anirudhr-adtech/AI_GLASSES/README.md

# AI_GLASSES

AI-powered smart glasses project.
