anirudhr-adtech/AI_GLASSES/AI_Smart_Glasses_docs/Physical Design/AI_Glasses_SoC_OpenSource_PD_Flow_v1.docx

AI SMART GLASSES SoC

Open-Source Physical Design Flow

Automated PD with Claude-in-the-Loop

Yosys • OpenSTA • OpenROAD • Magic • Netgen • KLayout • OpenLane 2

Document Version: 1.0

Date: March 2026

Development PDK: SkyWater SKY130 | Target: SCL Mohali 180nm

Strategy

Use the open-source PD toolchain to iterate rapidly on synthesis, timing closure, floorplanning, PnR, and physical verification. Claude runs the tools autonomously in run → read error → fix → re-run loops. Once converged, export equivalent Synopsys TCL scripts for the commercial flow at SCL Mohali 180nm.

# Table of Contents

# 1. Why Open-Source PD for This Project

## 1.1 The DV Parallel

In Design Verification, Claude demonstrated enormous value through autonomous iteration loops: write testbench → run iverilog → read errors → fix RTL or TB → re-run. The key insight was that iverilog (open-source) caught 90%+ of the same bugs that Vivado XSIM (commercial) would find. The open-source tool wasn’t the final production simulator, but it was the iteration engine that got the design to a clean state before touching expensive tools.

The same principle applies to Physical Design. Open-source tools (Yosys, OpenROAD, OpenSTA) can catch and fix the majority of synthesis, timing, floorplan, placement, routing, and DRC issues. The commercial Synopsys flow at SCL becomes a final verification pass on an already-converged design, rather than the place where all iteration happens.

## 1.2 Why 180nm is the Sweet Spot

The 180nm process node is uniquely well-suited for open-source PD tools for several reasons:

- Relaxed design rules — wider metal, larger spacing, fewer exotic DRC rules compared to advanced nodes
- No FinFET complexity — planar MOSFET physics that open-source tools handle accurately
- Fewer metal layers — typically 5–6 layers vs. 10+ at advanced nodes, reducing routing complexity
- Well-characterized timing models — Liberty (.lib) files for 180nm-class cells are mature and accurate
- SkyWater SKY130 (130nm) is publicly available and structurally very similar to 180nm — same flow methodology transfers directly

## 1.3 Value Proposition

Metric | Without Claude PD Automation | With Claude PD Automation
Synthesis iterations | PD engineer runs DC manually, fixes constraints, re-runs | Claude runs Yosys in a loop, converges timing offline
SDC constraint quality | Written manually, bugs found late in STA | Claude generates and validates SDC iteratively against OpenSTA
Floorplan convergence | Trial-and-error in ICC with PD engineer | Pre-converged floorplan from OpenROAD, PD engineer refines
DRC violations at PnR handoff | Hundreds to thousands, fixed manually | Reduced to tens — most auto-fixed in Claude’s loop
Time to first timing-clean PnR | 2–4 weeks typical | Days for pre-convergence + PD engineer sign-off
Commercial tool license hours | Heavy usage for all iteration | Minimal — only final sign-off and SCL-specific tuning

# 2. Open-Source Toolchain Overview

## 2.1 Core Tools

Tool | Function | Replaces (Synopsys) | License
Yosys | RTL synthesis: Verilog → gate-level netlist; tech mapping to standard cells | Design Compiler (DC) | ISC (permissive)
OpenSTA | Static timing analysis: multi-corner, setup/hold, transition, capacitance checks | PrimeTime | GPLv3
OpenROAD | Full PnR: floorplan, placement, CTS, routing, optimization, parasitic extraction | IC Compiler (ICC2) | BSD 3-Clause
OpenRCX | Parasitic RC extraction (integrated in OpenROAD) | StarRC | BSD 3-Clause
Magic | Layout editor + DRC engine for VLSI; LVS with Netgen integration | IC Validator (DRC) | MIT-like
Netgen | LVS: compares extracted layout netlist against schematic/gate-level netlist | IC Validator (LVS) | GPLv2
KLayout | Layout viewer/editor + DRC scripting engine (Ruby/Python) | IC Validator / Custom Calibre | GPLv2
OpenLane 2 | Full automated RTL-to-GDSII flow orchestrator using all above tools | Fusion Compiler | Apache 2.0

## 2.2 Supporting Tools

Tool | Function | Usage
SkyWater SKY130 PDK | Open-source 130nm PDK with standard cells, I/O, SRAM | Development and iteration PDK (closest to SCL 180nm)
ABC | Logic optimization engine (integrated in Yosys) | Technology-independent and technology-dependent optimization
GTKWave | Waveform viewer for timing debug | Visualize STA paths and signal transitions
Python | Script automation, report parsing, result analysis | Glue for Claude’s automation loops
TCL | Native scripting language for all PD tools | All tool commands and flow automation

## 2.3 PDK Strategy: SKY130 → SCL 180nm

The SkyWater SKY130 PDK is used as the development and iteration PDK. It is a 130nm process, structurally very similar to SCL’s 180nm. The critical insight is that the PD methodology, script structure, constraint format, and optimization strategies are identical between 130nm and 180nm. Only the following change when moving to SCL 180nm:

What Changes | SKY130 (Development) | SCL 180nm (Production)
Standard cell library | sky130_fd_sc_hd (high-density) | SCL 180nm standard cell .lib/.lef
Design rules (DRC deck) | SKY130 DRC rules | SCL 180nm DRC rule deck
Metal layer stack | 5 metal layers (li1, met1–met5) | SCL 180nm metal layers (confirm count)
I/O pad library | sky130_fd_io | SCL 180nm I/O pad library
SRAM macros | OpenRAM-generated or sky130_sram | SCL memory compiler macros
Timing corners (PVT) | SKY130 corners (ss/ff/tt) | SCL 180nm corners (confirm exact PVT)
Parasitic models | SKY130 RC tech file | SCL 180nm RC extraction rules

Key Point

Everything else — the SDC constraints, UPF power intent, floorplan strategy, CTS methodology, routing approach, DRC iteration flow, STA scripts, LEC methodology — transfers directly. The scripts Claude develops and converges on SKY130 become the foundation for the SCL 180nm commercial flow.

# 3. Tool Installation and Environment Setup

This section documents the installation of all open-source PD tools in Claude’s Linux environment. The tools are installed once and available for all subsequent PD automation sessions.

## 3.1 Yosys (Synthesis)

Yosys is the synthesis engine. It reads Verilog RTL, performs logic optimization via ABC, and maps to target standard cells.

# Install Yosys

sudo apt-get install -y yosys

# Verify installation

yosys --version

# Basic usage: synthesize a module

yosys -p "read_verilog design.v; synth -top top_module; write_json netlist.json"

## 3.2 OpenSTA (Static Timing Analysis)

OpenSTA performs multi-corner STA with Liberty timing libraries. It reads gate-level netlists and SDC constraints, and reports setup/hold violations, max transition, and max capacitance.

# Install OpenSTA (often packaged with OpenROAD or standalone)

sudo apt-get install -y opensta

# Basic usage

sta -exit <<EOF

read_liberty sky130_fd_sc_hd__tt_025C_1v80.lib

read_verilog netlist.v

link_design top_module

read_sdc constraints.sdc

report_checks -path_delay max

report_checks -path_delay min

EOF

## 3.3 OpenROAD (Place and Route)

OpenROAD is the complete PnR engine. It handles floorplanning, global and detailed placement, CTS, global and detailed routing, parasitic extraction (OpenRCX), and post-route optimization.

# Install OpenROAD

sudo apt-get install -y openroad

# OpenROAD TCL flow (simplified)

openroad -exit <<EOF

read_lef sky130_fd_sc_hd.lef

read_def floorplan.def

read_liberty sky130_fd_sc_hd__tt_025C_1v80.lib

read_verilog netlist.v

link_design top_module

read_sdc constraints.sdc

initialize_floorplan -die_area {0 0 1000 1000}

global_placement

clock_tree_synthesis

detailed_placement

global_route

detailed_route

write_def routed.def

EOF

## 3.4 Magic (DRC + Layout)

Magic is a VLSI layout editor with integrated DRC engine. It can read DEF/GDS output from OpenROAD and run SCL/SKY130 DRC checks.

# Install Magic

sudo apt-get install -y magic

# Run DRC in batch mode

magic -dnull -noconsole -T sky130A <<EOF

gds read design.gds

load top_module

select top cell

drc check

drc count

quit

EOF

## 3.5 Netgen (LVS)

Netgen performs Layout vs. Schematic comparison. It takes the extracted netlist from the layout (via Magic) and compares it against the post-PnR gate-level netlist.

# Install Netgen

sudo apt-get install -y netgen-lvs

# Run LVS comparison

netgen -batch lvs "layout_extracted.spice top_module" \

"netlist.spice top_module" \

sky130A_setup.tcl \

lvs_report.txt

## 3.6 KLayout (Layout Viewer + DRC)

KLayout provides visual layout viewing, editing, and scripted DRC. Useful for visual debug of DRC violations that require human understanding.

# Install KLayout

sudo apt-get install -y klayout

# Run DRC script in batch mode

klayout -b -r sky130_drc.py -rd input=design.gds -rd report=drc_report.xml

## 3.7 OpenLane 2 (Full Flow Orchestrator)

OpenLane 2 is a complete RTL-to-GDSII flow that orchestrates all the above tools. It provides a Python-based configuration system and runs the entire flow automatically. For Claude’s iteration loops, we use both OpenLane (for full-flow runs) and individual tools (for targeted iteration on specific stages).

# Install OpenLane 2 (via pip)

pip install openlane

# Or via Docker (recommended for reproducibility)

docker pull efabless/openlane2

# Run full flow

openlane --pdk sky130A config.json

## 3.8 SkyWater SKY130 PDK

The SKY130 PDK provides standard cells, I/O cells, SRAM macros, DRC/LVS decks, and timing libraries for the open-source flow.

# Install SKY130 PDK via volare (PDK manager)

pip install volare

volare enable --pdk sky130 <version>

# Or clone directly

git clone https://github.com/google/skywater-pdk.git

# Key files:

# sky130_fd_sc_hd__tt_025C_1v80.lib — Timing library (typical corner)

# sky130_fd_sc_hd__ss_100C_1v60.lib — Slow-slow corner

# sky130_fd_sc_hd__ff_n40C_1v95.lib — Fast-fast corner

# sky130_fd_sc_hd.lef — Physical cell abstracts

# sky130A.tech — Technology file for Magic

# 4. Claude’s Autonomous Iteration Loops

This is the core value of the open-source PD approach. Each loop follows the same pattern proven in DV: run tool → parse output → identify issues → apply fix → re-run. Claude continues looping until convergence or until a human-judgment decision is needed.

## 4.1 Loop 1: Synthesis (Yosys)

Loop Pattern

Write Yosys TCL → Run synthesis → Read timing/area report → Identify violations → Adjust synthesis strategy → Re-run → Repeat until timing/area targets met

What Claude does in each iteration:

Iteration Step | Claude’s Action | Example
1. Run synthesis | Execute Yosys with current TCL script | yosys -s synth_npu.tcl 2>&1 | tee synth.log
2. Parse report | Read timing, area, and cell count reports | Critical path: 6.2ns (target: 5.0ns) → FAIL
3. Diagnose | Identify which paths fail and why | Path through npu_mac_array accumulator chain too long
4. Fix | Adjust synthesis: restructure logic, add pipeline, retime | Add pipeline register in accumulator, re-map with ABC
5. Re-run | Execute updated synthesis | New critical path: 4.8ns → PASS
6. Check area | Verify cell count and area are acceptable | Area: 45,000 cells, utilization 72% → OK

Common synthesis issues Claude catches and fixes in the loop:

- Critical paths that exceed the 5ns target (200 MHz NPU) — fixed by retiming, logic restructuring, or flagging RTL changes needed
- BRAM inference failures — Yosys may not infer BRAM for certain coding styles; Claude adjusts the RTL pattern
- Combinational loops — synthesis fails; Claude traces the loop and adds a register to break it
- Undriven nets or width mismatches — real RTL bugs caught before PnR
- Excessive logic depth through the AXI crossbar — may need pipeline stages in the address decoder

## 4.2 Loop 2: Constraint Validation (OpenSTA)

Loop Pattern

Write SDC → Run OpenSTA → Read timing report → Find missing/incorrect constraints → Fix SDC → Re-run → Repeat until all paths constrained and clean

This is one of the highest-value loops. SDC constraints are the foundation of every downstream PD step. Errors in SDC propagate through STA, PnR, and sign-off. Claude generates the initial SDC from complete knowledge of the design and then validates it iteratively:

Constraint Type | What Claude Generates | What OpenSTA Validates
Clock definitions | create_clock for sys_clk (100 MHz), npu_clk (200 MHz) | Clocks correctly defined and propagated
Clock groups | set_clock_groups -asynchronous for PCLK, I2S_SCK vs sys_clk | No cross-domain paths analyzed incorrectly
False paths | set_false_path on CDC synchronizer paths | Synchronizer paths excluded from setup/hold
Input/output delays | set_input_delay / set_output_delay for all I/O ports | No unconstrained I/O ports
Max transition | set_max_transition per clock domain | No excessive slew rates
Multicycle paths | set_multicycle_path for known multi-cycle operations | Correct path timing budgets
Clock latency | set_clock_latency estimates for pre-CTS STA | Realistic pre-CTS timing estimates

## 4.3 Loop 3: Floorplan + Placement (OpenROAD)

Loop Pattern

Define floorplan → Place macros → Run global placement → Read congestion/timing → Adjust macro positions or die area → Re-run → Repeat until congestion < threshold and timing estimates pass

Floorplan iteration is where Claude can rapidly test many macro placement configurations:

Decision | What Claude Iterates | Convergence Criteria
Die area | Start with estimated area, adjust based on utilization | Target 60–75% utilization after placement
SRAM placement | Try different positions/orientations for 512KB banks | Minimize wirelength to CPU + NPU + DMA
NPU buffer placement | Place weight/activation buffers near MAC array | Short paths for 200 MHz data access
Power grid | VDD/VSS stripe width and pitch per layer | IR drop estimate within margin
Pin placement | Signal grouping on die edges | Minimize I/O routing congestion

## 4.4 Loop 4: Clock Tree Synthesis + Routing (OpenROAD)

Loop Pattern

Run CTS → Check skew → Adjust buffer selection → Re-run → Detailed route → Check DRC/timing → Fix hold violations → Re-route → Repeat until timing clean and DRC clean

This is the most iteration-heavy loop. CTS directly affects timing closure, and routing can introduce DRC violations and timing degradation. Claude handles this by running CTS, checking clock skew against budget (especially critical for the 200 MHz NPU domain), inserting hold-fix buffers, running detailed routing, then checking for DRC violations and timing simultaneously. Each iteration tightens the design closer to convergence.

## 4.5 Loop 5: Physical Verification (Magic + Netgen)

Loop Pattern

Run DRC (Magic) → Parse violation count → Auto-fix density/antenna → Re-run DRC → Run LVS (Netgen) → Parse mismatches → Fix routing → Re-run → Repeat until zero violations

Violation Type | Auto-Fixable by Claude? | Fix Method
Metal density (min/max) | Yes | Insert metal fill, adjust fill density parameters
Antenna violations | Yes | Insert antenna diodes or re-route to higher metal layer
Minor spacing violations | Yes | Re-route affected nets with increased spacing
Via enclosure violations | Mostly yes | Widen metal at via landings
Complex DRC near macros | No — flag for PD engineer | May require macro repositioning
LVS shorts | Sometimes | Trace short in layout, re-route offending net
LVS opens | Sometimes | Identify missing connection, add via or route
LVS mismatches near pads | No — flag for PD engineer | May involve I/O cell configuration

## 4.6 Loop 6: Post-Route STA (OpenSTA)

Loop Pattern

Extract parasitics (OpenRCX) → Run OpenSTA with extracted SPEF → Parse timing report → Identify failing paths → Apply ECO (buffer insert/resize) → Re-route → Re-extract → Re-run STA → Repeat

This final STA loop uses real extracted parasitics from the routed layout. It’s the most accurate timing analysis possible in the open-source flow and directly corresponds to the PrimeTime sign-off STA in the commercial flow. Claude iterates on ECO fixes (buffer insertion, cell resizing) until all setup and hold violations are resolved across all timing corners.

# 5. Execution Plan: Phased Approach

## 5.1 Phase 1: NPU Subsystem (Tightest Timing)

Start with the NPU subsystem because it has the most aggressive timing target (200 MHz, 5ns period). If we can close timing on the NPU, everything else at 100 MHz will be straightforward.

Step | Action | Tool | Success Criteria
1.1 | Synthesize NPU (10 modules) targeting SKY130 | Yosys | Critical path ≤ 5ns, clean synthesis
1.2 | Generate + validate NPU SDC constraints | OpenSTA | All paths constrained, no uncovered endpoints
1.3 | Run STA on synthesized NPU netlist | OpenSTA | Zero setup violations at all corners
1.4 | Create NPU floorplan with SRAM macros | OpenROAD | Utilization 60–75%, congestion < 5%
1.5 | Place + CTS + Route NPU subsystem | OpenROAD | Timing clean post-route, DRC clean
1.6 | Run DRC + LVS on NPU layout | Magic + Netgen | Zero DRC, zero LVS mismatches
1.7 | Post-route STA with extracted parasitics | OpenSTA + OpenRCX | Final timing sign-off clean

## 5.2 Phase 2: Full SoC Integration

After NPU converges, expand to the full SoC with all 89 modules, AXI crossbar, peripherals, and SRAM banks.

Step | Action | Tool | Success Criteria
2.1 | Synthesize full SoC (89 modules) | Yosys | All subsystems synthesize cleanly
2.2 | Generate full SoC SDC (all clocks, all I/O) | OpenSTA | All 4 clock domains properly constrained
2.3 | Full-chip floorplan with all macros | OpenROAD | Die area feasible, power grid planned
2.4 | Full SoC PnR | OpenROAD | Timing + DRC convergence
2.5 | Full PV (DRC + LVS) | Magic + Netgen | Zero violations
2.6 | Full STA sign-off | OpenSTA | All corners clean
2.7 | Generate GDSII | OpenROAD/Magic | Clean GDSII output for reference

## 5.3 Phase 3: Commercial Flow Export

Export the converged design to Synopsys-compatible scripts for the SCL 180nm commercial tape-out.

Deliverable | Source (Open-Source) | Target (Synopsys) | Conversion
SDC constraints | Validated in OpenSTA | PrimeTime | Direct transfer — SDC is standard format
Synthesis script | Yosys TCL | DC TCL | Rewrite with DC commands, same logic structure
Floorplan | OpenROAD DEF | ICC2 floorplan TCL | Convert macro positions to ICC2 place commands
CTS spec | OpenROAD CTS config | ICC2 CTS script | Map buffer cells to SCL 180nm equivalents
Power grid | OpenROAD PDN config | ICC2 power grid TCL | Adjust stripe width/pitch for SCL rules
PnR optimization | OpenROAD routing params | ICC2 route commands | Same strategy, different tool commands
UPF power intent | Generated by Claude | Formality / ICC2 | Direct transfer — UPF is standard format

# 6. What Requires Human Engineering Judgment

Claude’s automation handles the iteration grind, but certain decisions require the experience and judgment of your PD engineer. This section clearly delineates the boundary.

Decision | Why It Needs Human Judgment | Claude’s Role
Floorplan architecture | Die partitioning, macro placement strategy, power grid topology require physical intuition built from years of tape-outs | Generate candidate floorplans; PD engineer selects and refines
Visual DRC debug | Complex DRC violations near macro edges or pad ring need visual layout inspection to understand root cause | Flag violations with location and type; PD engineer debugs in GUI
ECO strategy decisions | When a path can’t close timing: restructure pipeline? Relax frequency? Add a clock domain? These are architecture decisions. | Present options with trade-off analysis; engineer decides
SCL-specific tuning | PDK-specific recipes, foundry workarounds, DRC waivers, and process-specific knobs known from past tape-outs at SCL | Generate baseline scripts; PD engineer adds SCL-specific tuning
Sign-off review | Final tape-out go/no-go is a risk assessment involving yield, reliability, schedule, and cost trade-offs | Provide complete reports and checklist; engineer makes the call
Packaging decisions | Wire-bond vs. flip-chip, QFP vs. QFN, thermal strategy, cost trade-offs | Analyze pin count and power needs; engineer decides package type
Analog / mixed-signal | If any analog blocks exist, their layout requires analog-specific expertise | Handle all digital blocks; flag analog boundaries

The Partnership Model

Claude handles the repetitive iteration grind (run → parse → fix → re-run) that consumes 70–80% of PD engineering time. Your PD engineer focuses on the 20–30% that requires experience, judgment, and creativity. Together, the total time from netlist to GDSII-ready is dramatically compressed.

# 7. Key File Formats in the PD Flow

Understanding the file formats that flow between tools is essential for debugging and automation. These formats are standardized and used by both open-source and commercial tools.

Format | Extension | Contains | Used By
Liberty | .lib | Cell timing, power, area models per PVT corner | Yosys, OpenSTA, PrimeTime, DC
LEF | .lef | Physical cell abstracts: pin locations, metal layers, obstructions | OpenROAD, ICC2
DEF | .def | Die area, placed cells, routed nets, power grid | OpenROAD, ICC2
SDC | .sdc | Timing constraints: clocks, I/O delays, false paths, exceptions | OpenSTA, PrimeTime, DC, ICC2
UPF | .upf | Power intent: domains, isolation, level shifters, retention | ICC2, Formality, PrimeTime
SPEF | .spef | Extracted parasitic R/C for nets and cells | OpenSTA, PrimeTime, RedHawk
SDF | .sdf | Gate delays for timing-annotated simulation | Icarus, XSIM (post-layout GLS)
Verilog Netlist | .v | Gate-level netlist (structural Verilog) | All tools
GDSII | .gds | Physical layout polygons for fabrication | Magic, KLayout, ICC2
SPICE | .spice/.sp | Circuit netlist for LVS comparison | Netgen, Calibre
VCD | .vcd | Switching activity dump from simulation | RedHawk (power analysis)
TCL | .tcl | Tool command scripts for automation | All PD tools

A critical advantage of using open-source tools: SDC, UPF, LEF, DEF, SPEF, SDF, and GDSII are all industry standards. Files generated by the open-source flow are directly readable by commercial tools. This is what makes the SKY130 → SCL 180nm migration seamless.

— End of Document —

AI Smart Glasses SoC — Open-Source PD Flow Confidential
