anirudhr-adtech/AI_GLASSES/AI_Smart_Glasses_docs/Physical Design/AI_Glasses_SoC_Physical_Design_Flow_v1.docx

AI SMART GLASSES SoC

Physical Design Flow

Post-GLS to GDSII Tape-Out

Complete Reference Guide for Backend Implementation

Document Version: 1.0

Date: March 2026

Target: SCL Mohali 180nm ASIC (Phase 1)

FPGA Validation: Xilinx Zynq Z7-20 (Phase 0)

Classification: Confidential

# Table of Contents

# 1. Executive Summary

This document defines the complete Physical Design (PD) flow for the AI Smart Glasses SoC, covering every stage from post-GLS (Gate-Level Simulation) through GDSII tape-out at SCL Mohali 180nm. The flow encompasses floorplanning, place-and-route, static timing analysis, physical verification, power integrity analysis, logic equivalence checking, bump/pad placement, redistribution layer (RDL) design, and final sign-off.

The SoC integrates a RISC-V CPU (Ibex RV32IMC at 100 MHz), an 8×8 INT8 NPU (200 MHz), an MFCC audio pipeline, a camera/vision subsystem with ISP-lite, a 5×5 AXI4 crossbar interconnect, DDR controller bridge, and peripherals (UART, SPI, I2C, GPIO). The design comprises 89 RTL modules across 9 subsystems, validated through 120+ testbenches before entering the physical design stage.

Key Design Parameters

Process: SCL Mohali 180nm | System Clock: 100 MHz | NPU Clock: 200 MHz | SRAM: 512KB on-chip | NPU Buffers: 256KB | I/O: DVP, I2S, SPI, I2C, UART, GPIO | DDR: 2GB via AXI3 64-bit

# 2. Synopsys Physical Design Toolchain

The physical design flow for SCL Mohali 180nm is based on the Synopsys toolchain. The following table maps each PPA (Power, Performance, Area) pillar to its primary tool and the stage at which it is used.

## 2.1 PPA Tool Mapping

PPA Pillar | Primary Tool | Stage | Description
Power | RedHawk | Post-PnR | IR drop analysis, electromigration, dynamic power estimation, thermal analysis
Performance | PrimeTime | STA Sign-off | Multi-corner multi-mode timing analysis, setup/hold verification, clock domain crossings
Area | ICC1 / ICC2 | PnR | Guided by FCFP team; placement, CTS, routing, area optimization within die constraints

## 2.2 Complete Toolchain

Tool | Function | Phase
Design Compiler (DC) | RTL synthesis to gate-level netlist using SCL 180nm standard cell library | Synthesis
Fusion Compiler | Unified synthesis + PnR in single environment; physics-aware synthesis decisions | Synthesis + PnR (alternative)
IC Compiler (ICC1/ICC2) | Place-and-route: floorplanning, placement, CTS, routing, optimization | PnR
PrimeTime | Static timing analysis across all PVT corners; final timing sign-off | STA
StarRC | Parasitic extraction (RC) from routed layout for accurate timing/power | Post-PnR
RedHawk | Power integrity: static/dynamic IR drop, electromigration, reliability | Post-PnR
IC Validator (ICV) | Physical verification: DRC, LVS, ERC; runs inside ICC2 for in-design checks | PV
Formality | Logic equivalence checking: post-PnR netlist vs. post-synthesis netlist | LEC

## 2.3 Design Compiler vs. Fusion Compiler

Design Compiler (DC) is the industry-standard standalone synthesis tool. It takes your RTL and maps it to the SCL 180nm standard cell library, producing a gate-level netlist. DC has been the go-to synthesis tool at virtually every process node.

Fusion Compiler merges synthesis and PnR into a single unified tool with a shared data model. Instead of synthesizing in DC, writing out a netlist, then importing into ICC2 as two separate steps, Fusion Compiler does both in one environment. It can make synthesis decisions (cell selection, logic restructuring, buffering) with awareness of the physical floorplan, placement, and routing congestion. This generally gives better timing closure and fewer iterations.

Recommendation for 180nm

At 180nm the timing closure challenge is relatively relaxed compared to advanced nodes, so the traditional DC → ICC flow works perfectly well. Fusion Compiler is a nice-to-have but not essential at this node. Confirm which flow SCL Mohali’s PDK scripts are validated against.

# 3. Physical Design Flow Overview

The complete backend flow follows this linear sequence, with iteration loops at each major checkpoint. Each stage can send the design back to PnR for ECO (Engineering Change Order) fixes, which then requires re-running all downstream checks.

Step | Stage | Tool | Input | Output
1 | Synthesis | DC / Fusion Compiler | RTL (.v files) | Gate-level netlist
2 | Gate-Level Simulation | Icarus / XSIM | Netlist + SDF | Functional pass/fail
3 | Floorplanning | ICC1/ICC2 | Netlist + constraints | Floorplan DEF
4 | Place and Route | ICC1/ICC2 | Floorplan + netlist | Routed layout (DEF/GDS)
5 | Physical Verification | IC Validator | Routed layout | DRC/LVS clean report
6 | Power Integrity (EMIR) | RedHawk | Layout + activity | IR drop / EM report
7 | Static Timing Analysis | PrimeTime + StarRC | Layout + parasitics | Timing sign-off report
8 | Low Power Checks (VCLP) | PrimeTime / ICC2 | Layout + UPF | Power intent verification
9 | Logic Equivalence | Formality | Post-PnR netlist | LEC pass report
10 | Bump/Pad Placement | ICC2 / Package tool | Die floorplan | Pad ring / bump map
11 | RDL Design | ICC2 / Package tool | Bump map + pad locs | RDL layout
12 | Final PV (with RDL) | IC Validator | Core + RDL layout | Clean DRC/LVS
13 | GDSII Streamout | ICC2 | Final layout | GDSII for fabrication

The flow is iterative. If STA reveals timing failures, the design returns to ICC for ECO fixes. If RedHawk shows IR drop violations, the power grid is strengthened. If ICV finds DRC errors, the layout is repaired. Convergence requires all stages to pass simultaneously.

# 4. Full Chip Floorplan (FCFP)

The FCFP (Full Chip Floorplan) owner is a critical role in physical design. This person makes the top-level physical architecture decisions for the entire die, including block partitioning, die area, pad ring planning, power grid topology, and ESD strategy.

## 4.1 Block Partitioning

Block partitioning determines which subsystems become hard blocks (placed and routed independently, then integrated as black boxes) versus which remain part of the flat top-level implementation. For the AI Glasses SoC, the following partitioning is expected:

Block | Type | Estimated Size | Notes
512KB SRAM (4 banks) | Hard Macro | Large (dominant area) | SCL memory compiler or vendor macro
128KB NPU Weight Buffer | Hard Macro | Medium | SRAM macro from SCL
128KB NPU Activation Buffer | Hard Macro | Medium | SRAM macro from SCL
NPU MAC Array (8×8) | Candidate Hard Block | Medium | Independent optimization at 200 MHz
AXI Crossbar | Flat (top-level) | — | Integrated with top-level routing
Peripherals (UART, GPIO, etc.) | Flat (top-level) | Small | Integrated with peripheral bus
Pad Ring + I/O Cells | I/O Library | Peripheral | SCL I/O pad library

Signals crossing hard block boundaries need well-defined timing budgets, which directly affect STA constraints. The FCFP owner defines these budgets in coordination with the STA engineer.

## 4.2 ESD (Electrostatic Discharge) Planning

Every pad that connects to the outside world needs ESD clamp structures to protect core logic from voltage spikes during handling. At 180nm, SCL provides I/O pad cells with built-in ESD protection, typically rated for 2kV HBM (Human Body Model). The FCFP owner decides the following:

Decision | Description | Impact
I/O Voltage Domains | Which pads belong to 1.8V core vs. 3.3V I/O | Determines pad cell selection from SCL library
Power Clamp Placement | VDD-to-VSS clamp cells distributed around pad ring | Ensures low-impedance discharge paths
ESD Current Paths | Guard rings and power ring routing for discharge paths | Must provide low-resistance path from every I/O pad to supply rails
Mixed-Signal Isolation | Separate analog and digital ground domains if needed | Prevents noise coupling through ESD structures

For the AI Glasses SoC, all external-facing interfaces require full ESD protection: DVP camera interface (8 data + 3 control), I2S audio (SCK, WS, SD), SPI (4 signals), I2C (SDA, SCL), UART (TX, RX), and 8 GPIO pins.

# 5. Place and Route (PnR)

Place and Route is executed in Synopsys ICC1 or ICC2, as directed by the FCFP team. It takes the synthesized gate-level netlist and physically places standard cells and routes metal interconnects on the die.

## 5.1 PnR Sub-Steps

Step | Description | Key Considerations for This SoC
Global Placement | Initial cell placement optimizing wirelength and congestion | Keep NPU datapath cells close for 200 MHz timing
Clock Tree Synthesis (CTS) | Build balanced clock distribution networks | Two domains: 100 MHz sys_clk, 200 MHz npu_clk; async PCLK handled externally
Detailed Placement | Legalize cell positions, optimize timing-critical paths | NPU MAC array critical paths need priority optimization
Global Routing | Plan routing tracks, identify congestion hotspots | AXI crossbar region is routing-dense (128-bit buses)
Detailed Routing | Final metal trace routing on all layers | Ensure DRC-clean routing within SCL metal layer stack
Post-Route Optimization | Fix remaining timing violations with buffer insertion/sizing | Focus on NPU-to-system clock domain crossing paths

## 5.2 Clock Domains

The SoC has multiple clock domains that require careful handling during CTS:

Clock | Frequency | Domain | CTS Priority
sys_clk | 100 MHz | System (CPU, peripherals, AXI, Audio, Camera logic) | Standard — comfortable at 180nm
npu_clk | 200 MHz | NPU subsystem (MAC array, quantize, activation, DMA) | Critical — 5ns period is aggressive for 180nm
PCLK | ~24 MHz | Camera DVP capture (external, async) | Not in CTS — handled by 2-FF synchronizer + async FIFO
I2S SCK | <1 MHz | Audio I2S receiver (external, async) | Not in CTS — synchronized into sys_clk domain

The CTS for the 200 MHz NPU domain requires the most attention. At 180nm with a 5ns clock period, the clock skew budget is very tight. SCL 180nm will have specific clock buffer cells optimized for low-skew distribution.

## 5.3 ICC1 vs. ICC2

ICC1 is the older-generation PnR tool, mature and well-proven at 180nm with stable scripts and recipes. ICC2 is the current generation with better concurrent optimization of timing, area, and power. For 180nm, either is perfectly capable. ICC1 is the safer choice if SCL’s validated flow is built around it. The FCFP team will determine which version to use based on SCL’s PDK support.

# 6. Physical Verification (PV)

Physical verification is performed using Synopsys IC Validator (ICV). ICV can run natively inside ICC2, enabling in-design DRC checks during the PnR flow rather than waiting until the end. This is called signoff-driven design.

## 6.1 Verification Types

Check | Full Name | What It Verifies | Severity
DRC | Design Rule Check | Manufacturing rule compliance: metal width, spacing, via enclosure, density, antenna rules | Must be zero violations
LVS | Layout vs. Schematic | Physical layout matches the netlist: no shorts, opens, or missing connections | Must be zero mismatches
ERC | Electrical Rule Check | Electrical issues: floating gates, missing substrate/well connections, power connectivity | Must be zero violations

## 6.2 Common DRC Violations at 180nm

Based on typical 180nm process rules, the most frequently encountered violations include:

Violation Type | Cause | Typical Fix
Metal Density | 180nm processes have strict density windows per metal layer (min and max fill) | Automated metal fill insertion command in ICC2
Antenna Rules | Long clock nets accumulate charge during fabrication, risking gate oxide damage | Insert antenna diode cells or route jump to higher metal layer
Minimum Spacing | Routing congestion forces traces too close together | Re-route affected area or spread cells apart
Via Enclosure | Metal overlap around vias is insufficient | Widen metal at via landing pads
Minimum Width | Narrow signal traces below process minimum | Widen affected traces (usually auto-fixed by router)

## 6.3 Fixing PV Errors: Automated vs. Manual

There are two approaches to fixing physical verification errors, and both are commonly needed:

### 6.3.1 Automated / Command-Based Fixes

Straightforward violations are fixed by running commands in ICC2. Metal density violations are fixed by automatic dummy metal fill insertion. Antenna violations are resolved by the tool inserting diode cells or jumping to higher metal layers. Minor spacing violations can be cleaned up with targeted re-route commands. Hold-time fix buffers are inserted via ECO commands.

### 6.3.2 Visual / Manual Fixes

Trickier cases require opening the layout in ICC2’s GUI viewer and visually understanding the problem. Examples include: two hard macros placed too close together causing routing congestion between them (requires macro relocation); LVS shorts where two unrelated nets accidentally touch through an unexpected via or metal overlap (requires visual net tracing); and complex ESD current path issues where the discharge path must be manually verified for continuity and low resistance.

### 6.3.3 Iteration Workflow

The practical workflow is iterative: run ICV DRC inside ICC2, categorize the violation report into auto-fixable and manual categories, run auto-fix commands, open the layout GUI for remaining manual fixes, re-run ICV to confirm fixes, and repeat until zero DRC and zero LVS errors. This cycle may take several iterations to achieve full cleanliness.

# 7. Power Integrity and Reliability (RedHawk)

RedHawk (Synopsys, formerly ANSYS) is the power integrity and reliability analysis tool. It handles electromigration verification, IR drop analysis, and reliability sign-off.

## 7.1 Electromigration (EM) Analysis

Over time, high current density in metal wires causes metal atoms to physically migrate, eventually creating voids (open circuits) or hillocks (short circuits). RedHawk analyzes every wire and via against the SCL 180nm process EM current limits.

For the AI Glasses SoC, the most vulnerable nets are:

Net Category | Risk Level | Reason
VDD/VSS power mesh | High | Carries the most current across the entire die
NPU clock tree | High | High switching activity at 200 MHz driving 64 MAC units
DMA data buses (128-bit) | Medium | Frequently toggling during burst transfers to DDR
AXI crossbar signals | Medium | Multiple masters generating continuous switching activity

If EM violations are found, the fix is typically widening the offending metal traces, adding parallel vias for redundancy, or restructuring the power mesh locally.

## 7.2 IR Drop Analysis

RedHawk simulates the voltage drop across the power grid under realistic switching conditions. It produces a color-mapped voltage drop heatmap across the die, verifying that no cell sees a voltage drop below the minimum operating voltage.

Analysis Type | Input | What It Shows
Static IR Drop | Average current estimates per block | Worst-case steady-state voltage drop across the power grid
Dynamic IR Drop | Switching activity from GLS VCD files | Transient current spike-induced voltage drops (worst-case peaks)

For this SoC, the NPU region during a full 8×8 MAC computation cycle will be the worst-case dynamic IR drop hotspot. If IR drop is too high, the mitigation strategies include: adding more power stripes in the NPU region, widening existing VDD/VSS stripes, and inserting decoupling capacitor (decap) filler cells in whitespace near the NPU.

## 7.3 Reliability Checks

Beyond EM, RedHawk can perform self-heating analysis and aging effect verification. At 180nm these are less critical than at advanced nodes (7nm, 5nm), but SCL may still require basic reliability sign-off as part of their tape-out checklist.

# 8. Static Timing Analysis (STA)

Static Timing Analysis is performed using Synopsys PrimeTime. The final STA runs at this stage use post-PnR extracted parasitics from StarRC, making this the most accurate and definitive timing verification.

## 8.1 What PrimeTime Checks

Analysis | Description | Critical Paths in This SoC
Setup Analysis | Can logic compute results within one clock period? Determines max achievable frequency. | NPU MAC datapath at 200 MHz (5ns period) is the tightest constraint
Hold Analysis | Ensures data doesn’t arrive too fast and corrupt the next stage. Hold violations fixed by delay buffer insertion. | Fast-fast corner at 180nm; CTS-to-datapath balance
MCMM | Multi-corner multi-mode: runs all PVT corners simultaneously to find worst-case paths per corner. | SS/0.9V/-40°C (worst setup), FF/1.1V/125°C (worst hold), TT/1.0V/25°C
CDC Constraints | Clock domain crossing paths: false paths for async boundaries, max delay for synchronizers. | PCLK↔sys_clk, npu_clk↔sys_clk, I2S_SCK↔sys_clk

## 8.2 PVT Corners for 180nm

STA is run across all relevant Process-Voltage-Temperature corners. For SCL 180nm, the typical corner set includes:

Corner | Process | Voltage | Temperature | Primary Use
SS (Slow-Slow) | Worst case slow | 0.9 × Vnom | -40°C or 125°C | Worst setup timing
FF (Fast-Fast) | Worst case fast | 1.1 × Vnom | 125°C or -40°C | Worst hold timing
TT (Typical) | Nominal | Vnom (1.8V) | 25°C | Typical performance reference

NPU at 200 MHz

The 200 MHz NPU clock gives only a 5ns period. At 180nm this is aggressive. If PrimeTime shows the NPU cannot close timing at 200 MHz, the options are: (a) accept a lower frequency (e.g., 150 MHz), (b) increase optimization effort in ICC with more aggressive settings, or (c) restructure the NPU pipeline to add more stages and reduce the critical path length.

## 8.3 SDF Generation

PrimeTime generates the final SDF (Standard Delay Format) file for post-layout gate-level simulation. This SDF contains the most accurate delay information derived from real routed parasitics, and is used for the optional final GLS run before tape-out.

# 9. Low Power Verification (VCLP)

VCLP (Voltage-aware Cell-Level Power) checks verify that the low-power design intent is correctly implemented in the physical layout. Even if the current SoC does not have aggressive power management, VCLP still checks important aspects.

## 9.1 What VCLP Verifies

Check | Description | Relevance to This SoC
Level Shifter Verification | Confirms level shifters are correctly placed at every voltage domain crossing (e.g., 1.8V core to 3.3V I/O) | Required if SCL 180nm uses dual voltage domains
Isolation Cell Verification | Verifies outputs of powered-down blocks are clamped to safe values to prevent floating and crowbar current | Directly relevant to UC-6 low-power standby mode
Power State Table | Confirms physical implementation matches power intent in UPF file | Define basic UPF early for future power gating
Retention Register Checks | Ensures retention flops are used for state that must survive power-down/wake cycles | Relevant if any registers must retain state across standby

## 9.2 Low Power Relevance for This SoC

The firmware specification defines UC-6 (Low-Power Standby + Wake), which stops all active subsystems (audio, camera, NPU, ESP32), disables unnecessary IRQs, and enters WFI (Wait For Interrupt). This implies the eventual need for selective power gating of the NPU, camera, and audio subsystems.

Even if the initial implementation uses a single power domain, defining a basic UPF (Unified Power Format) early establishes the power intent framework. Isolation cells at subsystem boundaries should be planned from the floorplan stage, even if power gating is not implemented in Phase 1.

# 10. Logic Equivalence Checking (LEC)

LEC is performed using Synopsys Formality. It is a formal verification step that mathematically proves the post-PnR netlist is logically equivalent to the reference netlist, catching any bugs introduced by the PnR tool’s physical optimizations.

## 10.1 LEC Checkpoints

Checkpoint | Reference | Implementation | Purpose
Post-Synthesis | Original RTL | Post-synthesis netlist | Verify synthesis did not alter logic functionality
Post-PnR | Post-synthesis netlist | Post-PnR netlist | Verify PnR optimizations preserved logic
Post-ECO (Final) | Post-synthesis netlist | Final post-ECO netlist | Verify all ECO changes are logically correct

## 10.2 What Changes Between Synthesis and Final Netlist

Between the initial post-synthesis LEC and the final post-ECO LEC, many modifications are made to the netlist that must all be verified:

Modification | Introduced By | Risk
CTS buffer insertion | Clock Tree Synthesis in ICC | Could alter clock-gating logic if not handled correctly
Hold-fix buffer insertion | Post-CTS optimization in ICC | Adds delay elements that must not break logical connectivity
Antenna diode insertion | DRC fix (ICV/ICC) | Inserts cells connected to signal nets
Cell upsizing/downsizing | Timing optimization in ICC | Changes cell instances while preserving function
ECO fixes | Manual or automated timing/DRC fixes | Highest risk — direct netlist modification
Metal fill | Density rule compliance | Should not affect logic but verified for safety

The final LEC must show zero failing comparison points. Any mismatch must be traced and resolved before tape-out. This is a hard gate — no design proceeds to GDSII with LEC failures.

# 11. Bump Placement and Pad Ring Design

Bump placement defines where the physical solder bumps (for flip-chip) or bond pads (for wire-bond) sit on the die surface. These are the electrical contact points between the chip and the package.

## 11.1 Packaging at 180nm

At SCL Mohali 180nm, the default packaging is almost certainly wire-bond (QFP or QFN packages), not flip-chip. Flip-chip with solder bumps is more common at 65nm and below. However, bump and RDL concepts become relevant in three scenarios:

Scenario | Description | Applicability
WLCSP / Fan-Out | SCL offers wafer-level chip-scale packaging with RDL and bumps at 180nm | Compact form factor ideal for glasses
Future Node Shrink | Planning ahead for 65nm/40nm production where flip-chip is standard | Design-for-migration strategy
Wire-Bond Redistribution | Core I/O pad locations don’t align with lead frame bond fingers; RDL reroutes | Common even in wire-bond packaging

## 11.2 I/O Pin Estimation

The AI Glasses SoC has the following external-facing signals that require physical pads:

Interface | Signals | Pin Count | Placement Strategy
DVP Camera | D[7:0], PCLK, VSYNC, HREF | 11 | Group on one die edge; timing-sensitive (~24 MHz)
I2S Audio | SCK, WS, SD_IN | 3 | Group near audio subsystem
SPI (ESP32) | MOSI, MISO, SCLK, CS_N | 4 | Group together; up to 10 MHz
I2C (Sensors) | SDA, SCL | 2 | Can be placed flexibly
UART | TX, RX | 2 | Debug port; flexible placement
GPIO | GPIO[7:0] | 8 | Distribute around pad ring as needed
DDR/Zynq HP0 | AXI data + address + control | ~40–60 | FPGA phase only; largest pin group
Clock Inputs | sys_clk_in, npu_clk_in | 2–4 | Dedicated clock input pads with low-jitter paths
Power (VDD) | Core VDD, I/O VDD | ~15–25 | 30–40% of total pads; distributed around ring
Ground (VSS) | Core VSS, I/O VSS | ~15–25 | Paired with VDD pads for low-impedance return

Total estimated pad count: 80–120 pads including power and ground. The NPU region needs extra VDD/VSS pads nearby because 64 MACs switching simultaneously creates large transient current demand. Multiple VDD and VSS bond wires in parallel reduce package inductance and IR drop.

## 11.3 Signal Grouping and Placement Rules

Related signals should be physically grouped on the same die edge to minimize routing and reduce crosstalk. High-speed interfaces (DVP at 24 MHz, SPI at 10 MHz) need matched trace lengths on the package substrate if they are source-synchronous. Power and ground pads should be distributed evenly around the pad ring, with extra density near high-switching regions (NPU, DMA buses).

## 11.4 Thermal Considerations

The NPU is the hottest block on the die. For wire-bond QFN packaging, an exposed thermal die paddle on the package underside helps conduct heat away. If using flip-chip, bumps in the NPU region conduct heat directly to the substrate. The FCFP owner should coordinate with the packaging engineer to ensure adequate thermal dissipation for the 200 MHz NPU.

# 12. Redistribution Layer (RDL)

The RDL is one or more additional metal layers fabricated on top of the passivation layer (above the top metal from PnR). Its purpose is to reroute I/O pad locations from where they naturally end up after PnR to where the package needs them to be.

## 12.1 Why RDL is Needed

During PnR, I/O pads end up at locations dictated by the floorplan — peripheral pad ring for wire-bond or area-array for flip-chip. But the package substrate or lead frame has its own fixed geometry. RDL bridges this mismatch, acting as a “last mile” routing layer that connects on-die pads to the bump or bond pad locations the package expects.

## 12.2 RDL Design Considerations

Consideration | Details | Impact on This SoC
Signal Integrity | High-speed signals need shortest possible RDL traces to minimize parasitic R and C | DDR interface and 200 MHz NPU clock should avoid long RDL runs
Power Delivery | RDL can carry wide power buses supplementing the on-die power grid | Helps with IR drop in high-current NPU region
Impedance Control | RDL metal is thicker (5–10µm) than on-die metal (~0.5µm at 180nm), affecting trace impedance | Must be modeled for signals above ~100 MHz
Layer Count | Simple designs use 1 RDL layer; complex redistribution may need 2 | One layer is likely sufficient for this pin count
Design Rules | RDL has its own DRC rules separate from core metal layers | Must be verified in a separate ICV run including RDL layers

## 12.3 RDL Verification

After RDL design, a new round of physical verification is required. DRC and LVS must be re-run with the RDL layers included. Parasitic extraction must also be re-run to capture the RDL’s contribution to signal delay and power grid resistance. Final STA sign-off uses these updated parasitics.

# 13. Tape-Out Sign-Off Checklist

Before GDSII streamout and delivery to SCL Mohali, every item in this checklist must be verified and signed off. This is the final gate before committing to fabrication.

# | Sign-Off Item | Tool | Criteria | Status

1 | DRC Clean | IC Validator | Zero violations against SCL 180nm DRC deck | □
2 | LVS Clean | IC Validator | Zero mismatches between layout and netlist | □
3 | ERC Clean | IC Validator | No floating gates, missing wells, power connectivity issues | □
4 | STA Sign-Off (all corners) | PrimeTime | Zero setup violations, zero hold violations across all PVT corners | □
5 | EM Clean | RedHawk | All wires and vias within SCL EM current limits | □
6 | IR Drop Clean | RedHawk | Static and dynamic IR drop within voltage margin | □
7 | LEC Pass | Formality | Zero failing comparison points (post-ECO vs. post-synthesis) | □
8 | VCLP Pass | PrimeTime / ICC2 | Power intent (UPF) correctly implemented; level shifters verified | □
9 | RDL DRC/LVS Clean | IC Validator | RDL layers pass all manufacturing rules | □
10 | Metal Density Pass | IC Validator | All layers within SCL density windows after fill insertion | □
11 | Antenna Rules Pass | IC Validator | No antenna violations on any signal net | □
12 | Post-Layout GLS (optional) | Icarus / XSIM | Functional pass with SDF back-annotation | □
13 | GDSII Layer Mapping | ICC2 Streamout | Correct layer mapping per SCL delivery spec | □
14 | Seal Ring Included | ICC2 | Seal ring structure present per SCL requirement | □
15 | Alignment Marks | ICC2 | Fabrication alignment marks present | □

# 14. Questions to Clarify with SCL Mohali

The following questions should be resolved with SCL Mohali and your physical design engineer before beginning the backend flow. The answers to these questions directly affect floorplan decisions, tool setup, and tape-out deliverables.

# | Question | Impact | Priority

1 | Which PDK version is current for 180nm? What tool flow is validated (DC+ICC1, DC+ICC2, or Fusion)? | Determines entire tool setup and script library | Critical
2 | How many metal layers are available? | Affects routability — especially for AXI crossbar 128-bit buses | Critical
3 | Does SCL provide SRAM compiler macros, or must we use synthesized memories? | Dominates die area (512KB + 256KB buffers) | Critical
4 | What is the target die area budget? | Constrains floorplan; determines feasibility of all blocks on die | Critical
5 | What packaging is offered (QFP, QFN, WLCSP, flip-chip)? | Determines pad ring vs. bump array, RDL requirements | Critical
6 | What is the target package pin count and pitch? | Constrains number of I/O and power pads | High
7 | Which I/O pad library cells are available (3.3V, 1.8V, mixed)? | Determines I/O voltage strategy and ESD protection | High
8 | Is RDL available as standard or additional cost? | Affects pad placement flexibility and packaging timeline | High
9 | What is the complete tape-out checklist and GDSII delivery format? | Must be known before starting PnR to avoid rework | High
10 | What are the EM current limits per metal layer? | Guides power grid design; critical for NPU region at 200 MHz | Medium
11 | Are there specific density rules (min/max) per metal layer? | Affects metal fill strategy and timing impact of fill | Medium
12 | What ESD protection level is required (HBM rating)? | Determines I/O pad cell selection and ESD clamp distribution | Medium

# 15. Complete Flow Sequence

The following captures the complete linear flow with all iteration loops. Each major checkpoint can generate ECOs that loop back to PnR, requiring all downstream stages to be re-verified.

RTL (.v)

↓

Synthesis (DC / Fusion Compiler) → Gate-Level Netlist

↓

GLS (Gate-Level Simulation) → Functional Verification Pass

↓

Floorplan (FCFP: block partitioning, pad ring, ESD, power grid)

↓

PnR: Place → CTS → Route → Optimize (ICC1/ICC2)

↓ ↑ (ECO loop)

Physical Verification — ICV (DRC + LVS + ERC) → Fix

↓

RedHawk (EMIR: IR Drop + Electromigration + Reliability)

↓

Parasitic Extraction (StarRC) → Accurate RC parasitics

↓

STA Sign-Off (PrimeTime) → All PVT corners clean

↓

VCLP (Low Power Checks) → Power intent verified

↓

LEC (Formality) → Logical equivalence confirmed

↓

Bump/Pad Placement + RDL Design

↓

Final PV (DRC + LVS with RDL layers)

↓

Post-Layout GLS (optional, SDF back-annotation)

↓

GDSII Streamout → Tape-Out to SCL Mohali

# Appendix A: Glossary

Term | Definition
ASIC | Application-Specific Integrated Circuit — custom chip fabricated for a specific purpose
CTS | Clock Tree Synthesis — building balanced clock distribution networks during PnR
CDC | Clock Domain Crossing — signals transitioning between different clock domains
DC | Design Compiler — Synopsys synthesis tool that maps RTL to gate-level netlist
DRC | Design Rule Check — verifies layout meets manufacturing process rules
ECO | Engineering Change Order — targeted netlist/layout modification to fix specific issues
EM | Electromigration — physical movement of metal atoms due to high current density
ERC | Electrical Rule Check — verifies electrical connectivity and well/substrate taps
ESD | Electrostatic Discharge — protection against voltage spikes during handling
FCFP | Full Chip Floorplan — top-level physical architecture planning for the die
GDS / GDSII | Graphic Data System II — industry-standard layout database format for fabrication
GLS | Gate-Level Simulation — functional simulation of synthesized netlist with timing
HBM | Human Body Model — ESD test standard simulating a human touching the chip
ICC | IC Compiler — Synopsys place-and-route tool (ICC1 = older, ICC2 = current gen)
ICV | IC Validator — Synopsys physical verification tool for DRC/LVS/ERC
IR Drop | Voltage drop across the power distribution network under load
LEC | Logic Equivalence Checking — formal proof that two netlists are functionally identical
LVS | Layout vs. Schematic — verifies physical layout matches the circuit netlist
MCMM | Multi-Corner Multi-Mode — STA across all PVT corners and operating modes simultaneously
PnR | Place and Route — physical placement of cells and routing of metal interconnects
PPA | Power, Performance, Area — the three fundamental optimization pillars in chip design
PV | Physical Verification — collective term for DRC + LVS + ERC checks
PVT | Process, Voltage, Temperature — corner conditions for timing analysis
RDL | Redistribution Layer — additional metal layer(s) above passivation for pad rerouting
SDF | Standard Delay Format — file containing timing delays for gate-level simulation
STA | Static Timing Analysis — exhaustive timing verification without simulation
UPF | Unified Power Format — standard for describing power intent (domains, gating, isolation)
VCLP | Voltage-aware Cell-Level Power — verification of low-power design implementation
WLCSP | Wafer-Level Chip-Scale Package — compact packaging using RDL and bumps

— End of Document —

AI Smart Glasses SoC — Physical Design Flow Confidential
