anirudhr-adtech/AI_GLASSES/AI_Smart_Glasses_docs/Physical Design/PD_Tools_Comparison_OpenSource_Synopsys_Cadence_v1.docx

PHYSICAL DESIGN TOOLS

Complete Industry Comparison

Open Source • Synopsys • Cadence • Siemens EDA (Mentor)

Document Version: 1.0

Date: March 2026

Reference for AI Smart Glasses SoC Physical Design Team

Open Source | Synopsys | Cadence | Siemens EDA

# Table of Contents

# 1. Master Tool Comparison by PD Stage

This section provides a comprehensive side-by-side comparison of tools across all four ecosystems: Open Source, Synopsys, Cadence, and Siemens EDA (formerly Mentor Graphics). Each row represents a specific PD function.

PD Function | Open Source | Synopsys | Cadence | Siemens EDA
RTL Synthesis | Yosys + ABC | Design Compiler (DC) | Genus Synthesis | Catapult (HLS) / Precision
Unified Synth+PnR | OpenLane 2 (flow) | Fusion Compiler | Genus + Innovus (integrated) | — (not unified)
Floorplanning | OpenROAD (init_floorplan) | ICC2 / Fusion Compiler | Innovus | Nitro-SoC
Placement | OpenROAD (global_place, detailed_place) | ICC2 / Fusion Compiler | Innovus | Nitro-SoC
Clock Tree Synthesis | OpenROAD (TritonCTS) | ICC2 (CTS engine) | Innovus (CCOpt) | Nitro-SoC
Routing | OpenROAD (TritonRoute) | ICC2 (Zroute) | Innovus (NanoRoute) | Nitro-SoC
Static Timing Analysis | OpenSTA | PrimeTime (PT) | Tempus | Questa STA
Parasitic Extraction | OpenRCX (in OpenROAD) | StarRC | Quantus QRC | xRC (Calibre xRC)
IR Drop / EM Analysis | OpenROAD (PDNSim) + IR solver | RedHawk (ANSYS) | Voltus | Calibre PERC
DRC (Design Rule Check) | Magic / KLayout | IC Validator (ICV) | Pegasus / PVS | Calibre nmDRC
LVS | Netgen | IC Validator (ICV) | Pegasus / PVS | Calibre nmLVS
ERC | Magic (partial) | IC Validator (ICV) | Pegasus / PVS | Calibre PERC
Logic Equivalence (LEC) | Yosys (equiv_*) | Formality | Conformal LEC | Questa Formal
Formal Verification | sby (Symbiyosys) | VC Formal | JasperGold | Questa Formal
Power Analysis | OpenROAD (PDNSim) | PrimePower / RedHawk | Voltus | Calibre PERC
Signal Integrity | — (limited) | PrimeTime SI | Tempus SI / Quantus SI | HyperLynx
Physical Aware Synthesis | Yosys + OpenROAD (integrated) | Fusion Compiler | Genus Physical | —
ECO (Eng. Change Order) | OpenROAD (repair_timing) | ICC2 ECO flow | Innovus ECO | Nitro-SoC ECO
Layout Editing | Magic / KLayout | Laker | Virtuoso Layout XL | Calibre DESIGNrev
Layout Viewer | KLayout | Custom Designer | Virtuoso | Calibre DESIGNrev
Memory Compiler | OpenRAM | DesignWare (SRAM) | Denali / Proprietary | Foundry-specific
GDSII Streamout | Magic / KLayout / OpenROAD | ICC2 | Innovus / Virtuoso | Calibre Stream
Full RTL-to-GDSII Flow | OpenLane 2 | Fusion Compiler | Genus → Innovus | — (multi-tool)

# 2. Detailed Comparison by Stage

## 2.1 RTL Synthesis

Tool | Yosys + ABC | Design Compiler (DC) | Genus Synthesis
Vendor | Open Source (ISC License) | Synopsys | Cadence
Language Support | Verilog-2005, partial SV; VHDL via plugin | Verilog, SystemVerilog, VHDL | Verilog, SystemVerilog, VHDL
Optimization Engine | ABC (Berkeley); good for area + delay | DesignWare library + proprietary opt. | Genus Spatial Opt.; multi-objective
Technology Mapping | Liberty (.lib) format; all standard cells | Full Liberty + CCS; DesignWare IP | Full Liberty + CCS/ECSM
Clock Gating | Basic (via plugin) | Integrated clock gating insertion (ICG) | Integrated clock gating (CCG)
DFT Support | None (external tool needed) | DFT Compiler integrated | Modus DFT integration
Physical Awareness | Via OpenROAD integration | Fusion Compiler (unified) | Genus Physical (floorplan-aware)
Scripting | TCL + Yosys commands | TCL (synopsys_dc.setup) | TCL (genus command set)
180nm Suitability | Excellent — mature node, well-supported | Excellent — industry standard | Excellent — industry standard

## 2.2 Static Timing Analysis

Tool | OpenSTA | PrimeTime (PT) | Tempus
Vendor | Open Source (GPLv3) | Synopsys | Cadence
Multi-Corner Multi-Mode | Yes (manual corner setup) | MCMM integrated | MCMM integrated (MMMC)
OCV / AOCV / POCV | OCV (basic); AOCV via manual derate | Full AOCV/POCV/SOCV | Full AOCV/POCV/SOCV
SI (Signal Integrity) | No | PrimeTime SI (crosstalk-aware) | Tempus SI (crosstalk-aware)
Parasitic Input | SPEF | SPEF / DSPF / SBPF | SPEF / DSPF / QRC native
ECO Guidance | Report-based (manual ECO) | PT-ECO with auto-fix suggestions | Tempus ECO with Innovus integration
SDF Generation | Yes | Yes (signoff-quality) | Yes (signoff-quality)
Constraint Format | SDC (standard) | SDC (standard) | SDC (standard)
180nm Suitability | Excellent — OCV sufficient at 180nm | Excellent — gold standard | Excellent — gold standard

## 2.3 Place and Route

Tool | OpenROAD | IC Compiler 2 (ICC2) | Innovus
Vendor | Open Source (BSD 3-Clause) | Synopsys | Cadence
Placement Engine | RePlAce (global) + OpenDP (detail) | Proprietary (concurrent opt.) | ePlace (global) + NanoPlace (detail)
CTS Engine | TritonCTS 2.0 | ICC2 CTS (multi-source, useful skew) | CCOpt (concurrent clock optimization)
Routing Engine | TritonRoute (detailed) + FastRoute (global) | Zroute (signoff-quality) | NanoRoute (signoff-quality)
Optimization | Resizer (gate sizing, buffering) | Concurrent timing/area/power opt. | GigaOpt (multi-objective)
Power Grid | PDN generation (stripes + rings) | Full power network synthesis | FloorPlan + PowerPlan
Parasitic Extraction | OpenRCX (integrated) | Requires StarRC (separate) | QRC integrated in Innovus
IR Drop (in-design) | PDNSim (basic static) | RedHawk fusion (in-design) | Voltus-inside-Innovus
Scripting | TCL (OpenROAD commands) | TCL (icc2_shell) | TCL (innovus commands)
180nm Suitability | Excellent — very capable at mature nodes | Excellent — industry standard | Excellent — industry standard

## 2.4 Physical Verification (DRC + LVS)

Tool | Magic + Netgen + KLayout | IC Validator (ICV) | Pegasus / PVS
Vendor | Open Source | Synopsys | Cadence
DRC Engine | Magic (interactive) + KLayout (scripted) | ICV (batch + in-design in ICC2) | Pegasus (batch + in-design in Innovus)
LVS Engine | Netgen (SPICE-level comparison) | ICV LVS | Pegasus LVS / PVS
ERC | Magic (basic well/substrate checks) | ICV ERC (comprehensive) | Pegasus ERC
In-Design DRC | Via OpenROAD DRC checks (basic) | Full signoff DRC inside ICC2 | Full signoff DRC inside Innovus
Rule Deck Format | Magic (.tech) + KLayout (.drc Ruby/Python) | ICV rule deck (.rs) | PVS rule deck (.pvl)
Antenna Check | Magic antenna rules | ICV antenna checking | Pegasus antenna checking
Density Check | KLayout density scripts | ICV density verification | Pegasus density verification
180nm Suitability | Excellent — 180nm DRC rules are simple enough | Excellent | Excellent
Siemens Alternative | — | Calibre nmDRC + nmLVS (industry gold standard for signoff PV) | —

Note on Calibre

Siemens EDA (formerly Mentor Graphics) Calibre is considered the industry gold standard for physical verification. Many foundries, including some for 180nm, provide their DRC/LVS decks exclusively in Calibre format. When working with SCL Mohali, confirm whether their DRC/LVS deck is provided for ICV (Synopsys), Pegasus (Cadence), Calibre (Siemens), or multiple formats.

## 2.5 Power Integrity and EM/IR Analysis

Tool | OpenROAD PDNSim | RedHawk (Synopsys/ANSYS) | Voltus (Cadence)
Vendor | Open Source | Synopsys | Cadence
Static IR Drop | Yes (basic grid analysis) | Yes (full signoff) | Yes (full signoff)
Dynamic IR Drop | Limited | Yes (VCD-based transient analysis) | Yes (VCD-based transient analysis)
Electromigration (EM) | No | Yes (per-wire and per-via EM check) | Yes (EM analysis with aging)
Power Estimation | Basic switching power | PrimePower (activity-based) | Voltus (activity-based)
Thermal Analysis | No | RedHawk-SC (chip-package thermal) | Voltus thermal co-simulation
Reliability | No | EM + self-heating + aging | EM + self-heating + BTI aging
180nm Suitability | Adequate for early estimation; flag issues | Full signoff | Full signoff

## 2.6 Logic Equivalence Checking (LEC)

Tool | Yosys (equiv_* commands) | Formality | Conformal LEC
Vendor | Open Source | Synopsys | Cadence
Methodology | SAT-based equivalence; basic miter checking | Formal proof engine; industry standard | Formal proof engine; industry standard
Hierarchical LEC | Limited | Full hierarchical with retiming support | Full hierarchical with retiming support
Debug | Counter-example via SAT solver | GUI-based failing point debug | GUI-based failing point debug
Capacity | Small to medium designs | Multi-million gate designs | Multi-million gate designs
Post-CTS / Post-Route | Basic (manual setup needed) | Fully automated post-PnR flow | Fully automated post-PnR flow
180nm Suitability | Adequate for module-level; flag issues early | Full signoff | Full signoff

## 2.7 Parasitic Extraction

Tool | OpenRCX | StarRC | Quantus QRC
Vendor | Open Source (in OpenROAD) | Synopsys | Cadence
Extraction Type | RC (lumped + distributed) | Full RC: lumped, distributed, coupled | Full RC: lumped, distributed, coupled
Output Format | SPEF | SPEF / DSPF / SBPF | SPEF / DSPF / native QRC
Accuracy at 180nm | Sufficient — coupling less critical at wide spacing | Gold standard accuracy | Gold standard accuracy
Coupling Capacitance | Basic | Full coupling with reduction | Full coupling with reduction
Inductance | No | Optional inductance extraction | Optional inductance extraction
180nm Suitability | Good for iteration; commercial tool for signoff | Full signoff | Full signoff
Siemens Alternative | — | Calibre xRC (also widely used for extraction) | —

# 3. End-to-End Flow Comparison

This section shows how each ecosystem assembles tools into a complete RTL-to-GDSII flow. The stages are identical; only the tool names change.

PD Stage | Open Source Flow | Synopsys Flow | Cadence Flow
1. RTL Synthesis | Yosys + ABC | Design Compiler (DC) | Genus
2. Gate-Level Sim | Icarus Verilog / Verilator | VCS | Xcelium
3. SDC Constraints | Written manually / Claude-generated | Written manually | Written manually
4. Floorplan | OpenROAD (init_floorplan) | ICC2 (create_floorplan) | Innovus (floorPlan)
5. Placement | OpenROAD (global_place + detail_place) | ICC2 (place_opt) | Innovus (placeDesign)
6. CTS | OpenROAD (TritonCTS) | ICC2 (clock_opt) | Innovus (ccopt_design)
7. Routing | OpenROAD (global_route + detail_route) | ICC2 (route_auto) | Innovus (routeDesign)
8. Parasitic Extraction | OpenRCX | StarRC | Quantus QRC
9. STA Sign-off | OpenSTA (multi-corner) | PrimeTime (MCMM) | Tempus (MMMC)
10. DRC | Magic / KLayout | IC Validator | Pegasus / Calibre
11. LVS | Netgen | IC Validator | Pegasus / Calibre
12. IR Drop / EM | OpenROAD PDNSim (basic) | RedHawk | Voltus
13. LEC | Yosys equiv_* | Formality | Conformal LEC
14. GDSII Export | Magic / KLayout | ICC2 (write_gds) | Innovus (streamOut)

# 4. 180nm-Specific Tool Considerations

At the 180nm process node, certain tool capabilities that are critical at advanced nodes become less important. This section highlights what matters and what doesn’t at 180nm.

## 4.1 Features That Matter at 180nm

Feature | Why It Matters | Open Source Capability
Basic DRC/LVS | Manufacturing correctness is always essential | Fully capable (Magic + Netgen)
Setup/Hold STA | Timing closure is required at any node | Fully capable (OpenSTA)
CTS with skew control | Clock tree balance affects timing | Capable (TritonCTS) — sufficient for 100–200 MHz
IR Drop (static) | Power grid must deliver current without excessive drop | Capable (PDNSim)
Metal density fill | 180nm has density rules per layer | Capable (OpenROAD fill + KLayout scripts)
SRAM macro placement | Large macros dominate 180nm die area | Capable (OpenROAD macro placement)
Multi-clock domain STA | SoC has 4 clock domains requiring correct constraints | Capable (OpenSTA with SDC)

## 4.2 Features Less Critical at 180nm

Feature | Why Less Critical | Commercial Tool
AOCV / POCV / SOCV | On-chip variation is small at 180nm; basic OCV derate is sufficient | PrimeTime / Tempus
Signal Integrity (SI) | Wide metal spacing at 180nm means minimal crosstalk coupling | PrimeTime SI / Tempus SI
FinFET modeling | 180nm is planar MOSFET — no FinFET effects | N/A
Double/multi-patterning | Single-patterning at 180nm — no coloring constraints | ICC2 / Innovus
Advanced EM models | EM limits are relaxed at 180nm; basic checks sufficient | RedHawk / Voltus
Self-heating analysis | Negligible at 180nm power densities | RedHawk / Voltus
3D extraction (inductance) | Not needed at 180nm frequencies (100–200 MHz) | StarRC / QRC
Machine learning optimization | Overkill for 180nm complexity | ICC2 ML / Innovus ML

Bottom Line for 180nm

At 180nm, the gap between open-source and commercial tools is the smallest it will ever be. The features that differentiate commercial tools (advanced OCV, SI, FinFET, multi-patterning, ML optimization) are all targeted at 16nm and below. At 180nm, open-source tools cover 90%+ of what you need for iteration and pre-convergence. Commercial tools are needed only for final sign-off and foundry DRC/LVS deck compatibility.

# 5. Licensing and Cost Comparison

Aspect | Open Source | Synopsys | Cadence
License Model | Free and open (ISC, BSD, GPL, Apache) | Annual subscription or perpetual | Annual subscription or perpetual
Cost | $0 | $100K–$500K+/year per seat (varies by tools) | $100K–$500K+/year per seat (varies by tools)
Source Code | Fully available; modifiable | Proprietary; binary only | Proprietary; binary only
Support | Community + academic (open forums, GitHub) | Dedicated support engineers + TAC | Dedicated support engineers + TAC
PDK Availability | SKY130 (free); others limited | All foundry PDKs via NDA | All foundry PDKs via NDA
Training | Documentation + tutorials + academic papers | Synopsys University + formal training | Cadence University + formal training
Updates | Continuous (GitHub); varies by project | Quarterly/annual releases | Quarterly/annual releases
Foundry Sign-off | Not accepted by foundries for tape-out | Accepted (ICV, PT, DC) | Accepted (Pegasus, Tempus, Genus/Innovus)

Our Approach

Use open-source tools (free) for all iteration and pre-convergence — this is where 80% of engineering time is spent. Use commercial Synopsys tools (licensed) only for final sign-off and SCL Mohali tape-out — this is 20% of the effort. This maximizes value from commercial licenses while keeping iteration speed high.

# 6. Cross-Ecosystem File Format Compatibility

A critical advantage of the PD industry is standardized file formats. This table shows which formats are shared across all ecosystems, enabling seamless migration from open-source iteration to commercial sign-off.

Format | Open Source | Synopsys | Cadence
SDC (constraints) | ✓ Full support (OpenSTA) | ✓ Native (PrimeTime, DC) | ✓ Native (Tempus, Genus)
Liberty .lib (timing) | ✓ Full support (all tools) | ✓ Native (all tools) | ✓ Native (all tools)
LEF (physical abstracts) | ✓ Full support (OpenROAD) | ✓ Native (ICC2) | ✓ Native (Innovus)
DEF (design exchange) | ✓ Full support (OpenROAD) | ✓ Native (ICC2) | ✓ Native (Innovus)
SPEF (parasitics) | ✓ Full support (OpenSTA) | ✓ Native (StarRC, PT) | ✓ Native (QRC, Tempus)
SDF (timing annotation) | ✓ Full support | ✓ Native | ✓ Native
UPF (power intent) | ✓ Partial (OpenROAD) | ✓ Native (ICC2, Formality) | ✓ Native (Innovus, Conformal)
GDSII (layout) | ✓ Full support (Magic, KLayout) | ✓ Native (ICC2, Laker) | ✓ Native (Innovus, Virtuoso)
Verilog netlist | ✓ Full support | ✓ Full support | ✓ Full support
SPICE (circuit netlist) | ✓ Full support (Netgen) | ✓ Full support | ✓ Full support
VCD (switching activity) | ✓ Full support | ✓ Full support | ✓ Full support

Every standard format (✓) transfers directly between ecosystems. This means the SDC constraints validated in OpenSTA work identically in PrimeTime. The DEF floorplan from OpenROAD can be imported into ICC2. The GDSII from KLayout is the same format ICC2 exports. This interoperability is the foundation of our open-source pre-convergence strategy.

# 7. Recommendation for AI Glasses SoC

## 7.1 Recommended Toolchain

Based on the project’s requirements (180nm at SCL Mohali, moderate complexity, aggressive schedule, cost-sensitivity for iteration), the recommended approach is a hybrid toolchain:

Stage | Iteration Tool (Claude Loops) | Sign-off Tool (PD Engineer)
Synthesis | Yosys + ABC | Synopsys DC (SCL 180nm libs)
STA | OpenSTA | Synopsys PrimeTime
Floorplan + PnR | OpenROAD (SKY130 PDK) | Synopsys ICC1/ICC2 (SCL 180nm PDK)
Parasitic Extraction | OpenRCX | Synopsys StarRC
DRC | Magic + KLayout | Synopsys ICV (SCL DRC deck)
LVS | Netgen | Synopsys ICV (SCL LVS deck)
Power Integrity | OpenROAD PDNSim | Synopsys RedHawk
LEC | Yosys equiv_* | Synopsys Formality
Full Flow | OpenLane 2 | Synopsys Fusion Compiler (optional)

## 7.2 Why Synopsys as the Commercial Flow

The decision between Synopsys and Cadence for the commercial sign-off flow depends on what SCL Mohali supports. Based on our team discussion, SCL’s 180nm PDK is validated against the Synopsys flow (DC + ICC + PrimeTime + ICV + RedHawk + Formality). This makes Synopsys the natural choice for sign-off. However, the SDC, UPF, LEF, DEF, SPEF, and GDSII files generated during open-source iteration are equally compatible with the Cadence flow (Genus + Innovus + Tempus + Pegasus + Voltus + Conformal) if the team ever switches ecosystems.

## 7.3 Migration Path

The open-source flow produces industry-standard deliverables that map directly to commercial tools. No information is lost in the transition. The SDC constraints, floorplan decisions, CTS strategy, and optimization approach all transfer. What changes is only the specific tool commands and the PDK-specific cell names and design rules. Your PD engineer replaces the SKY130 references with SCL 180nm equivalents, adjusts any process-specific parameters, and runs the sign-off flow on an already-converged design.

— End of Document —

PD Tools Comparison — Open Source vs. Commercial Reference Document
