anirudhr-adtech/AI_GLASSES/AI_Smart_Glasses_docs/Specs and Sub system implementation document/AI_Smart_Glasses_SoC_Executive_Overview.docx

AI SMART GLASSES

System-on-Chip (SoC) Architecture

Executive Overview

Document Version: 1.0

Date: March 2026

Classification: Confidential

Table of Contents

# 1. Introduction to the Product

AI Smart Glasses represent a new category of wearable computing — eyewear that can see, hear, and think. At its core is a custom-designed System-on-Chip (SoC) that combines computer vision, audio intelligence, and neural-network inference into a single, low-power package small enough to fit inside a pair of glasses.

Unlike existing smart glasses that rely on a tethered smartphone for processing, our approach places the intelligence directly on the device. The SoC processes camera frames, microphone audio, and sensor data locally, enabling real-time responses without cloud dependency. This means faster reaction times, stronger privacy (data never leaves the device), and the ability to work offline in any environment.

## 1.1 What the Chip Does

The SoC is the brain of the glasses. It integrates five major functional blocks onto a single chip:

- A RISC-V processor that runs the device firmware, manages peripherals, and coordinates all subsystems.
- A Neural Processing Unit (NPU) that accelerates AI model inference — face detection, keyword recognition, and gesture classification — at over 100 million operations per second.
- An audio intelligence pipeline that converts raw microphone audio into compact feature representations (MFCCs) used by speech and keyword-spotting models.
- A camera and vision pipeline that captures video frames, converts color formats, resizes images, and crops detected regions of interest (such as faces) for the NPU.
- A high-speed interconnect and memory system that lets all subsystems share a single pool of DDR memory without bottlenecks, with smart traffic management ensuring the NPU and camera get priority when needed.

## 1.2 Development Approach

The project follows a two-phase hardware strategy. In Phase 0, the complete SoC design is implemented and validated on a commercially available FPGA development board (Xilinx Zynq Z7-20). This lets us prove the full architecture in real hardware at relatively low cost and short timelines. In Phase 1, the validated design moves to a custom ASIC fabrication at SCL Mohali on 180nm silicon, producing a dedicated chip optimized for the glasses form factor.

All hardware modules are described in synthesizable Verilog RTL (the industry-standard language for chip design), with a rigorous three-tier verification strategy covering 89 modules and 120+ testbenches. The design is fully open-source compatible, using the Ibex RISC-V processor core from the lowRISC project.

Key differentiator: Full on-device AI inference with no cloud dependency.

All processing — vision, audio, and neural networks — happens locally on the chip,

delivering sub-second response times and complete data privacy.

# 2. Use Cases and Applications

The AI Smart Glasses SoC enables a wide range of real-world applications across consumer, enterprise, and accessibility markets. Below are the primary use cases the platform is designed to support.

## 2.1 Real-Time Face Recognition

The camera captures a frame, the ISP pipeline resizes it, and the crop engine extracts detected face regions. The NPU runs a lightweight face-recognition model (MobileFaceNet) to identify known individuals. This enables hands-free identification in security, retail greeting, or personal memory-aid scenarios. The entire pipeline — from frame capture to recognition result — completes within a single 33ms frame interval.

## 2.2 Voice Command and Keyword Spotting

The audio subsystem continuously converts microphone input into MFCC feature tensors and feeds them to the NPU for keyword detection. Users can issue voice commands ("take a photo," "navigate home," "call contact") without pressing any button. The always-listening pipeline operates at extremely low bandwidth (~320 KB/s), making it viable for battery-powered operation.

## 2.3 Real-Time Language Translation

By combining the audio MFCC pipeline with a compact sequence-to-sequence model on the NPU, the glasses can provide on-device speech-to-text and basic translation. This is especially useful for travelers and multilingual business meetings, where low-latency local processing avoids the delays of cloud-based translation services.

## 2.4 Accessibility and Assistive Vision

For visually impaired users, the camera and NPU can work together to identify objects, read text (OCR), detect obstacles, and describe scenes. Audio feedback is delivered through the glasses’ speakers or bone conduction. Because processing is on-device, it works reliably in areas without internet connectivity.

## 2.5 Augmented Reality Overlays

The vision pipeline provides the processed camera feed needed for AR applications. Object detection results from the NPU can be used to anchor virtual information to real-world objects. Navigation arrows, product information, or contextual notes can be projected onto a heads-up display integrated into the glasses.

## 2.6 Workplace and Industrial Assistance

In warehouse, manufacturing, or field-service environments, the glasses can provide hands-free barcode scanning, equipment identification, step-by-step repair guidance, and safety alerts. The SPI and I2C interfaces support additional sensors (accelerometer, gyroscope) for head-tracking and gesture detection.

## 2.7 Health and Wellness Monitoring

With sensor integration via I2C (heart rate, SpO2, temperature) and the NPU for pattern analysis, the glasses can monitor health metrics and alert the wearer to anomalies. The always-on audio pipeline can also detect environmental sounds (sirens, alarms, someone calling) and notify the user.

## 2.8 Smart Home and IoT Control

The SPI interface to an ESP32 wireless module enables the glasses to act as a control hub for smart home devices. Voice commands processed locally by the audio and NPU subsystems trigger actions on connected devices, without sending voice recordings to the cloud.

# 3. System Architecture: Subsystem Overview

The SoC comprises nine interconnected subsystems, each responsible for a distinct function. Together, they form a complete AI inference platform. The following sections provide a brief overview of each subsystem, its role, and key capabilities.

Subsystem | Primary Function | Key Specification
RISC-V CPU | System control and firmware | Ibex RV32IMC, 100 MHz, 512KB SRAM
NPU | AI model inference | 8x8 INT8 MAC array, 200 MHz, >100 MOPS
Audio / MFCC | Audio feature extraction | 1024-pt FFT, 49x10 MFCC tensor output
Camera / Vision | Image capture and processing | 640x480 DVP, bilinear resize, crop engine
AXI Interconnect | On-chip communication bus | 5x5 crossbar, tiered-priority arbiter
DDR Bridge | External memory interface | 128-bit to 64-bit, burst splitting
Peripherals | External I/O interfaces | UART, GPIO, Timer, IRQ controller
I2C | Sensor communication | Standard/Fast mode, multi-device bus
SPI | High-speed serial I/O | 4 modes, configurable clock, ESP32 link

## 3.1 RISC-V CPU Subsystem

The RISC-V subsystem is the central controller of the entire SoC. It runs the device firmware, configures every other subsystem through memory-mapped registers, handles interrupts, and orchestrates the overall AI inference pipeline.

Processor Core: The subsystem uses the Ibex core, an open-source 32-bit RISC-V processor developed by lowRISC. It implements the RV32IMC instruction set (integer, multiply/divide, and compressed instructions), providing a good balance of performance and silicon area. The core runs at 100 MHz.

Memory: A 4KB boot ROM holds initial startup code loaded at fabrication. A 512KB on-chip SRAM serves as the primary working memory for firmware execution, stack, and data buffers. For large data (AI model weights, image frames, audio tensors), the system accesses external DDR memory through the AXI interconnect.

Bus Adapters: Two dedicated adapters translate the Ibex processor’s native bus protocol into the industry-standard AXI4 bus protocol used throughout the SoC. One adapter handles instruction fetches; the other handles data reads and writes.

Interrupt Handling: An interrupt controller aggregates signals from all subsystems (NPU done, audio MFCC ready, camera frame captured, UART receive, timer expiry) and presents them to the CPU in priority order. This allows the firmware to respond immediately to events rather than continuously polling for status.

## 3.2 Neural Processing Unit (NPU)

The NPU is the AI acceleration engine of the SoC. It is purpose-built to run lightweight neural-network models (MobileNet, MobileFaceNet, keyword-spotting CNNs) at high throughput while consuming minimal power.

Compute Core: At its heart is an 8×8 array of multiply-accumulate (MAC) units, providing 64 parallel operations per clock cycle. Each MAC performs INT8 × INT8 multiplication with INT32 accumulation, which is the standard precision used by quantized AI models on edge devices. Running at 200 MHz, the array delivers over 100 million operations per second (MOPS).

Supported Operations: The NPU handles the core building blocks of modern convolutional neural networks: standard 2D convolution (Conv2D), depthwise separable convolution (DW-Conv2D, used heavily in MobileNet), fully connected layers, max pooling, and average pooling. A configurable activation stage supports ReLU, ReLU6, and bypass modes.

Memory and DMA: Two 128KB on-chip buffers (one for weights, one for activations) allow the NPU to pre-load data while computing, hiding memory latency. A dedicated 128-bit DMA engine with two independent channels fetches weights and activations from DDR memory at high bandwidth, independent of the CPU.

Quantization: After accumulation, a hardware quantization block converts INT32 results back to INT8 using configurable scale and shift parameters. This keeps the data compact as it flows through successive network layers.

## 3.3 Audio and MFCC Subsystem

The audio subsystem converts raw microphone input into Mel-Frequency Cepstral Coefficients (MFCCs) — a compact numerical representation of audio that is the standard input format for speech recognition and keyword-spotting AI models.

Audio Input: An I2S receiver interface connects to an external audio codec (microphone). It captures 16-bit mono audio sampled at 16 kHz, the standard rate for voice-processing applications.

MFCC Pipeline: The raw audio goes through a multi-stage signal-processing pipeline entirely in hardware: framing (640-sample windows with 320-sample overlap), Hamming windowing (smoothing frame edges), 1024-point Fast Fourier Transform (frequency analysis), power spectrum computation, 40-band Mel filterbank (mimicking human hearing perception), logarithmic compression, and finally a Discrete Cosine Transform that produces 10 MFCC coefficients per frame.

Output: The pipeline assembles 49 consecutive frames into a 49×10×1 INT8 tensor — approximately one second of audio — and writes it to DDR memory via a dedicated DMA channel. The NPU then picks up this tensor for keyword detection or voice-command classification.

Efficiency: The entire audio pipeline operates at 100 MHz with very low memory bandwidth (∼320 KB/s), making it highly power-efficient and suitable for always-on operation in a battery-constrained glasses form factor.

## 3.4 Camera and Vision Subsystem

The camera subsystem handles everything from raw pixel capture to delivering processed, correctly sized image tensors that the NPU can consume for vision-based AI tasks.

Camera Interface: A Digital Video Port (DVP) interface connects to an OV7670 camera module, capturing 640×480-pixel frames at 30 frames per second in YUV422 color format. The interface handles the precise timing synchronization required to capture pixels from the camera’s separate clock domain.

Image Processing (ISP-Lite): A lightweight image signal processing pipeline converts YUV422 color data to RGB888 (standard red/green/blue format) using the BT.601 standard, then applies bilinear interpolation to resize the full 640×480 frame down to 128×128 pixels — the input size required by object-detection models like MobileNet-SSD.

Video DMA and Frame Buffering: A 128-bit DMA engine writes processed frames to DDR memory. A double-buffering scheme ensures one frame can be written while the previous frame is being read by the NPU, preventing visual tearing and maintaining smooth 30 FPS operation.

Crop Engine: After the NPU detects a face (using BlazeFace), the crop engine reads the detected region of interest from DDR, resizes it to 112×112 pixels using bilinear interpolation, and writes it back. This cropped face tensor is then fed to MobileFaceNet for identity recognition. The crop engine operates independently, so the main camera pipeline continues capturing the next frame in parallel.

## 3.5 AXI Interconnect

The AXI interconnect is the communication backbone of the SoC. It connects all masters (components that initiate data transfers) to all slaves (components that respond) through a high-performance switching fabric.

Crossbar Architecture: A 5-master × 5-slave crossbar allows multiple simultaneous data transfers. For example, the NPU can be fetching weights from DDR while the CPU reads a peripheral register and the camera writes a frame — all at the same time, with no blocking.

Smart Traffic Management: A tiered-priority arbiter ensures time-sensitive subsystems get memory access first: the NPU has highest priority (Tier 0), the camera is next (Tier 1), and the CPU and audio share the lowest tier (Tier 2) with round-robin fairness. An anti-starvation mechanism guarantees that even lowest-priority masters are never locked out for too long.

Width Conversion: Because different subsystems use different data widths (the CPU uses 32-bit, while the NPU and camera use 128-bit), built-in width converters automatically adapt transfers between narrow and wide buses. This is handled transparently — each subsystem sees a clean interface at its native width.

## 3.6 DDR Memory Bridge

The DDR bridge connects the SoC’s internal 128-bit bus to external DDR memory through the Zynq FPGA’s hard memory controller port.

Protocol Adaptation: The bridge performs three transformations: it splits large bursts (up to 256 beats internally) into smaller sub-bursts (16 beats maximum) compatible with the DDR controller, converts the data width from 128 bits down to 64 bits, and translates from the AXI4 protocol to the older AXI3 protocol required by the Zynq memory port.

Capacity: The DDR address space provides up to 2GB of shared external memory. This stores AI model weights, input/output image frames, audio tensors, and any large data structures the firmware requires.

## 3.7 Peripherals

The peripheral subsystem provides the standard I/O interfaces needed for the glasses to communicate with the outside world:

- UART: Serial communication for debugging, logging, and firmware updates. Supports 115200 baud with hardware TX/RX FIFOs.
- GPIO: 8-bit general-purpose I/O for LED control, button inputs, and status signaling. Supports edge-triggered interrupts.
- Timer (CLINT): A RISC-V standard timer providing precise time measurement and periodic interrupt generation for firmware scheduling.
- I2C Master: Connects to sensors (accelerometer, gyroscope, heart-rate monitor) over a multi-device two-wire bus. Supports standard and fast modes.
- SPI Master: High-speed serial interface connecting to the ESP32 wireless module for Bluetooth and Wi-Fi communication. Supports all four SPI modes with configurable clock speed.

All peripherals are accessed by the CPU through a lightweight AXI4-Lite bus, with each peripheral occupying its own address range in the system memory map.

# 4. Verification and Quality Assurance

The SoC undergoes a rigorous three-level verification process to ensure every component works correctly before it reaches hardware. This is a standard practice in the semiconductor industry, and it is the primary way we build confidence that the chip will function as intended on first silicon.

## 4.1 Three-Level Testing Strategy

Level 1 — Module Testing: Every individual hardware module (89 total) is tested in isolation with dedicated testbenches that exercise all input combinations, boundary conditions, and error scenarios. There are 120+ testbenches in total, each producing automated pass/fail reports.

Level 2 — Subsystem Testing: Each major subsystem (NPU, Audio, Camera, Interconnect, CPU) is tested as a complete unit. Real-world input data (images, audio clips, neural-network weights) is fed in, and the output is compared against golden reference values generated by Python models. This confirms the full data pipeline works end to end.

Level 3 — Full System Testing: The complete SoC is tested with actual firmware running on the RISC-V processor. The CPU boots, configures all subsystems, and executes realistic workloads: NPU inference, camera frame capture, audio processing, and multi-subsystem stress tests with all DMA engines running simultaneously.

## 4.2 Coverage Summary

Subsystem | RTL Modules | Testbenches | Key L2 Tests
NPU | 12 | 12 | Conv2D, DW-Conv2D, FC, Pooling, DMA stress
Audio / MFCC | 21 | 21 | Silence, sine wave, speech, 49-frame tensor
Camera | 18 | 18 | Full frame, color bar, double buffer, crop
AXI Interconnect | 17 | 17 | Multi-master, priority, width conversion
DDR Bridge | 15 | 15 | Burst splitting, width convert, back-to-back
RISC-V + Peripherals | 24 | 21 | Boot, SRAM, UART, timer, IRQ, GPIO
I2C + SPI | 14 | 14 | Protocol compliance, loopback, modes
TOTAL | 89+ | 120+ | 10 SoC-level integration scenarios

# 5. Development Roadmap

The project follows a phased execution plan, with each phase building on proven results from the previous one.

Phase | Milestone | Deliverable
Phase 0a | RTL Design Complete | All 89 modules coded in synthesizable Verilog, lint-clean
Phase 0b | Verification Complete | All 120+ testbenches pass, golden-vector match, AXI compliance
Phase 0c | FPGA Bring-Up | SoC running on Zynq Z7-20, LED blink, UART output, NPU inference demo
Phase 0d | FPGA Demo | End-to-end demo: camera + audio + NPU on FPGA with real-time output
Phase 1 | ASIC Tape-Out | Design submitted to SCL Mohali for 180nm fabrication
Phase 2 | Silicon Validation | First chips received, tested, and integrated into glasses prototype

Current status: Phase 0a nearing completion.

89 RTL modules designed. Verification infrastructure being built.

Target: FPGA demonstration within 13 weeks.

# 6. Why This Architecture Matters

Several architectural choices make this SoC uniquely positioned in the emerging smart-glasses market:

## 6.1 On-Device Intelligence

By placing the NPU, audio pipeline, and vision pipeline on the same chip as the CPU, we eliminate the need for cloud connectivity during inference. This translates directly to faster response times (milliseconds, not seconds), stronger user privacy (no audio or video leaves the device), and reliable operation in connectivity-dead zones.

## 6.2 Purpose-Built, Not General-Purpose

Unlike solutions that repurpose mobile phone chips (which waste power on unused features), our SoC includes only what smart glasses need. Every transistor serves a purpose. The NPU is optimized for the specific model architectures used in wearable AI (MobileNet, BlazeFace, MobileFaceNet), and the audio pipeline is hardwired for MFCC extraction rather than general-purpose DSP.

## 6.3 Open-Source Foundation

The RISC-V instruction set and Ibex processor core are royalty-free and open source. This eliminates per-chip licensing fees (unlike ARM-based alternatives), gives us full visibility into the processor for debugging and optimization, and avoids vendor lock-in for future chip revisions.

## 6.4 Scalable Verification

The three-tier verification methodology (module, subsystem, SoC) with 120+ automated testbenches and golden-vector comparison provides high confidence in silicon correctness before committing to fabrication. This systematic approach significantly reduces the risk of costly chip re-spins.

End of Document

For questions, contact the engineering team.

Confidential | Page

AI Smart Glasses SoC Executive Overview
