anirudhr-adtech/AI_GLASSES/AI_Smart_Glasses_docs/Specs and Sub system implementation document/I2C_Master_RTL_Implementation.docx

I2C MASTER PERIPHERAL

RTL IMPLEMENTATION DOCUMENT

AI Glasses SoC — Phase 0 FPGA Prototype

IMU Sensor Interface | I2C Standard/Fast Mode | OV7670 SCCB Config | AXI4-Lite Slave

Field | Value
Document Version | 1.0
Status | DRAFT — Architecture Lock
Phase | Phase 0 — FPGA Prototype
Author | Anirudh (Sole Architect)
Date | March 2026
Primary Uses | 1) IMU sensor (MPU-6050/BMI270) for gesture recognition. 2) OV7670 camera SCCB configuration.
AXI-Lite Base Address | 0x2000_0600 (Peripheral slot P6)
Companion Docs | AXI Interconnect v2, Camera/Vision Subsystem, RISC-V Subsystem v2

# 1. Overview

The I2C Master peripheral provides a standard I2C interface for communicating with on-board sensors and configuring camera modules. In Phase 0, it serves two purposes: reading accelerometer/gyroscope data from an IMU sensor (MPU-6050 or BMI270) for gesture recognition (Use Case 2), and writing configuration registers to the OV7670 camera module via SCCB (Serial Camera Control Bus, which is I2C-compatible).

## 1.1 Role in the System

- Reads IMU accelerometer (3-axis) and gyroscope (3-axis) data at up to 100 Hz sample rate
- IMU data is buffered in a sensor FIFO, then transferred to DDR via CPU for NPU gesture inference
- Configures OV7670 camera sensor registers at boot time (resolution, format, timing, AE/AWB settings)
- Supports multi-byte register reads/writes for sensors with auto-increment address mode

## 1.2 Locked Parameters

Parameter | Decision | Rationale
I2C Speed | Standard (100 kHz) and Fast (400 kHz) mode | IMU sensors support both; 400 kHz sufficient for 100 Hz sampling of 12 bytes (6-axis x 16-bit)
Addressing | 7-bit slave addressing | All target sensors use 7-bit addresses (MPU-6050: 0x68/0x69, OV7670: 0x42/0x43)
Data Width | 8-bit (byte-oriented) | I2C standard byte transfers
TX/RX Buffer | 16-byte FIFO each | Sufficient for multi-register burst reads (IMU: 14 bytes per sample)
Clock Stretching | Supported | Some sensors use clock stretching for flow control
Multi-Master | Not supported | Single master system; no multi-master arbitration needed
Control Interface | AXI4-Lite at 0x2000_0600 | Consistent with peripheral fabric

# 2. Register Map

Base address: 0x2000_0600. 256-byte allocation.

Offset | Register | R/W | Reset | Description
0x00 | I2C_CONTROL | R/W | 0x0 | Bit[0]: Enable. Bit[1]: Soft reset (self-clearing). Bit[2]: IRQ enable. Bit[3]: Speed (0=100kHz, 1=400kHz).
0x04 | I2C_STATUS | RO | 0x0 | Bit[0]: Busy (transaction in progress). Bit[1]: Transfer done. Bit[2]: NACK received. Bit[3]: Arbitration lost. Bit[4]: Bus error (unexpected START/STOP). Bit[5]: RX data ready.
0x08 | I2C_SLAVE_ADDR | R/W | 0x0 | Bits[6:0]: 7-bit slave address. Bit[7]: R/W direction (0=write, 1=read).
0x0C | I2C_TXDATA | WO | — | Write byte to TX FIFO. First byte after START is the register address; subsequent bytes are data.
0x10 | I2C_RXDATA | RO | 0x0 | Read byte from RX FIFO. Bit[31] = FIFO empty flag. Bits[7:0] = received byte.
0x14 | I2C_XFER_LEN | R/W | 0x01 | Bits[7:0]: Number of bytes to read in a read transaction. For writes, length is determined by TX FIFO fill level.
0x18 | I2C_START | WO | — | Write 0x1 to initiate the I2C transaction. Transaction type determined by I2C_SLAVE_ADDR.bit[7].
0x1C | I2C_PRESCALER | R/W | 0x0 | Bits[15:0]: SCL clock prescaler. SCL_freq = sys_clk / (4 * (prescaler + 1)). Default for 100kHz at 100MHz: prescaler = 249. For 400kHz: prescaler = 62.
0x20 | I2C_IRQ_CLEAR | WO | — | Write 0x1 to clear transfer_done IRQ. Write 0x2 to clear NACK IRQ.
0x24 | I2C_FIFO_STATUS | RO | 0x0 | Bits[4:0]: TX FIFO fill level (0–16). Bits[12:8]: RX FIFO fill level (0–16). Bit[16]: TX FIFO full. Bit[17]: RX FIFO full.

# 3. I2C Protocol Implementation

## 3.1 Signal Definitions

Signal | Width | Direction | Description
i2c_scl_o | 1 | Output | SCL drive-low output. Open-drain: drive 0 to pull low, release (tristate) to let pull-up pull high.
i2c_scl_i | 1 | Input | SCL sense input. Reads actual SCL level (for clock stretching detection).
i2c_scl_oe_o | 1 | Output | SCL output enable. 1 = drive low. 0 = high-impedance (pull-up).
i2c_sda_o | 1 | Output | SDA drive-low output. Open-drain.
i2c_sda_i | 1 | Input | SDA sense input. Reads actual SDA level (for ACK/NACK detection).
i2c_sda_oe_o | 1 | Output | SDA output enable. 1 = drive low. 0 = high-impedance.

Open-drain implementation: FPGA I/O pins are configured as open-drain with external pull-up resistors (4.7kΩ typical). The RTL drives oe=1 to pull the line low, or oe=0 to release it. The i2c_*_i inputs always read the actual bus level, enabling ACK detection and clock stretching.

## 3.2 I2C Master FSM (i2c_master_fsm.sv)

State | Behavior
IDLE | SCL and SDA both released (high). Waits for I2C_START register write. On start: transition to GEN_START.
GEN_START | Generate START condition: SDA goes low while SCL is high. Hold for one SCL half-period. Transition to SEND_ADDR.
SEND_ADDR | Shift out 7-bit slave address + R/W bit, MSB first. 8 SCLK cycles. Transition to CHECK_ACK_ADDR.
CHECK_ACK_ADDR | Release SDA (input). Clock SCL once. Sample SDA: if low (ACK) → proceed. If high (NACK) → GEN_STOP, set NACK flag.
SEND_DATA | For write transactions: shift out next TX FIFO byte, MSB first. 8 SCL cycles. Transition to CHECK_ACK_DATA.
CHECK_ACK_DATA | Check slave ACK. If ACK and more TX data: back to SEND_DATA. If ACK and TX empty: GEN_STOP. If NACK: GEN_STOP + NACK flag.
RECV_DATA | For read transactions: release SDA, clock in 8 bits from slave, MSB first. Push to RX FIFO. Transition to SEND_ACK.
SEND_ACK | Master sends ACK (SDA low) if more bytes to read, or NACK (SDA high) if this is the last byte (per I2C_XFER_LEN). Then back to RECV_DATA or GEN_STOP.
GEN_STOP | Generate STOP condition: SDA goes high while SCL is high. Set transfer_done flag. Assert IRQ if enabled. Transition to IDLE.
CLOCK_STRETCH | After driving SCL low, check i2c_scl_i. If slave holds SCL low (stretching), wait here until SCL goes high. Then resume current state.

# 4. IMU Sensor Access Pattern

The IMU sensor (MPU-6050 or BMI270) provides 3-axis accelerometer + 3-axis gyroscope data. Each axis is 16-bit signed, so a complete sample is 12 bytes (or 14 bytes including temperature). The CPU reads IMU data periodically (100 Hz) using the following I2C sequence:

// IMU register read sequence (firmware pseudocode)

// MPU-6050 accelerometer data starts at register 0x3B (14 bytes burst)

i2c_write_reg(I2C_SLAVE_ADDR, 0x68 << 1 | 0); // Write mode, addr 0x68

i2c_write_reg(I2C_TXDATA, 0x3B); // Register address

i2c_write_reg(I2C_START, 1); // Send register address

wait_i2c_done();

i2c_write_reg(I2C_SLAVE_ADDR, 0x68 << 1 | 1); // Read mode

i2c_write_reg(I2C_XFER_LEN, 14); // Read 14 bytes

i2c_write_reg(I2C_START, 1); // Repeated START + read

wait_i2c_done();

// Read 14 bytes from RX FIFO: accel_x(2), accel_y(2), accel_z(2),

// temp(2), gyro_x(2), gyro_y(2), gyro_z(2)

for (int i = 0; i < 14; i++)

imu_data[i] = i2c_read_reg(I2C_RXDATA);

## 4.1 OV7670 Camera SCCB Configuration

At boot time, the CPU configures the OV7670 camera sensor via SCCB (I2C-compatible). Typical configuration: ~50–80 register writes for resolution (VGA), format (YUV422), timing (PCLK, HREF), and AE/AWB settings. Each write is 2 bytes: register address + value.

SCCB uses slave address 0x42 (write) / 0x43 (read). The I2C master is fully compatible with SCCB; no special handling needed.

# 5. RTL Module Hierarchy

i2c_master.sv // Top-level I2C master peripheral

├── i2c_regfile.sv // AXI4-Lite slave + register file

├── i2c_master_fsm.sv // I2C protocol FSM (10 states)

├── i2c_scl_gen.sv // SCL clock generator with stretching support

├── i2c_shift_reg.sv // 8-bit bidirectional shift register

├── i2c_tx_fifo.sv // 16-byte TX FIFO

└── i2c_rx_fifo.sv // 16-byte RX FIFO

## 5.1 RTL Generation Sequence

# | Module | Dependencies | Unit Test Focus

1 | i2c_tx_fifo.sv | None | Full/empty flags, 16-byte depth
2 | i2c_rx_fifo.sv | None | Full/empty flags, auto-advance on read
3 | i2c_scl_gen.sv | None | 100 kHz and 400 kHz generation. Clock stretching: wait when SCL held low.
4 | i2c_shift_reg.sv | None | MSB-first shift out/in, 8-bit count, open-drain drive logic
5 | i2c_master_fsm.sv | scl_gen, shift_reg | Full I2C transaction: START, addr+ACK, data+ACK, STOP. NACK handling.
6 | i2c_regfile.sv | None | AXI-Lite R/W, all register reset values
7 | i2c_master.sv | All above | Integration: CPU programs registers, I2C waveform generated, data received in FIFO

# 6. Verification Plan

Test | Description
Single byte write | Write slave_addr + 1 data byte. Verify START, addr byte, ACK check, data byte, ACK check, STOP on I2C bus.
Single byte read | Write slave_addr (read), read 1 byte. Verify repeated START, addr, ACK, 8 data bits clocked in, master NACK, STOP.
Multi-byte burst read (14 bytes) | IMU-style read: write reg addr, repeated start, read 14 bytes. Verify master ACKs first 13 bytes, NACKs 14th, STOP.
NACK handling | Simulate slave not responding (no ACK). Verify NACK flag set, STOP generated, no hang.
Clock stretching | Simulate slave holding SCL low for 100 cycles. Verify master waits, resumes correctly when released.
Speed modes | Configure 100 kHz and 400 kHz. Measure SCL frequency. Verify timing spec compliance.
OV7670 config sequence | Write 10 consecutive register+value pairs to SCCB address 0x42. Verify all writes succeed.
MPU-6050 data read | Use I2C slave BFM loaded with known accel/gyro data. Read 14 bytes. Verify RX FIFO contents match expected.

# 7. Top-Level Port List (i2c_master.sv)

Port | Width | Dir | Description
clk_i | 1 | I | System clock (100 MHz)
rst_ni | 1 | I | Active-low reset
s_axi_lite_* | various | I/O | AXI4-Lite slave interface (from peripheral fabric P6)
i2c_scl_o | 1 | O | SCL drive-low output (active-low, open-drain)
i2c_scl_oe_o | 1 | O | SCL output enable (1=drive low, 0=release)
i2c_scl_i | 1 | I | SCL sense input (actual bus level, for clock stretching)
i2c_sda_o | 1 | O | SDA drive-low output
i2c_sda_oe_o | 1 | O | SDA output enable
i2c_sda_i | 1 | I | SDA sense input (for ACK/NACK detection and arbitration)
irq_i2c_done_o | 1 | O | Transfer complete interrupt (to IRQ controller bit 7)

— End of I2C Master Peripheral RTL Implementation Document —

Confidential — Page

I2C Master Peripheral RTL Implementation AI Glasses SoC — Phase 0
