anirudhr-adtech/AI_GLASSES/AI_Smart_Glasses_docs/Specs and Sub system implementation document/SoC_Top_Level_Integration.docx

SoC TOP-LEVEL INTEGRATION

RTL IMPLEMENTATION DOCUMENT

AI Glasses SoC — Phase 0 FPGA Prototype (Zybo Z7-20)

Full Chip Wrapper | Clock & Reset Tree | Zynq PS Integration | Pin Mapping

Field | Value
Document Version | 1.0
Status | DRAFT — Architecture Lock
Phase | Phase 0 — FPGA Prototype
Author | Anirudh (Sole Architect)
Date | March 2026
Target Board | Digilent Zybo Z7-20 (Zynq XC7Z020-1CLG400C)
Integration Approach | Hybrid: Vivado Block Design for Zynq PS + RTL SoC module instantiated in BD
Total RTL Modules | ~110 across all subsystems
Companion Docs | All subsystem RTL implementation documents (RISC-V v2, NPU v2, Audio v2, Camera, AXI v2, DDR, SPI, I2C)

# 1. Overview

This document defines the top-level integration of all SoC subsystems into a single FPGA design targeting the Zybo Z7-20 board. It specifies how the RISC-V CPU, NPU, Audio, Camera, AXI Interconnect, and all peripherals are wired together, how clocks and resets are generated, and how the PL (Programmable Logic) connects to the Zynq PS (Processing System) for DDR access.

The SoC top-level module (soc_top.sv) is the single RTL entry point that gets instantiated inside the Vivado Block Design alongside the Zynq PS IP block.

## 1.1 Integration Architecture

ZYBO Z7-20 FPGA INTEGRATION

┌─────────────────────────────────────────────────────┐

│ VIVADO BLOCK DESIGN │

│ │

│ ┌─────────────┐ ┌─────────────────────────────┐ │

│ │ ZYNQ PS │ │ soc_top.sv (YOUR RTL) │ │

│ │ │ │ │ │

│ │ DDR3 Ctrl │ │ RISC-V + NPU + Audio + │ │

│ │ HP0 Port ◄─┴───► AXI Crossbar + DDR Wrapper │ │

│ │ FCLK_CLK0 ───► Camera + SPI + I2C + GPIO │ │

│ │ FCLK_RST0 ───► UART + Timer + IRQ Ctrl │ │

│ └─────────────┘ └─────────────────────────────┘ │

│ │ │ │ │ │

└─────────────────────────┼──────┼──────┼──────┼───────┘

PMOD/GPIO Pins to External World:

UART TX/RX | Camera DVP | I2S | SPI/ESP32 | I2C/IMU

# 2. soc_top.sv Module Hierarchy

soc_top.sv // SoC top-level RTL wrapper

├── riscv_subsys_top.sv // RISC-V CPU + bus adapters + boot ROM + SRAM

│ ├── ibex_core_wrapper.sv

│ ├── ibus_axi_adapter.sv

│ ├── dbus_axi_adapter.sv

│ ├── boot_rom.sv

│ ├── onchip_sram.sv

│ ├── timer_clint.sv

│ ├── irq_controller.sv

│ ├── uart_peripheral.sv

│ ├── gpio_peripheral.sv

│ └── rst_sync.sv

├── npu_top.sv // NPU accelerator

├── audio_subsys_top.sv // Audio capture + MFCC pipeline

├── cam_subsys_top.sv // Camera capture + ISP + crop engine

├── axi_crossbar.sv // 5M x 5S AXI4 crossbar

├── axilite_fabric.sv // 1M x 11S AXI4-Lite peripheral fabric

├── ddr_wrapper.sv // AXI4→AXI3 bridge to Zynq HP0

├── spi_master.sv // SPI master for ESP32-C3

├── i2c_master.sv // I2C master for IMU + OV7670 SCCB

└── clk_rst_mgr.sv // Clock and reset management

# 3. Clock and Reset Architecture

## 3.1 Clock Tree

Clock | Frequency | Source and Distribution
sys_clk | 100 MHz | Zynq PS FCLK_CLK0. Drives: RISC-V CPU, AXI crossbar, all peripherals, audio subsystem, camera ISP, DDR wrapper, SPI master, I2C master.
npu_clk | 200 MHz | Zynq PS FCLK_CLK1 (or MMCM from sys_clk). Drives: NPU MAC array, NPU DMA, NPU controller. Optional separate domain for higher throughput.
cam_pclk | ~24 MHz | External from OV7670 camera module. Async to sys_clk. Only used inside cam_subsys_top pixel FIFO write side.
i2s_sck | ~512 kHz | External from audio codec. Async to sys_clk. Only used inside audio_subsys_top I2S sync block.

NPU clock domain: If NPU runs at 200 MHz (separate from 100 MHz sys_clk), an async FIFO is needed at the AXI crossbar ↔ NPU DMA boundary. If this adds too much complexity for Phase 0, NPU can run at 100 MHz (same domain as everything else) with reduced throughput — still sufficient for all use cases per NPU compute analysis.

## 3.2 Reset Tree

Reset | Source | Targets
sys_rst_n | Zynq PS FCLK_RESET0_N | Input to clk_rst_mgr. Asynchronous assert, synchronous deassert.
cpu_rst_n | clk_rst_mgr output | RISC-V CPU core only. Deasserts 8 cycles after periph_rst_n.
periph_rst_n | clk_rst_mgr output | All peripherals, AXI crossbar, DDR wrapper. Deasserts first.
npu_rst_n | clk_rst_mgr output (sync to npu_clk) | NPU subsystem. Independent reset for NPU debug/recovery.

Reset sequence: sys_rst_n deasserts → clk_rst_mgr produces clean synchronized resets → periph_rst_n deasserts first (peripherals initialize) → cpu_rst_n deasserts 8 cycles later (CPU starts fetching from boot ROM) → npu_rst_n deasserts (NPU ready for commands).

# 4. soc_top.sv Port List

These are the ports of the soc_top RTL module that connect to the Vivado Block Design and to external FPGA pins.

## 4.1 Zynq PS Interface (via Block Design)

Port | Width | Dir | Description
sys_clk_i | 1 | I | 100 MHz from Zynq FCLK_CLK0
sys_rst_ni | 1 | I | Active-low reset from Zynq FCLK_RESET0_N
npu_clk_i | 1 | I | 200 MHz from Zynq FCLK_CLK1 (optional, can tie to sys_clk)
m_axi_hp0_aw* | various | O | AXI3 write address to Zynq HP0 (from DDR wrapper)
m_axi_hp0_w* | various | O | AXI3 write data to Zynq HP0 (64-bit)
m_axi_hp0_b* | various | I | AXI3 write response from Zynq HP0
m_axi_hp0_ar* | various | O | AXI3 read address to Zynq HP0
m_axi_hp0_r* | various | I | AXI3 read data from Zynq HP0 (64-bit)

## 4.2 External I/O (FPGA Pins / PMOD)

Port | Width | Dir | Description
uart_tx_o | 1 | O | UART TX → USB-UART bridge on Zybo board (debug console)
uart_rx_i | 1 | I | UART RX ← USB-UART bridge
cam_pclk_i | 1 | I | Camera pixel clock (OV7670, ~24 MHz) — PMOD connector
cam_vsync_i | 1 | I | Camera vertical sync — PMOD
cam_href_i | 1 | I | Camera horizontal reference — PMOD
cam_data_i | 8 | I | Camera 8-bit parallel data — PMOD (2 PMOD connectors for 8 pins)
i2s_sck_i | 1 | I | I2S bit clock from audio codec — PMOD
i2s_ws_i | 1 | I | I2S word select — PMOD
i2s_sd_i | 1 | I | I2S serial data input — PMOD
spi_sclk_o | 1 | O | SPI clock to ESP32-C3 — PMOD
spi_mosi_o | 1 | O | SPI MOSI to ESP32 — PMOD
spi_miso_i | 1 | I | SPI MISO from ESP32 — PMOD
spi_cs_n_o | 1 | O | SPI chip select to ESP32 — PMOD
i2c_scl_io | 1 | I/O | I2C SCL (open-drain) to IMU sensor — PMOD
i2c_sda_io | 1 | I/O | I2C SDA (open-drain) to IMU sensor — PMOD
gpio_io | 8 | I/O | GPIO pins (4 buttons + 4 LEDs on Zybo, or PMOD for ESP32 HANDSHAKE + RESET)
esp32_handshake_i | 1 | I | ESP32 HANDSHAKE pin (data ready) — connected to GPIO input, triggers IRQ
esp32_reset_n_o | 1 | O | ESP32 hardware reset — connected to GPIO output

# 5. Zynq PS Configuration (Vivado Block Design)

The Zynq PS IP block is configured via Vivado’s GUI. These settings must be applied in the Block Design before generating the bitstream.

Setting | Value
Board Preset | Apply Zybo Z7-20 board preset (auto-configures DDR3 timing, MIO pins, clock sources)
FCLK_CLK0 | 100 MHz (PL fabric clock → sys_clk for entire SoC)
FCLK_CLK1 | 200 MHz (optional NPU clock; disable if single-domain design)
S_AXI_HP0 Enable | Yes. Data width: 64-bit. Connects to ddr_wrapper AXI3 output.
S_AXI_HP0 Clock | FCLK_CLK0 (100 MHz). HP port clocked from PL side.
DDR Configuration | Auto from board preset: DDR3, 512 MB, 32-bit bus, 1066 Mbps.
MIO Configuration | Default (UART on MIO 48/49 optional for PS debug, not needed for PL UART).
Interrupt | Not used (PL IRQs handled by RISC-V IRQ controller, not Zynq GIC).
GP Port | Disabled (not needed; RISC-V CPU controls all peripherals, not Zynq ARM).

# 6. PMOD Pin Assignment (Zybo Z7-20)

The Zybo Z7-20 has 6 PMOD connectors (JA–JF), each with 8 I/O pins. External peripherals connect to PMOD pins. Zybo also has 4 buttons, 4 switches, 4 LEDs, and a USB-UART bridge connected to fixed FPGA pins.

PMOD | Pins Used | Peripheral | Signal Mapping
JA | 8 of 8 | Camera DVP (data bus) | JA[7:0] → cam_data_i[7:0]
JB | 3 of 8 | Camera DVP (control) | JB[0] → cam_pclk_i, JB[1] → cam_vsync_i, JB[2] → cam_href_i
JC | 4 of 8 | SPI (ESP32-C3) | JC[0] → spi_sclk_o, JC[1] → spi_mosi_o, JC[2] ← spi_miso_i, JC[3] → spi_cs_n_o
JC | 2 of 8 | ESP32 control | JC[4] ← esp32_handshake_i, JC[5] → esp32_reset_n_o
JD | 3 of 8 | I2S Audio | JD[0] ← i2s_sck_i, JD[1] ← i2s_ws_i, JD[2] ← i2s_sd_i
JD | 2 of 8 | I2C (IMU) | JD[3] ↔ i2c_scl_io, JD[4] ↔ i2c_sda_io
JE/JF | Available | Spare / Debug | Available for logic analyzer probes, debug signals
Built-in | 4 LEDs | Status | LED[0]: sys alive, LED[1]: Wi-Fi connected, LED[2]: wake-word detected, LED[3]: NPU busy
Built-in | 4 Buttons | Control | BTN[0]: manual reset, BTN[1]: capture trigger, BTN[2–3]: spare
Built-in | USB-UART | UART | Fixed pins → uart_tx_o / uart_rx_i (debug console at 115200 baud)

# 7. Internal Wiring Summary

This section defines how subsystems connect through the AXI crossbar and peripheral fabric. Each row is an internal wire or bus within soc_top.sv.

Connection | Bus Type | Description
Ibex iBus → Crossbar M0 | AXI4, 32-bit | CPU instruction fetch. Read-only.
Ibex dBus → Crossbar M1 | AXI4, 32-bit | CPU data load/store. Read + Write.
NPU DMA → Crossbar M2 | AXI4, 128-bit | NPU weight/activation/output transfers.
Camera DMA → Crossbar M3 | AXI4, 128-bit | Video frame write + crop read/write.
Audio DMA → Crossbar M4 | AXI4, 32-bit | MFCC tensor write + PCM ring buffer write.
Crossbar S0 → Boot ROM | AXI4, 32-bit | 4 KB read-only, initialized from hex.
Crossbar S1 → SRAM | AXI4, 32-bit | 512 KB on-chip, dual-port.
Crossbar S2 → AXI-Lite Bridge → Fabric | AXI4→AXI-Lite, 32-bit | All peripheral register access.
Crossbar S3 → DDR Wrapper → HP0 | AXI4 128-bit → AXI3 64-bit | DDR memory access via Zynq PS.
Crossbar S4 → Error Slave | AXI4, 32-bit | Unmapped address error response.
AXI-Lite P0–P7 → Peripherals | AXI4-Lite, 32-bit | UART, Timer, IRQ, GPIO, Camera, Audio, I2C, SPI registers.
AXI-Lite P8 → NPU Regfile | AXI4-Lite, 32-bit | NPU control/status registers.
Timer → Ibex irq_timer_i | 1-bit signal | Direct wire from timer_clint to Ibex.
IRQ Controller → Ibex irq_external_i | 1-bit signal | Aggregated interrupt from all sources.
NPU irq_npu_done → IRQ Controller bit 5 | 1-bit signal | NPU inference complete.
Audio irq_audio_ready → IRQ Controller bit 3 | 1-bit signal | MFCC feature frame ready.
Camera irq_camera_ready → IRQ Controller bit 2 | 1-bit signal | Frame ready or crop done.
I2C irq_i2c_done → IRQ Controller bit 7 | 1-bit signal | I2C transfer complete.
GPIO[0] (input) ← ESP32 HANDSHAKE | 1-bit signal | ESP32 has data ready. Triggers GPIO IRQ → IRQ Controller bit 6.

# 8. FPGA Resource Summary (All Subsystems Combined)

Subsystem | LUT | BRAM18 | DSP48 | Notes
RISC-V (CPU + peripherals) | 8K–12K | 56–64 | 3–4 | Includes SRAM (56 BRAM), boot ROM, UART, GPIO, timer, IRQ
NPU | 15K–22K | 36–40 | 64–80 | MAC array dominates DSP; scratchpad dominates BRAM
Audio | 3K–5K | 8–10 | 4–6 | 1024-pt FFT + MFCC pipeline
Camera | 4K–7K | 4–6 | 3–6 | ISP-lite + resize + crop + video DMA
AXI Interconnect | 9K–14K | 2–4 | 0 | 5M x 5S crossbar + AXI-Lite fabric
DDR Wrapper | 1K–2K | 0–1 | 0 | Burst splitter + width converter + QoS
SPI Master | 0.3K–0.5K | 0 | 0 | Simple shift register + FIFOs
I2C Master | 0.3K–0.5K | 0 | 0 | Simple FSM + FIFOs
Clock/Reset Manager | < 0.1K | 0 | 0 | 2-FF synchronizers, delay counter
TOTAL | ~42K–63K | ~106–125 | ~74–96
Z7-20 Available | 85K | 280 | 220
Utilization | 49–74% | 38–45% | 34–44% | Fits with headroom for debug + spare logic

# 9. Vivado Project Setup Steps

1. Create new Vivado project targeting XC7Z020-1CLG400C (Zybo Z7-20 board).
2. Add all RTL source files (~110 .sv files) organized by subsystem directory.
3. Create Block Design. Add Zynq PS IP. Apply Zybo Z7-20 board preset. Configure FCLK_CLK0=100MHz, enable HP0 at 64-bit.
4. Add soc_top.sv as an RTL module in the Block Design (Add Module → soc_top).
5. Connect soc_top clock/reset ports to Zynq FCLK_CLK0 / FCLK_RESET0_N.
6. Connect soc_top m_axi_hp0_* ports to Zynq S_AXI_HP0 interface.
7. Make external: all soc_top I/O ports (UART, camera, I2S, SPI, I2C, GPIO).
8. Create constraints file (.xdc) with PMOD pin assignments from Section 6.
9. Run synthesis, implementation, generate bitstream.
10. Program FPGA. Load firmware hex file to DDR via JTAG. Verify boot.

# 10. Integration Test Plan

Test | Description
LED Blink | Minimal test: CPU executes from boot ROM, toggles GPIO LED. Proves: clock, reset, CPU, boot ROM, SRAM, GPIO all work.
UART Hello World | CPU writes string to UART. Terminal shows output. Proves: AXI-Lite fabric, UART peripheral, CPU dBus path.
DDR Read/Write | CPU writes pattern to DDR via crossbar → DDR wrapper → HP0. Reads back. Verifies: AXI crossbar, DDR wrapper, Zynq HP0 integration.
NPU Single Layer | CPU programs NPU registers. NPU DMA reads test tensor from DDR. MAC array runs. Output matches golden. Proves: NPU + DMA + DDR end-to-end.
Audio Capture | Connect I2S audio source. Verify PCM samples appear in DDR ring buffer. Proves: I2S → audio FIFO → DMA → DDR.
Camera Capture | Connect OV7670. Verify RGB frame appears in DDR frame buffer. Proves: DVP → ISP → video DMA → DDR.
SPI ESP32 | Connect ESP32-DevKitC. Send Wi-Fi connect command. Verify ESP32 connects to AP. Proves: SPI master + ESP32 integration.
Wake-Word Demo | Full pipeline: mic → I2S → MFCC → DDR → NPU (DS-CNN-S) → "Marvin" detected → LED lights up.
Face Recognition Demo | Camera capture → BlazeFace → crop → MobileFaceNet → identity output on UART.
VPS Streaming Demo | Say "Marvin" → audio streams to VPS via ESP32 Wi-Fi → VPS returns TTS → plays on speaker. Full end-to-end.

— End of SoC Top-Level Integration RTL Implementation Document —

Confidential — Page

SoC Top-Level Integration RTL Implementation AI Glasses SoC — Phase 0
