anirudhr-adtech/AI_GLASSES/AI_Smart_Glasses_docs/Specs and Sub system implementation document/SPI_Master_RTL_Implementation.docx

SPI MASTER PERIPHERAL

RTL IMPLEMENTATION DOCUMENT

AI Glasses SoC — Phase 0 FPGA Prototype

ESP32-C3 Communication Interface | SPI Mode 0/3 | TX/RX FIFOs | AXI4-Lite Slave

Field | Value
Document Version | 1.0
Status | DRAFT — Architecture Lock
Phase | Phase 0 — FPGA Prototype
Author | Anirudh (Sole Architect)
Date | March 2026
Primary Use | ESP32-C3 Wi-Fi companion chip communication for VPS audio streaming
AXI-Lite Base Address | 0x2000_0700 (Peripheral slot P7)
Companion Docs | AXI Interconnect v2, DDR Subsystem, RISC-V Subsystem v2

# 1. Overview

The SPI Master peripheral provides the primary communication link between the RISC-V CPU and the ESP32-C3 Wi-Fi companion chip. All data exchanged with the VPS (audio streaming, TTS response audio, face embedding offload) passes through this SPI interface. The CPU reads audio data from DDR, writes it to the SPI TX FIFO, and the SPI master shifts it out to the ESP32 at up to 20 MHz SPI clock.

## 1.1 Role in the System

- Transmits audio PCM data to ESP32 for Wi-Fi streaming to VPS (~32 KB/s sustained, burst 1 KB every ~31 ms)
- Receives TTS response audio from ESP32 (VPS-generated speech, variable rate)
- Sends ESP32 AT/control commands (Wi-Fi connect, TCP open/close, status query)
- Optionally sends face embedding vectors (128 bytes) to VPS for cloud-side identity lookup
- Triggers GPIO interrupt (HANDSHAKE pin from ESP32) when ESP32 has incoming data ready

## 1.2 Locked Parameters

Parameter | Decision | Rationale
SPI Mode | Mode 0 (CPOL=0, CPHA=0) default; Mode 3 configurable | ESP32 SPI slave supports Mode 0 and Mode 3
SPI Clock | Up to 20 MHz (sys_clk / (2*(div+1))) | ESP32 SPI slave max is 40 MHz; 20 MHz gives margin
Data Width | 8-bit (byte-oriented) | ESP32 SPI slave protocol is byte-based
TX FIFO Depth | 16 bytes | Sufficient for command packets; audio is multi-transaction
RX FIFO Depth | 16 bytes | ESP32 response packets are small; CPU drains quickly
Chip Select | 1 CS line (auto or manual) | Single ESP32 device on SPI bus
Control Interface | AXI4-Lite at 0x2000_0700 | Consistent with peripheral fabric

# 2. Register Map

Base address: 0x2000_0700. 256-byte allocation (8 registers used).

Offset | Register | R/W | Reset | Description
0x00 | SPI_TXDATA | WO | — | Write single byte to TX shift register. Transmission starts immediately if idle. Ignored if TX FIFO full.
0x04 | SPI_RXDATA | RO | 0x0 | Read single byte from RX shift register. Bit[31] = 1 if RX FIFO empty (no valid data). Bits[7:0] = received byte.
0x08 | SPI_STATUS | RO | 0x02 | Bit[0]: TX busy (shift in progress). Bit[1]: TX FIFO empty. Bit[2]: TX FIFO full. Bit[3]: RX data ready (FIFO non-empty). Bit[4]: RX FIFO full. Bit[5]: RX overrun (sticky, cleared by soft reset).
0x0C | SPI_CONFIG | R/W | 0x04 | Bits[7:0]: Clock divider (SPI_CLK = sys_clk / (2*(div+1))). Default div=4 → 10 MHz at 100 MHz sys_clk. Bit[8]: CPOL. Bit[9]: CPHA. Bit[10]: CS auto-management (1=auto assert/deassert per byte, 0=manual). Bit[11]: Soft reset (self-clearing).
0x10 | SPI_CS | R/W | 0x01 | Bit[0]: Chip select output (active-low). 1=CS deasserted (idle), 0=CS asserted (select ESP32). Manual control when auto-CS disabled.
0x14 | SPI_IRQ_EN | R/W | 0x0 | Bit[0]: TX FIFO empty IRQ enable. Bit[1]: RX data ready IRQ enable. IRQ output ORed and connected to IRQ controller (if assigned, else GPIO polling).
0x18 | SPI_TX_FIFO | WO | — | Write byte to TX FIFO (16-deep). Same as TXDATA but writes to FIFO tail. For burst transfers: CPU writes 16 bytes in tight loop, then waits for TX empty.
0x1C | SPI_RX_FIFO | RO | 0x0 | Read byte from RX FIFO head. Bit[31] = FIFO empty flag. Auto-advances FIFO pointer on read.

# 3. SPI Protocol Timing

## 3.1 Signal Definitions

Signal | Width | Direction | Description
spi_sclk_o | 1 | Output | SPI clock output. Frequency = sys_clk / (2*(SPI_CONFIG.div + 1)). Idle state determined by CPOL.
spi_mosi_o | 1 | Output | Master Out Slave In. Data driven on SCLK edge determined by CPOL/CPHA. MSB first.
spi_miso_i | 1 | Input | Master In Slave Out. Data sampled on opposite SCLK edge. MSB first.
spi_cs_n_o | 1 | Output | Chip select (active-low). Directly driven by SPI_CS register (manual) or auto-managed.

## 3.2 Transmit/Receive FSM (spi_master_fsm.sv)

State | Behavior
IDLE | SCLK at idle level (CPOL). CS deasserted (if auto-CS). Waits for TX FIFO non-empty or TXDATA write. On data available: assert CS (if auto), load shift register, transition to SHIFT.
SHIFT | Shift out 8 bits MSB-first on MOSI. Simultaneously shift in 8 bits from MISO. One bit per SCLK cycle (2 sys_clk cycles per SCLK cycle at the configured divider). After 8 bits: push received byte to RX FIFO.
BYTE_DONE | One SCLK cycle gap between bytes. Check TX FIFO: if non-empty, load next byte and return to SHIFT. If empty and auto-CS: deassert CS, transition to IDLE. If empty and manual-CS: transition to IDLE (CS stays asserted).

## 3.3 Clock Divider Logic

// SPI clock generation

// sys_clk = 100 MHz, div = SPI_CONFIG[7:0]

// spi_clk_freq = sys_clk / (2 * (div + 1))

// div=0 -> 50 MHz (too fast for most slaves)

// div=4 -> 10 MHz (default, safe for ESP32)

// div=9 -> 5 MHz (conservative)

// div=49 -> 1 MHz (debug / slow devices)

logic [7:0] clk_counter;

always_ff @(posedge clk_i or negedge rst_ni) begin

if (!rst_ni) clk_counter <= '0;

else if (clk_counter == spi_config_div)

clk_counter <= '0;

else

clk_counter <= clk_counter + 1;

end

assign sclk_toggle = (clk_counter == spi_config_div);

# 4. TX/RX FIFO Specification

Parameter | TX FIFO | RX FIFO
Depth | 16 bytes | 16 bytes
Width | 8 bits | 8 bits
Implementation | Synchronous FIFO (shift register or pointer-based) | Synchronous FIFO
Write port | CPU writes via SPI_TXDATA or SPI_TX_FIFO | SPI FSM writes received bytes
Read port | SPI FSM reads for transmission | CPU reads via SPI_RXDATA or SPI_RX_FIFO
Overflow | Write ignored when full (SPI_STATUS.tx_full = 1) | RX overrun flag set (sticky); oldest data preserved
Status flags | empty, full (in SPI_STATUS) | ready (non-empty), full, overrun (in SPI_STATUS)

# 5. ESP32 Communication Protocol

The ESP32-C3 runs SPI slave firmware. Communication uses a simple binary packet protocol over SPI.

## 5.1 Packet Format

Byte 0 | Byte 1–2 | Byte 3…N | Description
CMD_TYPE | PAYLOAD_LEN | PAYLOAD | CMD_TYPE: 1 byte command ID. PAYLOAD_LEN: 2 bytes (big-endian, max 4096). PAYLOAD: variable.

## 5.2 Command Types

CMD_TYPE | Name | Direction | Description
0x01 | WIFI_CONNECT | SoC → ESP32 | Payload: SSID (32B) + password (32B). ESP32 connects to Wi-Fi AP.
0x02 | WIFI_STATUS | SoC → ESP32 | No payload. ESP32 responds with connection status byte.
0x03 | TCP_CONNECT | SoC → ESP32 | Payload: IP (4B) + port (2B). ESP32 opens TCP/WebSocket to VPS.
0x04 | TCP_SEND | SoC → ESP32 | Payload: audio data (up to 1024B). ESP32 forwards to VPS via WebSocket.
0x05 | TCP_CLOSE | SoC → ESP32 | No payload. ESP32 closes TCP connection.
0x81 | TCP_DATA | ESP32 → SoC | Payload: received data from VPS (TTS audio). ESP32 asserts HANDSHAKE first.
0x82 | STATUS_RESP | ESP32 → SoC | Payload: status byte (0=disconnected, 1=Wi-Fi connected, 2=TCP connected).

HANDSHAKE flow: ESP32 asserts HANDSHAKE GPIO pin (active-high) when it has data ready. SoC GPIO IRQ fires. CPU asserts CS, sends dummy 0x00 byte to read CMD_TYPE, reads PAYLOAD_LEN, then reads PAYLOAD bytes. CPU deasserts CS. ESP32 deasserts HANDSHAKE.

# 6. RTL Module Hierarchy

spi_master.sv // Top-level SPI master peripheral

├── spi_regfile.sv // AXI4-Lite slave + register file

├── spi_master_fsm.sv // SPI protocol FSM (IDLE/SHIFT/BYTE_DONE)

├── spi_clk_gen.sv // Clock divider + SCLK generation

├── spi_shift_reg.sv // 8-bit bidirectional shift register

├── spi_tx_fifo.sv // 16-byte TX FIFO

└── spi_rx_fifo.sv // 16-byte RX FIFO

## 6.1 RTL Generation Sequence

# | Module | Dependencies | Unit Test Focus

1 | spi_tx_fifo.sv | None | Full/empty flags, overflow behavior, 16-byte depth
2 | spi_rx_fifo.sv | None | Full/empty/overrun flags, read auto-advance
3 | spi_clk_gen.sv | None | Divider accuracy at div=0,4,9,49. CPOL idle level.
4 | spi_shift_reg.sv | None | MSB-first shift out, simultaneous shift in, 8-bit count
5 | spi_master_fsm.sv | clk_gen, shift_reg | Full SPI transaction, auto-CS, back-to-back bytes
6 | spi_regfile.sv | None | AXI-Lite R/W, reset values, status flags
7 | spi_master.sv | All above | Full integration: CPU writes FIFO, data appears on MOSI, MISO captured in RX FIFO

# 7. Verification Plan

Test | Description
Single byte TX/RX | Write 0xA5 to TXDATA. Verify SCLK toggles 8 times, MOSI shifts out 0xA5 MSB-first. Feed 0x5A on MISO, verify RXDATA = 0x5A.
FIFO burst (16 bytes) | Write 16 bytes to TX_FIFO. Verify all 16 transmitted in sequence without gaps. Verify TX empty IRQ after last byte.
Clock divider sweep | Configure div=0,1,4,9,49. Measure SCLK frequency. Verify matches sys_clk/(2*(div+1)).
Auto-CS behavior | Enable auto-CS. Send 3 bytes. Verify CS asserts before first byte, stays asserted between bytes, deasserts after last.
Manual-CS behavior | Disable auto-CS. Manually assert CS. Send bytes. Verify CS stays asserted until CPU explicitly deasserts.
ESP32 loopback | Connect MOSI to MISO externally. Transmit known pattern. Verify received data matches transmitted.
RX overrun | Send data while CPU doesn’t read RX FIFO. Verify overrun flag sets after 16 bytes. Verify no data corruption.
ESP32 packet protocol | Simulate ESP32 BFM: send WIFI_CONNECT command, verify SPI waveform. Receive TCP_DATA response, verify RXDATA contents.

# 8. Top-Level Port List (spi_master.sv)

Port | Width | Dir | Description
clk_i | 1 | I | System clock (100 MHz)
rst_ni | 1 | I | Active-low reset
s_axi_lite_* | various | I/O | AXI4-Lite slave interface (from peripheral fabric P7)
spi_sclk_o | 1 | O | SPI clock output (to ESP32)
spi_mosi_o | 1 | O | Master Out Slave In (to ESP32)
spi_miso_i | 1 | I | Master In Slave Out (from ESP32)
spi_cs_n_o | 1 | O | Chip select active-low (to ESP32)
irq_spi_o | 1 | O | SPI interrupt (TX empty or RX ready, based on IRQ_EN)

— End of SPI Master Peripheral RTL Implementation Document —

Confidential — Page

SPI Master Peripheral RTL Implementation AI Glasses SoC — Phase 0
