anirudhr-adtech/AI_GLASSES/AI_Smart_Glasses_docs/Specs and Sub system implementation document/AXI_Interconnect_RTL_Implementation_v2.docx

AXI INTERCONNECT

RTL IMPLEMENTATION DOCUMENT

AI Glasses SoC — Phase 0 FPGA Prototype

AXI4 Crossbar (5M x 5S) | AXI4-Lite Peripheral Fabric (1M x 11S) | Width Conversion | Error Handling

Field | Value
Document Version | 2.0 (Standalone — separated from DDR; updated for ESP32/Marvin/VPS)
Status | DRAFT — Architecture Lock
Phase | Phase 0 — FPGA Prototype
Author | Anirudh (Sole Architect)
Date | March 2026
Wake-Word | DS-CNN-S "Marvin" via NPU (audio MFCC → DDR → NPU via this interconnect)
Connectivity | ESP32-C3 via SPI Master peripheral P7 on AXI-Lite fabric
AI Backend | VPS with Cloud AI APIs; audio/image data flows through this interconnect to DDR before ESP32 offload
Companion Docs | RISC-V Subsystem v2, NPU Subsystem v2, Audio Subsystem v2, Camera/Vision Subsystem, DDR Subsystem (separate document)

# 1. AXI Interconnect Overview

The AXI interconnect is the central communication fabric of the AI Glasses SoC. Every data transaction in the system — CPU instructions, NPU weight loads, camera frames, audio MFCC tensors, ESP32 register commands — passes through this fabric. It comprises two sub-fabrics: the AXI4 high-bandwidth crossbar for DDR/SRAM data transfers, and the AXI4-Lite peripheral fabric for register access to all peripherals including the SPI master that drives the ESP32 Wi-Fi module.

## 1.1 Design Philosophy

- Shared-bus crossbar topology (not full NxM) to minimize FPGA resources. Only one master can access a given slave at any time, but different masters can access different slaves concurrently.
- Per-slave arbitration: each slave port has its own arbiter, enabling parallel transactions to different slaves.
- AXI ID-based transaction tracking: each master has a unique 3-bit ID prefix, enabling out-of-order responses on shared slaves (DDR).
- AXI4-Lite fabric is behind a protocol bridge, isolating low-bandwidth peripheral and ESP32 register access from the high-bandwidth data path.
- Fully parameterizable: number of masters, slaves, address map, and arbitration policy are compile-time parameters.

## 1.2 Interconnect Role in System Data Flows

Understanding what data traverses the interconnect for each use case:

Use Case | Interconnect Traffic
Wake-word "Marvin" | Audio DMA (M4) writes MFCC tensor to DDR (S3): 980 bytes. NPU DMA (M2) reads DS-CNN weights from DDR (S3): ~50 KB. NPU DMA reads MFCC from DDR: 490 bytes. NPU DMA writes classification scores to DDR: 48 bytes. CPU (M1) reads scores from DDR. All via crossbar to S3.
Conversation streaming | Audio DMA (M4) writes PCM to DDR ring buffer (S3): 32 KB/s continuous. CPU (M1) reads ring buffer chunks from DDR (S3). CPU (M1) writes SPI TX register via AXI-Lite fabric (S2 → P7) to send data to ESP32. Low bandwidth, continuous.
Face recognition | Camera DMA (M3) writes frame to DDR (S3): ~64 KB + 1.2 MB raw. NPU DMA (M2) reads BlazeFace weights + frame: ~1.1 MB. Crop DMA (M3) reads/writes ROI: ~200 KB. NPU DMA reads MobileFaceNet weights + crop: ~2 MB. CPU reads embedding from DDR. Optional: CPU writes embedding to ESP32 SPI (S2 → P7) for VPS offload.
Boot sequence | CPU iBus (M0) fetches from Boot ROM (S0). CPU dBus (M1) copies firmware from DDR (S3) to SRAM (S1). CPU programs peripherals via AXI-Lite fabric (S2).

# 2. Master and Slave Port Mapping

## 2.1 Master Ports

ID | Master | AXI Width | ID Prefix | Traffic Pattern
M0 | CPU Instruction (iBus adapter) | 32-bit | 3'b000 | Read-only, single-beat, sequential. ~4 MB/s at 100 MHz.
M1 | CPU Data (dBus adapter) | 32-bit | 3'b001 | Read + Write, single-beat, random. ~4 MB/s peak. Also used for ESP32 SPI register access and DDR ring buffer reads.
M2 | NPU DMA Engine | 128-bit | 3'b010 | Read + Write, burst-256. ~1.6 GB/s at 100 MHz. Highest bandwidth consumer. DS-CNN, BlazeFace, MobileFaceNet weight and tensor transfers.
M3 | Camera Video DMA + Crop Engine | 128-bit | 3'b011 | Write-mostly (ISP frame write) + Read (crop ROI from DDR). Burst-256. ~50 MB/s peak.
M4 | Audio DMA | 32-bit | 3'b100 | Write-only: MFCC tensors to DDR (~1 KB/sec) or PCM stream to DDR ring buffer (32 KB/s). Burst-64. Lowest bandwidth.

## 2.2 Slave Ports

ID | Slave | Address Range | AXI Width | Notes
S0 | Boot ROM | 0x0000_0000 – 0x0000_0FFF | 32-bit | 4 KB, read-only
S1 | On-Chip SRAM | 0x1000_0000 – 0x1007_FFFF | 32-bit | 512 KB, R/W, dual-port
S2 | Peripheral Bridge (AXI4 → AXI4-Lite) | 0x2000_0000 – 0x4FFF_FFFF | 32-bit | All peripherals, NPU regs, DMA regs
S3 | DDR Controller | 0x8000_0000 – 0xFFFF_FFFF | 128-bit | 2 GB addressable. See DDR Subsystem doc.
S4 | Error Slave (Default) | Unmapped ranges | 32-bit | Returns DECERR on any access

Width mismatch handling: When a 128-bit master (M2, M3) accesses a 32-bit slave (S0, S1, S2), a width downsizer converts the transaction. When a 32-bit master (M0, M1, M4) accesses the 128-bit DDR slave (S3), a width upsizer packs narrow writes with byte strobes. Handled by axi_width_converter.sv.

# 3. Address Decoder (axi_addr_decoder.sv)

Purely combinational block that maps AXI address to a one-hot slave_sel vector.

// AXI Address Decoder — Combinational

parameter int NUM_SLAVES = 5;

always_comb begin

slave_sel = {NUM_SLAVES{1'b0}};

casez (axi_addr[31:28])

4'b0000: slave_sel[0] = 1'b1; // S0: Boot ROM (0x0000_xxxx)

4'b0001: slave_sel[1] = 1'b1; // S1: SRAM (0x1xxx_xxxx)

4'b001?: slave_sel[2] = 1'b1; // S2: Periph (0x2000–0x3FFF)

4'b0100: slave_sel[2] = 1'b1; // S2: Periph cont (0x4000_xxxx)

4'b1???: slave_sel[3] = 1'b1; // S3: DDR (0x8000–0xFFFF)

default: slave_sel[4] = 1'b1; // S4: Error slave

endcase

end

## 3.1 Fine-Grained Boundary Checking

Secondary address range check catches accesses beyond the actual size of Boot ROM and SRAM:

// Fine-grained boundary enforcement

always_comb begin

addr_error = 1'b0;

if (slave_sel[0] && axi_addr[31:12] != 20'h00000)

addr_error = 1'b1; // Boot ROM: only 4 KB at 0x0000_0000–0x0000_0FFF

if (slave_sel[1] && axi_addr[31:19] != 13'h0800)

addr_error = 1'b1; // SRAM: only 512 KB at 0x1000_0000–0x1007_FFFF

if (addr_error) begin

slave_sel = {NUM_SLAVES{1'b0}};

slave_sel[4] = 1'b1; // Redirect to error slave

end

end

## 3.2 Port List (axi_addr_decoder.sv)

Port | Width | Dir | Description
axi_addr_i | 32 | I | AXI transaction address (from AW or AR channel)
slave_sel_o | 5 | O | One-hot slave select: [0]=Boot ROM, [1]=SRAM, [2]=Periph, [3]=DDR, [4]=Error
addr_error_o | 1 | O | Boundary overflow detected (for debug visibility)

# 4. AXI Arbiter (axi_arbiter.sv)

Each slave port has a dedicated arbiter instance. The arbiter selects which master gains access when multiple masters target the same slave simultaneously.

## 4.1 Three-Tier Priority Scheme

Tier | Masters | Priority | Rationale
0 (Highest) | M2 (NPU DMA) | Always wins vs. lower tiers | NPU inference is latency-critical. DMA stalls cause MAC idle cycles, wasting compute.
1 | M3 (Camera DMA) | Wins vs. Tier 2 | Camera frame capture has VSYNC timing deadline. Cannot pause mid-frame without corruption.
2 (Lowest) | M0 (CPU iBus), M1 (CPU dBus), M4 (Audio DMA) | Round-robin within tier | CPU pipelines stall gracefully. Audio DMA has huge timing margin (20ms frame budget).

## 4.2 Arbitration Algorithm

1. Tier selection: if any Tier 0 master has a pending request, grant Tier 0. Else Tier 1. Else Tier 2.
2. Intra-tier selection: within the selected tier, apply round-robin (rotating priority register).
3. Starvation prevention: if any master is blocked for more than STALL_LIMIT cycles (default: 32), it is temporarily promoted to Tier 0 for one arbitration round.

## 4.3 Arbitration Granularity

- Burst-level: once granted, a master retains the slave until entire burst completes (RLAST for reads, WLAST + BVALID for writes). No mid-burst preemption.
- Single-beat (CPU M0/M1): occupies slave for 1–3 cycles. Very low blocking impact.
- Burst-256 (NPU M2): can block slave for up to 256 cycles. Starvation counter prevents CPU lockout.

## 4.4 Arbiter FSM

State | Behavior
IDLE | No active grant. Evaluate all req_i bits. Apply tier selection + round-robin. Issue grant_o. Transition to GRANTED.
GRANTED | A master holds the slave. lock_i asserted by slave port (burst in progress). Wait for lock_i deassert (burst complete). Transition to IDLE.
STARVATION_OVERRIDE | Blocked master exceeded STALL_LIMIT. Next IDLE cycle, temporarily promote to Tier 0. After one grant, demote back. Transition to GRANTED.

## 4.5 Arbiter Port List

Port | Width | Dir | Description
clk_i / rst_ni | 1 each | I | System clock and active-low reset
req_i[N-1:0] | N | I | Per-master request signals
tier_i[N-1:0] | 2*N | I | Per-master tier assignment (2-bit each, compile-time)
grant_o[N-1:0] | N | O | One-hot grant output
lock_i | 1 | I | Lock signal from slave (active burst prevents re-arbitration)
stall_count_o[N-1:0] | 16*N | O | Per-master stall cycle counter (debug)

# 5. Data Width Converter (axi_width_converter.sv)

Handles upsizing (32-bit master → 128-bit slave) and downsizing (128-bit master → 32-bit slave) transparently.

## 5.1 Width Combinations in the SoC

Master | Slave | Conversion | Notes
M0/M1 (32-bit CPU) | S3 (128-bit DDR) | Upsizer: 32 → 128 | CPU writes packed into 128-bit word with wstrb selecting active 4 bytes. CPU reads: extract 32-bit slice based on addr[3:2].
M2/M3 (128-bit DMA) | S0/S1/S2 (32-bit) | Downsizer: 128 → 32 | Rare path (DMA normally targets DDR). Used if DMA reads from SRAM.
M4 (32-bit Audio) | S3 (128-bit DDR) | Upsizer: 32 → 128 | Audio DMA writes packed into 128-bit. PCM ring buffer writes.
M2/M3 (128-bit) | S3 (128-bit DDR) | None (native) | Optimal path. No conversion overhead. NPU and Camera DMA.

## 5.2 Upsizer Logic (32 → 128 bit)

- Write: 32-bit data positioned in correct lane of 128-bit word based on addr[3:2]. 16-bit wstrb with only 4 bits active.
- Read: 128-bit word read from slave, 32-bit slice extracted based on addr[3:2], returned to narrow master.

## 5.3 Downsizer Logic (128 → 32 bit)

- Write: single 128-bit beat split into 4 sequential 32-bit writes. wstrb groups of 4 bits each. Zero-strobe beats skipped.
- Read: 4 sequential 32-bit reads assembled into one 128-bit response. RLAST suppressed until final sub-beat.

## 5.4 Port List (axi_width_converter.sv)

Port | Width | Dir | Description
clk_i / rst_ni | 1 each | I | System clock and active-low reset
s_axi_* | various | I/O | Slave-side AXI interface (connects to master, narrower or wider)
m_axi_* | various | I/O | Master-side AXI interface (connects to slave, target width)
src_width_i | 2 | I | Source data width: 00=32-bit, 01=64-bit, 10=128-bit
dst_width_i | 2 | I | Destination data width: 00=32-bit, 01=64-bit, 10=128-bit

# 6. AXI4-Lite Peripheral Fabric

## 6.1 AXI-to-AXI-Lite Bridge (axi_to_axilite_bridge.sv)

Converts AXI4 transactions from crossbar S2 slave port to AXI4-Lite for peripheral register access.

- Strips burst capability: only single-beat (AWLEN=0 / ARLEN=0) passes. Burst transactions return SLVERR.
- Strips AXI ID: buffers request ID and re-attaches to response.
- Data width: pass-through 32-bit. 128-bit masters go through downsizer before reaching bridge.
- Latency: 1 cycle added (registered input for timing closure).

## 6.2 Peripheral Address Map

The AXI-Lite decoder routes transactions to the correct peripheral. 256 bytes per peripheral. Bits [7:0] are the register offset within each peripheral.

Slot | Base Address | End Address | Size | Peripheral
P0 | 0x2000_0000 | 0x2000_00FF | 256 B | UART (debug console)
P1 | 0x2000_0100 | 0x2000_01FF | 256 B | Timer (CLINT-Lite, mtime/mtimecmp)
P2 | 0x2000_0200 | 0x2000_02FF | 256 B | Interrupt Controller (8-source priority encoder)
P3 | 0x2000_0300 | 0x2000_03FF | 256 B | GPIO (8-pin bidirectional)
P4 | 0x2000_0400 | 0x2000_04FF | 256 B | Camera Control Interface (ISP config, crop control, frame buffer management)
P5 | 0x2000_0500 | 0x2000_05FF | 256 B | Audio Control Interface (MFCC config, mode control, DMA base addresses)
P6 | 0x2000_0600 | 0x2000_06FF | 256 B | I2C Master (IMU sensor communication)
P7 | 0x2000_0700 | 0x2000_07FF | 256 B | SPI Master (ESP32-C3 Wi-Fi/BLE communication — primary connectivity interface to VPS)
P8 | 0x3000_0000 | 0x3000_00FF | 256 B | NPU Registers (layer config, DMA addresses, START, STATUS, PERF_CYCLES)
P9 | 0x4000_0000 | 0x4000_00FF | 256 B | DMA Registers (system DMA if separate from NPU DMA)
Perr | Unmapped | — | — | Returns SLVERR for any access to undefined peripheral addresses

## 6.3 AXI-Lite Decoder Logic (axilite_addr_decoder.sv)

// AXI-Lite peripheral decoder

// Input: axilite_addr[31:0] (already offset from AXI4 bridge)

// Output: periph_sel (one-hot, 11 slots including error)

always_comb begin

periph_sel = PERIPH_ERROR;

case (axilite_addr[27:24])

4'h0: begin // 0x2000_0xxx region

case (axilite_addr[11:8])

4'h0: periph_sel = P_UART; // 0x2000_0000

4'h1: periph_sel = P_TIMER; // 0x2000_0100

4'h2: periph_sel = P_IRQ; // 0x2000_0200

4'h3: periph_sel = P_GPIO; // 0x2000_0300

4'h4: periph_sel = P_CAMERA; // 0x2000_0400

4'h5: periph_sel = P_AUDIO; // 0x2000_0500

4'h6: periph_sel = P_I2C; // 0x2000_0600

4'h7: periph_sel = P_SPI_ESP32; // 0x2000_0700 (ESP32 comm)

default: periph_sel = PERIPH_ERROR;

endcase

end

4'h8: periph_sel = P_NPU; // 0x3000_0000

// Note: 0x3000_0000 - 0x2000_0000 = 0x1000_0000, addr[27:24]=0x1

// Actual decode depends on address bias implementation

default: periph_sel = PERIPH_ERROR;

endcase

end

## 6.4 SPI Master Peripheral — ESP32 Interface (P7)

The SPI master at P7 (0x2000_0700) is the primary communication interface between the RISC-V CPU and the ESP32-C3 Wi-Fi companion chip. All VPS audio streaming and response reception passes through this peripheral.

Offset | Register | R/W | Reset | Description
0x00 | SPI_TXDATA | WO | — | Write byte to SPI TX shift register. Transmission starts immediately if SPI is idle.
0x04 | SPI_RXDATA | RO | 0x0 | Read received byte from SPI RX shift register. Valid after SPI_STATUS.rx_ready = 1.
0x08 | SPI_STATUS | RO | 0x02 | Bit[0]: TX busy. Bit[1]: TX empty (ready for next byte). Bit[2]: RX data ready. Bit[3]: RX overrun.
0x0C | SPI_CONFIG | R/W | 0x0 | Bits[7:0]: Clock divider (SPI_CLK = sys_clk / (2*(div+1))). Bit[8]: CPOL. Bit[9]: CPHA. Bit[10]: CS auto-management enable.
0x10 | SPI_CS | R/W | 0x1 | Bit[0]: Chip select output (active-low). Manual control when auto-CS disabled.
0x14 | SPI_IRQ_EN | R/W | 0x0 | Bit[0]: TX empty IRQ enable. Bit[1]: RX ready IRQ enable.
0x18 | SPI_TX_FIFO | WO | — | Write multiple bytes to TX FIFO (16-deep). For burst transfers to ESP32.
0x1C | SPI_RX_FIFO | RO | 0x0 | Read from RX FIFO (16-deep). Bit[31]: FIFO empty flag.

ESP32 communication: The CPU writes audio data chunks (1 KB at a time) to SPI_TX_FIFO in a tight loop. At 10 MHz SPI clock, 1 KB transfers in ~0.8 ms. The ESP32 asserts a HANDSHAKE GPIO pin (connected to GPIO peripheral, triggers IRQ) when it has response data ready. CPU then reads from SPI_RX_FIFO.

# 7. AXI4 Crossbar Microarchitecture (axi_crossbar.sv)

## 7.1 Block Diagram

AXI4 CROSSBAR (5 Masters x 5 Slaves)

M0(32b) M1(32b) M2(128b) M3(128b) M4(32b)

CPU-I CPU-D NPU-DMA CAM-DMA AUD-DMA

| ┌─────┴─────┴──────┴───────┴─────┐

| │ Master Interface Layer │

| │ (ID prefix, addr decode) │

| └─────┬─────┬──────┬───────┬─────┘

┌─────┴─────┴──────┴───────┴──────┐

│ Width Conversion Layer │

│ (32↔128 upsizer/downsizer) │

└─────┬───────┬───────┬───────┬────┐

S0 S1 S2 S3 S4

(Boot) (SRAM) (Periph) (DDR) (Error)

32b 32b 32b 128b 32b

## 7.2 Transaction Routing Sequence

4. Master issues AW/AR request with address.
5. Crossbar master interface runs address through axi_addr_decoder.
6. Decoded slave_sel routes request to appropriate slave port arbiter.
7. Arbiter grants the master (if slave is free or master wins arbitration).
8. Width converter adapts data width if master/slave widths differ.
9. Write: AW → arbiter → slave. W data follows (locked to same master until WLAST). B response routed back via ID.
10. Read: AR → arbiter → slave. R data returns. Routed back to requesting master via ID.
11. After RLAST (read) or BVALID (write), arbiter releases slave lock.

## 7.3 Outstanding Transaction Support

Master | Outstanding Limit | Notes
M0 (CPU iBus) | 2 | Ibex instruction prefetch pipeline depth
M1 (CPU dBus) | 1 | Ibex does not pipeline data requests
M2 (NPU DMA) | 4 | Weight, activation, and output DMA channels can overlap
M3 (Camera DMA) | 2 | Video DMA write + crop engine read can overlap
M4 (Audio DMA) | 1 | Single-channel DMA, low bandwidth

Per-master transaction ID FIFOs track outstanding requests. FIFO depth matches the master’s outstanding limit. Ordering maintained per-ID per-master.

# 8. Error Handling

## 8.1 Error Slave (axi_error_slave.sv)

- Write: accepts AW, consumes all W beats, returns BRESP = DECERR.
- Read: accepts AR, returns RRESP = DECERR with RLAST on all beats.
- Latency: 1 cycle. No data storage.

## 8.2 Timeout Detection (axi_timeout.sv)

- Wraps each slave port. If no response within TIMEOUT_CYCLES (default: 4096), forces SLVERR and releases bus.
- Prevents system deadlock if a slave hangs (e.g., DDR controller stall).
- Timeout counter resets on any AXI handshake (xVALID && xREADY).
- Timeout event sets sticky bit in debug register (CPU-readable via AXI-Lite).

## 8.3 Error Slave Port List

Port | Width | Dir | Description
clk_i / rst_ni | 1 each | I | System clock and reset
s_axi_aw* | various | I | AXI write address channel (accepts all transactions)
s_axi_w* | various | I | AXI write data channel (consumes all beats)
s_axi_b* | various | O | AXI write response (always DECERR)
s_axi_ar* | various | I | AXI read address channel (accepts all transactions)
s_axi_r* | various | O | AXI read data channel (returns 0x0 with DECERR, correct RLAST)

# 9. RTL Module Hierarchy

## 9.1 AXI4 Crossbar

axi_crossbar.sv // Top-level 5M x 5S crossbar

├── axi_master_if.sv [x5] // Per-master interface (ID prefix, addr decode)

├── axi_slave_port.sv [x5] // Per-slave port (arbiter + mux + demux)

│ ├── axi_arbiter.sv // 3-tier priority arbiter

│ ├── axi_wr_mux.sv // Write channel multiplexer (AW + W)

│ ├── axi_rd_mux.sv // Read address multiplexer (AR)

│ └── axi_resp_demux.sv // Response demux (B + R, routed by ID)

├── axi_addr_decoder.sv // Combinational address → slave_sel

├── axi_width_converter.sv // 32 ↔ 128 bit data width conversion

│ ├── axi_upsizer.sv // 32 → 128 (narrow master → wide slave)

│ └── axi_downsizer.sv // 128 → 32 (wide master → narrow slave)

├── axi_error_slave.sv // DECERR responder for unmapped addresses

└── axi_timeout.sv [x5] // Per-slave timeout monitor

## 9.2 AXI4-Lite Peripheral Fabric

axilite_fabric.sv // Top-level 1M x 11S AXI-Lite fabric

├── axi_to_axilite_bridge.sv // AXI4 → AXI4-Lite protocol conversion

├── axilite_addr_decoder.sv // Peripheral address decode (11 slots)

└── axilite_mux.sv // Response multiplexer

## 9.3 Recommended RTL Generation Sequence

# | Module | Dependencies | Unit Test Focus

1 | axi_addr_decoder.sv | None | All 5 slave ranges, boundary cases, overflow → error
2 | axi_error_slave.sv | None | DECERR on read/write, burst completion, ID passthrough
3 | axi_arbiter.sv | None | 3-tier priority, round-robin within tier, starvation counter
4 | axi_wr_mux.sv | None | Write channel muxing, WLAST tracking, AW/W pairing
5 | axi_rd_mux.sv | None | Read address muxing, AR grant tracking
6 | axi_resp_demux.sv | None | B/R response routing by AXI ID, multi-master concurrent
7 | axi_slave_port.sv | arbiter, wr_mux, rd_mux, resp_demux | Full slave port: multi-master arbitration, burst lock/release
8 | axi_upsizer.sv | None | 32→128 write packing, 128→32 read extraction, addr alignment
9 | axi_downsizer.sv | None | 128→32 burst splitting, wstrb decomposition
10 | axi_width_converter.sv | upsizer, downsizer | Mixed-width combos, direction detection
11 | axi_master_if.sv | addr_decoder | ID prefix insertion, slave routing, outstanding tracking
12 | axi_timeout.sv | None | Timeout detection, forced SLVERR, sticky debug bit
13 | axi_crossbar.sv | All above | Full 5M x 5S integration, concurrent multi-master/multi-slave
14 | axi_to_axilite_bridge.sv | None | Protocol strip, burst rejection (SLVERR), ID buffering
15 | axilite_addr_decoder.sv | None | All 11 peripheral slots, unmapped → SLVERR
16 | axilite_mux.sv | None | Response routing from selected peripheral back to bridge
17 | axilite_fabric.sv | bridge, decoder, mux | CPU register R/W to all peripherals including SPI/ESP32

# 10. FPGA Resource Estimate

Resource | Estimate | Z7-20 Total | Notes
LUT (Crossbar) | 8K–12K | 85K | 5 arbiters, 5 mux/demux, width converters, addr decoders
LUT (AXI-Lite fabric) | 1K–2K | 85K | Simple 1:11 mux/demux, address decoder
FF (Total interconnect) | 3K–5K | 106K | Pipeline registers, arbiter state, outstanding FIFOs
BRAM18 | 2–4 | 280 | Outstanding transaction ID tracking FIFOs
DSP48 | 0 | 220 | No arithmetic in interconnect

Cumulative Z7-20 utilization (all subsystems): RISC-V (~12K LUT, 64 BRAM, 4 DSP) + NPU (~22K LUT, 40 BRAM, 80 DSP) + Audio (~5K LUT, 10 BRAM, 6 DSP) + Camera (~7K LUT, 6 BRAM, 6 DSP) + AXI Interconnect (~12K LUT, 4 BRAM, 0 DSP) = ~58K/85K LUT (68%), ~124/280 BRAM (44%), ~96/220 DSP (44%). Headroom available for SPI master, I2C master, and debug infrastructure.

# 11. Simulation and Verification Plan

## 11.1 Unit-Level Tests

Module | Key Tests
axi_addr_decoder | All 5 slave ranges, boundary addresses (first/last byte), unmapped gaps, Boot ROM overflow, SRAM overflow
axi_arbiter | 2-master contention: verify round-robin. 3-tier: Tier 0 always wins. Starvation: promotion after 32 cycles. Lock during burst.
axi_width_converter | 32→128 write: all 4 byte lanes. 128→32 read: correct slice. Mixed burst directions. Narrow CPU write to DDR.
axi_error_slave | Single-beat read/write DECERR. Burst read DECERR with correct RLAST. Write burst with WLAST accepted.
axi_timeout | Normal transaction (no timeout). Hung slave: verify timeout at cycle 4096. Counter reset on handshake.
axi_to_axilite_bridge | Single-beat pass-through. Burst rejection (SLVERR). AXI ID buffer and re-attach.
axilite_addr_decoder | All 11 peripheral slots. Unmapped address → SLVERR. Register offset (bits [7:0]) preservation.

## 11.2 Integration Tests

Test | Description
CPU Boot via Crossbar | CPU iBus (M0) fetches from Boot ROM (S0). Verify instruction data reaches Ibex correctly.
CPU Peripheral Access | CPU dBus (M1) writes UART register via S2 → AXI-Lite fabric → P0. Verify data arrives at UART.
CPU → SPI → ESP32 path | CPU writes SPI_TX_FIFO at 0x2000_0718 via S2 → AXI-Lite → P7. Verify SPI shift register clocks out data.
NPU DMA to DDR | NPU DMA (M2) reads weights from DDR (S3). Verify burst data integrity. Verify M2 gets Tier 0 priority.
Camera DMA + NPU DMA contention | Camera (M3) writes frame to DDR while NPU (M2) reads weights. Both target S3. Verify NPU gets priority, both complete.
All-Masters Active | M0+M1+M2+M3+M4 all issuing simultaneously to different slaves. Verify no deadlock, all complete.
Width Conversion | CPU (32-bit) reads from DDR (128-bit). NPU (128-bit) accesses SRAM (32-bit). Verify data correct.
Error Handling | CPU accesses 0x5000_0000 (unmapped). Verify DECERR. No hang. CPU reads error status.
Timeout Recovery | DDR model configured to never respond. Verify timeout fires, SLVERR returned, bus recovers.
Full SoC Data Path | Audio MFCC → DDR (M4→S3). NPU reads MFCC (M2→S3). NPU writes result (M2→S3). CPU reads (M1→S3). End-to-end.
Conversation Streaming Path | Audio PCM → DDR (M4→S3). CPU reads DDR (M1→S3). CPU writes SPI (M1→S2→P7). Full streaming loop.

# 12. ASIC Migration Notes

The AXI crossbar and AXI-Lite fabric RTL are fully technology-independent. They migrate to ASIC (180nm, 28nm) without any changes. The only implementation difference is clock frequency: 100 MHz on FPGA, 200–400 MHz on ASIC, which increases effective crossbar bandwidth proportionally.

The SPI master peripheral (P7) for ESP32 communication also migrates unchanged. The ESP32-C3 companion chip connects via SPI on all phases: eval board wires (Phase 0), test PCB traces (Phase 1), and production PCB traces (Phase 2). The SPI protocol and register interface are identical across all phases.

— End of AXI Interconnect RTL Implementation Document v2 —

AI Glasses SoC | Phase 0 FPGA → Phase 1 (180nm) → Phase 2 (28nm) | Version 2.0 | March 2026

Confidential — Page

AXI Interconnect RTL Implementation Document v2 AI Glasses SoC — Phase 0
