anirudhr-adtech/AI_GLASSES/AI_Smart_Glasses_docs/Specs and Sub system implementation document/NPU_Subsystem_Design_Document_v2.docx

NPU SUBSYSTEM

DESIGN DOCUMENT

AI Glasses SoC — Phase 0 FPGA Prototype

8×8 INT8 MAC Array Accelerator | 128-bit AXI DMA | CPU-Scheduled Layers

Field | Value
Document Version | 2.0 (Updated for Marvin/VPS/ESP32 decisions)
Status | DRAFT — Architecture Lock
Phase | Phase 0 — FPGA Prototype
Author | Anirudh (Sole Architect)
Date | March 2026
ASIC Migration | Phase 1 — 180nm Test Vehicle (Chip 1)
Wake-Word Model | DS-CNN-S "Marvin" (ARM ML-KWS-for-MCU, pre-trained, ~6 MMAC, ~30–50 KB INT8)
AI Backend | VPS with Cloud AI APIs via ESP32-C3 Wi-Fi companion chip
Companion Docs | RISC-V Subsystem, Audio Subsystem v2, Camera/Vision Subsystem, AXI Interconnect, DDR Subsystem

# Version 2.0 Change Log

This section documents all changes from v1.0 based on architectural decisions made during the design review cycle. The NPU microarchitecture (8×8 MAC array, DMA, scratchpad, register map, FSM) is unchanged. Updates are to model-specific parameters, DDR addresses, and post-inference data flow.

# | Change | Detail

1 | Wake-word model specified | DS-CNN generic → DS-CNN-S "Marvin" from ARM ML-KWS-for-MCU. Compute: 20–40 MMAC → ~6 MMAC. Weights: ~200 KB → ~30–50 KB INT8.
2 | MFCC input tensor dimensions locked | "10–40 frames, 10–40 coeffs" → exactly 49 frames x 10 coefficients, 16-bit, per ARM --window_size_ms 40 --window_stride_ms 20.
3 | DDR WEIGHTS sub-map added | DS-CNN-S "Marvin" at DDR offset +0x0000_0000 (64 KB padded). Enrolled faces DB at +0x0040_0000.
4 | VPS offload option added to face recognition flow | After MobileFaceNet embedding: option to send 128-byte vector to VPS via ESP32 for cloud-side identity lookup, in addition to on-device cosine similarity.
5 | Wake-word inference flow added | New Section 5.3: step-by-step NPU execution for DS-CNN-S "Marvin" with specific DDR addresses and tensor sizes.
6 | Post-inference firmware context added | Section 5.4: What happens after NPU classification — firmware FSM transitions, audio mode switch, VPS streaming trigger.
7 | Open items partially resolved | Depthwise separable convolution: RESOLVED (required for DS-CNN and MobileFaceNet). Wake phrase: RESOLVED ("Marvin").

# 1. Overview

The Neural Processing Unit (NPU) is the primary AI inference accelerator within the AI Glasses SoC. Its responsibility is to execute quantized neural network layers with high efficiency, offloading all compute-intensive operations from the RISC-V CPU.

The NPU is not a general-purpose processor. It is a fixed-function datapath optimized for INT8 matrix and convolution operations, controlled entirely by the CPU via memory-mapped registers.

## 1.1 Role in the System

- Executes convolutional and fully-connected layers for all three AI use cases
- Receives layer commands from the RISC-V CPU via AXI-Lite register writes
- Fetches weights and input tensors from DDR via 128-bit AXI DMA
- Stores output tensors back to DDR upon layer completion
- Raises an interrupt to the CPU on inference completion

## 1.2 What the NPU Does NOT Do

- Does not run MFCC preprocessing — handled by dedicated audio DSP hardware pipeline
- Does not run ISP-lite (resize, color conversion) — handled by camera pipeline block
- Does not execute Softmax — handled by RISC-V CPU in firmware
- Does not manage its own model loading — CPU programs all DDR addresses
- Does not communicate with ESP32/VPS — CPU handles all Wi-Fi data transfer via SPI

## 1.3 Locked Architecture Parameters

Parameter | Decision | Rationale
MAC Array Size | 8×8 (64 MACs) | Sufficient for 5+ FPS face recognition on FPGA
Data Precision | INT8 × INT8 → INT32 | TinyML standard; minimizes area and bandwidth
Layer Scheduling | CPU-scheduled | Simple, debuggable; CPU programs one layer at a time
DMA AXI Width | 128-bit | Required for face recognition throughput at 5+ FPS
Control Interface | AXI4-Lite (32-bit) | Consistent with CPU peripheral register access pattern
Target Clock (FPGA) | 200 MHz | Achievable on Zynq Z7-20 fabric
Supported Operations | Conv2D, DW-Conv2D, FC, ReLU, ReLU6, MaxPool | Covers DS-CNN-S, BlazeFace, MobileFaceNet (v2: added DW-Conv2D)
Softmax | CPU-side only | Not in NPU datapath

# 2. Use Case Compute Requirements (Updated)

The three Phase 0 use cases place different compute demands on the NPU. This section validates that the 8×8 INT8 MAC array is sufficient for all three. Values updated with specific model selections.

Use Case | Model | Compute | Latency | NPU Feasibility
Wake Word ("Marvin") | DS-CNN-S (ARM) | ~6 MMAC | < 5 ms | ✅ Trivially met. ~1 ms at 6.4 GMAC/s sustained. NPU is idle 99% of the time for this use case.
Gesture Recognition | Tiny CNN | 10–20 MMAC | < 100 ms | ✅ Easily met. Smallest compute workload.
Face Detection | BlazeFace | ~200–300 MMAC | < 200 ms | ✅ Met at ~100–150 ms. Triggered one-shot, not continuous.
Face Embedding | MobileFaceNet | ~500–900 MMAC | < 300 ms | ✅ Met at ~150 ms. Total face recognition: ~300 ms.

Note: Face recognition latency of ~300ms total is acceptable for smart glasses. The use case is a triggered, one-shot event (not continuous video stream). Effective throughput at ~50–60% DMA efficiency gives ~6–8 GMAC/s sustained from 12.8 GMAC/s theoretical peak.

## 2.1 DS-CNN-S "Marvin" Model Details (NEW)

The wake-word model is a Depthwise Separable CNN from the ARM ML-KWS-for-MCU repository, trained on the Google Speech Commands dataset with "marvin" as a target class.

Parameter | Value
Model Architecture | DS-CNN-S (Small): 1 standard Conv2D + 4 depthwise separable Conv2D blocks + 1 FC layer
Source | ARM ML-KWS-for-MCU GitHub (Apache 2.0 license)
Training Dataset | Google Speech Commands v0.02 (105,829 one-second clips, 35 words)
Target Classes | 12: yes, no, up, down, left, right, on, off, stop, go, silence, unknown. "Marvin" can be added as explicit 13th class via --wanted_words marvin.
Input Tensor | 49 x 10 x 1 (49 time frames, 10 MFCC coefficients, 1 channel). INT8. Total: 490 bytes.
MFCC Parameters | --window_size_ms 40, --window_stride_ms 20, --dct_coefficient_count 10. Must match audio subsystem hardware exactly.
Model Size (float32) | ~200 KB (weights + biases)
Model Size (INT8 quantized) | ~30–50 KB (after quantization-aware training)
Compute per Inference | ~6 MMAC
Accuracy (INT8) | ~95–97% on validation set (per ARM paper and NXP replication)
Quantization Method | Post-training quantization with TFLite, or QAT (quantization-aware training) for higher accuracy. Both produce INT8 weights compatible with NPU.
DDR Address | WEIGHTS region: 0x0000_0000 (64 KB padded allocation)

## 2.2 Depthwise Separable Convolution Support (NEW)

Both DS-CNN-S and MobileFaceNet use depthwise separable convolutions. This is a factored convolution that decomposes a standard 3D convolution into a depthwise convolution (one filter per input channel) followed by a pointwise 1×1 convolution (channel mixing). The NPU must support this.

- Depthwise conv: the MAC array processes one input channel at a time with a 2D kernel. Utilization: only 8 of the 64 MACs are active per cycle (one row), since there’s no cross-channel accumulation. Effective throughput: 8 MACs/cycle for depthwise layers.
- Pointwise 1×1 conv: this is equivalent to a fully-connected layer applied per spatial position. The MAC array runs at full 64-MAC utilization (8 input channels × 8 output channels per cycle).
- Implementation: the NPU controller recognizes depthwise layers from LAYER_CONFIG (new type: 4=DW-Conv2D) and configures the MAC array dataflow accordingly. No MAC array hardware change needed — just different weight/activation address scheduling in the controller FSM.

# 3. NPU Microarchitecture

The NPU is organized into four functional planes: Control, Memory, Compute, and Interface. The microarchitecture is unchanged from v1.0.

## 3.1 Internal Block Descriptions

### 3.1.1 NPU Controller

The NPU Controller is the top-level orchestrator. It receives layer execution commands from the CPU via AXI-Lite registers and sequences the DMA, MAC array, and output pipeline accordingly.

- Decodes layer type from LAYER_CONFIG register (Conv2D, DW-Conv2D, FC, Pool)
- Programs DMA with source/destination addresses and transfer lengths
- Issues start signal to MAC array engine after DMA pre-fetch completes
- Monitors MAC array completion, triggers quantize and activation units
- Asserts NPU_DONE interrupt to CPU when output DMA write completes
- Updates STATUS register after each layer execution

### 3.1.2 MAC Array (8×8)

The core compute engine. Comprises 64 INT8 multiply-accumulate units arranged as an 8-wide, 8-deep systolic-style array.

- 8 input channels processed per clock cycle
- 64 multiplications in parallel per cycle (standard Conv2D and FC modes)
- 8 multiplications per cycle for depthwise Conv2D (one channel active, single row)
- INT32 accumulator prevents overflow during deep layer accumulation
- Supports Conv2D (sliding window), DW-Conv2D (per-channel), and FC (dot product) modes
- Pooling handled by a separate 2×2 max/avg pooling unit downstream of MAC

### 3.1.3 Weight Buffer (BRAM) — 128 KB

- Stores kernel weights for the current layer being executed
- Loaded from DDR via DMA before MAC array is started
- Dual-port BRAM: one port for DMA write, one port for MAC array read
- Address striped to match MAC array parallelism (8 weights per read cycle)

### 3.1.4 Activation Buffer (BRAM) — 128 KB

- Stores input feature maps for the current layer
- Loaded from DDR via DMA (input tensor or previous layer output)
- Supports NHWC tensor layout (consistent with TFLite quantized model format)

### 3.1.5 DMA Engine (128-bit AXI4 Master)

- Two independent channels: Weight DMA (DDR → Weight Buffer) and Activation DMA (DDR ↔ Activation Buffer)
- 128-bit AXI4 burst transfers — up to 16 bytes per clock at 200 MHz = 3.2 GB/s peak
- Configurable burst length (up to 256 beats per burst transaction)
- Stride support: handles non-contiguous tensor layouts (NHWC convolution access patterns)
- AXI ID prefix: 3'b010 (M2 on the AXI crossbar). QoS = 4'hF (highest priority)

### 3.1.6 Quantization Unit

Converts INT32 MAC accumulator output back to INT8: INT8_out = clamp((INT32_accum >> SHIFT) * SCALE, -128, +127). Bit-accurate match to TFLite INT8 quantization required.

### 3.1.7 Activation Unit

- ReLU (clamp to 0), ReLU6 (clamp to 0–6 in INT8 scaled domain), or bypass
- Activation type selected via ACT_TYPE field in LAYER_CONFIG register

# 4. NPU Register Map

All NPU registers are accessible via AXI4-Lite from the RISC-V CPU. Base address: 0x3000_0000. Register map unchanged from v1.0 except LAYER_CONFIG bit[3:0] now includes DW-Conv2D type.

Offset | Register | R/W | Reset | Description
0x00 | CONTROL | R/W | 0x0 | Bit[0]: Global NPU enable. Bit[1]: Soft reset (self-clearing). Bit[2]: IRQ enable.
0x04 | STATUS | RO | 0x0 | Bit[0]: NPU busy. Bit[1]: Layer done. Bit[2]: DMA busy. Bit[3]: Error flag.
0x08 | INPUT_ADDR | R/W | 0x0 | DDR base address of input activation tensor for current layer.
0x0C | WEIGHT_ADDR | R/W | 0x0 | DDR base address of weight tensor for current layer.
0x10 | OUTPUT_ADDR | R/W | 0x0 | DDR base address where output tensor will be written.
0x14 | INPUT_SIZE | R/W | 0x0 | Transfer size in bytes for input activation DMA.
0x18 | WEIGHT_SIZE | R/W | 0x0 | Transfer size in bytes for weight DMA.
0x1C | OUTPUT_SIZE | R/W | 0x0 | Transfer size in bytes for output DMA write.
0x20 | LAYER_CONFIG | R/W | 0x0 | Bits[3:0]: Layer type (0=Conv2D, 1=FC, 2=MaxPool, 3=AvgPool, 4=DW-Conv2D). Bits[7:4]: ACT_TYPE (0=None, 1=ReLU, 2=ReLU6). Bits[15:8]: Input channels. Bits[23:16]: Output channels.
0x24 | CONV_CONFIG | R/W | 0x0 | Bits[7:0]: Kernel size (e.g., 3 for 3×3). Bits[15:8]: Stride. Bits[23:16]: Padding mode (0=VALID, 1=SAME).
0x28 | TENSOR_DIMS | R/W | 0x0 | Bits[15:0]: Input H×W. Bits[31:16]: Output H×W.
0x2C | QUANT_PARAM | R/W | 0x0 | Bits[15:0]: Scale factor (fixed-point). Bits[23:16]: Right-shift amount for INT32→INT8.
0x30 | START | WO | — | Write 0x1 to begin layer execution. Clears automatically. NPU Controller begins DMA pre-fetch immediately.
0x34 | IRQ_CLEAR | WO | — | Write 0x1 to clear NPU_DONE interrupt.
0x38 | PERF_CYCLES | RO | 0x0 | Cycle count for last layer execution (cleared on START).
0x3C | DMA_STATUS | RO | 0x0 | Bit[0]: Weight DMA done. Bit[1]: Activation DMA done. Bit[2]: Output DMA done.

# 5. CPU-NPU Execution Flows

## 5.1 Per-Layer Execution Sequence (unchanged)

Step | CPU Action | NPU Response
1 | Write INPUT_ADDR, WEIGHT_ADDR, OUTPUT_ADDR | Registers latched in NPU Controller
2 | Write INPUT_SIZE, WEIGHT_SIZE, OUTPUT_SIZE | DMA transfer lengths configured
3 | Write LAYER_CONFIG, CONV_CONFIG, TENSOR_DIMS | Layer type, kernel size, activation type latched
4 | Write QUANT_PARAM (scale + shift) | Quantization unit configured
5 | Write 0x1 to START register | NPU Controller begins: fires both Weight DMA and Activation DMA in parallel
6 | Wait for NPU_DONE interrupt (WFI) | DMA pre-fetch completes → MAC array starts → Quantize → Activate → Output DMA write → IRQ asserted
7 | Read STATUS, optionally PERF_CYCLES | Status reflects layer completion
8 | Write 0x1 to IRQ_CLEAR | Interrupt deasserted. NPU ready for next layer.
9 | Update INPUT_ADDR = OUTPUT_ADDR (chain layers) | Output tensor from this layer becomes input to next

## 5.2 Face Recognition Full Inference Flow (updated)

// Stage 1: BlazeFace — Face Detection

// Weights pre-loaded in DDR at 0x0010_0000 (1 MB)

for each layer L in blazeface_model:

npu_program_layer(L); // writes all NPU registers

npu_start(); // write START register

wait_for_npu_done(); // WFI until IRQ

bounding_box = cpu_postprocess_detection(DDR_OUTPUT_BASE);

cpu_crop_and_align(frame_buffer, bounding_box, crop_buffer);

// Crop engine handles this in hardware (see Camera Subsystem doc)

// Stage 2: MobileFaceNet — Face Embedding

// Weights pre-loaded in DDR at 0x0020_0000 (2 MB)

for each layer L in mobilefacenet_model:

npu_program_layer(L);

npu_start();

wait_for_npu_done();

embedding = read_output_tensor(DDR_OUTPUT_BASE); // 128-dim INT8 vector

// Option A: On-device cosine similarity (CPU)

identity = cpu_cosine_similarity(embedding, enrolled_faces_ddr);

// Option B: VPS offload (NEW in v2)

// Send 128-byte embedding to VPS via ESP32 for cloud-side identity lookup

// esp32_tcp_send(embedding, 128);

// identity = esp32_tcp_recv(); // VPS returns match result

## 5.3 Wake-Word "Marvin" Inference Flow (NEW)

Step-by-step NPU execution for DS-CNN-S wake-word detection. This runs every ~1 second in LISTENING state.

Step | Action | Detail
1 | Audio subsystem writes MFCC to DDR | 49x10x16-bit tensor (980 bytes) at INPUTS: MFCC Feature Buffer A (DDR offset 0x0100_0000). IRQ to CPU.
2 | CPU programs NPU for DS-CNN-S layer 0 | INPUT_ADDR = 0x8100_0000 (MFCC buffer). WEIGHT_ADDR = 0x8000_0000 (DS-CNN weights). INPUT_SIZE = 490 bytes (INT8 = 49x10). LAYER_CONFIG = Conv2D, 64 filters, 10x4 kernel.
3 | NPU DMA fetches weights + input | Weight DMA: reads ~2–4 KB for first layer. Activation DMA: reads 490 bytes MFCC tensor. Both in parallel.
4 | NPU executes DS-CNN-S layers | CPU loops: program layer → START → WFI → next layer. 1 Conv2D + 4 DW-Sep-Conv2D + 1 FC. Total: ~6 MMAC = ~1 ms at 6.4 GMAC/s.
5 | NPU writes classification output | Output tensor: 12–13 INT8 scores (one per class) to DDR OUTPUTS (0x0300_0000). 13 bytes.
6 | CPU reads scores, applies threshold | CPU reads classification scores. If score["marvin"] > CONFIDENCE_THRESHOLD (0.85): wake-word detected.

## 5.4 Post-Inference Firmware Context (NEW)

What happens after the NPU finishes is critical context for understanding the system flow, even though it’s CPU firmware, not NPU hardware.

NPU Result | CPU Firmware Action
Wake-word NOT detected | CPU returns to LISTENING state. Audio subsystem continues MFCC production. NPU will run again in ~1 second on next feature frame.
Wake-word "Marvin" detected | CPU transitions firmware FSM: LISTENING → WAKE_DETECTED → STREAMING. Audio subsystem switches to PCM pass-through mode. CPU opens TCP connection to VPS via ESP32 SPI. Raw PCM streams from DDR ring buffer through ESP32 to VPS. NPU is idle during streaming.
Face detected (BlazeFace) | CPU programs crop engine registers with bounding box. Crop engine reads ROI from DDR, resizes, writes to crop buffer. CPU then programs NPU for MobileFaceNet.
Face identified (MobileFaceNet) | CPU reads 128-dim embedding from DDR. Either (A) runs cosine similarity locally against enrolled faces in DDR, or (B) sends embedding to VPS via ESP32 for cloud-side lookup. Result: person name or "unknown."
Conversation end (silence timeout) | CPU detects 3 seconds of silence via FRAME_ENERGY register. Closes TCP to VPS via ESP32. Switches audio back to MFCC mode. Firmware FSM returns to LISTENING. NPU resumes wake-word detection.

# 6. NPU Memory Architecture

## 6.1 On-Chip Buffer Sizes (unchanged)

Buffer | FPGA (Phase 0) | ASIC 180nm | Notes
Weight Buffer | 128 KB | 128 KB | Largest single layer kernel in MobileFaceNet fits in 64 KB; 128 KB gives double-buffer headroom
Activation Buffer | 128 KB | 128 KB | Largest intermediate tensor in BlazeFace is ~80 KB; 128 KB sufficient
Output Buffer | 64 KB | 64 KB | Output tensor of each layer; written to DDR by DMA immediately after activation
Total On-Chip SRAM | 320 KB | 320 KB | ~30–40 BRAM18 blocks on Zynq Z7-20

## 6.2 DDR Memory Map (Updated — aligned with DDR Subsystem doc)

Region | DDR Offset | Size | Contents
WEIGHTS | 0x0000_0000 | 16 MB | DS-CNN-S "Marvin" (+0x0000_0000, 64 KB), Gesture (+0x0001_0000, 128 KB), BlazeFace (+0x0010_0000, 1 MB), MobileFaceNet (+0x0020_0000, 2 MB), Enrolled Faces (+0x0040_0000, 256 KB)
INPUTS | 0x0100_0000 | 16 MB | MFCC features at +0x0000_0000 (1 KB double-buffered). NPU layer inputs at +0x0001_0000 (4 MB).
WORK | 0x0200_0000 | 16 MB | Intermediate tensors and scratch space for layer chaining
OUTPUTS | 0x0300_0000 | 16 MB | Classification scores, embedding vectors, inference results
FRAME BUFFER | 0x0400_0000 | 32 MB | Camera frames (128x128 RGBX), raw frames (640x480), crop output (112x112)

DDR address convention: NPU register addresses use the CPU physical address space (0x8000_0000 + DDR offset). Example: INPUT_ADDR for MFCC buffer = 0x8000_0000 + 0x0100_0000 = 0x8100_0000. The DDR wrapper handles the address translation.

# 7. AXI Interface Specification

Interface | Type | Width | Connected To
s_axi_lite | AXI4-Lite Slave | 32-bit | RISC-V CPU data bus (register access)
m_axi_dma | AXI4 Master | 128-bit | DDR Controller via AXI crossbar (M2, highest priority)
irq_npu_done | Output Signal | 1-bit | Interrupt Controller (IRQ aggregator, bit 5)
clk / rst_n | Clock / Reset | 1-bit each | SoC global clock and active-low reset

- AXI4 data width: 128-bit (16 bytes per beat)
- Max burst length: 256 beats (AWLEN/ARLEN = 255)
- Outstanding transactions: up to 4 read, 2 write
- AXI ID prefix: 3'b010 (crossbar M2). QoS: 4'hF (highest priority at DDR HP port)

# 8. FPGA Resource Estimate

Resource | Estimate | Z7-20 Total | Headroom
DSP48 (MAC units) | 64–80 | 220 | ~64% used — leaves room for RISC-V, audio, camera
BRAM18 (on-chip buffers) | 36–40 | 280 | ~14% used — very comfortable
LUT (control logic, DMA, FSM) | 15K–22K | 85K | ~20–25% used — within target
FF (pipeline registers) | 8K–12K | 106K | ~10% used — comfortable
Target Fmax | 200 MHz | N/A | Achievable with pipelined MAC + timing constraints

# 9. ASIC Migration Notes — Phase 1 (180nm Chip 1)

Item | FPGA (Phase 0) | ASIC 180nm (Phase 1)
BRAM / SRAM | Xilinx BRAM primitives | SCL Mohali SRAM compiler (from PDK)
DSP / MAC units | DSP48 primitives | Standard cell synthesized MAC array
Clock | 200 MHz (FPGA fabric) | Target 300–400 MHz post-synthesis
Target die area | N/A | ~3×3 mm (Chip 1, includes test pads)
RTL changes | FPGA-specific primitives | Replace with technology-independent RTL; no microarch change
AXI interfaces | Connected to Zynq HP port | Connected to AXI interconnect in test chip
Connectivity | ESP32 via SPI on eval board | ESP32-C3 bare chip on test PCB (same SPI interface)

# 10. RTL Implementation Plan

## 10.1 RTL Module Hierarchy

npu_top.sv // Top-level wrapper + AXI port declarations

├── npu_controller.sv // Layer FSM, register decode, sequencer

├── npu_regfile.sv // AXI4-Lite slave + register file

├── npu_dma.sv // 128-bit AXI4 master, burst engine

│ ├── dma_weight_ch.sv // Weight DMA channel

│ └── dma_act_ch.sv // Activation DMA channel

├── npu_weight_buf.sv // Weight BRAM wrapper (128 KB)

├── npu_act_buf.sv // Activation BRAM wrapper (128 KB)

├── npu_mac_array.sv // 8×8 INT8 MAC array

│ └── mac_unit.sv // Single INT8×INT8→INT32 MAC cell

├── npu_quantize.sv // INT32→INT8 scale/shift/clamp

└── npu_activation.sv // ReLU / ReLU6 / bypass

## 10.2 Recommended RTL Generation Sequence (Claude Agent)

# | Module | Notes

1 | mac_unit.sv | Single MAC cell. Smallest, easiest to verify in isolation.
2 | npu_mac_array.sv | 8×8 instantiation of mac_unit with accumulator bank.
3 | npu_quantize.sv | Parameterized scale/shift/clamp unit.
4 | npu_activation.sv | ReLU/ReLU6/bypass with config input.
5 | npu_weight_buf.sv + npu_act_buf.sv | BRAM wrappers with dual-port interface.
6 | npu_regfile.sv | AXI4-Lite slave with all registers from Section 4.
7 | npu_dma.sv | 128-bit AXI4 master with burst engine. Two channels.
8 | npu_controller.sv | Top-level FSM. Must handle Conv2D, DW-Conv2D, FC, Pool scheduling.
9 | npu_top.sv | Final integration wrapper.

# 11. Open Items & Decisions

## 11.1 Resolved Decisions (v2)

# | Decision | Resolution

1 | Wake-word phrase | RESOLVED: "Marvin" from Google Speech Commands. DS-CNN-S pre-trained model from ARM ML-KWS-for-MCU.
2 | Depthwise separable convolution | RESOLVED: Required. DS-CNN-S and MobileFaceNet both use DW-Sep-Conv. Added type 4=DW-Conv2D to LAYER_CONFIG.
3 | MFCC input tensor format | RESOLVED: 49 x 10 x 1, INT8, matching ARM training params (40ms window, 20ms stride, 10 DCT coefficients).
4 | Post-inference action path | RESOLVED: CPU firmware FSM handles LISTENING → STREAMING transition. NPU output triggers mode switch. VPS via ESP32.
5 | Face embedding offload | RESOLVED: Both paths available. On-device cosine similarity (default) or VPS offload via ESP32 (configurable in firmware).

## 11.2 Remaining Open Items

# | Open Item | Impact | Owner / Target

1 | Pooling: NPU hardware or CPU firmware? | Small — pooling layers are infrequent | Decide before mac_array RTL
2 | Double-buffering in Weight/Act buffers? | Performance boost but doubles BRAM | Evaluate after Phase 0 latency measurements
3 | NPU clock domain: same as sys_clk or separate? | Power management for ASIC | Decide before Phase 1 PD
4 | MAC dataflow: weight-stationary vs output-stationary? | Affects BRAM access pattern | Decide before mac_array RTL

— End of NPU Subsystem Design Document v2 —

AI Glasses SoC | Phase 0 FPGA → Phase 1 (180nm) | Version 2.0 | March 2026

Confidential — Page

NPU Subsystem Design Document v2 AI Glasses SoC — Phase 0
