anirudhr-adtech/AI_GLASSES/AI_Smart_Glasses_docs/Budget and Phase planning/Phase 0 Data Path Architecture Document.docx

# AI Smart Glasses – Phase 0 Data Path Architecture Document

## Purpose of This Document

This document formally defines the data paths for Phase 0 (FPGA prototype) of the AI Smart Glasses program.
It clearly separates:

• Use Case • Full End‑to‑End Data Flow
• FPGA Components Involved
• RTL Components Required

This structure will be reused for ASIC Phase 1 and Phase 2.

# System-Level Architecture Overview

The Phase 0 FPGA prototype consists of four primary domains:

1. Sensor Data Paths (Audio / IMU / Camera)
2. DDR Memory Backbone
3. NPU Compute Data Path
4. Control & CPU Plane

DDR is treated as a first-class architectural block and not merely a memory element.

# USE CASE 0 – DDR Memory Backbone (System Data Movement)

## Purpose

Provide high-bandwidth external memory for:

• Model weights • Frame buffers • Audio buffers • Intermediate tensors • Embeddings

Without DDR, face recognition and CNN workloads cannot operate.

## Full Data Flow

External DDR
↕
DDR Controller
↕
AXI Interconnect
↕
DMA Engine
↕
Scratchpad SRAM
↕
NPU MAC Array

## FPGA Components Involved

• Zynq DDR Controller (PS side) • AXI High Performance Port • AXI Interconnect • AXI Master DMA • BRAM Scratchpad • NPU Core

## RTL Components Required

A) AXI Master Interface • Read channel • Write channel • Burst logic • Address generator
B) DMA Engine • Transfer length register • Base address register • Stride logic (for convolution) • Done interrupt logic
C) Scratchpad Controller • Dual-port SRAM interface • Bank arbitration • Read/write scheduler
D) Memory Map Decoder • Model base address • Activation base address • Frame buffer base address

# USE CASE 1 – Voice Phrase / Wake Word Detection

## Purpose

Detect trigger phrase locally with ultra-low latency and low power.

## Full Data Flow

Microphone
→ Audio ADC / Codec
→ I2S Interface
→ Audio Buffer (BRAM or DDR)
→ Feature Extraction (MFCC)
→ NPU (DS‑CNN inference)
→ INT32→INT8 Quantize
→ Softmax / Threshold
→ Interrupt to CPU

## FPGA Components Involved

• Microphone
• External Audio Codec
• I2S Controller
• Audio FIFO
• MFCC Processing Block
• NPU Core
• AXI Bus
• DDR
• ARM CPU
• Interrupt Controller

## RTL Components Required

A) Audio Interface • I2S RX Controller • Audio FIFO • Sample rate generator
B) Audio Preprocessing • Windowing block • FFT engine • Mel filterbank • Log & normalization unit • MFCC output formatter
C) NPU Core (Reusable) • MAC array • Accumulator bank • Scratchpad SRAM • DMA engine • Layer control FSM
D) Post-Processing • Quantization unit • Softmax (optional) • Threshold comparator • Interrupt generator

# USE CASE 2 – Gesture Recognition (IMU-Based)

## Purpose

Detect predefined head or hand gestures using IMU data.

## Full Data Flow

IMU Sensor
→ I2C Interface
→ Sensor FIFO
→ Digital Filter
→ Feature Windowing
→ Tiny NN Model (NPU)
→ Classification Output
→ CPU Decision

## FPGA Components Involved

• IMU Sensor
• I2C Controller
• Sensor FIFO
• DSP Filter Block
• NPU Core
• AXI Bus
• CPU

## RTL Components Required

A) Sensor Interface • I2C Master Controller • Sensor read FSM • Data FIFO
B) Signal Conditioning • Low-pass filter • Moving average block • Feature packer
C) Inference Engine • Reused NPU core • DDR model storage • Scratchpad load logic
D) Output Logic • Class ID register • Threshold comparator • Interrupt logic

# USE CASE 3 – Face Recognition

## Purpose

Identify known person using camera input.

Two-stage pipeline: 1. Face Detection
2. Face Embedding + Similarity

## Full Data Flow

Camera
→ MIPI CSI‑2 Receiver
→ Frame DMA
→ DDR Frame Buffer
→ ISP-lite (resize + color conversion)
→ NPU (BlazeFace detection)
→ Bounding box output
→ Crop + Align
→ NPU (MobileFaceNet embedding)
→ Feature Vector
→ Cosine Similarity Engine
→ Identity Decision

## FPGA Components Involved

• Camera Module
• MIPI CSI‑2 RX
• Video DMA
• DDR
• Frame Buffer Controller
• ISP-lite Block
• NPU Core
• CPU

## RTL Components Required

A) Camera Interface • MIPI CSI‑2 receiver • Pixel unpacker • Frame sync logic • Video DMA engine
B) ISP-lite • RGB converter • Resize engine • Line buffer • Frame buffer controller
C) NPU Core (Reusable) • MAC array • Scratchpad SRAM • DMA engine • Control FSM • Quantization unit
D) Post-Processing • Bounding box parser • Crop engine • Vector normalization block • Cosine similarity engine • Threshold comparator

# Reusable Core Blocks Across All Use Cases

The following RTL blocks are common across all AI workloads:

• NPU MAC Array
• Accumulator Bank
• Scratchpad SRAM
• DMA Engine
• AXI Interconnect
• Quantization Unit
• Interrupt Controller
• CPU Register Interface

Pre-processing and post-processing differ per use case, but compute core remains identical.

# Architectural Conclusion

The system is organized into:

1. IO Domain
2. Memory Backbone Domain (DDR + DMA + Scratchpad)
3. Compute Domain (NPU)
4. Control Domain (CPU + Registers + Interrupts)

Proper DDR modeling and DMA scheduling are critical to avoid bandwidth bottlenecks.

This document forms the foundation for RTL implementation planning and future ASIC migration.
