anirudhr-adtech/AI_GLASSES/AI_Smart_Glasses_docs/Budget and Phase planning/Phase0_AI_Glasses_FPGA_Architecture.docx

# Phase 0 Architecture – AI Smart Glasses FPGA Prototype

# 1. Objective of Phase 0

The goal of Phase 0 is to build a functional FPGA prototype that demonstrates the key capabilities of the smart‑glasses system.

This prototype will validate the architecture before moving to ASIC development.

Key demonstration features:

• Voice phrase / wake word detection

• Gesture recognition

• Face recognition

• Wireless interaction with a mobile phone

• Mic, speaker, and camera based interaction

# 2. System Architecture Overview

The FPGA prototype acts as the sensing and edge‑AI processing unit while the mobile phone acts as the main AI brain.

System responsibilities:

Glasses (FPGA):

• Audio capture and wake‑word detection

• Camera capture and basic vision inference

• Sensor/gesture detection

• Streaming data to mobile

Mobile phone:

• Speech‑to‑text

• LLM reasoning

• App integrations (Calendar, WhatsApp, email)

• Text‑to‑speech responses

# 3. NPU (Neural Processing Unit)

The NPU is a hardware accelerator that performs tensor computations used in neural networks.

Purpose:

• Accelerate convolutional neural networks

• Reduce CPU load

• Enable real‑time inference on the device

Minimal NPU Architecture:

• MAC array (Multiply‑Accumulate units)

• Scratchpad SRAM

• DMA interface

• Control FSM / scheduler

• Activation unit (ReLU)

• AXI interface to system memory

Example Phase‑0 configuration:

• 64 INT8 MAC units

• 200 MHz clock

• ~12 GMAC/s compute capability

Operations supported:

• Convolution

• Matrix multiplication

• ReLU activation

• Pooling

• Fully connected layers

# 4. Tiny AI Models for Phase 0

The prototype will run lightweight edge‑AI models.

Voice Phrase / Wake Word:

Model: DS‑CNN

Size: ~50–200 KB

Compute: ~20–40 MMAC

Purpose: Detect phrase such as 'Hey Glasses'

Gesture Recognition:

Option A: IMU‑based gestures

Model size: 20–100 KB

Compute: ~10–20 MMAC

Face Recognition:

Two stage pipeline:

1. Face Detection – BlazeFace (~1 MB)

2. Face Embedding – MobileFaceNet (~2 MB)

Total memory for models:

~3.5 MB

# 5. Memory Architecture (DDR)

External DDR memory stores models and runtime tensors.

Typical memory layout:

• Wake word model (~200 KB)

• Gesture model (~50 KB)

• Face detection model (~1 MB)

• Face recognition model (~2 MB)

• Frame buffers

• Intermediate tensors

Why DDR is needed:

• AI workloads require high bandwidth

• On‑chip SRAM is limited

Example DDR bandwidth:

32‑bit DDR3 @ 800 MHz ≈ 6.4 GB/s

# 6. Data Flow During Inference

Example inference flow:

1. CPU schedules inference

2. DMA loads model weights from DDR

3. NPU loads layer weights into scratchpad

4. MAC array performs computation

5. Output tensors stored back to DDR

6. CPU processes results

# 7. Other SoC Blocks

Essential blocks in the FPGA system:

Audio Pipeline

• I2S audio interface

• Audio buffer

• Feature extraction (MFCC)

Camera Pipeline

• Camera interface

• ISP‑lite (resize, color conversion)

• Frame buffer

Sensor Interfaces

• I2C for IMU sensors

• SPI for peripherals

Communication

• Wi‑Fi or BLE module for mobile communication

Control Plane

• ARM CPU (Zynq) or soft RISC‑V CPU

• AXI bus interconnect

• Interrupt controller

# 8. FPGA Hardware Requirements

Recommended FPGA development board features:

• Zynq SoC (ARM CPU + FPGA fabric)

• DDR3/DDR4 memory onboard

• Camera interface (MIPI CSI‑2 or HDMI)

• Audio codec or I2S interface

• Ethernet / USB / Wi‑Fi connectivity

Recommended boards:

• Zybo Z7‑20

• PYNQ‑Z2

• ZedBoard

# 9. Power System

Prototype can be powered by a Li battery via a USB power bank.

Typical setup:

Power Bank → 5V → FPGA board

Estimated power consumption:

FPGA prototype: 5–10 W

Battery runtime (20,000 mAh): ~2–4 hours

# 10. Phase 0 Deliverables

• Working FPGA prototype

• NPU RTL implementation

• Wake‑word detection demo

• Gesture recognition demo

• Face recognition demo

• Wireless mobile interaction

• Battery‑powered operation

This validates architecture before ASIC Phase 1.
