anirudhr-adtech/AI_GLASSES/AI_Smart_Glasses_docs/Specs and Sub system implementation document/Audio_Subsystem_RTL_Implementation_v2.docx

AUDIO SUBSYSTEM

RTL IMPLEMENTATION DOCUMENT

AI Glasses SoC — Phase 0 FPGA Prototype

I2S Interface | MFCC Feature Extraction | Wake-Word Inference Datapath

Field | Value
Document Version | 2.0 (MFCC parameters aligned to ARM DS-CNN)
Status | DRAFT — Architecture Lock
Phase | Phase 0 — FPGA Prototype
Author | Anirudh (Sole Architect)
Date | March 2026
ASIC Migration | Phase 1 — 180nm Test Vehicle (Chip 2A: Audio DSP + ADC)
Companion Docs | NPU Subsystem Design Document, RISC-V Subsystem RTL Implementation, Phase 0 Data Path Architecture, Phase 0 Simulation Validation Plan

# 1. Overview

The Audio Subsystem is responsible for capturing audio from an external MEMS microphone via an I2S codec, buffering samples, extracting MFCC features, and delivering feature tensors to the NPU for wake-word inference. It implements the complete front-end of Use Case 1 (Voice Phrase / Wake Word Detection) from the Phase 0 Data Path Architecture document.

The subsystem operates as a pipeline: I2S reception → audio buffering → windowing → FFT → Mel filterbank → log compression → MFCC output formatting → DDR write via DMA. The RISC-V CPU configures the pipeline and triggers NPU inference when a complete MFCC feature frame is ready.

## 1.1 Role in the System

- Receives 16-bit PCM audio samples from an external I2S audio codec at 16 kHz sample rate
- Buffers audio frames (40ms windows with 20ms stride, matched to ARM DS-CNN training parameters)
- Computes MFCC features in hardware for low-latency wake-word preprocessing
- Writes completed MFCC feature vectors to DDR via DMA for NPU consumption
- Raises interrupt to CPU when a complete feature frame (multiple MFCC vectors) is ready
- Provides audio pass-through mode for streaming raw PCM to DDR (used for speech-to-text offload to mobile)

## 1.2 What the Audio Subsystem Does NOT Do

- Does not run the DS-CNN wake-word model — NPU handles all neural network inference
- Does not perform Softmax or confidence thresholding — handled by RISC-V CPU in firmware
- Does not implement the audio DAC/speaker output path — separate subsystem (Chip 2B in ASIC Phase 1)
- Does not implement beamforming — single microphone channel in Phase 0; multi-mic in Phase 2
- Does not manage its own inference scheduling — CPU orchestrates MFCC-to-NPU handoff

## 1.3 Locked Architecture Parameters

Parameter | Decision | Rationale
Audio Interface | I2S Slave Receiver | Standard interface to external codec; simplest integration on FPGA
Sample Rate | 16 kHz | Standard for keyword spotting models (DS-CNN)
Sample Width | 16-bit signed PCM | Sufficient SNR for voice; matches I2S codec output
MFCC Implementation | Hardware pipeline (Phase 0) | Reduces CPU load; validates RTL for ASIC migration
FFT Size | 1024-point radix-2 | Matches 40ms window at 16 kHz (640/16000 = 40ms); next power-of-2 above 640
Mel Filters | 40 triangular filters | Standard for DS-CNN keyword spotting
MFCC Coefficients | 10 per frame | DCT of 40 mel energies, keep first 10 (matches ARM --dct_coefficient_count 10)
Window Function | Hamming | Standard for speech; reduces spectral leakage
Frame Size | 640 samples (40ms) | Matches ARM DS-CNN training: --window_size_ms 40
Frame Stride | 320 samples (20ms) | Matches ARM DS-CNN training: --window_stride_ms 20
Feature Frame Depth | 49 MFCC vectors | ~1 second of audio (49 x 20ms = 980ms); matches DS-CNN 1-second input
Arithmetic Precision | 16-bit fixed-point | Sufficient for MFCC; minimizes FPGA resources
DMA Width | 32-bit AXI4 | Adequate bandwidth for audio data rates (~320 KB/s peak)
Control Interface | AXI4-Lite (32-bit) | Consistent with RISC-V peripheral register access pattern
Target Clock (FPGA) | 100 MHz | Same as RISC-V subsystem system clock

# 2. Use Case Compute Requirements

The audio subsystem serves a single primary use case: wake-word detection. This section validates the pipeline throughput requirements.

## 2.1 Timing Budget

Parameter | Value | Notes
Audio sample rate | 16,000 samples/sec | One 16-bit sample every 62.5 µs
Frame period (stride) | 20 ms (320 samples) | New MFCC vector needed every 20 ms
FFT computation budget | < 20 ms per frame | 1024-point FFT must complete within frame stride
FFT at 100 MHz | ~102 µs (radix-2 butterfly) | 1024 * log2(1024) * 1 cycle = ~10240 cycles = 102 µs
Mel filterbank | ~40 µs | 40 filters x ~100 multiply-accumulate operations
Log + DCT | ~20 µs | Log lookup + 10-coefficient DCT
Total MFCC latency | ~170 µs per frame | Well within 20 ms budget (117x margin)
Full feature frame | 980 ms (49 vectors x 20 ms) | CPU triggers NPU after 49th MFCC vector written to DDR
NPU inference (DS-CNN) | < 5 ms | ~6 MMAC for DS-CNN-S at 12.8 GMAC/s peak
Total wake-word latency | ~1000 ms | Feature accumulation (~1s) + inference (~5ms); acceptable for UX

## 2.2 Bandwidth Requirements

Data Path | Bandwidth | Notes
I2S input | 32 KB/s | 16 kHz x 16-bit = 256 kbps
MFCC output to DDR | ~2.0 KB/s | 10 coefficients x 16-bit x 50 frames/sec / 8
Raw PCM pass-through | 32 KB/s | When streaming to DDR for mobile offload
DMA to DDR peak | < 1 MB/s | Negligible vs DDR bandwidth (6.4 GB/s)

Audio data rates are trivially small relative to DDR bandwidth. No bandwidth contention with NPU DMA is expected.

# 3. Audio Subsystem Microarchitecture

## 3.1 Top-Level Block Diagram

The audio subsystem is organized into five functional stages: Interface, Buffering, Feature Extraction, Output, and Control.

AUDIO SUBSYSTEM — Top-Level Block View

┌──────────────────────────────────────────────────────────────┐

│ AUDIO SUBSYSTEM │

│ │

│ AXI4-Lite ──► Audio Controller ◄── Interrupt Out │

│ (CPU regs) │ │

│ │ │

│ I2S_SCK/WS/SD │ │

│ │ │ │

│ ▼ ▼ │

│ ┌───────────┐ ┌─────────────┐ │

│ │ I2S RX │ │ Audio FIFO │ mode=passthrough? │

│ │ Controller │─►│ (1024 x 16) │─────[YES]──► DMA ─► DDR │

│ └───────────┘ └──────┬──────┘ │

│ │ [NO: MFCC mode] │

│ ▼ │

│ ┌────────────────┐ │

│ │ Window + Hamming │ │

│ └────────┬───────┘ │

│ ▼ │

│ ┌────────────────┐ │

│ │ 1024-pt FFT │ │

│ │ (Radix-2 DIT) │ │

│ └────────┬───────┘ │

│ ▼ │

│ ┌────────────────┐ │

│ │ Power Spectrum │ |X(k)|^2 │

│ └────────┬───────┘ │

│ ▼ │

│ ┌────────────────┐ │

│ │ Mel Filterbank │ 40 triangular filters │

│ └────────┬───────┘ │

│ ▼ │

│ ┌────────────────┐ │

│ │ Log Compress │ log(x) via LUT │

│ └────────┬───────┘ │

│ ▼ │

│ ┌────────────────┐ │

│ │ DCT (Type-II) │ 40 → 10 coefficients │

│ └────────┬───────┘ │

│ ▼ │

│ ┌────────────────┐ │

│ │ MFCC Output Buf │ 49 x 10 feature frame │

│ └────────┬───────┘ │

│ ▼ │

│ DMA ─► DDR (MFCC feature tensor) │

│ IRQ ─► CPU (feature_frame_ready) │

└──────────────────────────────────────────────────────────────┘

## 3.2 Internal Block Descriptions

### 3.2.1 Audio Controller (audio_controller.sv)

The Audio Controller is the top-level orchestrator for the audio subsystem. It receives configuration from the CPU via AXI-Lite registers and sequences the MFCC pipeline stages.

- Decodes operating mode from MODE register (MFCC mode vs. raw pass-through mode)
- Monitors audio FIFO fill level; triggers windowing when sufficient samples are available (640 samples for a frame)
- Sequences pipeline stages: window → FFT → power spectrum → mel → log → DCT
- Counts completed MFCC vectors; triggers DMA to DDR when MFCC output buffer has a complete row
- Tracks feature frame count (49 vectors); asserts AUDIO_FRAME_READY interrupt when full frame is ready
- Updates STATUS register after each pipeline stage completion

### 3.2.2 I2S Receiver (i2s_rx.sv)

The I2S receiver captures serial audio data from an external codec. It operates as an I2S slave, with the codec providing SCK (bit clock) and WS (word select/LRCK).

- Receives serial data on I2S_SD_I, synchronized to I2S_SCK_I
- Deserializes 16-bit left-channel samples (mono capture for wake-word; right channel discarded)
- MSB-first format per I2S standard (data valid one SCK cycle after WS transition)
- Outputs 16-bit signed PCM samples with a sample_valid strobe
- I2S_SCK frequency: 16 kHz x 2 channels x 16 bits = 512 kHz (provided by codec)

### 3.2.3 Audio FIFO (audio_fifo.sv)

Circular FIFO buffer between I2S receiver and the MFCC pipeline. Provides rate decoupling between the continuous I2S sample stream and the bursty MFCC frame processing.

- Depth: 1024 entries x 16 bits (accommodates ~64ms of audio at 16 kHz; 2.5x frame size margin)
- Synchronous FIFO (single clock domain; I2S SCK is much slower than sys_clk, samples are already synchronized)
- Write port: from I2S receiver (sample_valid strobe)
- Read port: consumed by windowing block (640 samples per frame, 320 samples advanced per stride)
- Status flags: full, empty, fill_level (10-bit count)
- Overflow behavior: overrun flag set, newest sample discarded (preserves oldest for in-progress frame)

### 3.2.4 Windowing Block (audio_window.sv)

Extracts overlapping frames from the audio FIFO and applies a Hamming window function.

- Frame size: 640 samples (40ms at 16 kHz)
- Stride: 320 samples (20ms hop). After processing a frame, the FIFO read pointer advances by 320, not 640 (overlap-add)
- Hamming coefficients: stored in a 640-entry ROM (16-bit fixed-point, Q1.15 format)
- Operation: output[n] = sample[n] * hamming_coeff[n] for n = 0..639
- Zero-padding: 640 windowed samples are zero-padded to 1024 for FFT input
- Output: 1024 x 16-bit windowed samples written to FFT input buffer (BRAM)

### 3.2.5 FFT Engine (fft_engine.sv)

1024-point radix-2 decimation-in-time (DIT) FFT. Computes the discrete Fourier transform of the windowed audio frame.

- Architecture: in-place butterfly computation using dual-port BRAM
- Stages: 10 stages (log2(1024) = 10), each stage processes 512 butterfly operations
- Butterfly: complex multiply-add using 4 DSP multipliers per butterfly
- Twiddle factors: 512 complex coefficients stored in ROM (16-bit real + 16-bit imaginary, Q1.15)
- Data precision: 16-bit real + 16-bit imaginary throughout (32-bit complex)
- Bit-reversal: input addresses are bit-reversed before stage 0 (handled by address generator)
- Latency: ~10240 cycles at 100 MHz = ~102 µs (10 stages x 512 butterflies x 2 cycles per butterfly)
- Output: 1024 complex frequency bins (only first 513 bins [0..N/2] are used due to real-input symmetry)

### 3.2.6 Power Spectrum Unit (power_spectrum.sv)

Computes the squared magnitude of each FFT bin: |X(k)|^2 = Re(k)^2 + Im(k)^2.

- Processes 513 bins (DC through Nyquist)
- Uses 2 DSP multipliers: one for Re^2, one for Im^2, then adds
- Output: 513 x 32-bit unsigned power values
- Latency: 513 cycles (~5.1 µs at 100 MHz)

### 3.2.7 Mel Filterbank (mel_filterbank.sv)

Applies 40 overlapping triangular filters on the mel frequency scale to the power spectrum. Each filter sums weighted power spectrum bins within its frequency range.

- 40 filters spanning 0 Hz to 8 kHz (Nyquist at 16 kHz sample rate)
- Filter coefficients: stored in ROM. Each filter is defined by start_bin, center_bin, end_bin, and triangular weights
- Implementation: sequential accumulator. For each filter, iterate over its bin range and accumulate weighted power values
- Coefficient format: 16-bit fixed-point (Q0.16 unsigned)
- Output: 40 x 32-bit mel energy values
- Latency: ~500–600 cycles (~5–6 µs) depending on filter overlap

### 3.2.8 Log Compression Unit (log_compress.sv)

Computes the natural logarithm of each mel energy value. Uses a lookup table with linear interpolation for area efficiency.

- Input: 40 x 32-bit unsigned mel energies
- LUT: 256-entry ROM mapping 8-bit index to 16-bit log value (Q8.8 fixed-point)
- Method: normalize input to [0.5, 1.0) range by finding MSB position, then LUT lookup on upper 8 bits of mantissa, add exponent offset
- Floor value: log(1) = 0 applied when mel energy is zero (prevents log(0))
- Output: 40 x 16-bit log-mel energies (Q8.8 fixed-point)
- Latency: ~80 cycles (~0.8 µs)

### 3.2.9 DCT Unit (dct_unit.sv)

Computes a Type-II Discrete Cosine Transform on the 40 log-mel energies, retaining only the first 10 coefficients (the MFCCs).

- DCT-II formula: MFCC[c] = sum(log_mel[m] * cos(pi * c * (m + 0.5) / 40)) for m = 0..39, c = 0..9
- Cosine coefficients: 40 x 10 = 400 entries stored in ROM (16-bit Q1.15 signed)
- Implementation: MAC-based sequential accumulator, processes one output coefficient at a time
- Output: 10 x 16-bit MFCC coefficients per frame (Q8.8 fixed-point)
- Latency: ~400 cycles (~4 µs)

### 3.2.10 MFCC Output Buffer (mfcc_out_buf.sv)

Accumulates MFCC vectors across time to build a complete feature frame for the DS-CNN model.

- Buffer size: 49 x 10 x 16-bit = 980 bytes (fits in single BRAM18)
- Write: DCT unit writes 10 coefficients per MFCC frame (every 20ms)
- Frame counter: tracks how many MFCC vectors have been accumulated (0–48)
- When counter reaches 49: asserts frame_ready signal to audio controller
- DMA drains buffer to DDR at feature_frame_base_addr (configured by CPU)
- Double-buffering: two 49x10 banks. While one is being DMA’d to DDR, the other accumulates new vectors. Banks swap when DMA completes.

### 3.2.11 Audio DMA (audio_dma.sv)

Lightweight DMA engine for transferring audio data (raw PCM or MFCC features) to DDR.

- 32-bit AXI4 Master interface (audio data rates are low; 128-bit not needed)
- Two modes: (a) MFCC mode — burst-write 49 x 10 x 16-bit = 490 halfwords = 245 words to DDR, (b) Passthrough mode — continuous streaming of raw PCM samples to DDR ring buffer
- Burst length: up to 64 beats per AXI transaction
- Base address and transfer length programmed by CPU via audio controller registers
- Completion: asserts dma_done signal to audio controller; controller raises interrupt to CPU

# 4. Audio Subsystem Register Map

All audio registers are accessible via AXI4-Lite from the RISC-V CPU. Base address: 0x2000_0500 (consistent with RISC-V subsystem peripheral address map — Audio Control Interface slot).

Offset | Register Name | R/W | Reset | Description
0x00 | AUDIO_CONTROL | R/W | 0x0 | Bit[0]: Audio subsystem enable. Bit[1]: Soft reset (self-clearing). Bit[2]: IRQ enable. Bit[3]: Mode (0 = MFCC pipeline, 1 = raw pass-through).
0x04 | AUDIO_STATUS | RO | 0x0 | Bit[0]: Pipeline busy. Bit[1]: FIFO overrun. Bit[2]: Feature frame ready. Bit[3]: DMA busy. Bit[4]: DMA done. Bits[15:8]: MFCC vector count (0–49).
0x08 | SAMPLE_RATE_DIV | R/W | 0x0 | Sample rate verification counter. Not used for I2S clocking (codec provides clock). Used for internal timing/debug.
0x0C | FIFO_STATUS | RO | 0x0 | Bits[9:0]: FIFO fill level (0–1024). Bit[10]: FIFO full. Bit[11]: FIFO empty. Bit[12]: FIFO overrun (sticky, cleared by writing AUDIO_CONTROL soft reset).
0x10 | MFCC_CONFIG | R/W | 0x0 | Bits[5:0]: Number of mel filters (default 40). Bits[9:6]: Number of MFCC coefficients to keep (default 10). Bits[15:10]: Feature frame depth (default 49). Matches ARM DS-CNN --dct_coefficient_count 10.
0x14 | WINDOW_CONFIG | R/W | 0x0 | Bits[10:0]: Frame size in samples (default 640). Bits[21:11]: Frame stride in samples (default 320). Matches ARM --window_size_ms 40, --window_stride_ms 20.
0x18 | FFT_CONFIG | R/W | 0x0 | Bits[3:0]: FFT size as log2 (default 10 = 1024-point). Bits[7:4]: Reserved.
0x1C | DMA_BASE_ADDR | R/W | 0x0 | DDR base address for MFCC feature frame DMA write (or raw PCM ring buffer base in pass-through mode).
0x20 | DMA_LENGTH | R/W | 0x0 | Transfer length in bytes. MFCC mode: auto-calculated from frame config. Pass-through: ring buffer size.
0x24 | DMA_WR_PTR | RO | 0x0 | Current DMA write pointer (DDR address). Useful for pass-through ring buffer tracking.
0x28 | GAIN_CONTROL | R/W | 0x100 | Bits[15:0]: Digital gain (Q8.8 fixed-point). 0x100 = unity gain. Applied to raw PCM samples before MFCC pipeline.
0x2C | NOISE_FLOOR | R/W | 0x0 | Bits[15:0]: Noise floor threshold (16-bit unsigned). Frames below this energy are skipped (simple VAD gate).
0x30 | START | WO | — | Write 0x1 to begin continuous MFCC processing. Write 0x0 to stop after current frame. Self-clearing.
0x34 | IRQ_CLEAR | WO | — | Write 0x1 to clear AUDIO_FRAME_READY interrupt. Write 0x2 to clear DMA_DONE interrupt.
0x38 | PERF_CYCLES | RO | 0x0 | Cycle count for last complete MFCC pipeline execution (window through DCT). Cleared on START.
0x3C | FRAME_ENERGY | RO | 0x0 | 32-bit total energy of last processed frame (sum of power spectrum). Used for VAD decision in firmware.

# 5. CPU-Audio Execution Flow

## 5.1 Wake-Word Detection Sequence

Step | CPU Action | Audio Subsystem Response
1 | Write MFCC_CONFIG (40 mel, 10 coeff, 49 depth) | Registers latched in audio controller. Matches ARM DS-CNN training params.
2 | Write WINDOW_CONFIG (640 frame, 320 stride) | Windowing parameters configured to match ARM model
3 | Write DMA_BASE_ADDR (DDR MFCC buffer addr) | DMA target address configured
4 | Write AUDIO_CONTROL (enable=1, mode=0, irq=1) | I2S receiver begins capturing samples to FIFO
5 | Write 0x1 to START | Pipeline begins: waits for 400 FIFO samples, then runs MFCC continuously
6 | WFI (wait for interrupt) | Pipeline processes frames every 20ms. After 49 vectors (~1 sec): DMA to DDR, IRQ asserted.
7 | Read AUDIO_STATUS (frame_ready=1) | CPU confirms feature frame is in DDR
8 | Program NPU for DS-CNN inference | NPU reads MFCC tensor from DDR, runs DS-CNN layers
9 | Wait for NPU done interrupt | NPU completes; CPU reads classification result
10 | If wake-word detected: act on it | Audio subsystem continues accumulating next frame automatically
11 | Write 0x1 to IRQ_CLEAR | Interrupt cleared. Audio subsystem already filling next frame bank (double-buffer).

## 5.2 Raw Pass-Through Mode (Speech Streaming)

When the user speaks after wake-word detection, the CPU switches the audio subsystem to pass-through mode to stream raw PCM to DDR for mobile phone offload.

// Switch to pass-through mode for speech capture

audio_write_reg(AUDIO_CONTROL, 0x0); // Disable (stop MFCC)

audio_write_reg(DMA_BASE_ADDR, DDR_PCM_RING_BASE);

audio_write_reg(DMA_LENGTH, PCM_RING_SIZE); // e.g., 64KB ring buffer

audio_write_reg(AUDIO_CONTROL, 0x0D); // Enable + mode=passthrough + IRQ

audio_write_reg(START, 0x1); // Begin streaming

// CPU reads DMA_WR_PTR periodically to track ring buffer fill

// BLE/Wi-Fi module reads PCM from DDR and sends to mobile phone

# 6. Audio Subsystem Memory Architecture

## 6.1 On-Chip Buffer Sizes

Buffer | Size | Implementation | Notes
Audio FIFO | 2 KB | BRAM (1 x BRAM18) | 1024 x 16-bit. ~64ms at 16 kHz.
Hamming Window ROM | 1.3 KB | BRAM or LUT ROM | 640 x 16-bit coefficients
FFT Working Memory | 4 KB | BRAM (2 x BRAM18) | 1024 x 32-bit complex (16-bit Re + 16-bit Im)
Twiddle Factor ROM | 2 KB | BRAM (1 x BRAM18) | 512 x 32-bit complex coefficients
Power Spectrum Buffer | 2 KB | BRAM | 513 x 32-bit unsigned
Mel Filter Coeff ROM | ~3 KB | BRAM (2 x BRAM18) | 40 filters x variable length; stored as (bin_idx, weight) pairs
Mel Energy Buffer | 160 B | Registers/LUT | 40 x 32-bit accumulator values
Log LUT | 0.5 KB | LUT ROM | 256 x 16-bit log values
DCT Cosine ROM | 0.8 KB | BRAM or LUT ROM | 400 entries (40 x 10) x 16-bit
MFCC Output Buffer | 2 KB | BRAM (1 x BRAM18) | 2 banks x (49 x 10 x 16-bit) for double-buffering
Total On-Chip | ~18 KB | 8–10 BRAM18 blocks | Lightweight; ~3–4% of Z7-20 BRAM

## 6.2 DDR Memory Map (Audio Regions)

Audio DDR regions are within the INPUTS area defined in the Phase 0 Simulation Validation Plan (base 0x0100_0000).

Region | Base Address | Size | Contents
MFCC Feature Buffer A | 0x0100_0000 | 1 KB | Current MFCC feature frame (49 x 10 x 16-bit = 980 bytes)
MFCC Feature Buffer B | 0x0100_0400 | 1 KB | Previous frame (for NPU to read while A fills)
PCM Ring Buffer | 0x0100_1000 | 64 KB | Raw PCM streaming buffer (ring, for mobile offload)
Audio Debug Buffer | 0x0100_F000 | 4 KB | Debug: raw FFT output, mel energies, intermediate values

# 7. AXI Interface Specification

Interface | Type | Width | Connected To
s_axi_lite | AXI4-Lite Slave | 32-bit | RISC-V CPU via AXI-Lite peripheral fabric (base 0x2000_0500)
m_axi_dma | AXI4 Master | 32-bit | DDR Controller via AXI interconnect (audio DMA writes)
irq_audio_ready | Output Signal | 1-bit | Interrupt Controller (IRQ aggregator, bit 3)
i2s_sck_i | Input Signal | 1-bit | External I2S codec bit clock (512 kHz)
i2s_ws_i | Input Signal | 1-bit | External I2S codec word select / LRCK (16 kHz)
i2s_sd_i | Input Signal | 1-bit | External I2S codec serial data input
clk / rst_n | Clock / Reset | 1-bit each | SoC global clock (100 MHz) and active-low reset

## 7.1 Audio DMA AXI4 Parameters

- AXI4 data width: 32-bit (4 bytes per beat)
- Max burst length: 64 beats (AWLEN = 63)
- Burst type: INCR (incrementing address)
- Outstanding transactions: 1 write transaction at a time (audio is low bandwidth)
- Address alignment: all DMA transfers aligned to 4-byte boundary
- AXI ID: 4'b1100 (distinguishes audio DMA from NPU DMA and CPU)

# 8. RTL Module Hierarchy

Each module maps to a single SystemVerilog file. The hierarchy enables independent unit testing of each pipeline stage.

audio_subsys_top.sv // Top-level wrapper + AXI port declarations

├── audio_controller.sv // Pipeline FSM, register decode, sequencer

├── audio_regfile.sv // AXI4-Lite slave + register file

├── i2s_rx.sv // I2S slave receiver (deserializer)

│ └── i2s_sync.sv // I2S clock domain crossing (SCK → sys_clk)

├── audio_fifo.sv // 1024 x 16-bit synchronous circular FIFO

├── audio_window.sv // Frame extraction + Hamming window multiply

│ └── hamming_rom.sv // 640-entry Hamming coefficient ROM

├── fft_engine.sv // 1024-point radix-2 DIT FFT

│ ├── fft_butterfly.sv // Single radix-2 butterfly unit

│ ├── fft_twiddle_rom.sv // 256-entry complex twiddle factor ROM

│ └── fft_addr_gen.sv // Bit-reversal + stage address generator

├── power_spectrum.sv // |X(k)|^2 = Re^2 + Im^2

├── mel_filterbank.sv // 40 triangular mel-scale filters

│ └── mel_coeff_rom.sv // Filter coefficient ROM (start/center/end bins + weights)

├── log_compress.sv // LUT-based natural logarithm

│ └── log_lut_rom.sv // 256-entry log lookup table

├── dct_unit.sv // Type-II DCT (40 → 10 coefficients)

│ └── dct_coeff_rom.sv // 40 x 10 cosine coefficient ROM

├── mfcc_out_buf.sv // Double-buffered 49 x 10 MFCC accumulator

└── audio_dma.sv // 32-bit AXI4 master DMA for DDR writes

## 8.1 Recommended RTL Generation Sequence (Claude Agent)

# | Module | Dependencies | Unit Test Focus

1 | i2s_sync.sv | None | CDC synchronization, metastability
2 | i2s_rx.sv | i2s_sync | I2S protocol compliance, MSB-first deserialize, WS edge detection
3 | audio_fifo.sv | None | Full/empty flags, circular pointer, overrun behavior, fill_level accuracy
4 | hamming_rom.sv | None | Coefficient readback vs. golden Hamming values
5 | audio_window.sv | hamming_rom | 640-sample frame extraction, multiply accuracy, zero-pad to 1024
6 | fft_butterfly.sv | None | Single butterfly: complex multiply-add, bit-accurate vs. golden
7 | fft_twiddle_rom.sv | None | Coefficient readback, conjugate symmetry verification
8 | fft_addr_gen.sv | None | Bit-reversal permutation, stage addressing pattern
9 | fft_engine.sv | fft_butterfly, fft_twiddle_rom, fft_addr_gen | Full 1024-pt FFT vs. golden (numpy/scipy reference)
10 | power_spectrum.sv | None | Re^2 + Im^2 computation, overflow handling
11 | mel_coeff_rom.sv | None | Filter shape readback, frequency bin mapping
12 | mel_filterbank.sv | mel_coeff_rom | 40 filter outputs vs. golden (librosa reference)
13 | log_lut_rom.sv | None | LUT readback, log accuracy vs. floating-point reference
14 | log_compress.sv | log_lut_rom | Log of known values, zero-input floor, dynamic range
15 | dct_coeff_rom.sv | None | Cosine coefficient readback
16 | dct_unit.sv | dct_coeff_rom | 10-coefficient DCT vs. golden (scipy.fft.dct reference)
17 | mfcc_out_buf.sv | None | Double-buffer fill/swap, 49-vector frame tracking
18 | audio_dma.sv | None | AXI4 burst write, address increment, completion signal
19 | audio_regfile.sv | None | AXI-Lite register R/W, reset values, read-only enforcement
20 | audio_controller.sv | All above | Pipeline sequencing, mode switching, IRQ generation
21 | audio_subsys_top.sv | All above | Full integration, I2S-to-DDR end-to-end

# 9. I2S Receiver Detailed Specification

## 9.1 I2S Signal Timing

The I2S protocol uses three signals. The external codec is the clock master.

Signal | Direction | Description
I2S_SCK_I | Input | Serial bit clock. 512 kHz = 16 kHz x 2 ch x 16 bits. Audio data transitions on falling edge; sampled on rising edge.
I2S_WS_I | Input | Word Select / LRCK. Low = Left channel, High = Right channel. Transitions 1 SCK cycle before MSB of new word.
I2S_SD_I | Input | Serial data. MSB first. Data valid on rising edge of SCK. Left channel captured when WS is low.

## 9.2 I2S Receiver FSM (i2s_rx.sv)

State | Behavior
IDLE | Wait for WS falling edge (start of left channel). Reset bit counter to 0. Transition to CAPTURE_LEFT.
CAPTURE_LEFT | On each rising SCK edge, shift I2S_SD_I into 16-bit shift register (MSB first). Increment bit counter. After 16 bits, assert sample_valid with captured data. Transition to SKIP_RIGHT.
SKIP_RIGHT | Wait for WS rising edge (right channel). Count 16 SCK rising edges without capturing data (right channel discarded for mono). Transition to IDLE on next WS falling edge.

## 9.3 Clock Domain Crossing (i2s_sync.sv)

I2S signals (SCK, WS, SD) are asynchronous to sys_clk (100 MHz). The i2s_sync module provides:

- 2-FF synchronizer on all three I2S input signals
- Edge detector on synchronized SCK (rising edge detection for sampling)
- Edge detector on synchronized WS (falling/rising edge for channel identification)
- The I2S receiver FSM operates entirely in the sys_clk domain using the synchronized, edge-detected signals

Design note: Because sys_clk (100 MHz) is ~200x faster than I2S_SCK (512 kHz), the 2-FF synchronizer introduces negligible timing error. No FIFO-based CDC is needed.

# 10. FFT Engine Detailed Specification

## 10.1 Architecture

The FFT engine implements a 1024-point radix-2 decimation-in-time (DIT) algorithm using in-place computation. A single butterfly unit is time-multiplexed across all 512 butterfly operations per stage, iterating through 10 stages.

Parameter | Value
FFT Size (N) | 1024 points
Algorithm | Radix-2 DIT (Cooley-Tukey)
Stages | 10 (log2(1024))
Butterflies per stage | 512
Total butterflies | 5,120 (512 x 10)
Butterfly latency | 2 clock cycles (pipelined multiply + add)
Total latency | ~10,240 cycles + overhead (~102 µs at 100 MHz)
Data memory | Dual-port BRAM: 1024 x 32-bit (16-bit Re + 16-bit Im)
Twiddle ROM | 512 x 32-bit complex (quarter-wave symmetry exploited)
DSP usage | 4 DSP48 multipliers (shared butterfly unit)

## 10.2 Butterfly Unit (fft_butterfly.sv)

The butterfly unit performs the core DIT operation:

// Radix-2 DIT butterfly

// Inputs: A = X[p], B = X[q], W = twiddle factor W_N^k

// Outputs: X'[p] = A + W*B

// X'[q] = A - W*B

// Complex multiplication: W*B = (Wr*Br - Wi*Bi) + j(Wr*Bi + Wi*Br)

// Requires 4 multiplications and 2 additions

// Pipeline stage 1: 4 multiplications (4 DSP48s)

// prod_rr = Wr * Br

// prod_ii = Wi * Bi

// prod_ri = Wr * Bi

// prod_ir = Wi * Br

// Pipeline stage 2: additions

// WB_re = prod_rr - prod_ii

// WB_im = prod_ri + prod_ir

// out_p_re = A_re + WB_re

// out_p_im = A_im + WB_im

// out_q_re = A_re - WB_re

// out_q_im = A_im - WB_im

Overflow handling: Intermediate products are 32-bit (16x16). Final sums are right-shifted by 1 bit per stage (block floating-point scaling) to prevent overflow across 10 stages. Total scaling factor: 2^(-10) = 1/1024, which is the standard FFT normalization.

## 10.3 Address Generator (fft_addr_gen.sv)

Generates the memory read/write addresses for each butterfly in each stage.

- Stage s (0–9): butterfly pairs are separated by 2^s positions
- For stage s, butterfly k (0–511): p = (k >> s) << (s+1) | (k & ((1 << s) - 1)), q = p + (1 << s)
- Twiddle index: (k & ((1 << s) - 1)) << (9 - s)
- Input bit-reversal: before stage 0, data is written to bit-reversed addresses. Handled by a 10-bit bit-reverse function on the write address during loading.

## 10.4 FFT Controller FSM

State | Behavior
IDLE | Wait for start signal from audio controller. Transition to LOAD.
LOAD | Read 1024 windowed samples from audio_window output. Write to FFT BRAM at bit-reversed addresses (real part = sample, imag part = 0). After 1024 writes, transition to COMPUTE.
COMPUTE | Iterate: for stage = 0 to 9, for butterfly = 0 to 511. Each butterfly: read A and B from BRAM, read twiddle from ROM, compute butterfly, write results back. Transition to DONE after stage 9.
DONE | Assert fft_done signal. Wait for read-out by power_spectrum unit. Transition to IDLE.

# 11. Mel Filterbank Detailed Specification

## 11.1 Filter Configuration

The mel filterbank applies 40 overlapping triangular filters spaced on the mel frequency scale from 0 Hz to 8 kHz (Nyquist at 16 kHz sample rate).

- Mel scale conversion: mel(f) = 2595 * log10(1 + f/700)
- 40 filter center frequencies are linearly spaced in mel domain, then converted back to Hz
- Each filter is defined by three FFT bin indices: start_bin, center_bin, end_bin
- Triangular shape: linearly increases from start_bin to center_bin, linearly decreases from center_bin to end_bin

## 11.2 Coefficient ROM Format (mel_coeff_rom.sv)

Filter coefficients are stored as a sparse representation to save memory. Each filter entry contains:

Field | Width | Description
filter_id | 6-bit | Filter index (0–39)
start_bin | 9-bit | First FFT bin with non-zero weight
num_bins | 6-bit | Number of bins in this filter (typically 5–30)
weight[n] | 16-bit (Q0.16) | Triangular weight for each bin in range. Stored sequentially.

Total ROM size depends on filter overlap. Estimated ~1500–2000 coefficient entries. Stored in 2 BRAM18 blocks.

## 11.3 Computation FSM

State | Behavior
IDLE | Wait for power_spectrum_done signal. Transition to FILTER_LOOP.
FILTER_LOOP | For each filter (0–39): read start_bin and num_bins from ROM. Initialize accumulator to 0. Transition to BIN_LOOP.
BIN_LOOP | For each bin in filter range: read power_spectrum[bin] and weight[bin] from ROM. Accumulate: mel_energy[f] += power[bin] * weight[bin]. After last bin, store mel_energy[f], advance to next filter.
DONE | All 40 filter energies computed. Assert mel_done signal. Transition to IDLE.

# 12. FPGA Resource Estimate

Estimated resource utilization for the Audio Subsystem on Zynq Z7-20. Does not include RISC-V or NPU subsystems.

Resource | Estimate | Z7-20 Total | Headroom (with RISC-V + NPU)
DSP48 | 4–6 | 220 | ~5 remaining (~97% used by NPU + RISC-V + Audio combined)
BRAM18 | 8–10 | 280 | ~45% remaining after RISC-V (~36%) + NPU (~14%) + Audio (~4%)
LUT | 3K–5K | 85K | ~55% remaining
FF | 2K–3K | 106K | ~85% remaining
Target Fmax | 100 MHz | N/A | Matches RISC-V system clock domain

DSP48 note: The FFT butterfly uses 4 DSP48s. Combined with NPU (64–80 DSP48s) and RISC-V (3–4 DSP48s), total DSP usage is ~72–90 out of 220 on Z7-20. This is comfortable. If DSP pressure becomes an issue, the butterfly can be time-multiplexed to use 2 DSP48s at half the throughput (still well within the 20ms frame budget).

# 13. ASIC Migration Notes — Phase 1 (180nm Test Chip 2A)

The Audio Subsystem maps to Chip 2A (Audio DSP + ADC) in the Phase 1 ASIC tape-out at SCL Mohali. The digital MFCC pipeline RTL is identical; the primary change is the addition of an on-chip ADC replacing the external I2S codec.

Item | FPGA (Phase 0) | ASIC 180nm (Phase 1 — Chip 2A)
Audio Input | External I2S codec on eval board | On-chip 2-channel ADC (12-bit, 48 kHz max) with PGA
I2S Interface | I2S slave receiver (codec provides clock) | I2S removed; direct ADC digital output to audio FIFO
MFCC Pipeline | Identical RTL | Identical RTL; clock target 200–300 MHz
BRAM / SRAM | Xilinx BRAM inference | SCL Mohali SRAM compiler
FFT DSP | DSP48 primitives | Standard cell synthesized multipliers
Target Die Area | N/A | ~2x2 mm (Chip 2A, includes test pads)
Additional Blocks | None | Beamforming DSP (2-mic), VAD hardware, noise cancellation

Phase 2 (28nm) additions: Multi-microphone beamforming (4-mic array), hardware VAD with adaptive threshold, noise cancellation DSP, and audio DAC output path (Chip 2B functionality integrated into main SoC).

# 14. Simulation and Verification Plan

## 14.1 Golden Reference Models

Each MFCC pipeline stage requires a bit-accurate golden reference model for verification. These are implemented in Python using standard libraries.

Stage | Reference Tool | Verification Method
I2S Receiver | Custom Python I2S stimulus generator | Generate .wav → I2S bitstream file → feed to RTL sim → compare deserialized PCM
Windowing | numpy (hamming window) | Compare RTL output vs. numpy windowed signal (bit-accurate Q1.15)
FFT | numpy.fft.fft | Compare RTL complex output vs. numpy FFT (allow ±1 LSB for fixed-point rounding)
Power Spectrum | numpy (|X|^2) | Exact match (squaring is deterministic)
Mel Filterbank | librosa.filters.mel | Compare RTL filter outputs vs. librosa reference (allow ±2 LSB)
Log Compression | numpy.log | Compare vs. floating-point log, verify error < 1% (LUT approximation)
DCT | scipy.fft.dct(type=2) | Compare 10 MFCC coefficients vs. scipy reference (allow ±2 LSB)
End-to-End | librosa.feature.mfcc | Full pipeline: .wav input → MFCC output vs. librosa MFCC (correlation > 0.99)

## 14.2 Unit-Level Tests

Module | Key Tests
i2s_rx | I2S protocol timing, MSB-first deserialization, left-channel-only capture, WS edge cases
audio_fifo | Fill/drain cycles, overrun behavior, fill_level accuracy, pointer wrap-around
audio_window | Frame extraction with correct overlap (stride=160), Hamming multiply accuracy, zero-padding
fft_engine | Known input (pure sine at bin frequency): verify single-bin peak. Random input: verify vs. numpy FFT. Overflow: verify scaling.
power_spectrum | Known complex input: verify |X|^2. All-zero input. Max-value input (overflow check).
mel_filterbank | Single filter activation: inject power only in one filter's range. All filters: verify vs. librosa.
log_compress | log(1)=0, log(large)=correct, log(0)=floor value. LUT accuracy sweep.
dct_unit | Known input (unit impulse): verify cosine basis output. Full 40-input vector: verify vs. scipy.
mfcc_out_buf | 49-vector fill, frame_ready assertion, double-buffer swap, DMA drain.
audio_dma | AXI4 burst write, address increment, completion signal, back-to-back transfers.

## 14.3 Subsystem Integration Tests

Test | Description
I2S to FIFO | Feed I2S bitstream, verify PCM samples appear in FIFO with correct values and timing.
FIFO to MFCC (single frame) | Pre-load FIFO with 400 known samples. Run pipeline. Compare 10 MFCC coefficients to golden.
Continuous MFCC (49 frames) | Stream ~1 second of audio via I2S. Verify 49 MFCC vectors accumulated. Verify frame_ready interrupt.
MFCC to DDR via DMA | Complete feature frame. Verify DMA writes correct data to DDR model at correct address.
Pass-Through Mode | Switch to mode=1. Verify raw PCM samples stream to DDR ring buffer via DMA.
Mode Switch | Start in MFCC mode, switch to pass-through mid-stream, verify clean transition.
CPU Integration | CPU programs all audio registers, starts pipeline, receives interrupt, reads status. Full firmware loop.
NPU Handoff | Audio subsystem fills DDR with MFCC tensor. CPU programs NPU to read it. Verify NPU receives correct data.

# 15. Top-Level Port List (audio_subsys_top.sv)

Port | Width | Dir | Description
clk_i | 1 | I | System clock (100 MHz FPGA / 200+ MHz ASIC)
rst_ni | 1 | I | Active-low system reset (asynchronous assert, synchronous deassert)
i2s_sck_i | 1 | I | I2S serial bit clock from external codec (512 kHz)
i2s_ws_i | 1 | I | I2S word select / LRCK from external codec (16 kHz)
i2s_sd_i | 1 | I | I2S serial data input from external codec
s_axi_lite_awaddr | 32 | I | AXI-Lite write address (from CPU peripheral fabric)
s_axi_lite_awvalid | 1 | I | AXI-Lite write address valid
s_axi_lite_awready | 1 | O | AXI-Lite write address ready
s_axi_lite_wdata | 32 | I | AXI-Lite write data
s_axi_lite_wstrb | 4 | I | AXI-Lite write byte strobes
s_axi_lite_wvalid | 1 | I | AXI-Lite write data valid
s_axi_lite_wready | 1 | O | AXI-Lite write data ready
s_axi_lite_bresp | 2 | O | AXI-Lite write response
s_axi_lite_bvalid | 1 | O | AXI-Lite write response valid
s_axi_lite_bready | 1 | I | AXI-Lite write response ready
s_axi_lite_araddr | 32 | I | AXI-Lite read address
s_axi_lite_arvalid | 1 | I | AXI-Lite read address valid
s_axi_lite_arready | 1 | O | AXI-Lite read address ready
s_axi_lite_rdata | 32 | O | AXI-Lite read data
s_axi_lite_rresp | 2 | O | AXI-Lite read response
s_axi_lite_rvalid | 1 | O | AXI-Lite read data valid
s_axi_lite_rready | 1 | I | AXI-Lite read data ready
m_axi_dma_aw* | various | O | AXI4 DMA write address channel (to DDR interconnect)
m_axi_dma_w* | various | O | AXI4 DMA write data channel
m_axi_dma_b* | various | I | AXI4 DMA write response channel
irq_audio_ready_o | 1 | O | Feature frame ready interrupt (to IRQ controller bit 3)

Open Items & Decisions Pending:

# | Open Item | Impact | Owner / Target

1 | MFCC in hardware vs. CPU firmware for Phase 0? | Hardware MFCC adds ~5K LUT but reduces CPU load to zero. Firmware MFCC saves FPGA area but CPU must compute 50 frames/sec. | Decide before RTL coding of fft_engine
2 | Audio DMA: shared with NPU DMA or independent? | Independent is simpler (separate AXI master). Shared saves interconnect ports. | Decide before audio_dma RTL
3 | VAD: hardware gate or firmware decision? | Hardware VAD (NOISE_FLOOR register) saves power by gating MFCC on silence. Firmware VAD is more flexible. | Decide before audio_controller FSM

## Resolved Decisions (v2)

- FFT size: RESOLVED — 1024-point (required to accommodate 640-sample / 40ms window for ARM DS-CNN compatibility)
- Mel filter count: RESOLVED — 40 filters (matches ARM DS-CNN training configuration)
- Wake-word phrase: RESOLVED — "Marvin" from Google Speech Commands dataset. Pre-trained DS-CNN-S model available from ARM ML-KWS-for-MCU repository. ~30–50 KB INT8 quantized weights, ~6 MMAC per inference, ~97% accuracy.
- MFCC parameters: RESOLVED — Aligned to ARM training: 40ms window, 20ms stride, 10 DCT coefficients, 40 mel filters, 49 frames per feature tensor (~1 second of audio).

— End of Audio Subsystem RTL Implementation Document —

AI Glasses SoC | Phase 0 FPGA → Phase 1 (180nm Chip 2A) | Version 2.0 (ARM DS-CNN aligned) | March 2026

Confidential — Page

Audio Subsystem RTL Implementation Document AI Glasses SoC — Phase 0
