anirudhr-adtech/AI_GLASSES/AI_Smart_Glasses_docs/Specs and Sub system implementation document/Camera_Vision_Subsystem_RTL_Implementation.docx

CAMERA / VISION SUBSYSTEM

RTL IMPLEMENTATION DOCUMENT

AI Glasses SoC — Phase 0 FPGA Prototype

Parallel Camera Interface | ISP-Lite | Frame Buffer | Video DMA | Crop Engine

Field | Value
Document Version | 1.0
Status | DRAFT — Architecture Lock
Phase | Phase 0 — FPGA Prototype
Author | Anirudh (Sole Architect)
Date | March 2026
ASIC Migration | Phase 1 — 180nm Test Vehicle (Chip 3: Camera ISP)
Companion Docs | NPU Subsystem Design Document, RISC-V Subsystem RTL Implementation, Audio Subsystem RTL Implementation, Phase 0 Data Path Architecture, Phase 0 Simulation Validation Plan

# 1. Overview

The Camera/Vision Subsystem captures image frames from an external camera sensor, performs lightweight image preprocessing (ISP-lite), manages frame buffers in DDR, and delivers preprocessed image tensors to the NPU for face recognition inference. It implements the complete front-end of Use Case 3 (Face Recognition) and also provides the Crop + Align post-processing required between the two NPU inference stages (BlazeFace detection → MobileFaceNet embedding).

The subsystem’s data path is: Camera sensor → Parallel/DVP interface capture → Pixel unpacking → Color space conversion (Bayer/YUV → RGB) → Resize/scale → DDR frame buffer write via Video DMA → CPU triggers NPU inference on completed frame. After BlazeFace produces bounding boxes, the Crop Engine extracts and aligns the face region from the DDR frame buffer and writes it back to DDR for MobileFaceNet.

## 1.1 Role in the System

- Captures raw image data from an external camera module via parallel DVP (8-bit) interface
- Performs color space conversion: Raw Bayer → RGB888, or YUV422 → RGB888
- Resizes image from native sensor resolution to NPU input size (128x128 for BlazeFace)
- Writes processed RGB frames to DDR frame buffer via Video DMA (128-bit AXI4)
- Provides double-buffered frame management so NPU reads one frame while camera writes the next
- Performs face crop + alignment after BlazeFace inference (reads bounding box from CPU, crops from full frame, resizes to 112x112 for MobileFaceNet)
- Raises interrupt to CPU when a frame is ready for NPU inference

## 1.2 What the Camera Subsystem Does NOT Do

- Does not run BlazeFace or MobileFaceNet inference — NPU handles all neural network compute
- Does not implement MIPI CSI-2 PHY in Phase 0 — uses parallel DVP interface on FPGA (CSI-2 requires analog DPHY, reserved for 28nm ASIC)
- Does not implement advanced ISP features (auto-exposure, auto-white-balance, HDR) — Phase 0 uses fixed-gain camera module with on-sensor AE/AWB
- Does not compute cosine similarity or identity decision — handled by RISC-V CPU in firmware
- Does not perform continuous video streaming — face recognition is a triggered, one-shot capture pipeline
- Does not implement video encoding (H.264/MJPEG) — not required for Phase 0

## 1.3 FPGA Camera Strategy: Parallel DVP vs. MIPI CSI-2

Phase 0 uses a parallel DVP (Digital Video Port) camera interface instead of MIPI CSI-2. This is a deliberate architectural choice:

Aspect | Parallel DVP (Phase 0) | MIPI CSI-2 (Phase 1 ASIC)
Physical Interface | 8-bit parallel data + PCLK + HSYNC + VSYNC | 2-lane differential serial (D-PHY)
FPGA Compatibility | Trivial — standard GPIO pins | Requires dedicated LVDS I/O banks or external deserializer chip
Camera Module | OV7670 / OV2640 (cheap, readily available) | OV5640 / IMX219 (common for MIPI)
Max Resolution | VGA (640x480) @ 30 FPS | 1080p+ @ 30 FPS
Phase 0 Need | 128x128 for BlazeFace (VGA is 25x overkill) | Not needed — sensor native resolution far exceeds NPU input
RTL Complexity | Low — simple shift register + counters | High — D-PHY PPI, lane merging, ECC, packet parsing
ASIC Migration | Replace DVP module with CSI-2 receiver; ISP-lite, frame buffer, DMA unchanged | Native implementation with DPHY hard macro

For FPGA prototyping, DVP eliminates the MIPI PHY problem entirely while exercising the same downstream pipeline (ISP-lite, frame buffer, DMA, NPU integration). The OV7670 camera module costs ~$3 and connects directly to Zynq FPGA GPIO pins.

## 1.4 Locked Architecture Parameters

Parameter | Decision | Rationale
Camera Interface | Parallel DVP (8-bit) | FPGA-friendly; no MIPI PHY needed; adequate resolution
Camera Module | OV7670 (VGA 640x480, 30 FPS) | Cheapest available; built-in AE/AWB; DVP output
Pixel Format (Sensor) | YUV422 (YUYV interleaved) | OV7670 default; easier to convert to RGB than raw Bayer
Pixel Format (Output) | RGB888 (24-bit per pixel) | NPU expects planar or packed RGB input tensors
ISP-Lite Pipeline | YUV422 → RGB888 → Bilinear Resize | Minimal ISP; sensor handles AE/AWB internally
NPU Input Size (BlazeFace) | 128 x 128 x 3 (RGB) | Standard BlazeFace input; 49,152 bytes per frame
NPU Input Size (MobileFaceNet) | 112 x 112 x 3 (RGB) | Standard MobileFaceNet input; 37,632 bytes per frame
Frame Buffer | Double-buffered in DDR | Ping-pong: camera writes one, NPU reads other
Video DMA Width | 128-bit AXI4 | Shared with NPU DMA master port on AXI interconnect
Frame Rate | 5–10 FPS (face recognition) | Triggered capture, not continuous 30 FPS streaming
Control Interface | AXI4-Lite (32-bit) | CPU register access consistent with all other peripherals
Target Clock (FPGA) | 100 MHz (logic), PCLK from camera | Logic at system clock; camera PCLK is ~24 MHz for VGA

# 2. Use Case Compute Requirements

## 2.1 Face Recognition Pipeline Timing

Stage | Latency | Notes
Camera frame capture | ~33 ms | One VGA frame at 30 FPS (only need 1 frame per trigger)
ISP-Lite (YUV→RGB + resize) | ~2 ms | Line-buffer based; pipeline overlaps with capture
Video DMA to DDR | ~1 ms | 128x128x3 = 49 KB at 6.4 GB/s DDR bandwidth
BlazeFace inference (NPU) | 100–150 ms | ~200–300 MMAC at ~6–8 GMAC/s sustained
Bounding box post-process (CPU) | < 1 ms | Parse output tensor, find max confidence box
Crop + Align + Resize | ~2 ms | Read face ROI from DDR, resize to 112x112, write back
MobileFaceNet inference (NPU) | ~150 ms | ~500–900 MMAC at ~6–8 GMAC/s sustained
Cosine similarity (CPU) | < 1 ms | 128-dim embedding dot product against enrolled faces
Total pipeline latency | ~300–340 ms | < 500 ms target; acceptable for smart glasses UX

## 2.2 Bandwidth Requirements

Data Path | Bandwidth | Notes
Camera DVP input | ~7.4 MB/s | 640x480 x 2 bytes (YUV422) x 30 FPS
ISP-lite output to DDR | ~1.4 MB/s | 128x128x3 bytes (RGB) x 5–10 FPS triggered
NPU DMA read (BlazeFace input) | ~49 KB/frame | Trivial single burst per inference
Crop engine DDR read | ~150 KB/frame | Read face ROI (variable size) from full frame
Crop engine DDR write | ~37 KB/frame | Write 112x112x3 cropped face
Peak DDR bandwidth used | < 10 MB/s | Camera is negligible vs. NPU DMA (~200 MB/s peak)

Camera bandwidth is trivially small. No DMA contention with NPU is expected during face recognition since the stages are sequential (camera captures before NPU runs).

# 3. Camera Subsystem Microarchitecture

## 3.1 Top-Level Block Diagram

CAMERA / VISION SUBSYSTEM — Top-Level Block View

┌────────────────────────────────────────────────────────────────┐

│ CAMERA / VISION SUBSYSTEM │

│ │

│ AXI4-Lite ──► Camera Controller ◄── IRQ Out │

│ (CPU regs) │ │

│ │ │

│ DVP: PCLK/VSYNC │ │

│ HSYNC/D[7:0] │ │

│ │ │ │

│ ▼ ▼ │

│ ┌────────────┐ ┌─────────────┐ │

│ │ DVP Capture │ │ Pixel FIFO │ │

│ │ (8-bit DVP) │─►│ (CDC + │ │

│ │ │ │ line buffer)│ │

│ └────────────┘ └──────┬──────┘ │

│ │ │

│ ▼ │

│ ┌──────────────────┐ │

│ │ ISP-Lite Pipeline │ │

│ │ │ │

│ │ YUV422 → RGB888 │ │

│ │ Bilinear Resize │ │

│ │ (640x480 → 128^2)│ │

│ └────────┬─────────┘ │

│ ▼ │

│ ┌──────────────────┐ │

│ │ Video DMA (128-bit)│──► DDR Frame Buffer │

│ └──────────────────┘ │

│ │ │

│ ▼ IRQ: frame_ready ─► CPU │

│ │

│ ┌────────────────────────────────────────────────────────┐ │

│ │ POST-NPU: Crop + Align Engine │ │

│ │ │ │

│ │ CPU writes bounding box → Crop Engine reads ROI from │ │

│ │ DDR frame buffer → Bilinear resize to 112x112 → │ │

│ │ Write cropped face to DDR → IRQ: crop_done │ │

│ └────────────────────────────────────────────────────────┘ │

└────────────────────────────────────────────────────────────────┘

## 3.2 Internal Block Descriptions

### 3.2.1 Camera Controller (cam_controller.sv)

Top-level orchestrator for the camera subsystem. Decodes CPU register configuration, sequences capture and ISP pipeline, manages frame buffer pointers, and generates interrupts.

- Decodes operating mode: single-shot capture, continuous capture, or crop-only mode
- Manages frame buffer double-buffering: tracks which DDR buffer is being written by DMA and which is available for NPU
- Sequences: arm capture → wait for VSYNC → enable pixel pipeline → wait for frame complete → trigger DMA drain → assert frame_ready IRQ
- In crop mode: receives bounding box coordinates from CPU registers, triggers crop engine, waits for crop_done, asserts crop_ready IRQ
- Updates STATUS register after each operation

### 3.2.2 DVP Capture Interface (dvp_capture.sv)

Captures raw pixel data from an OV7670 or compatible parallel camera module. The camera module provides pixel clock (PCLK), frame sync (VSYNC), line sync (HSYNC/HREF), and 8-bit parallel data.

- PCLK: camera-provided pixel clock (~24 MHz for VGA @ 30 FPS). Data is valid on rising edge of PCLK.
- VSYNC: active-high pulse marks the start of a new frame (OV7670 default polarity)
- HREF/HSYNC: active-high during valid pixel data on each line
- D[7:0]: 8-bit parallel pixel data bus. In YUV422 mode, two PCLK cycles per pixel: first cycle = Y (luminance), second cycle = U or V (chrominance), interleaved as YUYV
- DVP capture outputs 16-bit YUV422 pixel pairs (Y0+Cb, Y1+Cr) with a pixel_pair_valid strobe
- Frame and line counters track pixel position for downstream use

### 3.2.3 Pixel FIFO and CDC (pixel_fifo.sv)

Asynchronous FIFO bridging the PCLK domain (camera, ~24 MHz) to the sys_clk domain (100 MHz). This is a true clock-domain crossing, unlike the audio I2S case where the clock ratio was ~200x.

- Depth: 1024 entries x 16-bit (holds ~1.5 lines of YUV422 data; sufficient for ISP pipeline backpressure)
- Asynchronous FIFO: Gray-coded write/read pointers for safe CDC
- Write side: PCLK domain. Writes YUV422 pixel pairs from DVP capture.
- Read side: sys_clk domain. Read by ISP-lite pipeline at its own pace.
- Overflow protection: if FIFO fills (ISP stalls), oldest data is dropped. Frame corruption flag set in STATUS register.

### 3.2.4 ISP-Lite Pipeline (isp_lite.sv)

Minimal image signal processing: converts YUV422 to RGB888 and resizes from sensor resolution to NPU input size. Operates entirely in the sys_clk domain, reading from the pixel FIFO.

- Stage 1 — YUV422 to RGB888 conversion (yuv2rgb.sv): standard ITU-R BT.601 matrix multiply. 3 multipliers + 3 adders per pixel. Pipeline latency: 2 cycles.
- Stage 2 — Bilinear resize (resize_engine.sv): scales from 640x480 down to 128x128 (or 112x112 for crop path). Uses line-buffer BRAM for vertical interpolation. Horizontal interpolation is inline.
- Output: 8-bit R, G, B channels (24 bits per pixel) at the target resolution
- Bypass mode: raw YUV422 pass-through to DDR (for debug or streaming to mobile via BLE/Wi-Fi)

### 3.2.5 YUV-to-RGB Converter (yuv2rgb.sv)

Implements the ITU-R BT.601 color space conversion. The OV7670 outputs YUV422 (YUYV interleaved), where two adjacent pixels share U and V components.

// BT.601 YUV to RGB conversion (fixed-point Q8.8)

// R = Y + 1.402 * (V - 128)

// G = Y - 0.344 * (U - 128) - 0.714 * (V - 128)

// B = Y + 1.772 * (U - 128)

// Fixed-point coefficients (Q8.8, multiply then >> 8):

// 1.402 → 359 (0x167)

// 0.344 → 88 (0x058)

// 0.714 → 183 (0x0B7)

// 1.772 → 454 (0x1C6)

// Clamping: output R, G, B each clamped to [0, 255]

Each pixel requires 3 multiplies + 3 adds + 3 clamp operations. With pipelining, throughput is 1 pixel per clock cycle after 2-cycle pipeline fill.

### 3.2.6 Bilinear Resize Engine (resize_engine.sv)

Scales the image from source resolution (640x480) to target resolution (128x128 or 112x112) using bilinear interpolation. This block is the most complex in the ISP-lite pipeline.

- Horizontal scaling: for each output column, compute the fractional source position (src_x = out_x * scale_x). Interpolate between the two nearest source pixels.
- Vertical scaling: requires access to two adjacent source lines. A line buffer (dual-line BRAM) stores the current and previous source lines.
- Bilinear formula: out = (1-fx)*(1-fy)*P00 + fx*(1-fy)*P10 + (1-fx)*fy*P01 + fx*fy*P11, where fx/fy are fractional positions (Q0.8 fixed-point, 8-bit fraction)
- Scale factors: computed by CPU and written to ISP_SCALE_X / ISP_SCALE_Y registers (Q8.16 fixed-point). Example: 640→128 gives scale = 640/128 = 5.0 = 0x0005_0000.
- Line buffer: 2 lines x 640 pixels x 24-bit RGB = 3,840 bytes = 2 BRAM18 blocks
- Throughput: 1 output pixel per cycle (after line buffer fill). 128x128 output = 16,384 cycles = ~164 µs at 100 MHz.

### 3.2.7 Video DMA (video_dma.sv)

High-bandwidth DMA engine for transferring processed frames from the ISP-lite output to DDR frame buffers. Shared 128-bit AXI4 master port with the NPU DMA.

- 128-bit AXI4 Master interface (16 bytes per beat). Matches NPU DMA width for interconnect sharing.
- Packs ISP-lite output pixels (24-bit RGB → 32-bit RGBX, padded with 0x00) into 128-bit AXI words (4 pixels per beat)
- Burst length: up to 256 beats per AXI transaction (standard AXI4 maximum)
- Destination address programmed by CPU via FRAME_BUF_ADDR register (alternates between buffer A and B)
- Assertion: frame_dma_done signal when entire frame is written to DDR
- For 128x128 frame: 128*128*4 bytes = 64 KB. At 128-bit width, that is 4096 beats. With burst-256, 16 AXI transactions.

### 3.2.8 Crop Engine (crop_engine.sv)

Reads a rectangular region of interest (ROI) from a full DDR frame buffer, resizes it to MobileFaceNet input size (112x112), and writes the result back to DDR. This is the post-processing stage between BlazeFace and MobileFaceNet.

- Input: bounding box coordinates (x, y, width, height) from CPU registers (BlazeFace post-processed output)
- DDR read: issues AXI4 burst reads to fetch the ROI rows from the full frame buffer
- Resize: reuses the same bilinear interpolation logic as resize_engine (shared coefficients, different scale factors)
- DDR write: writes the cropped + resized 112x112x3 RGB face image to a separate DDR buffer (CROP_BUF_ADDR)
- The crop engine is triggered by a CPU register write (CROP_START) after CPU parses BlazeFace output
- Completion: asserts crop_done interrupt to CPU, which then programs NPU for MobileFaceNet

# 4. Camera Subsystem Register Map

All camera registers are accessible via AXI4-Lite from the RISC-V CPU. Base address: 0x2000_0400 (Camera Control Interface slot in the RISC-V peripheral address map).

Offset | Register Name | R/W | Reset | Description
0x00 | CAM_CONTROL | R/W | 0x0 | Bit[0]: Subsystem enable. Bit[1]: Soft reset (self-clearing). Bit[2]: Capture mode (0 = single-shot, 1 = continuous). Bit[3]: IRQ enable. Bit[4]: Crop engine enable.
0x04 | CAM_STATUS | RO | 0x0 | Bit[0]: Capture busy. Bit[1]: Frame ready (ISP + DMA complete). Bit[2]: Crop busy. Bit[3]: Crop done. Bit[4]: FIFO overrun. Bit[5]: DMA busy. Bits[15:8]: Frame counter (rolling 8-bit).
0x08 | SENSOR_CONFIG | R/W | 0x0 | Bits[1:0]: Pixel format (00=YUV422, 01=RGB565, 10=Raw Bayer). Bits[11:2]: Source width (default 640). Bits[21:12]: Source height (default 480).
0x0C | ISP_CONFIG | R/W | 0x0 | Bits[9:0]: Output width (default 128). Bits[19:10]: Output height (default 128). Bit[20]: Bypass mode (0=ISP on, 1=raw passthrough).
0x10 | ISP_SCALE_X | R/W | 0x0 | Q8.16 horizontal scale factor. CPU calculates: src_width / dst_width. Example: 640/128 = 5.0 = 0x0005_0000.
0x14 | ISP_SCALE_Y | R/W | 0x0 | Q8.16 vertical scale factor. CPU calculates: src_height / dst_height. Example: 480/128 = 3.75 = 0x0003_C000.
0x18 | FRAME_BUF_A_ADDR | R/W | 0x0 | DDR base address for frame buffer A (active write target).
0x1C | FRAME_BUF_B_ADDR | R/W | 0x0 | DDR base address for frame buffer B (ping-pong partner).
0x20 | ACTIVE_BUF | R/W | 0x0 | Bit[0]: 0 = write to buffer A / NPU reads B. 1 = write to buffer B / NPU reads A. CPU toggles after each frame.
0x24 | CAPTURE_START | WO | — | Write 0x1 to arm single-shot capture (waits for next VSYNC). In continuous mode, starts automatically.
0x28 | CROP_X | R/W | 0x0 | Bits[9:0]: Crop ROI X origin (pixel coordinate in output-resolution frame).
0x2C | CROP_Y | R/W | 0x0 | Bits[9:0]: Crop ROI Y origin.
0x30 | CROP_WIDTH | R/W | 0x0 | Bits[9:0]: Crop ROI width (pixels). Crop engine reads this many columns.
0x34 | CROP_HEIGHT | R/W | 0x0 | Bits[9:0]: Crop ROI height (pixels). Crop engine reads this many rows.
0x38 | CROP_OUT_WIDTH | R/W | 0x70 | Bits[9:0]: Crop output width after resize (default 112 = 0x70 for MobileFaceNet).
0x3C | CROP_OUT_HEIGHT | R/W | 0x70 | Bits[9:0]: Crop output height after resize (default 112).
0x40 | CROP_BUF_ADDR | R/W | 0x0 | DDR base address for cropped face output.
0x44 | CROP_START | WO | — | Write 0x1 to trigger crop + resize operation. Self-clearing.
0x48 | IRQ_CLEAR | WO | — | Write 0x1: clear frame_ready IRQ. Write 0x2: clear crop_done IRQ. Write 0x3: clear both.
0x4C | RAW_FRAME_ADDR | R/W | 0x0 | DDR base address for raw (full-resolution) frame storage. Used when crop engine needs to read from the un-resized frame.
0x50 | FRAME_SIZE_BYTES | RO | 0x0 | Auto-computed: output_width x output_height x 4 (RGBX). CPU can read to verify DMA transfer size.
0x54 | PERF_CAPTURE_CYC | RO | 0x0 | Cycle count for last frame capture (VSYNC to last pixel). Cleared on CAPTURE_START.
0x58 | PERF_ISP_CYC | RO | 0x0 | Cycle count for last ISP pipeline execution.
0x5C | PERF_CROP_CYC | RO | 0x0 | Cycle count for last crop + resize operation.

# 5. CPU-Camera Execution Flow

## 5.1 Full Face Recognition Pipeline

# | CPU Action | Camera / NPU / CPU Subsystem Response

1 | Configure camera registers | Write SENSOR_CONFIG (640x480, YUV422), ISP_CONFIG (128x128), ISP_SCALE_X/Y, FRAME_BUF_A/B_ADDR.
2 | Enable subsystem + arm capture | Write CAM_CONTROL (enable=1, single-shot, IRQ enable). Write CAPTURE_START = 1.
3 | WFI (wait for frame_ready IRQ) | Camera captures frame on next VSYNC. ISP converts + resizes. DMA writes 128x128 RGB to DDR. IRQ asserted.
4 | Program NPU for BlazeFace layer 0 | Write NPU registers: INPUT_ADDR = frame_buf_A, WEIGHT_ADDR, OUTPUT_ADDR, layer params.
5 | Run BlazeFace (all layers) | for each layer: npu_start() → WFI → chain output to next input. Total ~100–150 ms.
6 | Parse BlazeFace output (CPU) | CPU reads output tensor from DDR. Finds highest-confidence bounding box. < 1 ms.
7 | Program crop engine | Write CROP_X/Y/WIDTH/HEIGHT (bounding box coords). Write CROP_OUT = 112x112. Write CROP_BUF_ADDR.
8 | Trigger crop + resize | Write CROP_START = 1. Crop engine reads ROI from DDR frame, resizes to 112x112, writes to CROP_BUF_ADDR.
9 | WFI (wait for crop_done IRQ) | Crop engine completes. IRQ asserted. ~2 ms.
10 | Program NPU for MobileFaceNet | Write NPU registers: INPUT_ADDR = CROP_BUF_ADDR (cropped face). Load MobileFaceNet weights.
11 | Run MobileFaceNet (all layers) | for each layer: npu_start() → WFI. Total ~150 ms. Output: 128-dim embedding vector.
12 | Cosine similarity (CPU) | CPU reads embedding from DDR. Computes dot product against enrolled face database. < 1 ms.
13 | Identity decision (CPU) | If similarity > threshold: recognized. Trigger action (e.g., unlock, greet). Else: unknown face.
14 | Clear IRQs, swap buffers | Write IRQ_CLEAR. Toggle ACTIVE_BUF for next capture cycle.

## 5.2 Face Recognition Firmware (Pseudocode)

void face_recognition_trigger() {

// 1. Capture frame

cam_write_reg(CAPTURE_START, 1);

wfi(); // Wait for frame_ready IRQ

// 2. BlazeFace: face detection

load_model_to_DDR(blazeface_weights, DDR_WEIGHTS_BASE);

for (int L = 0; L < blazeface_num_layers; L++) {

npu_program_layer(&blazeface_layers[L]);

npu_start();

wfi(); // NPU done IRQ

}

bbox_t face = cpu_parse_detection(DDR_OUTPUT_BASE);

// 3. Crop + Align

if (face.confidence > DETECT_THRESHOLD) {

cam_write_reg(CROP_X, face.x);

cam_write_reg(CROP_Y, face.y);

cam_write_reg(CROP_WIDTH, face.w);

cam_write_reg(CROP_HEIGHT, face.h);

cam_write_reg(CROP_START, 1);

wfi(); // crop_done IRQ

// 4. MobileFaceNet: face embedding

load_model_to_DDR(mobilefacenet_weights, DDR_WEIGHTS_BASE);

for (int L = 0; L < mfn_num_layers; L++) {

npu_program_layer(&mfn_layers[L]);

npu_start();

wfi();

}

int8_t *embedding = (int8_t *)DDR_OUTPUT_BASE;

// 5. Identity match

int match_id = cpu_cosine_similarity(embedding, enrolled_db);

if (match_id >= 0) {

uart_printf("Recognized: %s\n", enrolled_names[match_id]);

}

}

}

# 6. DVP Capture Interface Detailed Specification

## 6.1 DVP Signal Definitions

Signal | Width | Direction | Description
cam_pclk_i | 1 | Input | Pixel clock from camera module (~24 MHz for VGA@30FPS). Data valid on rising edge.
cam_vsync_i | 1 | Input | Vertical sync. Active-high pulse at start of frame (OV7670 default). Duration: ~3 lines.
cam_href_i | 1 | Input | Horizontal reference. High during valid pixel data within a line. Low during horizontal blanking.
cam_data_i | 8 | Input | Pixel data bus. In YUV422 mode: Y0, U0, Y1, V0, Y2, U2, Y3, V2... (YUYV interleaved).

## 6.2 DVP Capture FSM (dvp_capture.sv)

State | Behavior
IDLE | Wait for cam_vsync_i rising edge (start of new frame). Reset line counter and pixel counter. Transition to WAIT_HREF.
WAIT_HREF | Wait for cam_href_i to go high (start of active line). If cam_vsync_i goes low then high again (new frame while waiting), reset counters. Transition to CAPTURE_LINE when HREF asserts.
CAPTURE_LINE | On each rising edge of cam_pclk_i while cam_href_i = 1: latch cam_data_i[7:0] into shift register. Toggle byte counter (0 or 1). When byte counter = 1, a complete YUV pixel pair is ready: output 16-bit {byte0, byte1} with pixel_pair_valid strobe. Increment pixel counter. When cam_href_i deasserts: increment line counter. Transition to WAIT_HREF.
FRAME_DONE | When line counter reaches source_height: assert frame_captured signal. Transition to IDLE. Camera controller latches frame metadata.

## 6.3 Clock Domain Crossing

cam_pclk_i (~24 MHz) is asynchronous to sys_clk (100 MHz). The pixel_fifo implements a true asynchronous FIFO with Gray-coded pointers. This is different from the Audio subsystem’s approach (which used a simple 2-FF synchronizer) because the camera’s PCLK-to-sys_clk ratio is only ~4:1, too close for 2-FF synchronizer-based edge detection to be reliable.

Aspect | Audio (I2S → sys_clk) | Camera (PCLK → sys_clk)
Source clock | 512 kHz | ~24 MHz
Sys_clk / source ratio | ~200:1 | ~4:1
CDC method | 2-FF synchronizer + edge detect | Asynchronous FIFO (Gray-coded)
Rationale | Huge frequency ratio = no metastability risk | Small ratio = must use proper async FIFO

# 7. ISP-Lite Pipeline Detailed Specification

## 7.1 Pipeline Stages

Stage | Module | Latency | Description
1 | yuv2rgb.sv | 2 cycles | YUV422 → RGB888 color conversion. BT.601 matrix multiply. 3 DSP multipliers.
2 | resize_engine.sv | Variable | Bilinear resize. Line-buffered. Throughput: 1 output pixel/cycle after fill.
Output | pixel_packer.sv | 1 cycle | Packs 24-bit RGB into 32-bit RGBX for DMA alignment. Accumulates 4 pixels into 128-bit words.

## 7.2 Resize Engine Architecture (resize_engine.sv)

The resize engine is parameterizable for any scale factor. It is used twice: once in the ISP-lite path (640x480 → 128x128) and once in the crop engine (variable ROI → 112x112).

### 7.2.1 Horizontal Interpolation

For each output pixel at column out_x, the engine computes the fractional source position:

src_x_fp = out_x * scale_x; // Q8.16 fixed-point

src_x_int = src_x_fp >> 16; // Integer part (left neighbor)

frac_x = (src_x_fp >> 8) & 0xFF; // Fractional part (Q0.8)

// Linear interpolation between two horizontal neighbors

h_interp = P_left * (256 - frac_x) + P_right * frac_x;

h_interp = h_interp >> 8; // Normalize back to 8-bit

### 7.2.2 Vertical Interpolation

Vertical interpolation requires two source lines. A dual-line buffer stores the most recent two lines that the output row maps to.

src_y_fp = out_y * scale_y;

src_y_int = src_y_fp >> 16;

frac_y = (src_y_fp >> 8) & 0xFF;

// Bilinear: combine horizontal results from two lines

out_pixel = h_line_top * (256 - frac_y) + h_line_bot * frac_y;

out_pixel = out_pixel >> 8;

Line buffer management: When src_y_int advances (new output row maps to a new source line pair), the engine signals the pixel FIFO to drain source pixels until the required line is available. The line buffer holds 2 lines x src_width x 3 bytes (RGB). For 640-pixel source: 2 x 640 x 3 = 3,840 bytes = 2 BRAM18.

### 7.2.3 Resize FSM

State | Behavior
IDLE | Wait for start signal (ISP-lite: frame capture begins; crop: CROP_START). Load scale factors from registers. Reset output counters. Transition to FILL_LINE_BUF.
FILL_LINE_BUF | Read source pixels from pixel FIFO (ISP path) or DDR (crop path) into line buffer BRAM. Fill until two lines needed by the first output row are ready. Transition to GENERATE_ROW.
GENERATE_ROW | For each output column (0 to out_width-1): compute src_x, perform horizontal interp on both buffered lines, then vertical interp. Output one RGB pixel per cycle. After last column, increment out_y. Check if next row needs new source line.
ADVANCE_LINE | If next output row needs a new source line (src_y_int changed): shift line buffer (line_top = line_bot, fill new line_bot from source). Transition back to GENERATE_ROW.
DONE | After last output row: assert resize_done signal. Transition to IDLE.

# 8. Crop Engine Detailed Specification

The crop engine is a DMA-driven block that reads a rectangular ROI from DDR, resizes it, and writes the result back to DDR. It is used between BlazeFace and MobileFaceNet in the face recognition pipeline.

## 8.1 Operation Sequence

1. CPU writes CROP_X, CROP_Y, CROP_WIDTH, CROP_HEIGHT (bounding box from BlazeFace output)
2. CPU writes CROP_OUT_WIDTH=112, CROP_OUT_HEIGHT=112 (MobileFaceNet input size)
3. CPU writes CROP_BUF_ADDR (DDR destination for cropped face)
4. CPU writes CROP_START = 1
5. Crop engine calculates source DDR addresses: for each source row in the ROI, row_addr = RAW_FRAME_ADDR + (CROP_Y + row) * frame_stride + CROP_X * bytes_per_pixel
6. DMA reads ROI rows from DDR into line buffer (one or two rows at a time for bilinear)
7. Resize logic (shared with resize_engine) scales ROI to 112x112
8. DMA writes resized output to CROP_BUF_ADDR in DDR
9. Assert crop_done signal → camera controller asserts crop_done IRQ to CPU

## 8.2 Port List (crop_engine.sv)

Port | Width | Dir | Description
clk_i / rst_ni | 1 each | I | System clock and active-low reset
crop_start_i | 1 | I | Trigger from camera controller (pulse)
crop_done_o | 1 | O | Completion signal to camera controller
crop_x_i | 10 | I | ROI X origin (pixel)
crop_y_i | 10 | I | ROI Y origin (pixel)
crop_w_i | 10 | I | ROI width (pixels)
crop_h_i | 10 | I | ROI height (pixels)
crop_out_w_i | 10 | I | Output width after resize (112)
crop_out_h_i | 10 | I | Output height after resize (112)
raw_frame_addr_i | 32 | I | DDR base address of source frame
frame_stride_i | 16 | I | Source frame row stride in bytes
crop_buf_addr_i | 32 | I | DDR destination address for cropped output
m_axi_ar* | various | O | AXI4 read address channel (DDR read)
m_axi_r* | various | I | AXI4 read data channel
m_axi_aw* | various | O | AXI4 write address channel (DDR write)
m_axi_w* | various | O | AXI4 write data channel
m_axi_b* | various | I | AXI4 write response channel

# 9. Camera Subsystem Memory Architecture

## 9.1 On-Chip Buffers

Buffer | Size | Implementation | Notes
Pixel FIFO (async) | 2 KB | BRAM (1x BRAM18) | 1024 x 16-bit. Gray-coded async FIFO. ~1.5 lines of YUV422.
ISP Line Buffer | 3.8 KB | BRAM (2x BRAM18) | 2 lines x 640 x 3 bytes (RGB). For bilinear vertical interpolation.
Crop Line Buffer | 1.4 KB | BRAM (1x BRAM18) | 2 lines x max_crop_width x 3 bytes. Shared or separate from ISP.
Pixel Packer Buffer | 128 B | Registers | Accumulates 4x 32-bit RGBX pixels into 128-bit AXI word.
YUV2RGB Pipe Regs | ~50 B | Registers | Pipeline registers for color conversion multipliers.
Total On-Chip | ~8 KB | 4–5 BRAM18 | Very lightweight. ~1.5–2% of Z7-20 BRAM.

## 9.2 DDR Memory Map (Camera Regions)

Camera DDR regions are within the FRAME BUFFER area defined in the NPU subsystem DDR memory map (base 0x0400_0000).

Region | Base Address | Size | Contents
Frame Buffer A | 0x0400_0000 | 64 KB | 128x128x4 RGBX processed frame (BlazeFace input)
Frame Buffer B | 0x0401_0000 | 64 KB | Ping-pong partner frame buffer
Raw Frame Buffer | 0x0402_0000 | 1.2 MB | 640x480x4 RGBX full-resolution frame (for crop engine source)
Crop Output Buffer | 0x0420_0000 | 48 KB | 112x112x4 RGBX cropped face (MobileFaceNet input)
Camera Debug Buffer | 0x0430_0000 | 64 KB | Debug: raw YUV, ISP intermediate, timing data

Important: The crop engine reads from the Raw Frame Buffer (full 640x480), not from the resized 128x128 Frame Buffer A/B. This is because BlazeFace detection runs on the 128x128 image, but the face crop should be extracted from the highest available resolution to preserve face detail. The CPU must scale the BlazeFace bounding box coordinates from 128x128 space back to 640x480 space before programming the crop engine.

# 10. AXI Interface Specification

Interface | Type | Width | Connected To
s_axi_lite | AXI4-Lite Slave | 32-bit | RISC-V CPU via AXI-Lite peripheral fabric (base 0x2000_0400)
m_axi_vdma | AXI4 Master | 128-bit | DDR Controller via AXI interconnect (video DMA writes + crop reads/writes)
irq_camera_ready_o | Output Signal | 1-bit | Interrupt Controller bit 2 (frame_ready OR crop_done)
cam_pclk_i | Input Signal | 1-bit | External camera pixel clock (~24 MHz)
cam_vsync_i | Input Signal | 1-bit | External camera vertical sync
cam_href_i | Input Signal | 1-bit | External camera horizontal reference
cam_data_i | Input Signal | 8-bit | External camera parallel pixel data

## 10.1 Video DMA AXI4 Parameters

- AXI4 data width: 128-bit (16 bytes per beat). Same as NPU DMA for interconnect sharing.
- Max burst length: 256 beats (AWLEN = 255). Full AXI4 spec maximum.
- Burst type: INCR (incrementing address)
- Outstanding transactions: up to 2 (write pipeline: ISP frame write + crop read can overlap)
- Address alignment: all transfers aligned to 16-byte boundary (128-bit natural alignment)
- AXI ID: 4'b1101 (distinguishes camera DMA from NPU DMA 4'b10xx and audio DMA 4'b1100)
- Write strobes: all bytes valid (wstrb = 16'hFFFF) since pixel packer ensures full-width words

## 10.2 DMA Sharing with NPU

The Video DMA and NPU DMA share the AXI4 interconnect to DDR. They are NOT expected to be active simultaneously in the face recognition pipeline because the stages are sequential: camera captures → NPU runs BlazeFace → crop engine runs → NPU runs MobileFaceNet. However, if continuous capture mode is enabled while NPU is running, the AXI arbiter provides fair round-robin arbitration between both masters. DMA priority: NPU M2 > Camera M3 (NPU has tighter latency requirements during active inference).

# 11. RTL Module Hierarchy

Each module maps to a single SystemVerilog file. The hierarchy is organized into capture path, processing path, DMA path, and control.

cam_subsys_top.sv // Top-level wrapper + port declarations

├── cam_controller.sv // Pipeline FSM, register decode, IRQ generation

├── cam_regfile.sv // AXI4-Lite slave + register file (24 registers)

├── dvp_capture.sv // Parallel DVP camera interface (8-bit capture)

│ └── dvp_sync.sv // Input synchronization (2-FF on PCLK-domain signals)

├── pixel_fifo.sv // Asynchronous FIFO (PCLK → sys_clk CDC)

│ └── gray_counter.sv // Gray-code counter for async FIFO pointers

├── isp_lite.sv // ISP pipeline wrapper (YUV2RGB + resize)

│ ├── yuv2rgb.sv // BT.601 YUV422 → RGB888 color converter

│ ├── resize_engine.sv // Bilinear resize (parameterizable scale)

│ │ └── line_buffer.sv // Dual-line BRAM buffer for vertical interp

│ └── pixel_packer.sv // 24-bit RGB → 128-bit AXI word packing

├── video_dma.sv // 128-bit AXI4 master DMA (frame write to DDR)

├── crop_engine.sv // ROI crop + resize (DDR read → resize → DDR write)

│ ├── crop_dma_reader.sv // AXI4 read controller (fetches ROI rows from DDR)

│ ├── crop_resize.sv // Bilinear resize (reuses resize_engine logic)

│ └── crop_dma_writer.sv // AXI4 write controller (writes cropped face to DDR)

└── frame_buf_ctrl.sv // Double-buffer pointer management + swap logic

## 11.1 Recommended RTL Generation Sequence (Claude Agent)

# | Module | Dependencies | Unit Test Focus

1 | gray_counter.sv | None | Gray-code increment correctness, bit-width parameterization
2 | pixel_fifo.sv | gray_counter | Async CDC correctness, fill/drain at different clock ratios, overrun
3 | dvp_sync.sv | None | 2-FF metastability, edge detection at sys_clk rate
4 | dvp_capture.sv | dvp_sync | OV7670 timing model stimulus, VSYNC/HREF/PCLK protocol, YUV422 pixel pair assembly
5 | yuv2rgb.sv | None | BT.601 conversion accuracy, known YUV inputs → expected RGB, clamp behavior
6 | line_buffer.sv | None | Dual-line BRAM write/read, line swap, address wrap
7 | resize_engine.sv | line_buffer | Scale factors 5:1 and 4.3:1, bilinear accuracy vs. OpenCV reference, edge pixels
8 | pixel_packer.sv | None | RGB to RGBX padding, 4-pixel accumulation into 128-bit word
9 | isp_lite.sv | yuv2rgb, resize_engine, pixel_packer | Full pipeline: YUV422 input → 128x128 RGB output, compare to OpenCV
10 | video_dma.sv | None | AXI4 128-bit burst writes, address increment, burst boundary, completion
11 | frame_buf_ctrl.sv | None | Pointer swap, double-buffer state tracking, ACTIVE_BUF register
12 | crop_dma_reader.sv | None | AXI4 burst reads, row-stride address calculation, variable ROI
13 | crop_resize.sv | line_buffer | Bilinear resize for variable input size to 112x112
14 | crop_dma_writer.sv | None | AXI4 burst writes for cropped output
15 | crop_engine.sv | crop_dma_reader/writer, crop_resize | Full crop flow: DDR read → resize → DDR write
16 | cam_regfile.sv | None | AXI-Lite register R/W, reset values, auto-compute FRAME_SIZE_BYTES
17 | cam_controller.sv | All above | Capture sequencing, mode state machine, IRQ generation
18 | cam_subsys_top.sv | All above | Full integration: DVP → ISP → DMA → DDR end-to-end

# 12. FPGA Resource Estimate

Resource | Estimate | Z7-20 Total | Notes
DSP48 | 3–6 | 220 | YUV2RGB (3 DSP), bilinear resize (4 DSP, shared). Total with NPU+RISCV+Audio: ~80–96
BRAM18 | 4–6 | 280 | Pixel FIFO (1), ISP line buffer (2), crop line buffer (1), misc (1–2). Cumulative: ~48%
LUT | 4K–7K | 85K | DVP capture, ISP pipeline, DMA FSMs, crop engine. Cumulative: ~45–50%
FF | 2K–4K | 106K | Pipeline registers, FSM state, counters. Cumulative: ~85% remaining
Target Fmax | 100 MHz | N/A | Sys_clk domain. PCLK domain is ~24 MHz (trivial).

Cumulative Z7-20 utilization (all subsystems): With RISC-V (~12K LUT, 64 BRAM, 4 DSP), NPU (~25K LUT, 40 BRAM, 80 DSP), Audio (~5K LUT, 8 BRAM, 6 DSP), and Camera (~7K LUT, 6 BRAM, 6 DSP), total estimated utilization is: ~49K/85K LUT (58%), ~118/280 BRAM (42%), ~96/220 DSP (44%). This leaves comfortable headroom for sensor interfaces, GPIO, and debug infrastructure.

# 13. ASIC Migration Notes — Phase 1 (180nm Chip 3: Camera ISP)

Item | FPGA (Phase 0) | ASIC 180nm (Phase 1 — Chip 3)
Camera Interface | Parallel DVP (8-bit, OV7670) | MIPI CSI-2 receiver (2-lane D-PHY) with analog PHY macro
Sensor Resolution | VGA (640x480) max | Up to 5 MP (2592x1944) with ISP downscale
ISP Pipeline | ISP-Lite (YUV2RGB + bilinear resize) | Full ISP: debayer, white balance, auto-exposure, gamma, denoise
BRAM / SRAM | Xilinx BRAM inference | SCL Mohali SRAM compiler
DMA | 128-bit AXI4 Master | Same; potentially wider (256-bit) for higher resolution
Clock | 100 MHz (sys_clk), ~24 MHz (PCLK) | 200–300 MHz target; D-PHY bit rate up to 1 Gbps/lane
RTL Changes | Replace dvp_capture with csi2_receiver | ISP-lite RTL reusable; add advanced ISP stages around it
Target Die Area | N/A | ~2x2 mm (Chip 3, includes test pads)

Phase 2 (28nm) additions: MIPI CSI-2 with DPHY hard macro (foundry IP), hardware H.264 encoder for video streaming, full ISP with HDR merge, lens shading correction, and temporal noise reduction. Frame buffer management for continuous 30 FPS video with NPU inference running concurrently.

# 14. Simulation and Verification Plan

## 14.1 Golden Reference Models

Stage | Reference Tool | Verification Method
DVP Capture | Custom OV7670 BFM (bus-functional model) | Generate PCLK/VSYNC/HREF/DATA stimulus. Verify deserialized YUV pixels match.
YUV to RGB | Python (OpenCV cvtColor) | Known YUV input → compare RTL RGB output to OpenCV BT.601 conversion (±1 LSB).
Bilinear Resize | Python (OpenCV resize INTER_LINEAR) | Full frame resize: compare RTL output to OpenCV bilinear (±2 LSB per channel).
Crop + Resize | Python (OpenCV crop + resize) | Known ROI extraction and resize. Compare output image to OpenCV reference.
End-to-End | Python (full pipeline script) | YUV422 → RGB → resize → compare DDR frame buffer content to Python golden.
DMA | AXI4 memory model | Verify burst addresses, data integrity, byte ordering in DDR model.

## 14.2 Unit-Level Tests

Module | Key Tests
dvp_capture | OV7670 timing: VSYNC polarity, HREF gating, byte assembly. Truncated frame (VSYNC mid-frame). Multiple consecutive frames.
pixel_fifo | Async CDC: write at 24 MHz, read at 100 MHz. Fill/drain. Overrun recovery. Metastability (gate-level sim).
yuv2rgb | Pure white (Y=255, U=128, V=128) → (255,255,255). Pure black. Saturated colors. Clamp to [0,255].
resize_engine | 1:1 passthrough (no resize). 5:1 downscale. Non-integer scale (4.3:1). Single-pixel output. Max-size output.
video_dma | Burst-256 write. Multiple bursts for full frame. Address alignment. AXI backpressure (AWREADY deassert).
crop_engine | Full-frame crop (ROI = entire image). Minimal crop (1x1). Edge-of-frame ROI. ROI exceeding frame bounds (clamp).
frame_buf_ctrl | Buffer swap. Both buffers in use (detect contention). CPU reads ACTIVE_BUF.
cam_regfile | All register R/W. Reset values. Read-only enforcement. Auto-computed FRAME_SIZE_BYTES.

## 14.3 Subsystem Integration Tests

Test | Description
DVP to DDR (full frame) | OV7670 BFM → DVP capture → pixel FIFO → ISP-lite → video DMA → DDR. Verify 128x128 RGB in DDR matches golden.
Double-buffer swap | Capture frame A, trigger NPU read on A, capture frame B, verify no data corruption.
Crop flow | Write known image to DDR. Program crop ROI. Trigger CROP_START. Verify 112x112 output in DDR.
Full face recognition | Camera capture → BlazeFace (NPU stub) → crop → MobileFaceNet (NPU stub) → embedding output. End-to-end.
Continuous capture + NPU | Camera in continuous mode. NPU reads frame N while camera writes frame N+1. Verify no tearing.
Mode switch | Start in single-shot, switch to continuous, back to single-shot. Verify clean transitions.
Raw bypass mode | ISP bypass=1. Verify raw YUV422 data written to DDR without conversion.
CPU integration | CPU programs all registers, triggers capture, receives IRQ, reads status, programs crop, receives crop_done.

# 15. Top-Level Port List (cam_subsys_top.sv)

Port | Width | Dir | Description
clk_i | 1 | I | System clock (100 MHz FPGA / 200+ MHz ASIC)
rst_ni | 1 | I | Active-low system reset
cam_pclk_i | 1 | I | Camera pixel clock from external module (~24 MHz)
cam_vsync_i | 1 | I | Camera vertical sync (frame start)
cam_href_i | 1 | I | Camera horizontal reference (line valid)
cam_data_i | 8 | I | Camera 8-bit parallel pixel data
s_axi_lite_awaddr | 32 | I | AXI-Lite write address (from CPU)
s_axi_lite_awvalid | 1 | I | AXI-Lite write address valid
s_axi_lite_awready | 1 | O | AXI-Lite write address ready
s_axi_lite_wdata | 32 | I | AXI-Lite write data
s_axi_lite_wstrb | 4 | I | AXI-Lite write byte strobes
s_axi_lite_wvalid | 1 | I | AXI-Lite write data valid
s_axi_lite_wready | 1 | O | AXI-Lite write data ready
s_axi_lite_bresp | 2 | O | AXI-Lite write response
s_axi_lite_bvalid | 1 | O | AXI-Lite write response valid
s_axi_lite_bready | 1 | I | AXI-Lite write response ready
s_axi_lite_araddr | 32 | I | AXI-Lite read address
s_axi_lite_arvalid | 1 | I | AXI-Lite read address valid
s_axi_lite_arready | 1 | O | AXI-Lite read address ready
s_axi_lite_rdata | 32 | O | AXI-Lite read data
s_axi_lite_rresp | 2 | O | AXI-Lite read response
s_axi_lite_rvalid | 1 | O | AXI-Lite read data valid
s_axi_lite_rready | 1 | I | AXI-Lite read data ready
m_axi_vdma_aw* | various | O | AXI4 128-bit DMA write address channel (DDR)
m_axi_vdma_w* | various | O | AXI4 128-bit DMA write data channel
m_axi_vdma_b* | various | I | AXI4 128-bit DMA write response channel
m_axi_vdma_ar* | various | O | AXI4 128-bit DMA read address channel (crop engine reads)
m_axi_vdma_r* | various | I | AXI4 128-bit DMA read data channel
irq_camera_ready_o | 1 | O | Frame ready / crop done interrupt (to IRQ controller bit 2)

Open Items & Decisions Pending:

# | Open Item | Impact | Owner / Target

1 | Camera module: OV7670 (VGA) vs. OV2640 (UXGA)? | OV2640 supports higher resolution (2 MP) for better crop quality but adds SCCB configuration complexity. | Decide before dvp_capture FSM generation
2 | Raw frame buffer: always store full-res, or only on demand? | Always storing 640x480 uses 1.2 MB DDR but simplifies crop. On-demand saves DDR but requires re-capture. | Decide before video_dma RTL
3 | Crop engine: hardware (this doc) vs. CPU firmware? | Hardware crop takes ~2 ms; CPU memcpy + resize could take ~50–100 ms. Hardware is 25–50x faster. | Decide before crop_engine RTL coding
4 | Video DMA: dedicated 128-bit port or shared with NPU M2? | Dedicated port adds an AXI interconnect master. Shared port requires arbitration but saves resources. | Decide before video_dma + axi_interconnect update
5 | ISP-lite: hardware bilinear vs. nearest-neighbor resize? | Bilinear is higher quality (better detection accuracy). Nearest-neighbor is simpler (fewer DSPs). | Decide before resize_engine RTL
6 | SCCB configuration: FPGA I2C master or Zynq PS I2C? | OV7670 needs SCCB init (I2C-like). Can use existing I2C peripheral or Zynq PS side. | Decide before board bring-up

— End of Camera / Vision Subsystem RTL Implementation Document —

AI Glasses SoC | Phase 0 FPGA → Phase 1 (180nm Chip 3) | Version 1.0 | March 2026

Confidential — Page

Camera/Vision Subsystem RTL Implementation Document AI Glasses SoC — Phase 0
