anirudhr-adtech/AI_GLASSES/AI_Smart_Glasses_docs/Specs and Sub system implementation document/DDR_Subsystem_RTL_Implementation.docx

DDR MEMORY SUBSYSTEM

RTL IMPLEMENTATION DOCUMENT

AI Glasses SoC — Phase 0 FPGA Prototype

DDR as System Shared Workspace | FPGA Zynq HP Wrapper | Simulation Memory Model

Field | Value
Document Version | 1.0
Status | DRAFT — Architecture Lock
Phase | Phase 0 — FPGA Prototype
Author | Anirudh (Sole Architect)
Date | March 2026
Wake-Word Model | DS-CNN-S — "Marvin" (ARM ML-KWS-for-MCU, pre-trained)
Connectivity | ESP32-C3 companion chip via SPI (all phases including 28nm)
AI Backend | VPS with Cloud AI APIs (Whisper STT + Claude/GPT LLM + TTS)
Companion Docs | AXI Interconnect RTL Implementation, RISC-V Subsystem, NPU Subsystem, Audio Subsystem v2, Camera/Vision Subsystem, Phase 0 Simulation Validation Plan

# 1. The Role of DDR in the AI Glasses SoC

DDR is the system’s shared workspace. It is the single place where all subsystems exchange data. No subsystem talks directly to another subsystem’s data path — they all communicate through DDR. DDR acts as the contract between producers and consumers that operate at different times and different rates.

## 1.1 What Each Subsystem Uses DDR For

Subsystem | DDR Usage
NPU | Heaviest user. Stores AI model weights (DS-CNN ~50 KB, BlazeFace ~1 MB, MobileFaceNet ~2 MB). Reads input tensors prepared by other subsystems. Writes output tensors after each layer. DMA engine constantly shuttles data between DDR and on-chip scratchpad BRAM. Without DDR, no AI use case can run — models don’t fit on-chip.
Camera | Frame buffer. ISP-lite writes processed 128x128 RGB frames to DDR. NPU reads frames from DDR for BlazeFace. Crop engine reads face ROI from DDR full-resolution frame, resizes, writes cropped face back to DDR for MobileFaceNet. DDR is the handoff point — camera and NPU never communicate directly.
Audio (Wake-Word) | Small, one-shot handoff. MFCC hardware pipeline produces 49x10 feature tensor (~980 bytes). DMA writes it to DDR. CPU tells NPU to read it and run DS-CNN-S ("Marvin" detection). Entire MFCC tensor is ~1 KB every ~1 second.
Audio (Conversation) | Continuous streaming ring buffer. After "Marvin" detected, audio subsystem switches to PCM pass-through. Raw PCM streams into DDR ring buffer (64 KB, ~2 seconds). CPU reads from ring buffer and pushes to ESP32 via SPI for Wi-Fi streaming to VPS. Ring buffer is a rate decoupler, not a storage device — old data is continuously overwritten.
CPU | Boot: boot ROM copies firmware image from DDR (0x0700_0000) to SRAM. Runtime: occasional DDR access for data that doesn’t fit in SRAM. Most CPU activity targets SRAM and peripherals, not DDR.
ESP32 (via CPU) | Indirect user. CPU reads audio/image data from DDR, packages it, sends via SPI to ESP32 for Wi-Fi transmission to VPS. Response audio from VPS is received by ESP32, read by CPU via SPI, written to DDR playback buffer.

## 1.2 DDR Data Exchange Patterns

Every inter-subsystem data transfer follows the same pattern: producer writes to DDR at a known address, consumer reads from that same address. The CPU coordinates via interrupts and register programming.

Producer | Consumer | DDR Region | Trigger
Audio MFCC pipeline | NPU (DS-CNN) | INPUTS: MFCC Feature Buffer | AUDIO_FRAME_READY IRQ
Camera ISP-lite | NPU (BlazeFace) | FRAME BUFFER: Buffer A/B | CAM_FRAME_READY IRQ
Crop engine | NPU (MobileFaceNet) | FRAME BUFFER: Crop Output | CROP_DONE IRQ
NPU output DMA | CPU (post-process) | OUTPUTS: Inference Results | NPU_DONE IRQ
Audio PCM pass-through | CPU → SPI → ESP32 → VPS | AUDIO: PCM Ring Buffer | CPU polls DMA_WR_PTR
CPU (from ESP32 RX) | Audio playback path | AUDIO: Playback Buffer | SPI HANDSHAKE IRQ
FPGA config / JTAG | CPU (boot ROM copies) | FIRMWARE region | Power-on boot sequence

# 2. Consolidated DDR Memory Map (Definitive)

This is the single source of truth for all DDR address allocations. All addresses are DDR-relative offsets. The CPU sees these at 0x8000_0000 + offset (AXI physical address space). DMA engines use CPU-space addresses in their registers.

## 2.1 Top-Level Region Layout

Region | DDR Offset | Size | Contents
MODEL WEIGHTS | 0x0000_0000 | 16 MB | All AI model weights. DS-CNN-S "Marvin" (~50 KB), Gesture CNN (~100 KB), BlazeFace (~1 MB), MobileFaceNet (~2 MB). Total used: ~3.5 MB of 16 MB allocated.
INPUTS | 0x0100_0000 | 16 MB | Input tensors per NPU layer, MFCC feature buffers, preprocessed sensor data.
WORK | 0x0200_0000 | 16 MB | Intermediate tensors, scratch space for layer chaining, NPU ping-pong activation buffers.
OUTPUTS | 0x0300_0000 | 16 MB | Output tensors, inference classification scores, embedding vectors (128-dim from MobileFaceNet).
FRAME BUFFER | 0x0400_0000 | 32 MB | Camera frame buffers (RGB/YUV), crop buffers, raw frames.
AUDIO BUFFER | 0x0600_0000 | 1 MB | MFCC feature frames, PCM streaming ring buffer, playback buffer, audio debug.
FIRMWARE | 0x0700_0000 | 1 MB | RISC-V firmware image. Copied to SRAM by boot ROM at power-on.
RESERVED | 0x0800_0000 | ~480 MB | Available on Zybo Z7-20 (512 MB total DDR). Future: enrolled face database, additional models.

## 2.2 MODEL WEIGHTS Sub-Map

Model | Offset from 0x0000_0000 | Size | Notes
DS-CNN-S ("Marvin") | +0x0000_0000 | 64 KB | INT8 quantized weights. Pre-trained from ARM ML-KWS-for-MCU. Actual size ~30–50 KB; 64 KB padded allocation.
Gesture CNN | +0x0001_0000 | 128 KB | INT8 quantized. Small MLP/CNN for IMU gesture recognition.
BlazeFace | +0x0010_0000 | 1 MB | INT8 quantized face detection model.
MobileFaceNet | +0x0020_0000 | 2 MB | INT8 quantized face embedding model.
Enrolled Faces DB | +0x0040_0000 | 256 KB | 128-dim INT8 embedding vectors for known faces. ~10 faces x 128 bytes = 1.3 KB; padded for growth.

## 2.3 INPUTS Sub-Map

Sub-Region | Offset from 0x0100_0000 | Size | Usage
MFCC Feature Buffer A | +0x0000_0000 | 1 KB | Current 49x10x16-bit MFCC feature frame for DS-CNN ("Marvin" detection).
MFCC Feature Buffer B | +0x0000_0400 | 1 KB | Double-buffer partner. NPU reads one while audio fills the other.
NPU Layer Input (generic) | +0x0001_0000 | 4 MB | Per-layer input tensor. Address programmed by CPU for each layer.

## 2.4 FRAME BUFFER Sub-Map

Sub-Region | Offset from 0x0400_0000 | Size | Usage
Processed Frame A | +0x0000_0000 | 64 KB | 128x128x4 RGBX (BlazeFace input). Written by camera ISP + video DMA.
Processed Frame B | +0x0001_0000 | 64 KB | Ping-pong partner. Camera writes one, NPU reads the other.
Raw Frame Buffer | +0x0002_0000 | 1.2 MB | 640x480x4 RGBX full-resolution. Source for crop engine.
Crop Output Buffer | +0x0020_0000 | 48 KB | 112x112x4 RGBX cropped face (MobileFaceNet input).
Camera Debug | +0x0030_0000 | 64 KB | Debug: raw YUV, ISP intermediate data.

## 2.5 AUDIO BUFFER Sub-Map

Sub-Region | Offset from 0x0600_0000 | Size | Usage
MFCC Feature A | +0x0000_0000 | 1 KB | Current MFCC feature frame (49x10x16-bit = 980 bytes).
MFCC Feature B | +0x0000_0400 | 1 KB | Double-buffer partner.
PCM Ring Buffer | +0x0000_1000 | 64 KB | Raw PCM streaming for conversation mode. ~2 seconds at 32 KB/s. Circular.
VPS Playback Buffer | +0x0001_1000 | 64 KB | Received TTS audio from VPS (via ESP32). CPU writes here, audio playback reads.
Audio Debug | +0x000F_0000 | 4 KB | Debug: FFT output, mel energies, intermediate pipeline values.

# 3. DDR Data Flows by Use Case

## 3.1 Use Case 1: Wake-Word Detection ("Marvin")

This is the always-on use case. The system firmware FSM is in LISTENING state.

Step | Action | DDR Region | Data Flow
1 | Audio subsystem produces MFCC | INPUTS: MFCC Feature A | Audio DMA writes 980 bytes (49x10x16-bit) to DDR. IRQ to CPU.
2 | CPU programs NPU | WEIGHTS: DS-CNN-S | CPU writes NPU registers: INPUT_ADDR=MFCC buf, WEIGHT_ADDR=DS-CNN weights.
3 | NPU DMA fetches weights | WEIGHTS: DS-CNN-S | NPU DMA reads ~50 KB weights from DDR to scratchpad BRAM.
4 | NPU DMA fetches input | INPUTS: MFCC Feature A | NPU DMA reads 980 bytes MFCC tensor from DDR to activation BRAM.
5 | NPU runs DS-CNN inference | — (on-chip) | MAC array processes layers. ~6 MMAC. < 5 ms.
6 | NPU DMA writes output | OUTPUTS | NPU DMA writes classification scores (12 classes x 4 bytes = 48 bytes) to DDR.
7 | CPU reads result | OUTPUTS | CPU reads scores. If "marvin" confidence > 0.85: transition to ACTIVE state.

## 3.2 Use Case 2: Conversation Streaming to VPS

After "Marvin" is detected, firmware FSM transitions to ACTIVE → STREAMING state.

Step | Action | DDR Region | Data Flow
1 | CPU switches audio mode | — | CPU writes AUDIO_CONTROL: mode=passthrough. MFCC pipeline bypassed.
2 | CPU opens VPS connection | — | CPU sends TCP_CONNECT command to ESP32 via SPI. ESP32 opens WebSocket to VPS.
3 | PCM streams to DDR | AUDIO: PCM Ring Buffer | Audio DMA writes raw 16-bit PCM at 32 KB/s into 64 KB circular ring buffer.
4 | CPU pumps data to ESP32 | AUDIO: PCM Ring Buffer | CPU reads 1 KB chunks from ring buffer. Sends TCP_SEND via SPI to ESP32. Repeats every ~31 ms.
5 | ESP32 streams to VPS | — (off-chip) | ESP32 forwards PCM over Wi-Fi WebSocket to VPS. ~256 kbps sustained.
6 | VPS processes speech | — (cloud) | VPS: Whisper STT → transcript → Claude/GPT LLM → response → TTS engine → audio.
7 | ESP32 receives response | — (off-chip) | ESP32 receives TTS audio via WebSocket. Asserts HANDSHAKE pin to SoC.
8 | CPU writes playback buffer | AUDIO: VPS Playback Buffer | CPU reads response audio from ESP32 via SPI. Writes to DDR playback buffer.
9 | Audio playback | AUDIO: VPS Playback Buffer | Audio subsystem reads playback buffer and drives I2S TX to speaker codec.
10 | Silence timeout | — | CPU monitors FRAME_ENERGY. If below noise floor for 3s: close TCP, return to LISTENING.

## 3.3 Use Case 3: Face Recognition

Triggered by user command or automatic (e.g., after "Marvin, who is this?"). Firmware FSM in ACTIVE state.

Step | Action | DDR Region | Data Flow
1 | Camera captures frame | FRAME BUFFER: Processed A + Raw | ISP-lite writes 128x128 RGBX to Processed A (64 KB). Also stores 640x480 to Raw (1.2 MB).
2 | NPU runs BlazeFace | WEIGHTS: BlazeFace, INPUTS: Processed A | NPU DMA reads weights (~1 MB) + input frame (64 KB). Runs detection. Writes bounding boxes to OUTPUTS.
3 | CPU parses detection | OUTPUTS | CPU reads bounding box coordinates. Scales from 128x128 to 640x480 space.
4 | Crop engine extracts face | FRAME BUFFER: Raw → Crop Output | Crop DMA reads face ROI from Raw frame, resizes to 112x112, writes to Crop Output (48 KB).
5 | NPU runs MobileFaceNet | WEIGHTS: MobileFaceNet, INPUTS: Crop Output | NPU DMA reads weights (~2 MB) + cropped face (48 KB). Runs embedding. Writes 128-dim vector to OUTPUTS.
6 | CPU cosine similarity | OUTPUTS + WEIGHTS: Enrolled DB | CPU reads embedding from OUTPUTS. Compares against enrolled faces in DDR. Identifies person.
7 | Optional: send to VPS | OUTPUTS | CPU can send embedding vector (128 bytes) to VPS via ESP32 for cloud-side identity lookup.

# 4. System Firmware FSM (DDR Usage Context)

The RISC-V firmware implements a state machine that determines how DDR is used at any given time. Understanding these states is essential for the DDR simulation model because different states exercise different DDR access patterns.

State | DDR Activity | Transitions
BOOT | CPU reads firmware from DDR (0x0700_0000) to SRAM via memcpy or DMA. One-time, sequential read. | Automatic → LISTENING after firmware copied and peripherals initialized.
LISTENING | Continuous: audio DMA writes MFCC tensors (~1 KB every ~1s). NPU DMA reads DS-CNN weights + MFCC input. NPU DMA writes classification output. | If "Marvin" detected with confidence > 0.85 → WAKE_DETECTED.
WAKE_DETECTED | Brief transitional state. CPU reads classification result from DDR. Decides next action. | → STREAMING (voice command to VPS) or → CAPTURE (face recognition trigger).
STREAMING | Audio DMA writes PCM to ring buffer continuously (32 KB/s). CPU reads ring buffer chunks. CPU writes VPS response audio to playback buffer. | Silence timeout (3s) or "stop" keyword → LISTENING. Face recognition command → CAPTURE.
CAPTURE | Camera DMA writes frame to DDR (~64 KB + 1.2 MB raw). Crop DMA reads/writes (~200 KB). NPU DMA bursts for BlazeFace + MobileFaceNet. | After recognition complete → STREAMING or → LISTENING.
ERROR | CPU logs error info to DDR debug region. System attempts recovery. | → LISTENING after recovery or watchdog reset.

// Firmware FSM (simplified pseudocode)

typedef enum {BOOT, LISTENING, WAKE_DETECTED, STREAMING, CAPTURE, ERROR} state_t;

state_t state = BOOT;

void main() {

// BOOT: copy firmware, init peripherals

memcpy(SRAM_BASE, DDR_FIRMWARE_BASE, FW_SIZE);

init_peripherals();

esp32_wifi_connect(SSID, PASSWORD);

state = LISTENING;

while (1) {

switch (state) {

case LISTENING:

audio_set_mode(MFCC_MODE);

wfi(); // Wait for AUDIO_FRAME_READY IRQ

npu_run_dscnn(MFCC_BUF_ADDR, DSCNN_WEIGHTS_ADDR);

wfi(); // Wait for NPU_DONE IRQ

if (npu_read_class("marvin") > CONFIDENCE_THRESHOLD)

state = WAKE_DETECTED;

break;

case WAKE_DETECTED:

uart_printf("Wake word detected!\n");

esp32_tcp_connect(VPS_ADDR, VPS_PORT);

state = STREAMING;

break;

case STREAMING:

audio_set_mode(PCM_PASSTHROUGH);

while (state == STREAMING) {

// Pump audio to VPS

if (audio_ring_buf_available() >= 1024) {

cpu_read_ddr(ring_buf_rd_ptr, spi_tx_buf, 1024);

esp32_tcp_send(spi_tx_buf, 1024);

}

// Check for VPS response audio

if (esp32_has_data()) {

esp32_tcp_recv(spi_rx_buf, &len);

cpu_write_ddr(PLAYBACK_BUF_ADDR + wr_ptr, spi_rx_buf, len);

}

// Silence timeout check

if (audio_read_energy() < NOISE_FLOOR for 3 seconds)

state = LISTENING;

}

esp32_tcp_close();

break;

case CAPTURE:

cam_single_shot_capture();

wfi(); // CAM_FRAME_READY IRQ

face_recognition_pipeline(); // BlazeFace + crop + MobileFaceNet

state = LISTENING;

break;

}

}

}

# 5. FPGA DDR Path: Zynq PS HP Port Integration

On the Zybo Z7-20, the DDR3 memory is physically connected to the Zynq PS (Processing System). The PL (Programmable Logic) — where our SoC lives — accesses DDR through the Zynq’s AXI High-Performance (HP) slave ports. The HP ports are hardened AXI3 slave interfaces inside the PS that connect to the DDR controller via the PS interconnect.

## 5.1 Zynq HP Port Configuration

Parameter | Value / Decision
HP Port Used | HP0 (S_AXI_HP0). Single port is sufficient for Phase 0 bandwidth.
HP0 Data Width | 64-bit (native). Can be configured to 32-bit or 64-bit via Vivado. We use 64-bit.
Protocol | AXI3 (not AXI4). Zynq PS HP ports speak AXI3 natively.
Max Burst Length | 16 beats (AXI3 limit). Our crossbar must split AXI4 bursts >16 into sub-bursts.
ID Width | 6-bit (Zynq HP supports up to 6-bit IDs, matching our crossbar).
QoS Support | Yes. HP ports support 4-bit QoS for arbitration priority inside the PS.
Clock | PL fabric clock (100 MHz). HP port is clocked by the PL-side clock, not the PS clock.
Address Space | 0x0000_0000 – 0x1FFF_FFFF (512 MB). Mapped to 0x8000_0000 in CPU address space.

## 5.2 Integration Approach: Hybrid

The integration uses a hybrid approach: Vivado Block Design for the Zynq PS configuration (DDR settings, clock generation, HP port enable), and RTL for the data path (our AXI crossbar → DDR wrapper). This gives us full control over the data path while leveraging Vivado’s GUI for the PS configuration, which is complex and error-prone to do manually.

- Vivado Block Design: instantiate Zynq PS IP, configure DDR3 timing parameters (auto from board preset), enable HP0 port at 64-bit, configure FCLK_CLK0 = 100 MHz as PL fabric clock.
- RTL: our entire SoC (RISC-V, NPU, audio, camera, AXI crossbar) is instantiated as a single RTL module in the block design, connected to the Zynq HP0 AXI3 slave port via the DDR wrapper.
- The DDR wrapper (ddr_wrapper.sv) sits at the boundary: SoC-side AXI4 128-bit → DDR wrapper → Zynq HP0 AXI3 64-bit.

## 5.3 DDR Wrapper (ddr_wrapper.sv) — Detailed Specification

The DDR wrapper performs three transformations between the SoC crossbar and the Zynq HP0 port:

### 5.3.1 Burst Splitting (AXI4 → AXI3)

AXI4 allows burst lengths up to 256 beats. AXI3 allows only 16. The burst splitter subdivides long bursts:

AXI4 Burst Length | AXI3 Sub-Bursts Generated | Address Handling
1–16 beats | 1 sub-burst (pass-through) | Address unchanged
17–32 beats | 2 sub-bursts (16 + remainder) | Second sub-burst: addr + 16 * beat_size
256 beats | 16 sub-bursts (16 x 16) | Each sub-burst: addr + N * 16 * beat_size

Write path: the AW channel is re-issued per sub-burst, but the W channel flows continuously (no gaps). The burst splitter tracks the W beat count and generates WLAST at the correct beat for each sub-burst. The final BRESP is returned only after all sub-bursts complete — the splitter accumulates sub-burst BRESPs and returns the worst-case (any error propagates).

Read path: the AR channel is re-issued per sub-burst. Read data from sub-bursts is concatenated. RLAST from the final sub-burst is passed to the SoC as the true RLAST.

### 5.3.2 Data Width Conversion (128-bit → 64-bit)

The SoC crossbar outputs 128-bit data (matching NPU and Camera DMA widths). The Zynq HP0 is configured at 64-bit. The width converter splits each 128-bit beat into two 64-bit beats:

- Write: one 128-bit W beat with 16-byte wstrb becomes two 64-bit W beats. First beat: lower 8 bytes with wstrb[7:0]. Second beat: upper 8 bytes with wstrb[15:8]. AWLEN is doubled (burst of N becomes burst of 2N). AWSIZE changes from 4 (16 bytes) to 3 (8 bytes).
- Read: two consecutive 64-bit R beats are assembled into one 128-bit R beat. RLAST from the AXI3 side is suppressed for odd beats; only even-beat RLAST is forwarded as the real RLAST to the SoC.
- Narrow transfers: when a 32-bit CPU master accesses DDR (already upsized to 128-bit by the crossbar width converter), the DDR wrapper further converts to 64-bit. The byte strobes ensure only the correct 4 bytes are written.

### 5.3.3 QoS Mapping

Master | AXI ID Prefix | QoS | Priority Rationale
NPU DMA (M2) | 3'b010 | 4'hF | Highest: NPU must not stall during inference
Camera DMA (M3) | 3'b011 | 4'hC | High: frame capture has VSYNC timing deadline
CPU Data (M1) | 3'b001 | 4'h8 | Medium: register reads are latency-sensitive
CPU iBus (M0) | 3'b000 | 4'h4 | Low: instruction fetch can be buffered
Audio DMA (M4) | 3'b100 | 4'h2 | Lowest: trivial data rate (~32 KB/s)

## 5.4 DDR Wrapper Port List

Port | Width | Dir | Description
clk_i | 1 | I | PL fabric clock (100 MHz, from Zynq FCLK_CLK0)
rst_ni | 1 | I | Active-low reset (synchronized to clk_i)
s_axi4_aw* | various | I | AXI4 slave write address channel (from crossbar S3)
s_axi4_w* | various | I | AXI4 slave write data channel (128-bit)
s_axi4_b* | various | O | AXI4 slave write response channel
s_axi4_ar* | various | I | AXI4 slave read address channel
s_axi4_r* | various | O | AXI4 slave read data channel (128-bit)
m_axi3_aw* | various | O | AXI3 master write address (to Zynq HP0)
m_axi3_w* | various | O | AXI3 master write data (64-bit)
m_axi3_b* | various | I | AXI3 master write response
m_axi3_ar* | various | O | AXI3 master read address
m_axi3_r* | various | I | AXI3 master read data (64-bit)

# 6. Simulation DDR Model (axi_mem_model.sv)

The simulation DDR model replaces the Zynq PS and physical DDR3 in RTL simulation. It is a behavioral AXI4 slave memory that stores data, returns it on read, and provides configurable latency and stress-testing features. The model must faithfully represent DDR’s role as the shared workspace: what one subsystem writes, another must read back correctly.

## 6.1 Model Architecture

axi_mem_model.sv // Top-level behavioral DDR model

├── axi_mem_aw_channel.sv // AW channel handler (address decode, burst tracking)

├── axi_mem_w_channel.sv // W channel handler (data storage, wstrb masking)

├── axi_mem_b_channel.sv // B channel handler (write response generation)

├── axi_mem_ar_channel.sv // AR channel handler (address decode, burst tracking)

├── axi_mem_r_channel.sv // R channel handler (data retrieval, latency pipeline)

├── mem_array.sv // Sparse associative memory storage

├── latency_pipe.sv // Configurable delay pipeline (read and write)

├── backpressure_gen.sv // Configurable READY signal throttling

└── mem_preloader.sv // Hex file preloader ($readmemh wrapper)

## 6.2 Interface Specification

Parameter | Value
AXI Protocol | AXI4 Slave (matches SoC crossbar S3 output, NOT AXI3). Simulation bypasses the DDR wrapper.
Data Width | 128-bit (matches crossbar native width)
Address Width | 32-bit
ID Width | 6-bit (matches crossbar)
Memory Size | Configurable. Default: 128 MB (sufficient for all DDR regions). Simulation does not need full 512 MB.
Storage Implementation | SystemVerilog associative array: logic [7:0] mem[int unsigned]. Sparse allocation — only accessed addresses consume simulator memory.

## 6.3 Configurable Parameters

Parameter | Default | Description
MEM_SIZE_BYTES | 128*1024*1024 | Total addressable memory in bytes. Accesses beyond this return DECERR.
READ_LATENCY | 10 | Cycles from ARVALID+ARREADY handshake to first RVALID. Models DDR CAS + controller pipeline.
READ_BEAT_LATENCY | 1 | Cycles between consecutive R beats within a burst (after first beat). 1 = pipelined.
WRITE_LATENCY | 5 | Cycles from WLAST+WREADY handshake to BVALID. Models DDR write + controller ack.
BACKPRESSURE_MODE | 0 | 0 = no backpressure (ARREADY/AWREADY/WREADY always high). 1 = periodic deassert. 2 = random.
BP_PERIOD | 8 | For mode 1: deassert READY for 1 cycle every BP_PERIOD cycles.
BP_SEED | 42 | For mode 2: LFSR seed for random backpressure pattern.
MAX_OUTSTANDING_RD | 8 | Maximum outstanding read transactions per ID. AR rejected (ARREADY=0) when limit hit.
MAX_OUTSTANDING_WR | 4 | Maximum outstanding write transactions per ID.
ERROR_ADDR_LO | 0xFFFFFFFF | Start of error injection region. Accesses in [LO, HI] return DECERR.
ERROR_ADDR_HI | 0xFFFFFFFF | End of error injection region. Default: no error region (LO > HI).
ENABLE_ASSERTIONS | 1 | Enable built-in AXI protocol assertions (burst alignment, size, etc.).

## 6.4 Memory Storage (mem_array.sv)

The memory storage uses a byte-addressable associative array for sparse allocation. Only addresses that are actually written consume simulator memory. This allows modeling the full 128 MB address space without allocating 128 MB of simulator RAM.

// Sparse byte-addressable memory

logic [7:0] mem [int unsigned];

// Write: respect byte strobes

function void write_bytes(input int unsigned addr, input logic [127:0] data, input logic [15:0] strb);

for (int i = 0; i < 16; i++) begin

if (strb[i]) mem[addr + i] = data[i*8 +: 8];

end

endfunction

// Read: return 0 for unwritten addresses

function logic [127:0] read_bytes(input int unsigned addr);

logic [127:0] data = '0;

for (int i = 0; i < 16; i++) begin

if (mem.exists(addr + i)) data[i*8 +: 8] = mem[addr + i];

else data[i*8 +: 8] = 8'h00; // Uninitialized reads return 0

end

return data;

endfunction

## 6.5 Read Pipeline (latency_pipe.sv)

The read pipeline models DDR read latency. When an AR handshake occurs, the request enters a FIFO of depth READ_LATENCY. After READ_LATENCY cycles, the memory is read and RVALID is asserted.

Stage | Behavior
AR Accept | When ARVALID && ARREADY: capture ARADDR, ARLEN, ARSIZE, ARBURST, ARID. Push to latency FIFO. Decrement outstanding counter.
Latency Wait | Request sits in FIFO for READ_LATENCY cycles. During this time, the model can accept additional AR requests (outstanding support).
R Generation | After latency expires: read memory at burst addresses. Assert RVALID with RDATA. For burst reads, subsequent beats follow at READ_BEAT_LATENCY interval. Assert RLAST on final beat.
R Handshake | If RREADY deasserted by master: RVALID remains high, data is held. No data loss. Backpressure from master is handled correctly.

## 6.6 Write Pipeline

Stage | Behavior
AW Accept | When AWVALID && AWREADY: capture write address and burst parameters. Push to pending write queue.
W Accept | W beats are accepted independently of AW (AXI4 allows W before AW). Each W beat: store data to memory using write_bytes() with wstrb masking. Track beat count.
WLAST | When WLAST received: write transaction is complete. Start write response latency timer.
B Generation | After WRITE_LATENCY cycles from WLAST: assert BVALID with BRESP=OKAY. If address was in error region: BRESP=DECERR.

## 6.7 Backpressure Generator (backpressure_gen.sv)

The backpressure generator controls ARREADY, AWREADY, and WREADY deassertion patterns to stress-test DMA engines and the interconnect.

Mode | Name | Behavior
0 | No backpressure | All READY signals always high. Fastest simulation. Use for functional correctness.
1 | Periodic | READY deasserts for 1 cycle every BP_PERIOD cycles. Deterministic, reproducible. Good for regression.
2 | Random | READY deasserts randomly based on LFSR. Seed controlled by BP_SEED for reproducibility. Catches corner cases in DMA handshake logic.
3 | Worst-case | READY deasserts for N-1 out of every N cycles (configurable). Only accepts 1 beat every N cycles. Stress test for maximum stall conditions.

## 6.8 Memory Preloading (mem_preloader.sv)

// Testbench memory preload (SystemVerilog)

initial begin

// Load DS-CNN-S "Marvin" weights (INT8 quantized, from ARM ML-KWS-for-MCU)

$readmemh("dscnn_marvin_weights.hex", ddr_model.mem_array.mem, 32'h0000_0000);

// Load face recognition models

$readmemh("blazeface_weights.hex", ddr_model.mem_array.mem, 32'h0010_0000);

$readmemh("mfacenet_weights.hex", ddr_model.mem_array.mem, 32'h0020_0000);

// Load enrolled face embeddings

$readmemh("enrolled_faces.hex", ddr_model.mem_array.mem, 32'h0040_0000);

// Load firmware image (boot ROM copies this to SRAM)

$readmemh("firmware.hex", ddr_model.mem_array.mem, 32'h0700_0000);

// Load test inputs for verification

$readmemh("mfcc_test_marvin.hex", ddr_model.mem_array.mem, 32'h0100_0000);

$readmemh("test_frame_rgb.hex", ddr_model.mem_array.mem, 32'h0400_0000);

end

## 6.9 Built-in Protocol Assertions

When ENABLE_ASSERTIONS = 1, the model checks AXI protocol rules on every transaction:

- ARADDR and AWADDR alignment: must be aligned to ARSIZE/AWSIZE
- Burst boundary: INCR bursts must not cross 4 KB address boundary (AXI spec rule)
- WSTRB consistency: WSTRB must be contiguous and aligned to transfer size
- W beat count: number of W beats must match AWLEN + 1
- WLAST: must be asserted on the final W beat of each burst
- ID ordering: responses for the same ID must return in request order
- Outstanding limit: number of outstanding transactions per ID does not exceed configured maximum

Violations are reported as simulation errors with full transaction context (address, ID, burst length, cycle number).

# 7. Simulation vs. FPGA: What Gets Used Where

The DDR subsystem has two completely different instantiation paths. Understanding which modules exist in which context is essential.

Module | RTL Simulation | FPGA Synthesis
axi_mem_model.sv | YES — this IS the DDR | NO — not synthesized
mem_preloader.sv | YES — loads test data | NO — JTAG/FPGA config loads data
backpressure_gen.sv | YES — stress testing | NO — not synthesized
ddr_wrapper.sv | NO — bypassed in sim | YES — bridges crossbar to Zynq HP
burst_splitter.sv | NO — sim model accepts AXI4 natively | YES — splits for AXI3 HP port
width_converter (128→64) | NO — sim model accepts 128-bit | YES — HP port is 64-bit
qos_mapper.sv | NO — sim model ignores QoS | YES — sets HP port priority
Zynq PS IP (Vivado) | NO — not in simulation | YES — configures DDR3 + clocks

Key insight: In simulation, the SoC crossbar S3 slave port connects directly to axi_mem_model.sv (AXI4, 128-bit). The ddr_wrapper, burst_splitter, width_converter, and Zynq PS are all absent. This means simulation verifies the data path correctness of all DMA engines and the crossbar, but does NOT verify the DDR wrapper itself. The DDR wrapper must be verified separately (or during FPGA bring-up) by running traffic through it to the Zynq HP port.

# 8. RTL Module Hierarchy and Generation Sequence

## 8.1 Synthesizable RTL (FPGA)

# | Module | Dependencies | Unit Test Focus

1 | burst_splitter.sv | None | 256→16x16 splitting, 17→16+1, passthrough for ≤16. Address auto-increment.
2 | qos_mapper.sv | None | ID-to-QoS table lookup. All 5 master ID prefixes.
3 | axi4_to_axi3_bridge.sv | burst_splitter, qos_mapper | Full protocol conversion. Long burst split + QoS mapping.
4 | axi_width_128to64.sv | None | 128→64 write: 1 beat → 2 beats, wstrb splitting. Read: 2→1 assembly.
5 | ddr_wrapper.sv | axi4_to_axi3_bridge, axi_width_128to64 | Full wrapper: SoC AXI4 128-bit → Zynq HP AXI3 64-bit.

## 8.2 Simulation-Only RTL

# | Module | Dependencies | Unit Test Focus

1 | mem_array.sv | None | Sparse write/read, byte-level strobe, uninitialized read returns 0.
2 | latency_pipe.sv | None | Configurable delay, FIFO depth, burst pipelining.
3 | backpressure_gen.sv | None | All 4 modes: none, periodic, random, worst-case.
4 | axi_mem_aw_channel.sv | None | AW handshake, outstanding tracking, burst param capture.
5 | axi_mem_w_channel.sv | mem_array | W data storage, wstrb masking, WLAST tracking, beat count.
6 | axi_mem_b_channel.sv | None | BRESP generation, latency timer, error injection.
7 | axi_mem_ar_channel.sv | None | AR handshake, outstanding tracking, burst param capture.
8 | axi_mem_r_channel.sv | mem_array, latency_pipe | Read data retrieval, burst addressing, RLAST generation.
9 | mem_preloader.sv | mem_array | Hex file load for all DDR regions.
10 | axi_mem_model.sv | All above | Full integration. Multi-master concurrent access. Protocol assertions.

# 9. Verification Plan

## 9.1 Simulation Model Tests

Test | Description
Single-beat read/write | Write 128-bit word, read it back. Verify data match. All byte lanes.
Burst read/write (16 beats) | Write burst-16, read burst-16. Verify all 16 beats match.
Burst read/write (256 beats) | Maximum AXI4 burst. Verify address increment, all 256 beats.
Byte-strobe partial write | Write with wstrb = 16'h000F (only first 4 bytes). Read back full 128-bit word. Verify only first 4 bytes changed, rest zero.
Multi-master interleaved | Two masters write to different addresses simultaneously. Verify no data corruption.
Read latency sweep | Configure READ_LATENCY from 1 to 50. Verify correct data and timing at each setting.
Backpressure mode 1 | Enable periodic backpressure. Verify DMA engines handle READY deassertion without data loss.
Backpressure mode 2 | Enable random backpressure. Run for 100K cycles. Verify no protocol violations.
Error injection | Configure error region at 0x7000_0000–0x7FFF_FFFF. Access within range: verify DECERR. Access outside: verify OKAY.
Outstanding limit | Set MAX_OUTSTANDING_RD=2. Issue 4 reads rapidly. Verify ARREADY deasserts after 2nd read until responses return.
Preload and readback | Preload hex file. Read all preloaded addresses. Verify bit-exact match.
Uninitialized read | Read address never written. Verify returns 0x00 (not X/Z).

## 9.2 DDR Wrapper Tests (FPGA path)

Test | Description
Burst splitting | Send AXI4 burst-256 through wrapper. Verify 16 AXI3 sub-bursts of 16 beats each. Verify address increment.
Width conversion | Send 128-bit write. Verify two 64-bit beats on AXI3 side with correct wstrb.
Narrow write through wrapper | CPU 32-bit write (via crossbar upsizer) through wrapper. Verify correct byte lane on 64-bit AXI3.
QoS mapping | Send transactions with all 5 master ID prefixes. Verify correct QoS values on AXI3 side.
End-to-end (with Zynq) | On FPGA: write pattern to DDR via wrapper, read back. Verify data integrity.

## 9.3 System-Level DDR Tests

Test | Description
Boot sequence | Firmware preloaded at DDR 0x0700_0000. Boot ROM copies to SRAM. CPU executes from SRAM. Verify firmware runs correctly.
Wake-word end-to-end | MFCC tensor preloaded at DDR INPUTS. NPU reads weights + MFCC. Runs DS-CNN. Verify "Marvin" classification output in DDR OUTPUTS.
Face recognition end-to-end | Test frame preloaded in DDR FRAME BUFFER. NPU runs BlazeFace + crop + MobileFaceNet. Verify embedding vector in DDR OUTPUTS.
Audio streaming simulation | Audio test stimulus → MFCC pipeline → DDR ring buffer. Verify ring buffer contents match expected PCM. Verify wrap-around.
Multi-use-case sequence | Wake-word → conversation streaming → face recognition → back to listening. Verify DDR contents correct at each transition.
Stress: NPU + Camera concurrent | NPU DMA burst-256 reads weights while camera DMA writes frame. Verify both complete with correct data. No corruption.
Stress: all masters active | All 5 masters issue transactions simultaneously. Verify no deadlock, all data correct, within starvation limit.

# 10. DDR Bandwidth Analysis (Updated with Conversation Streaming)

Subsystem | Peak BW | Duty | Effective | Notes
NPU DMA | ~1.6 GB/s | ~55% | ~0.9 GB/s | Dominant consumer. Burst-256 reads/writes.
Camera Video DMA | ~50 MB/s | ~10% | ~5 MB/s | One frame per 100–200ms capture trigger.
Camera Crop DMA | ~200 MB/s | < 1% | ~2 MB/s | One crop per face recognition event.
Audio MFCC DMA | ~1 MB/s | ~1% | ~0.01 MB/s | 980 bytes per ~1 second. Trivial.
Audio PCM Streaming | ~32 KB/s | ~100%* | ~0.03 MB/s | *Continuous during STREAMING state. Still trivial.
CPU iBus (DDR) | ~4 MB/s | ~5% | ~0.2 MB/s | Only at boot. After boot, instructions from SRAM.
CPU dBus (DDR) | ~4 MB/s | ~5% | ~0.2 MB/s | Ring buffer reads, NPU result reads, ESP32 data pump.
Total worst case | — | — | ~1.3 GB/s | All active simultaneously (unlikely but possible).

Available DDR bandwidth on Zybo Z7-20: ~4.0–5.0 GB/s effective. Worst-case SoC demand: ~1.3 GB/s = ~26–33% utilization. Comfortable headroom even with conversation streaming active during NPU inference.

# 11. ASIC Migration Notes

Item | FPGA (Phase 0) | ASIC 180nm (Phase 1)
DDR Controller | Zynq PS hardened DDR3 | Option A: on-chip test SRAM (2–4 MB) via SRAM compiler. Option B: custom DDR PHY (IIT Hyderabad).
DDR Wrapper | AXI4→AXI3 bridge + burst splitter + width converter | Option A: AXI4 slave → SRAM controller (no burst splitting needed). Option B: AXI4→DDR PHY interface.
Memory Size | 512 MB (board DDR3) | Option A: 2–4 MB on-chip (sufficient for single model test). Option B: external DDR3L module.
Connectivity | ESP32 via SPI on eval board | ESP32-C3 bare chip on test PCB. Same SPI interface.
Simulation Model | axi_mem_model.sv (unchanged) | Same simulation model. PHY-accurate DDR sim not needed for front-end.

For Phase 2 (28nm production): full external DDR3L/LPDDR4 with foundry DDR PHY hard macro. ESP32-C3 companion chip on product PCB (5mm x 5mm bare chip). SoC connects to ESP32-C3 via SPI on short board traces.

— End of DDR Memory Subsystem RTL Implementation Document —

AI Glasses SoC | Phase 0 FPGA → Phase 1 (180nm) → Phase 2 (28nm) | Version 1.0 | March 2026

Confidential — Page

DDR Memory Subsystem RTL Implementation AI Glasses SoC — Phase 0
