anirudhr-adtech/AI_GLASSES/AI_Smart_Glasses_docs/Specs and Sub system implementation document/NPU_Subsystem_Design_Document_Phase0.docx

NPU SUBSYSTEM DESIGN DOCUMENT

AI Glasses SoC — Phase 0 FPGA Prototype

8×8 INT8 MAC Array Accelerator | 128-bit AXI DMA | CPU-Scheduled Layers

Document Version | 1.0
Status | DRAFT — Architecture Lock
Phase | Phase 0 — FPGA Prototype
Author | Anirudh (Sole Architect)
Date | March 2026
ASIC Migration | Phase 1 — 180nm Test Vehicle (Chip 1)

# 1. Overview

The Neural Processing Unit (NPU) is the primary AI inference accelerator within the AI Glasses SoC. Its responsibility is to execute quantized neural network layers with high efficiency, offloading all compute-intensive operations from the RISC-V CPU.

The NPU is not a general-purpose processor. It is a fixed-function datapath optimized for INT8 matrix and convolution operations, controlled entirely by the CPU via memory-mapped registers.

## 1.1 Role in the System

- Executes convolutional and fully-connected layers for all three AI use cases
- Receives layer commands from the RISC-V CPU via AXI-Lite register writes
- Fetches weights and input tensors from DDR via 128-bit AXI DMA
- Stores output tensors back to DDR upon layer completion
- Raises an interrupt to the CPU on inference completion

## 1.2 What the NPU Does NOT Do

- Does not run MFCC preprocessing — handled by CPU or dedicated audio DSP block
- Does not run ISP-lite (resize, color conversion) — handled by camera pipeline block
- Does not execute Softmax — handled by RISC-V CPU in firmware
- Does not manage its own model loading — CPU programs all addresses

## 1.3 Locked Architecture Parameters

Parameter | Decision | Rationale
MAC Array Size | 8×8 (64 MACs) | Sufficient for 5+ FPS face recognition on FPGA
Data Precision | INT8 × INT8 → INT32 | TinyML standard; minimizes area and bandwidth
Layer Scheduling | CPU-scheduled | Simple, debuggable; CPU programs one layer at a time
DMA AXI Width | 128-bit | Required for face recognition throughput at 5+ FPS
Control Interface | AXI4-Lite (32-bit) | Consistent with CPU peripheral register access pattern
Target Clock (FPGA) | 200 MHz | Achievable on Zynq Z7-20 fabric
Supported Operations | Conv2D, FC, ReLU, ReLU6, MaxPool | Covers DS-CNN, BlazeFace, MobileFaceNet
Softmax | CPU-side only | Not in NPU datapath

# 2. Use Case Compute Requirements

The three Phase 0 use cases place different compute demands on the NPU. This section validates that the 8×8 INT8 MAC array is sufficient for all three.

Use Case | Model | Compute | Target Latency | NPU Feasibility
Wake Word Detection | DS-CNN | 20–40 MMAC | < 50ms | ✅ Trivially met — 8×8 array is overkill for this
Gesture Recognition | Tiny CNN | 10–20 MMAC | < 100ms | ✅ Easily met — smallest compute workload
Face Detection (BlazeFace) | BlazeFace | ~200–300 MMAC | < 200ms | ✅ Met at ~100–150ms
Face Embedding (MobileFaceNet) | MobileFaceNet | ~500–900 MMAC | < 300ms | ✅ Met at ~150ms; total ~300ms per recognition

Note: Face recognition latency of ~300ms total is acceptable for smart glasses. The use case is a triggered, one-shot event (not continuous video stream tracking). Effective throughput at ~50–60% DMA efficiency gives ~6–8 GMAC/s sustained from 12.8 GMAC/s theoretical peak.

# 3. NPU Microarchitecture

## 3.1 Top-Level Block Diagram

The NPU is organized into four functional planes: Control, Memory, Compute, and Interface.

NPU Subsystem — Top-Level Block View

┌──────────────────────────────────────────────────────────────┐

│ NPU SUBSYSTEM │

│ │

│ AXI4-Lite ──► NPU Controller ◄── Interrupt Out │

│ (CPU regs) │ │ │

│ │ └──────── Layer Config FSM │

│ │ │ │

│ DMA Engine ◄─────────────►│ │

│ 128-bit AXI Master │ │

│ ↕ │ │

│ DDR Memory │ │ │

│ (AXI Fabric) ▼ ▼ │

│ ┌──────────┐ ┌──────────────┐ │

│ │ Weight │ │ Activation │ │

│ │ Buffer │ │ Buffer │ │

│ │ (BRAM) │ │ (BRAM) │ │

│ └────┬─────┘ └──────┬───────┘ │

│ └──────────┬───────────┘ │

│ ▼ │

│ ┌──────────────────┐ │

│ │ 8×8 MAC ARRAY │ │

│ │ INT8 × INT8 │ │

│ │ → INT32 Accum │ │

│ └────────┬──────────┘ │

│ ▼ │

│ ┌──────────────────┐ │

│ │ Quantize Unit │ │

│ │ INT32 → INT8 │ │

│ └────────┬──────────┘ │

│ ▼ │

│ ┌──────────────────┐ │

│ │ Activation Unit │ │

│ │ ReLU / ReLU6 │ │

│ └────────┬──────────┘ │

│ │ Output Tensor │

│ ▼ │

│ DMA → DDR Write │

└──────────────────────────────────────────────────────────────┘

## 3.2 Internal Block Descriptions

### 3.2.1 NPU Controller

The NPU Controller is the top-level orchestrator. It receives layer execution commands from the CPU via AXI-Lite registers and sequences the DMA, MAC array, and output pipeline accordingly.

- Decodes layer type from LAYER_CONFIG register (Conv2D, FC, Pool)
- Programs DMA with source/destination addresses and transfer lengths
- Issues start signal to MAC array engine after DMA pre-fetch completes
- Monitors MAC array completion, triggers quantize and activation units
- Asserts NPU_DONE interrupt to CPU when output DMA write completes
- Updates STATUS register after each layer execution

### 3.2.2 MAC Array (8×8)

The core compute engine. Comprises 64 INT8 multiply-accumulate units arranged as an 8-wide, 8-deep systolic-style array. Each MAC performs:

Output[i] += Weight[i] × Input[i] (INT8 × INT8 → INT32 accumulate)

- 8 input channels processed per clock cycle
- 64 multiplications in parallel per cycle
- INT32 accumulator prevents overflow during deep layer accumulation
- Supports convolution (sliding window) and fully-connected layer (dot product) modes
- Pooling handled by a separate 2×2 max/avg pooling unit downstream of MAC

### 3.2.3 Weight Buffer (BRAM)

- Stores kernel weights for the current layer being executed
- Loaded from DDR via DMA before MAC array is started
- Dual-port BRAM: one port for DMA write, one port for MAC array read
- Capacity: 128KB (Phase 0 FPGA) — sufficient for largest single layer in MobileFaceNet
- Address striped to match MAC array parallelism (8 weights per read cycle)

### 3.2.4 Activation Buffer (BRAM)

- Stores input feature maps for the current layer
- Loaded from DDR via DMA (input tensor or previous layer output)
- Dual-port BRAM: one port for DMA write, one port for MAC array read
- Capacity: 128KB (Phase 0 FPGA)
- Supports NHWC tensor layout (consistent with TFLite quantized model format)

### 3.2.5 DMA Engine

The DMA engine manages all data movement between DDR and the on-chip BRAM buffers. It operates as a 128-bit AXI4 Master on the high-bandwidth AXI fabric.

- Two independent channels: Weight DMA (DDR → Weight Buffer) and Activation DMA (DDR ↔ Activation Buffer)
- 128-bit AXI4 burst transfers — up to 16 bytes per clock at 200MHz = 3.2 GB/s peak
- Configurable burst length (up to 256 beats per burst transaction)
- Stride support: handles non-contiguous tensor layouts (NHWC convolution access patterns)
- Transfer completion status visible in STATUS register
- Fires internal 'pre-fetch done' signal to NPU Controller before MAC start

### 3.2.6 Quantization Unit

Converts INT32 MAC accumulator output back to INT8 for the next layer or DDR writeback. Uses per-layer scale and shift parameters programmed by the CPU.

INT8_out = clamp( (INT32_accum >> SHIFT) * SCALE, -128, +127 )

- SHIFT and SCALE loaded from QUANT_PARAM register before layer start
- Saturation clamp prevents overflow on final INT8 output
- Bit-accurate match to TFLite INT8 quantization specification required

### 3.2.7 Activation Unit

- Applies non-linear activation function to quantized output
- Supported functions: ReLU (clamp to 0), ReLU6 (clamp to 0–6 in INT8 scaled domain)
- Bypass mode available for layers that do not require activation (e.g., final FC layer before Softmax)
- Activation type selected via ACT_TYPE field in LAYER_CONFIG register

# 4. NPU Register Map

All NPU registers are accessible via AXI4-Lite from the RISC-V CPU. Base address: 0x3000_0000 (consistent with RISC-V subsystem memory map).

Offset | Register Name | R/W | Reset | Description
0x00 | CONTROL | R/W | 0x0 | Bit[0]: Global NPU enable. Bit[1]: Soft reset (self-clearing). Bit[2]: IRQ enable.
0x04 | STATUS | RO | 0x0 | Bit[0]: NPU busy. Bit[1]: Layer done. Bit[2]: DMA busy. Bit[3]: Error flag.
0x08 | INPUT_ADDR | R/W | 0x0 | DDR base address of input activation tensor for current layer.
0x0C | WEIGHT_ADDR | R/W | 0x0 | DDR base address of weight tensor for current layer.
0x10 | OUTPUT_ADDR | R/W | 0x0 | DDR base address where output tensor will be written.
0x14 | INPUT_SIZE | R/W | 0x0 | Transfer size in bytes for input activation DMA.
0x18 | WEIGHT_SIZE | R/W | 0x0 | Transfer size in bytes for weight DMA.
0x1C | OUTPUT_SIZE | R/W | 0x0 | Transfer size in bytes for output DMA write.
0x20 | LAYER_CONFIG | R/W | 0x0 | Bits[3:0]: Layer type (0=Conv2D, 1=FC, 2=MaxPool, 3=AvgPool). Bits[7:4]: ACT_TYPE (0=None, 1=ReLU, 2=ReLU6). Bits[15:8]: Input channels. Bits[23:16]: Output channels.
0x24 | CONV_CONFIG | R/W | 0x0 | Bits[7:0]: Kernel size (e.g., 3 for 3×3). Bits[15:8]: Stride. Bits[23:16]: Padding mode (0=VALID, 1=SAME).
0x28 | TENSOR_DIMS | R/W | 0x0 | Bits[15:0]: Input H×W. Bits[31:16]: Output H×W (for ISP pre-computed dimensions).
0x2C | QUANT_PARAM | R/W | 0x0 | Bits[15:0]: Scale factor (fixed-point). Bits[23:16]: Right-shift amount for INT32→INT8.
0x30 | START | WO | — | Write 0x1 to begin layer execution. Clears automatically. NPU Controller begins DMA pre-fetch immediately.
0x34 | IRQ_CLEAR | WO | — | Write 0x1 to clear NPU_DONE interrupt after CPU has read the output.
0x38 | PERF_CYCLES | RO | 0x0 | Cycle count for last layer execution (cleared on START). Useful for latency profiling.
0x3C | DMA_STATUS | RO | 0x0 | Bit[0]: Weight DMA done. Bit[1]: Activation DMA done. Bit[2]: Output DMA done.

# 5. CPU-NPU Execution Flow

## 5.1 Per-Layer Execution Sequence

For each neural network layer, the RISC-V CPU executes the following firmware sequence:

Step | CPU Action | NPU Response
1 | Write INPUT_ADDR, WEIGHT_ADDR, OUTPUT_ADDR | Registers latched in NPU Controller
2 | Write INPUT_SIZE, WEIGHT_SIZE, OUTPUT_SIZE | DMA transfer lengths configured
3 | Write LAYER_CONFIG, CONV_CONFIG, TENSOR_DIMS | Layer type, kernel size, activation type latched
4 | Write QUANT_PARAM (scale + shift) | Quantization unit configured
5 | Write 0x1 to START register | NPU Controller begins: fires both Weight DMA and Activation DMA in parallel
6 | Wait for NPU_DONE interrupt (WFI) | DMA pre-fetch completes → MAC array starts → Quantize → Activate → Output DMA write → IRQ asserted
7 | Read STATUS, optionally PERF_CYCLES | Status reflects layer completion
8 | Write 0x1 to IRQ_CLEAR | Interrupt deasserted. NPU ready for next layer.
9 | Update INPUT_ADDR = OUTPUT_ADDR (chain layers) | Output tensor from this layer becomes input to next

## 5.2 Face Recognition Full Inference Flow

Example showing how the CPU orchestrates the NPU across the complete two-stage face recognition pipeline:

// Stage 1: BlazeFace — Face Detection

load_model_to_DDR(blazeface_weights, DDR_WEIGHTS_BASE);

for each layer L in blazeface_model:

npu_program_layer(L); // writes all NPU registers

npu_start(); // write START register

wait_for_npu_done(); // WFI until IRQ

bounding_box = cpu_postprocess_detection(DDR_OUTPUT_BASE);

cpu_crop_and_align(frame_buffer, bounding_box, crop_buffer);

// Stage 2: MobileFaceNet — Face Embedding

load_model_to_DDR(mobilefacenet_weights, DDR_WEIGHTS_BASE);

for each layer L in mobilefacenet_model:

npu_program_layer(L);

npu_start();

wait_for_npu_done();

embedding = read_output_tensor(DDR_OUTPUT_BASE);

identity = cpu_cosine_similarity(embedding, enrolled_faces);

# 6. NPU Memory Architecture

## 6.1 On-Chip Buffer Sizes

Buffer | FPGA (Phase 0) | ASIC 180nm (Phase 1) | Notes
Weight Buffer | 128 KB | 128 KB | Largest single layer kernel in MobileFaceNet fits in 64KB; 128KB gives double-buffer headroom
Activation Buffer | 128 KB | 128 KB | Largest intermediate tensor in BlazeFace is ~80KB; 128KB sufficient
Output Buffer | 64 KB | 64 KB | Output tensor of each layer; written to DDR by DMA immediately after activation
Total On-Chip SRAM | 320 KB | 320 KB | Manageable — ~30-40 BRAM18 blocks on Zynq Z7-20

## 6.2 DDR Memory Map (NPU Regions)

Consistent with the DDR memory map defined in the Phase 0 Simulation Validation Plan:

Region | Base Address | Size | Contents
WEIGHTS | 0x0000_0000 | 16 MB | All model weights (BlazeFace + MobileFaceNet + DS-CNN + Gesture)
INPUTS | 0x0100_0000 | 16 MB | Input tensors and feature buffers per layer
WORK | 0x0200_0000 | 16 MB | Intermediate tensors and scratch space
OUTPUTS | 0x0300_0000 | 16 MB | Output tensors, inference results, embedding vectors
FRAME BUFFER | 0x0400_0000 | 32 MB | Camera frame buffers (YUV/RGB), crop buffers

# 7. AXI Interface Specification

Interface | Type | Width | Connected To
s_axi_lite | AXI4-Lite Slave | 32-bit | RISC-V CPU data bus (register access)
m_axi_dma | AXI4 Master | 128-bit | DDR Controller via AXI High-Performance port
irq_npu_done | Output Signal | 1-bit | Interrupt Controller (IRQ aggregator)
clk / rst_n | Clock / Reset | 1-bit each | SoC global clock and active-low reset

## 7.1 DMA AXI4 Burst Parameters

- AXI4 data width: 128-bit (16 bytes per beat)
- Max burst length: 256 beats (AWLEN/ARLEN = 255)
- Burst type: INCR (incrementing address)
- Outstanding transactions: up to 4 read transactions, up to 2 write transactions
- Address alignment: all DMA transfers aligned to 16-byte boundary
- Write response: BVALID/BREADY handshake; NPU stalls output DMA until BRESP = OKAY

# 8. FPGA Resource Estimate

Estimated resource utilization for the NPU subsystem on Zynq Z7-20 (target Phase 0 board). Does not include RISC-V CPU subsystem or peripheral blocks.

Resource | Estimate | Z7-20 Total | Headroom
DSP48 (MAC units) | 64–80 | 220 | ~64% used — leaves room for RISC-V and peripherals
BRAM18 (on-chip buffers) | 36–40 | 280 | ~14% used — very comfortable
LUT (control logic, DMA, FSM) | 15K–22K | 85K | ~20–25% used — within target
FF (pipeline registers) | 8K–12K | 106K | ~10% used — comfortable
Target Fmax | 200 MHz | N/A | Achievable with pipelined MAC design and proper timing constraints

Note: 16×16 MAC array (256 MACs) would require ~256 DSPs — exceeding Z7-20 capacity when combined with the RISC-V subsystem. This confirms 8×8 as the correct array size for Phase 0.

# 9. ASIC Migration Notes — Phase 1 (180nm Test Chip)

The NPU subsystem documented here will be taped out as Chip 1 (standalone test vehicle) at SCL Mohali on 180nm CMOS. The microarchitecture is identical to Phase 0 FPGA; the changes are implementation-level only.

Item | FPGA (Phase 0) | ASIC 180nm (Phase 1)
BRAM / SRAM | Xilinx BRAM primitives | SCL Mohali SRAM compiler (from PDK)
DSP / MAC units | DSP48 primitives | Standard cell synthesized MAC array
Clock | 200 MHz (FPGA fabric) | Target 300–400 MHz post-synthesis
Target die area | N/A | ~3×3mm (Chip 1, includes test pads)
RTL changes | FPGA-specific primitives | Replace with technology-independent RTL; no microarch change
AXI interfaces | Connected to Zynq HP port | Connected to AXI interconnect in test chip (with DDR PHY or SRAM model)
Analog blocks | Not applicable | None in Chip 1 — pure digital NPU test vehicle

The primary validation goal of Chip 1 at 180nm is: (1) confirm INT8 MAC datapath bit-accuracy in silicon, (2) validate AXI DMA bandwidth at target clock, (3) measure actual power vs. estimates, (4) characterize timing margins.

# 10. RTL Implementation Plan

## 10.1 RTL Module Hierarchy

npu_top.sv // Top-level wrapper + AXI port declarations

├── npu_controller.sv // Layer FSM, register decode, sequencer

├── npu_regfile.sv // AXI4-Lite slave + register file

├── npu_dma.sv // 128-bit AXI4 master, burst engine

│ ├── dma_weight_ch.sv // Weight DMA channel

│ └── dma_act_ch.sv // Activation DMA channel

├── npu_weight_buf.sv // Weight BRAM wrapper (128KB)

├── npu_act_buf.sv // Activation BRAM wrapper (128KB)

├── npu_mac_array.sv // 8×8 INT8 MAC array

│ └── mac_unit.sv // Single INT8×INT8→INT32 MAC cell

├── npu_quantize.sv // INT32→INT8 scale/shift/clamp

└── npu_activation.sv // ReLU / ReLU6 / bypass

## 10.2 Recommended RTL Generation Sequence (Claude Agent)

1. mac_unit.sv — single MAC cell (smallest, easiest to verify in isolation)
2. npu_mac_array.sv — 8×8 instantiation of mac_unit with accumulator bank
3. npu_quantize.sv — parameterized scale/shift/clamp unit
4. npu_activation.sv — ReLU/ReLU6/bypass with config input
5. npu_weight_buf.sv and npu_act_buf.sv — BRAM wrappers with dual-port interface
6. npu_regfile.sv — AXI4-Lite slave with all registers from Section 4
7. npu_dma.sv — 128-bit AXI4 master with burst engine
8. npu_controller.sv — top-level FSM connecting all blocks
9. npu_top.sv — final integration wrapper

Each module should be generated, reviewed, and unit-tested before proceeding to the next. The controller FSM is last because it depends on all sub-block interfaces being stable.

# 11. Open Items & Decisions Pending

# | Open Item | Impact | Owner / Target

1 | Pooling: implement in NPU or delegate to CPU firmware? | Small — pooling layers are infrequent in TinyML | Decide before RTL coding of mac_array
2 | Double-buffering in Weight/Activation buffers (load next layer while computing current)? | Performance improvement but doubles BRAM usage | Evaluate after Phase 0 latency measurements
3 | Depthwise separable convolution support (used in MobileNet family)? | Required for MobileFaceNet efficiency | Anirudh to confirm model layer types
4 | NPU clock domain — same as SoC system clock or separate gated domain? | Power management implications for ASIC | Decide before Phase 1 PD
5 | MAC array dataflow: weight-stationary vs output-stationary? | Affects BRAM access pattern and efficiency | Decide before RTL coding of mac_array

— End of NPU Subsystem Design Document —

AI Glasses SoC | Phase 0 FPGA → Phase 1 (180nm) | Version 1.0 | March 2026
