anirudhr-adtech/AI_GLASSES/AI_Smart_Glasses_docs/Specs and Sub system implementation document/RISCV_Subsystem_RTL_Implementation_v2.docx

RISC-V SUBSYSTEM

RTL IMPLEMENTATION DOCUMENT

AI Glasses SoC — Phase 0 FPGA Prototype

Ibex RV32IMC CPU | AXI4 Interconnect | Peripheral Subsystem

Field | Value
Document Version | 1.0
Status | DRAFT — Architecture Lock
Phase | Phase 0 — FPGA Prototype
Author | Anirudh (Sole Architect)
Date | March 2026
ASIC Migration | Phase 1 — 180nm Test Vehicle
Companion Docs | NPU Subsystem Design Document, Phase 0 Data Path Architecture, Phase 0 Simulation Validation Plan

# 1. Overview

The RISC-V subsystem is the central control processor for the AI Glasses SoC. It is responsible for system orchestration, peripheral management, and accelerator scheduling. All compute-intensive workloads (AI inference, media processing) are offloaded to dedicated hardware accelerators (NPU, DMA engines), while the CPU handles initialization, configuration, interrupt servicing, and lightweight data processing.

This document provides the RTL-level implementation specification required for Claude AI agents to generate synthesizable SystemVerilog. Every interface is defined at signal level, every FSM is specified with state transitions, and every register is described with bit-field precision.

## 1.1 Role in the System

- System boot and initialization (boot ROM execution, SRAM setup)
- Peripheral configuration (UART, I2S, I2C, camera control, audio control)
- DMA descriptor programming and transfer initiation
- NPU layer-by-layer command scheduling (register writes, START, interrupt wait)
- Interrupt handling (DMA done, NPU done, timer, peripheral events)
- Lightweight signal processing (Softmax, cosine similarity, MFCC in firmware)
- Debug console via UART

## 1.2 What the CPU Does NOT Do

- Does not execute convolution or matrix multiply — NPU handles all AI compute
- Does not perform DMA transfers — programs DMA engine then waits for interrupt
- Does not run Linux — bare-metal firmware in machine mode only
- Does not implement DDR PHY — uses Zynq PS DDR controller in FPGA, external PHY in ASIC

## 1.3 Locked Architecture Parameters

Parameter | Decision | Rationale
CPU Core | Ibex RV32IMC | Mature, synthesizable, Google/lowRISC backed, Apache 2.0 license
ISA | RV32I + M + C | Base integer + multiply/divide + compressed instructions
Execution Mode | Machine mode only | No MMU needed; bare-metal firmware
Instruction Bus | AXI4 Read Master | Consistent with SoC fabric; adapted from Ibex native bus
Data Bus | AXI4 Full Master | Read + Write for peripheral and memory access
Peripheral Bus | AXI4-Lite | Simple register interface for all peripherals
On-Chip SRAM | 512 KB (FPGA) | Stack, heap, firmware code, runtime buffers
Boot ROM | 4 KB | Minimal boot code; copies firmware from DDR to SRAM
Target Clock (FPGA) | 100 MHz | Conservative for Ibex + interconnect timing closure
Target Clock (ASIC) | 200–300 MHz | 180nm SCL Mohali post-synthesis target

# 2. RTL Module Hierarchy

The following module hierarchy defines the complete RISC-V subsystem. Each module name maps to a single SystemVerilog file. Module boundaries are chosen to enable independent unit testing and clean integration.

riscv_subsys_top.sv // Top-level wrapper + port declarations

├── ibex_core_wrapper.sv // Ibex CPU instantiation + config parameters

│ └── ibex_core.sv // [EXTERNAL] Ibex RTL from GitHub

├── ibus_axi_adapter.sv // Instruction bus → AXI4 Read Master adapter

├── dbus_axi_adapter.sv // Data bus → AXI4 Full Master adapter

├── axi_interconnect.sv // AXI4 crossbar (3 masters, 4 slaves)

│ ├── axi_arbiter.sv // Round-robin arbiter with priority override

│ └── axi_addr_decoder.sv // Address-based slave routing

├── axilite_interconnect.sv // AXI4-Lite crossbar (1 master, 8 slaves)

│ └── axilite_addr_decoder.sv // Peripheral address decode

├── axi_to_axilite_bridge.sv // AXI4 → AXI4-Lite protocol bridge

├── boot_rom.sv // 4 KB read-only memory (initialized from hex)

├── onchip_sram.sv // 512 KB dual-port SRAM (BRAM wrapper)

│ └── sram_bank.sv // Single SRAM bank (configurable width/depth)

├── timer_clint.sv // CLINT-compatible timer (mtime + mtimecmp)

├── irq_controller.sv // Interrupt aggregator with priority encoding

├── uart_peripheral.sv // UART TX/RX with FIFO

│ ├── uart_tx.sv // UART transmitter FSM

│ ├── uart_rx.sv // UART receiver FSM

│ └── uart_fifo.sv // Synchronous FIFO (parameterized)

├── gpio_peripheral.sv // General-purpose I/O with direction control

└── rst_sync.sv // Reset synchronizer (2-FF)

## 2.1 Recommended RTL Generation Sequence (Claude Agent)

Each module should be generated, reviewed, and unit-tested before proceeding. Dependencies flow bottom-up:

# | Module | Dependencies | Unit Test Focus

1 | rst_sync.sv | None | Reset assertion/deassertion timing
2 | uart_fifo.sv | None | Full/empty flags, overflow, underflow
3 | uart_tx.sv | None | Baud timing, start/stop/data bits
4 | uart_rx.sv | None | Sampling, oversampling, framing error
5 | uart_peripheral.sv | uart_tx, uart_rx, uart_fifo | AXI-Lite register R/W, TX/RX loopback
6 | gpio_peripheral.sv | None | Direction control, read/write, interrupt
7 | timer_clint.sv | None | mtime increment, compare match, interrupt
8 | irq_controller.sv | None | Priority encoding, pending/enable/clear
9 | boot_rom.sv | None | Read-only access, hex file loading
10 | sram_bank.sv | None | Read/write, byte enables
11 | onchip_sram.sv | sram_bank | Banked access, dual-port arbitration
12 | ibus_axi_adapter.sv | None | Ibex ibus protocol → AXI4 read
13 | dbus_axi_adapter.sv | None | Ibex dbus protocol → AXI4 R/W
14 | axi_addr_decoder.sv | None | Address range matching
15 | axi_arbiter.sv | None | Round-robin fairness, priority mode
16 | axi_interconnect.sv | axi_arbiter, axi_addr_decoder | Multi-master routing, no deadlock
17 | axilite_addr_decoder.sv | None | Peripheral address decode
18 | axilite_interconnect.sv | axilite_addr_decoder | Register access routing
19 | axi_to_axilite_bridge.sv | None | Protocol translation, single-beat only
20 | ibex_core_wrapper.sv | [EXTERNAL] ibex_core | Parameterization, interface mapping
21 | riscv_subsys_top.sv | All above | Full integration, boot sequence

# 3. Ibex CPU Core Interface Specification

The Ibex core uses a simple valid/ready handshake protocol on both instruction and data buses. These are NOT AXI-native, so bus adapters are required. This section defines the exact Ibex-side signals that the adapters must connect to.

## 3.1 Instruction Bus (iBus) Signals

Signal | Width | Direction | Description
instr_req_o | 1 | CPU → Adapter | Instruction fetch request. Asserted when CPU needs next instruction.
instr_gnt_i | 1 | Adapter → CPU | Grant signal. Adapter asserts when it can accept the request.
instr_rvalid_i | 1 | Adapter → CPU | Read data valid. Asserted when instr_rdata_i is valid (may be multiple cycles after grant).
instr_addr_o | 32 | CPU → Adapter | Instruction fetch address. Always word-aligned (bits [1:0] = 2'b00).
instr_rdata_i | 32 | Adapter → CPU | Fetched instruction data. Valid only when instr_rvalid_i = 1.
instr_err_i | 1 | Adapter → CPU | Fetch error indication (bus error, decode error). Valid with instr_rvalid_i.

Protocol: The CPU asserts instr_req_o with instr_addr_o. The adapter asserts instr_gnt_i when the request is accepted (may be same cycle or later). Some cycles later, the adapter asserts instr_rvalid_i with the fetched data. The CPU may pipeline: it can assert a new req before the previous rvalid returns. The adapter must handle up to 2 outstanding requests.

## 3.2 Data Bus (dBus) Signals

Signal | Width | Direction | Description
data_req_o | 1 | CPU → Adapter | Data access request (load or store).
data_gnt_i | 1 | Adapter → CPU | Grant signal. Adapter accepts the request.
data_rvalid_i | 1 | Adapter → CPU | Read data valid (for loads) or write acknowledge (for stores).
data_we_o | 1 | CPU → Adapter | Write enable. 1 = store, 0 = load. Valid with data_req_o.
data_be_o | 4 | CPU → Adapter | Byte enable. One bit per byte lane. Enables sub-word access.
data_addr_o | 32 | CPU → Adapter | Data address. May be unaligned for byte/halfword access.
data_wdata_o | 32 | CPU → Adapter | Write data. Valid when data_req_o = 1 and data_we_o = 1.
data_rdata_i | 32 | Adapter → CPU | Read data. Valid when data_rvalid_i = 1 and original request was a load.
data_err_i | 1 | Adapter → CPU | Access error. Valid with data_rvalid_i.

Protocol: Same req/gnt/rvalid handshake as iBus but supports both reads and writes. For stores, data_rvalid_i indicates write completion (BRESP received from AXI). The adapter must handle up to 1 outstanding data transaction (Ibex does not pipeline data requests in its default configuration).

## 3.3 CPU Interrupt Signals

Signal | Width | Direction | Description
irq_timer_i | 1 | Timer → CPU | Machine timer interrupt (CLINT). Directly connected to timer_clint block.
irq_external_i | 1 | IRQ Ctrl → CPU | Machine external interrupt. Single line from irq_controller priority encoder output.
irq_software_i | 1 | Tied to 0 | Machine software interrupt. Not used in Phase 0 (no multi-hart).

## 3.4 Ibex Wrapper Configuration Parameters

Parameter | Value | Description
RV32M | ibex_pkg::RV32MSingleCycle | Single-cycle multiplier (uses DSP48 on FPGA)
RV32B | ibex_pkg::RV32BNone | No bit manipulation (not needed for control tasks)
RegFile | ibex_pkg::RegFileFF | Flip-flop based register file (FPGA portable)
BranchTargetALU | 1 | Separate ALU for branch target calc (improves Fmax)
WritebackStage | 0 | 2-stage pipeline (fetch + execute). Simpler, sufficient for 100 MHz.
DbgTriggerEn | 0 | Debug triggers disabled for Phase 0
SecureIbex | 0 | Security features disabled for Phase 0
DmHaltAddr | 32'h0000_0000 | Debug halt address (unused, no debug module in Phase 0)
DmExceptionAddr | 32'h0000_0000 | Debug exception address (unused)

# 4. Bus Adapter Microarchitecture

The bus adapters translate between Ibex’s native req/gnt/rvalid protocol and the AXI4 protocol used by the SoC interconnect. Each adapter is a small FSM with registered outputs for clean timing.

## 4.1 Instruction Bus Adapter (ibus_axi_adapter.sv)

Converts Ibex instruction fetch requests into AXI4 Read-Only transactions. Supports up to 2 outstanding reads to match Ibex’s instruction prefetch capability.

### 4.1.1 Port List

Port | Width | Direction | Description
clk_i | 1 | Input | System clock
rst_ni | 1 | Input | Active-low reset
instr_req_i | 1 | Input | From Ibex instr_req_o
instr_gnt_o | 1 | Output | To Ibex instr_gnt_i
instr_rvalid_o | 1 | Output | To Ibex instr_rvalid_i
instr_addr_i | 32 | Input | From Ibex instr_addr_o
instr_rdata_o | 32 | Output | To Ibex instr_rdata_i
instr_err_o | 1 | Output | To Ibex instr_err_i
m_axi_arvalid | 1 | Output | AXI AR channel valid
m_axi_arready | 1 | Input | AXI AR channel ready
m_axi_araddr | 32 | Output | AXI read address
m_axi_arlen | 8 | Output | Burst length (fixed 0 = single beat)
m_axi_arsize | 3 | Output | Beat size (3'b010 = 4 bytes)
m_axi_arburst | 2 | Output | Burst type (2'b01 = INCR)
m_axi_arid | 4 | Output | Transaction ID (for outstanding tracking)
m_axi_rvalid | 1 | Input | AXI R channel valid
m_axi_rready | 1 | Output | AXI R channel ready
m_axi_rdata | 32 | Output | AXI read data
m_axi_rresp | 2 | Input | AXI read response
m_axi_rid | 4 | Input | AXI read ID tag

### 4.1.2 FSM States

State | Behavior
IDLE | No pending request. Waits for instr_req_i = 1. On request, asserts m_axi_arvalid with address, transitions to AR_WAIT.
AR_WAIT | Waiting for AXI AR handshake. When m_axi_arready = 1, address is accepted. Assert instr_gnt_o to Ibex. Transition to R_WAIT. If Ibex issues another req before rvalid, queue it (up to 1 pending).
R_WAIT | Waiting for AXI R channel response. When m_axi_rvalid = 1, capture rdata, assert instr_rvalid_o. If rresp != OKAY, assert instr_err_o. Transition to IDLE (or AR_WAIT if queued request pending).

Key design rule: instr_gnt_o is asserted in the same cycle that the AXI AR handshake completes (arvalid && arready). instr_rvalid_o is asserted in the same cycle as AXI R handshake (rvalid && rready). The adapter always asserts m_axi_rready = 1 (never backpressures the read channel).

## 4.2 Data Bus Adapter (dbus_axi_adapter.sv)

Converts Ibex data load/store requests into AXI4 Read or Write transactions. Supports 1 outstanding transaction.

### 4.2.1 Port List

Port | Width | Direction | Description
clk_i | 1 | Input | System clock
rst_ni | 1 | Input | Active-low reset
data_req_i | 1 | Input | From Ibex data_req_o
data_gnt_o | 1 | Output | To Ibex data_gnt_i
data_rvalid_o | 1 | Output | To Ibex data_rvalid_i
data_we_i | 1 | Input | From Ibex data_we_o (1=write)
data_be_i | 4 | Input | From Ibex data_be_o (byte enables)
data_addr_i | 32 | Input | From Ibex data_addr_o
data_wdata_i | 32 | Input | From Ibex data_wdata_o
data_rdata_o | 32 | Output | To Ibex data_rdata_i
data_err_o | 1 | Output | To Ibex data_err_i
m_axi_aw* | various | Output | AXI Write Address channel signals
m_axi_w* | various | Output | AXI Write Data channel signals
m_axi_b* | various | Input | AXI Write Response channel signals
m_axi_ar* | various | Output | AXI Read Address channel signals
m_axi_r* | various | Input | AXI Read Data channel signals

### 4.2.2 FSM States

State | Behavior
IDLE | Waits for data_req_i. On request, check data_we_i: if 0 (load) → AR_WAIT; if 1 (store) → AW_WAIT.
AR_WAIT | Assert m_axi_arvalid. On arready, grant Ibex (data_gnt_o = 1). Transition to R_WAIT.
R_WAIT | Wait for m_axi_rvalid. Capture rdata, assert data_rvalid_o. Transition to IDLE.
AW_WAIT | Assert m_axi_awvalid and m_axi_wvalid simultaneously (single-beat write). Map data_be_i to m_axi_wstrb. On aw+w handshake, grant Ibex. Transition to B_WAIT.
B_WAIT | Wait for m_axi_bvalid (write response). Assert data_rvalid_o as write acknowledge. Transition to IDLE.

Byte enable mapping: data_be_i[3:0] maps directly to m_axi_wstrb[3:0]. For byte access (LB/SB), only one bit is set. For halfword (LH/SH), two adjacent bits are set. For word (LW/SW), all four bits are set.

# 5. AXI4 Interconnect Architecture

The AXI4 interconnect is a shared-bus crossbar connecting three masters to four slaves. It implements round-robin arbitration with a priority override for DMA to ensure NPU bandwidth is not starved by CPU instruction fetches.

## 5.1 Master and Slave Port Mapping

ID | Master | AXI ID Prefix | Traffic Pattern
M0 | CPU Instruction (iBus adapter) | 4'b00xx | Read-only, single-beat, sequential
M1 | CPU Data (dBus adapter) | 4'b01xx | Read + Write, single-beat, random
M2 | NPU DMA Engine | 4'b10xx | Read + Write, burst (up to 256 beats), high bandwidth

ID | Slave | Address Range | Notes
S0 | Boot ROM | 0x0000_0000 – 0x0000_0FFF | 4 KB, read-only
S1 | On-Chip SRAM | 0x1000_0000 – 0x1007_FFFF | 512 KB, R/W
S2 | Peripheral Bridge (AXI → AXI-Lite) | 0x2000_0000 – 0x4FFF_FFFF | Covers all peripheral + NPU + DMA regs
S3 | DDR Controller | 0x8000_0000 – 0xFFFF_FFFF | 2 GB addressable, Zynq HP port

## 5.2 Address Decoder Logic (axi_addr_decoder.sv)

The address decoder is purely combinational. It examines the upper bits of the AXI address to route transactions to the correct slave.

// Address decode logic (simplified)

always_comb begin

case (axi_addr[31:28])

4'h0: slave_sel = S0_BOOT_ROM; // 0x0xxx_xxxx

4'h1: slave_sel = S1_SRAM; // 0x1xxx_xxxx

4'h2, 4'h3, 4'h4:

slave_sel = S2_PERIPH_BRIDGE; // 0x2xxx – 0x4xxx

default: slave_sel = S3_DDR; // 0x8xxx_xxxx+

endcase

end

## 5.3 Arbiter Design (axi_arbiter.sv)

- Default mode: round-robin across M0, M1, M2
- Priority override: when DMA (M2) has a pending burst request, it gets priority over M0 (iBus) to prevent NPU stalls. M1 (dBus) maintains equal priority with M2 to avoid CPU deadlock during NPU register programming.
- Arbitration granularity: per-burst (not per-beat). Once a burst is granted, it completes without preemption.
- Starvation prevention: any master blocked for >16 cycles gets elevated priority on next arbitration round.

# 6. AXI4-Lite Peripheral Fabric

The AXI4-Lite peripheral fabric connects the CPU data master (via the AXI-to-AXI-Lite bridge) to all memory-mapped peripheral registers. It is a simple 1-master, N-slave topology with address-based routing.

## 6.1 AXI-to-AXI-Lite Bridge (axi_to_axilite_bridge.sv)

This bridge converts AXI4 transactions to AXI4-Lite. It strips burst capability (only single-beat pass-through) and removes AXI ID tags. Any burst transaction targeting the peripheral region is rejected with SLVERR.

## 6.2 Peripheral Address Map

Base Address | End Address | Size | Peripheral
0x2000_0000 | 0x2000_00FF | 256 B | UART
0x2000_0100 | 0x2000_01FF | 256 B | Timer (CLINT-Lite)
0x2000_0200 | 0x2000_02FF | 256 B | Interrupt Controller
0x2000_0300 | 0x2000_03FF | 256 B | GPIO
0x2000_0400 | 0x2000_04FF | 256 B | Camera Control Interface
0x2000_0500 | 0x2000_05FF | 256 B | Audio Control Interface
0x2000_0600 | 0x2000_06FF | 256 B | I2C Master (IMU)
0x2000_0700 | 0x2000_07FF | 256 B | SPI Master
0x3000_0000 | 0x3000_00FF | 256 B | NPU Registers
0x4000_0000 | 0x4000_00FF | 256 B | DMA Registers

Decode logic: The AXI4-Lite address decoder uses bits [27:8] of the address for peripheral selection. Bits [7:0] are the register offset within each peripheral. Accesses to unmapped regions return SLVERR.

# 7. Boot ROM (boot_rom.sv)

The boot ROM contains the initial firmware executed on reset. The PC resets to 0x0000_0000, which is the base address of the boot ROM.

## 7.1 Specification

Parameter | Value
Size | 4 KB (1024 x 32-bit words)
Address Range | 0x0000_0000 – 0x0000_0FFF
Access | Read-only. Writes are silently ignored (no SLVERR).
Initialization | Loaded from hex file at synthesis/simulation time via $readmemh
AXI Interface | AXI4 Slave, single-beat reads only, 1-cycle read latency
Content | Boot code: initialize stack pointer, copy firmware from DDR to SRAM, jump to SRAM entry point

## 7.2 Boot Sequence

Step | Action | Detail
1 | CPU comes out of reset | PC = 0x0000_0000 (boot ROM base)
2 | Initialize stack pointer | SP = 0x1007_FFF0 (top of 512 KB SRAM, 16-byte aligned)
3 | Initialize global pointer | GP = 0x1004_0000 (middle of SRAM for efficient addressing)
4 | Copy .text + .data from DDR | DMA or CPU memcpy from DDR 0x8000_0000 to SRAM 0x1000_0000
5 | Jump to SRAM entry | jalr x0, x1, 0 where x1 = 0x1000_0000 (SRAM base)
6 | Firmware initializes peripherals | UART baud, timer, IRQ enable, GPIO directions
7 | Enter main loop | Wait for interrupts (WFI), service NPU/DMA/peripheral events

# 8. On-Chip SRAM Subsystem (onchip_sram.sv)

## 8.1 Specification

Parameter | Value
Total Size | 512 KB
Organization | 4 banks x 128 KB each
Bank Width | 32 bits (4 bytes per word)
Bank Depth | 32,768 words per bank
Implementation | FPGA: Xilinx BRAM inference. ASIC: SCL 180nm SRAM compiler.
Address Range | 0x1000_0000 – 0x1007_FFFF
Ports | Dual-port: Port A (iBus read), Port B (dBus read/write)
Access Latency | 1 clock cycle (registered output)
Byte Enables | 4-bit write byte enable on Port B (supports sub-word stores)

## 8.2 Banking and Arbitration

Address bits [18:17] select the bank. Bits [16:2] select the word within a bank. Bits [1:0] are the byte offset (used by CPU byte-enable logic, not by SRAM directly).

Dual-port access arbitration: Port A (iBus) is read-only, Port B (dBus) is read/write. When both ports access the same bank in the same cycle, Port B (data) wins and Port A (instruction) stalls for 1 cycle. This is rare because instruction fetch and data access typically hit different banks (code region vs. stack/heap).

## 8.3 SRAM Memory Layout

Region | Start | End | Usage
.text (firmware code) | 0x1000_0000 | 0x1003_FFFF | 256 KB max firmware image
.data + .bss | 0x1004_0000 | 0x1005_FFFF | 128 KB initialized + uninitialized data
Heap | 0x1006_0000 | 0x1006_FFFF | 64 KB dynamic allocation
Stack | 0x1007_0000 | 0x1007_FFFF | 64 KB stack (grows downward from 0x1007_FFF0)

# 9. Timer Block (timer_clint.sv)

RISC-V CLINT-compatible timer providing the machine timer interrupt. The timer increments a 64-bit counter at the system clock rate and generates an interrupt when the counter reaches a programmable compare value.

## 9.1 Register Map

Offset | Register | R/W | Reset | Description
0x00 | MTIME_LO | RO | 0x0 | Lower 32 bits of 64-bit free-running counter. Increments every clock cycle.
0x04 | MTIME_HI | RO | 0x0 | Upper 32 bits of 64-bit free-running counter.
0x08 | MTIMECMP_LO | R/W | 0xFFFFFFFF | Lower 32 bits of 64-bit compare value.
0x0C | MTIMECMP_HI | R/W | 0xFFFFFFFF | Upper 32 bits of 64-bit compare value.
0x10 | PRESCALER | R/W | 0x0 | Clock divider. 0 = no prescale (increment every cycle). N = increment every N+1 cycles.

## 9.2 Interrupt Generation Logic

The timer interrupt is generated when mtime >= mtimecmp (unsigned 64-bit comparison, per RISC-V privilege spec). The interrupt output (irq_timer) remains asserted as long as the condition holds. Firmware clears the interrupt by writing a new (future) value to mtimecmp.

// Timer interrupt generation

assign mtime_full = {mtime_hi, mtime_lo};

assign mtimecmp_full = {mtimecmp_hi, mtimecmp_lo};

assign irq_timer_o = (mtime_full >= mtimecmp_full);

Race condition note: When firmware writes mtimecmp_lo then mtimecmp_hi in sequence, a spurious interrupt can fire if the new mtimecmp_lo is less than the current mtime_lo. Firmware should write mtimecmp_hi first (with 0xFFFFFFFF) to disable the compare, then write mtimecmp_lo, then write the real mtimecmp_hi. This is standard RISC-V practice.

# 10. Interrupt Controller (irq_controller.sv)

The interrupt controller aggregates multiple interrupt sources into a single external interrupt line (irq_external) presented to the Ibex CPU. It implements fixed-priority encoding with per-source enable and clear registers.

## 10.1 Interrupt Sources

Bit | Source | Type | Description
0 | UART RX Data Ready | Level | UART RX FIFO has data
1 | UART TX Empty | Level | UART TX FIFO is empty
2 | Camera Frame Ready | Edge (rising) | Camera pipeline has a new frame in DDR
3 | Audio Buffer Ready | Edge (rising) | Audio I2S buffer is full
4 | DMA Completion | Edge (rising) | Any DMA channel transfer complete
5 | NPU Inference Done | Edge (rising) | NPU layer execution complete (from NPU irq_npu_done)
6 | GPIO Interrupt | Configurable | Any GPIO pin configured as interrupt source
7 | I2C Transfer Done | Edge (rising) | I2C master transaction complete

## 10.2 Register Map

Offset | Register | R/W | Reset | Description
0x00 | IRQ_PENDING | RO | 0x00 | Each bit reflects raw interrupt state (after edge detection for edge-type).
0x04 | IRQ_ENABLE | R/W | 0x00 | Per-source interrupt enable mask. 1 = enabled, 0 = masked.
0x08 | IRQ_CLEAR | WO | — | Write 1 to specific bit(s) to clear edge-detected pending interrupts. Level interrupts clear when the source deasserts.
0x0C | IRQ_TYPE | R/W | 0xFC | Per-source type. 0 = level-sensitive, 1 = edge-sensitive. Default: bits [7:2] are edge, bits [1:0] are level.
0x10 | IRQ_STATUS | RO | 0x00 | IRQ_PENDING AND IRQ_ENABLE. Shows which enabled interrupts are active.
0x14 | IRQ_HIGHEST | RO | 0x00 | Index of highest-priority active interrupt (0–7). 0xFF if none active.

## 10.3 Priority Logic

Priority is fixed and determined by bit position: bit 0 is highest priority, bit 7 is lowest. The irq_external output to the CPU is asserted when any bit in IRQ_STATUS is non-zero.

// Priority encoder (fixed priority, bit 0 = highest)

assign irq_status = irq_pending & irq_enable;

assign irq_external_o = |irq_status;

always_comb begin

irq_highest = 8'hFF; // no active interrupt

for (int i = 0; i < 8; i++) begin

if (irq_status[i]) begin

irq_highest = i;

break;

end

end

end

Edge detection: For edge-sensitive sources, a 1-cycle delay register captures the previous value. A rising edge is detected as (current & ~previous). The edge sets the corresponding IRQ_PENDING bit, which remains set until firmware writes 1 to the corresponding IRQ_CLEAR bit.

# 11. UART Peripheral (uart_peripheral.sv)

Standard UART with configurable baud rate, 8N1 format, TX and RX FIFOs. Used for debug console output and firmware development.

## 11.1 Register Map

Offset | Register | R/W | Reset | Description
0x00 | TXDATA | WO | — | Write byte to TX FIFO. Bits [7:0] = data. Write ignored if TX FIFO full.
0x04 | RXDATA | RO | 0x00 | Read byte from RX FIFO. Bits [7:0] = data. Bit [31] = empty flag (1 = no data).
0x08 | STATUS | RO | 0x00 | Bit[0]: TX FIFO full. Bit[1]: TX FIFO empty. Bit[2]: RX FIFO full. Bit[3]: RX FIFO empty. Bit[4]: RX overrun. Bit[5]: RX framing error.
0x0C | BAUDDIV | R/W | 0x0 | Baud rate divisor. Baud = clk_freq / (BAUDDIV + 1). Example: 100 MHz / 868 = 115200 baud.
0x10 | IRQ_ENABLE | R/W | 0x0 | Bit[0]: TX empty IRQ enable. Bit[1]: RX data ready IRQ enable.

## 11.2 FIFO Parameters

Parameter | TX FIFO | RX FIFO
Depth | 16 entries | 16 entries
Width | 8 bits | 8 bits
Implementation | Synchronous FIFO (shift register) | Synchronous FIFO (shift register)
Overflow Behavior | Write ignored when full | Overrun flag set, oldest data preserved

## 11.3 Transmitter FSM (uart_tx.sv)

State | Behavior
IDLE | TX line held high (idle). Wait for FIFO non-empty. Pop byte, transition to START.
START | Drive TX = 0 for 1 bit period. Load shift register with data byte. Transition to DATA.
DATA | Shift out bits [0] through [7], LSB first. 1 bit period each. After bit 7, transition to STOP.
STOP | Drive TX = 1 for 1 bit period. Transition to IDLE.

# 12. GPIO Peripheral (gpio_peripheral.sv)

Offset | Register | R/W | Reset | Description
0x00 | GPIO_DIR | R/W | 0x00 | Direction register. Bit[n]: 0 = input, 1 = output. 8 GPIO pins.
0x04 | GPIO_OUT | R/W | 0x00 | Output data register. Drives pin when GPIO_DIR[n] = 1.
0x08 | GPIO_IN | RO | 0x00 | Input data register. Sampled value of all pins (synchronized to clk).
0x0C | GPIO_IRQ_EN | R/W | 0x00 | Per-pin interrupt enable for input pins.
0x10 | GPIO_IRQ_PEND | R/W1C | 0x00 | Interrupt pending. Write 1 to clear. Set on rising edge of input pin.

# 13. Reset and Clock Architecture

## 13.1 Clock Domain

The entire RISC-V subsystem operates in a single clock domain (sys_clk). There is no clock domain crossing within the subsystem. The NPU may operate in a separate clock domain (npu_clk); any CDC between the CPU and NPU is handled at the AXI interconnect boundary via asynchronous FIFO bridges (not part of this subsystem).

## 13.2 Reset Architecture

Reset Signal | Source | Targets
sys_rst_n | Board reset button / power-on | All subsystem blocks via rst_sync
cpu_rst_n | sys_rst_n AND software reset reg | Ibex core only (allows CPU-only reset without peripheral reset)
periph_rst_n | sys_rst_n AND peripheral reset reg | All peripherals (UART, GPIO, Timer, IRQ controller)

All resets are active-low and synchronized to sys_clk through a 2-FF synchronizer (rst_sync.sv) to prevent metastability.

## 13.3 Reset Sequencing

On power-on, the reset sequence is: (1) sys_rst_n deasserts after board power is stable, (2) rst_sync produces clean synchronized resets, (3) peripheral reset deasserts first (peripherals initialize), (4) CPU reset deasserts 8 cycles later (CPU starts fetching from boot ROM). This delay ensures peripherals are ready before the CPU begins register programming.

# 14. Integration with NPU and DMA

The RISC-V CPU does not directly process AI workload data. Instead, it orchestrates the NPU and DMA engines through register programming and interrupt-driven control. This section defines the exact integration points.

## 14.1 CPU → NPU Interaction Path

CPU accesses NPU registers at base 0x3000_0000 via: CPU dBus → dbus_axi_adapter → AXI4 Interconnect → AXI-to-AXI-Lite Bridge → AXI4-Lite Peripheral Fabric → NPU Register File (npu_regfile.sv).

NPU signals completion via: NPU irq_npu_done → irq_controller bit[5] → irq_external → Ibex irq_external_i.

## 14.2 Typical Firmware Execution Loop

// Main firmware loop (runs from SRAM after boot)

void main() {

uart_init(115200);

timer_init();

irq_enable(IRQ_NPU_DONE | IRQ_DMA_DONE | IRQ_CAMERA_READY);

// Load model weights from DDR (once)

dma_memcpy(DDR_WEIGHTS_BASE, DDR_MODEL_SRC, MODEL_SIZE);

wait_dma_done();

while (1) {

wfi(); // Sleep until interrupt

uint32_t irq = irq_read_status();

if (irq & IRQ_CAMERA_READY) {

// Run face recognition pipeline

for (int layer = 0; layer < num_layers; layer++) {

npu_program_layer(&layer_params[layer]);

npu_start();

wfi(); // Wait for NPU done interrupt

}

// Post-process on CPU

process_result(DDR_OUTPUT_BASE);

}

}

}

# 15. FPGA Resource Estimate

Estimated resource utilization for the RISC-V subsystem on Zynq Z7-20. Does not include NPU subsystem (documented separately).

Resource | Estimate | Z7-20 Total | Headroom
LUT | 8K–12K | 85K | ~85% available (combined with NPU ~60%)
FF | 4K–6K | 106K | ~95% available
BRAM18 | 56–64 | 280 | ~20–23% (512KB SRAM + 4KB ROM)
DSP48 | 3–4 | 220 | < 2% (multiplier in Ibex M-extension)

Combined with NPU: NPU uses ~64% of DSP48s and ~14% of BRAM. The RISC-V subsystem uses ~22% of BRAM and <2% of DSP. Total combined utilization: ~75% DSP, ~36% BRAM, ~35% LUT. This leaves sufficient headroom for peripheral blocks (I2S, I2C, camera interface) to be added later.

# 16. ASIC Migration Notes — Phase 1 (180nm Test Chip)

The RISC-V subsystem is included as part of the full SoC test vehicle at SCL Mohali 180nm. The RTL is identical; changes are implementation-level only.

Item | FPGA (Phase 0) | ASIC 180nm (Phase 1)
SRAM | Xilinx BRAM inference | SCL Mohali SRAM compiler (from PDK)
Boot ROM | BRAM initialized via $readmemh | Mask ROM or eFuse
Clock | 100 MHz (FPGA fabric) | 200–300 MHz target post-synthesis
Reset | Board button + FPGA MMCM lock | On-chip POR circuit
Register File | Flip-flop (RegFileFF) | Flip-flop or SRAM compiler (area tradeoff)
AXI Interconnect | Connected to Zynq HP port | Connected to on-chip DDR PHY or test SRAM
RTL Changes | FPGA-specific BRAM wrappers | Replace with technology-independent SRAM wrappers

# 17. Simulation and Verification Plan

This section defines the verification approach for the RISC-V subsystem, consistent with the Phase 0 Simulation Validation Plan.

## 17.1 Unit-Level Tests

Module | Key Tests
ibus_axi_adapter | Back-to-back requests, stall handling, error response propagation, 2 outstanding requests
dbus_axi_adapter | Load/store all sizes (byte/half/word), byte enable correctness, write response handling
axi_interconnect | Multi-master contention, arbitration fairness, address decode correctness, no deadlock under all M0+M1+M2 combinations
boot_rom | Read all addresses, verify hex content, write rejection (no SLVERR)
onchip_sram | Read/write all banks, byte enables, dual-port simultaneous access, bank collision stall
timer_clint | Counter increment, compare match interrupt, prescaler, mtimecmp write sequence
irq_controller | All sources individually, priority ordering, edge detection, clear behavior, enable masking
uart_peripheral | TX/RX loopback at multiple baud rates, FIFO full/empty, overrun, framing error
gpio_peripheral | Direction switching, output drive, input sampling, interrupt edge detection

## 17.2 Subsystem Integration Tests

Test | Description
Boot Sequence | CPU fetches from boot ROM, initializes stack, jumps to SRAM. Verify PC trace.
UART Hello World | CPU writes string to UART TXDATA. Verify correct baud timing on TX line.
Timer Interrupt | Set mtimecmp to near-future value. Verify CPU enters trap handler when mtime >= mtimecmp.
NPU Kickoff | CPU writes NPU registers via AXI-Lite path. Verify register values arrive at NPU regfile.
Multi-Master Contention | CPU fetches instructions while DMA engine performs burst transfer. Verify no deadlock, both complete.
Full Inference Loop | CPU programs NPU for 1 layer, starts it, waits for interrupt. Verify end-to-end register and interrupt flow.

# 18. Top-Level Port List (riscv_subsys_top.sv)

The riscv_subsys_top module is the top-level wrapper that instantiates all RISC-V subsystem components and exposes external interfaces to the SoC.

Port | Width | Dir | Description
clk_i | 1 | I | System clock (100 MHz FPGA / 200+ MHz ASIC)
rst_ni | 1 | I | Active-low system reset (asynchronous assert, synchronous deassert)
m_axi_ddr_* | various | I/O | AXI4 Master to DDR controller (32-bit address, 32-bit data for CPU). Directly routed from interconnect S3 port.
m_axi_npu_data_* | various | I/O | AXI4 Slave from NPU DMA (128-bit data). Connected as M2 on the interconnect.
s_axi_npu_ctrl_* | various | O | AXI4-Lite Master to NPU registers. Routed through peripheral fabric.
s_axi_dma_ctrl_* | various | O | AXI4-Lite Master to DMA registers. Routed through peripheral fabric.
uart_tx_o | 1 | O | UART transmit data line
uart_rx_i | 1 | I | UART receive data line
gpio_io | 8 | I/O | Bidirectional GPIO pins
irq_npu_done_i | 1 | I | NPU inference done interrupt (connects to irq_controller bit 5)
irq_dma_done_i | 1 | I | DMA transfer complete interrupt (connects to irq_controller bit 4)
irq_camera_ready_i | 1 | I | Camera frame ready interrupt (connects to irq_controller bit 2)
irq_audio_ready_i | 1 | I | Audio buffer ready interrupt (connects to irq_controller bit 3)
irq_i2c_done_i | 1 | I | I2C transfer done interrupt (connects to irq_controller bit 7)

— End of RISC-V Subsystem RTL Implementation Document —

AI Glasses SoC | Phase 0 FPGA → Phase 1 (180nm) | Version 1.0 | March 2026

Confidential — Page

RISC-V Subsystem RTL Implementation Document AI Glasses SoC — Phase 0
