anirudhr-adtech/AI_GLASSES/AI_Smart_Glasses_docs/Budget and Phase planning/AI_SmartGlasses_Resource_Estimate_v3 (1).docx

RESOURCE ESTIMATE

AI-Powered Smart Glasses

Custom SoC Development Program

Solo Engineer + Claude AI Agents Execution Model

180nm Test Vehicle (SCL Mohali) → 28nm Production (Tata Dholera)

Prepared: February 2026 | Version 2.0 | Confidential

# Cost Estimate: 180nm Test Vehicle (SCL Mohali)

Phase 1 targets architecture validation using four test chips fabricated at SCL Mohali on the 180nm CMOS process via MPW shuttle. This phase is designed to be lean, leveraging open-source IPs and Claude AI agents in place of traditional engineering teams.

Cost Category | Description | Low Estimate | High Estimate
Claude Max Subscriptions | 2 plans × $200/month × ~2 months | ₹68K | ₹1L
EDA Tool Licenses | Cadence, Synopsys, Calibre (annual or C2S programme) | ₹5L | ₹10L
IP Licensing (Analog) | ADC/DAC analog IP, PLL from SCL; digital IPs open-source | ₹3L | ₹8L
SCL Mohali MPW Slot | 4 test chips, ~21mm² total area on shared wafer | ₹5L | ₹15L
Packaging & Test | QFP/QFN packaging, 25–50 samples per chip | ₹2L | ₹4L
Eval Board Design & Fab | 3 PCBs with FPGA interface, 10 units each | ₹3L | ₹5L
Compute (Simulation) | Cloud or local server for regression runs | ₹1L | ₹2L
Physical Design (PD Partner) | Floorplan, P&R, timing closure, GDSII | ₹5L | ₹10L
Software & AI/ML Pipeline | Cloud APIs, GPU compute, app developer accounts | ₹5L | ₹10L
Business Operations | DLI application, office, travel, legal, patents | ₹14L | ₹27L
SUBTOTAL | | ₹43.7L | ₹92L
Contingency (15%) | | ₹6.5L | ₹13.8L
PHASE 1 TOTAL | | ₹50.2L | ₹1.06 Cr

With DLI subsidy (up to 50% on eligible design and tapeout costs), effective Phase 1 cost could reduce to ₹35–75 Lakhs.

# Cost Estimate: 28nm Production SoC (Tata Dholera)

Phase 2 produces the actual product-ready SoC on 28nm at Tata Electronics Dholera. The major cost driver is 28nm IP licensing and full mask tapeout. RTL from Phase 1 carries forward with modifications; verification is expanded to full-chip level.

Cost Category | Description | Low Estimate | High Estimate
Claude Max Subscriptions | 2 plans × $200/month × ~4 months | ₹1.36L | ₹2.8L
EDA Tool Licenses | Full suite for 28nm, advanced node enablement (18 months) | ₹20L | ₹35L
28nm IP Licensing | ARM/RISC-V core, BLE 5.3 PHY, Wi-Fi 6 PHY, MIPI CSI PHY, ADC/DAC, PLL, USB PHY | ₹50L | ₹1.2 Cr
28nm Standard Cell & Memory | Foundry-specific std cell libs, SRAM/ROM compilers | ₹15L | ₹30L
Full Mask Tapeout | 28nm full mask set at Tata Dholera | ₹1.5 Cr | ₹3 Cr
Engineering Samples | First lot wafers, WLCSP/BGA packaging, 500–1000 units | ₹30L | ₹60L
Test Program Development | ATE test program, yield analysis | ₹10L | ₹20L
Silicon Validation | Post-silicon debug, characterization lab | ₹10L | ₹20L
Re-spin Budget | Potential mask revision (30% probability) | ₹45L | ₹90L
Physical Design (PD Partner) | Full SoC: floorplan, multi-corner STA, signoff | ₹30L | ₹60L
Compute (Simulation) | GLS, regression farm for 28nm | ₹2L | ₹4L
Software & AI/ML Pipeline | Firmware, NPU runtime, production app, cloud backend | ₹15L | ₹30L
Business Operations | Office, patents, certifications, regulatory, marketing | ₹42L | ₹77L
SUBTOTAL | | ₹4.70 Cr | ₹9.48 Cr
Contingency (15%) | | ₹70.5L | ₹1.42 Cr
PHASE 2 TOTAL | | ₹5.41 Cr | ₹10.90 Cr

The 28nm IP licensing (₹50L–1.2 Cr) and full mask tapeout (₹1.5–3 Cr) are the two largest cost items. These can be reduced by choosing RISC-V over ARM, using external BLE/Wi-Fi modules instead of on-die integration, and leveraging foundry-provided IPs from Tata Dholera.

## Combined Program Cost

| Low Estimate | High Estimate
Phase 1: 180nm Test Vehicle | ₹50.2 Lakhs | ₹1.06 Cr
Phase 2: 28nm Production SoC | ₹5.41 Cr | ₹10.90 Cr
GROSS TOTAL | ₹5.91 Cr | ₹11.96 Cr
DLI Subsidy (est. 50% eligible) | (₹1.5–2 Cr) | (₹3–4 Cr)
NET OUT-OF-POCKET | ₹3.91 Cr | ₹7.96 Cr

# Executive Summary

This document presents a resource estimate for developing a custom SoC for AI-powered smart glasses, executed by a single senior design engineer (20 years experience) leveraging Claude AI agent swarms for RTL design, verification, and AI/ML pipeline development.

The program follows a two-phase approach: 180nm test vehicle at SCL Mohali for architecture validation, followed by 28nm production tapeout at Tata Electronics Dholera. Cost sections are clearly separated into Front-End (RTL, Verification, GLS, DFT) and Physical Design (PD).

The company is already incorporated as a Private Limited entity. A physical design partner with EDA licenses is available for the PD phase.

Category | Phase 1 (180nm) | Phase 2 (28nm) | Total
Front-End (RTL + DV + GLS + DFT) | ₹10–20 Lakhs | ₹25–55 Lakhs | ₹35–75 Lakhs
Physical Design | ₹8–15 Lakhs | ₹1.5–3 Cr | ₹1.58–3.15 Cr
Software & AI/ML Pipeline | ₹5–10 Lakhs | ₹15–30 Lakhs | ₹20–40 Lakhs
Business Operations | ₹38–67 Lakhs | ₹60L–1 Cr | ₹98L–1.67 Cr
Contingency (15%) | ₹9–17 Lakhs | ₹38–73 Lakhs | ₹47–90 Lakhs
TOTAL | ₹70L–1.29 Cr | ₹2.88–5.58 Cr | ₹3.58–6.87 Cr

With DLI scheme subsidy (up to 50% of eligible costs), net out-of-pocket could reduce to approximately ₹2–4 Crore over the full program.

# Front-End: RTL Design

All RTL design work is executed by the founder using Claude Max Plan #1 with Agent Swarm (multi-agent teams). Claude agents generate synthesizable SystemVerilog RTL from detailed architecture specs, with the founder providing architecture decisions, reviewing all code, and running EDA tools.

## RTL Scope — 4 Test Chips

Test Chip | Key Blocks | Estimated Complexity | Target Die Size
Chip 1: NPU | 8×8 MAC array, weight buffer, activation unit, controller, AXI interface | Moderate | 3×3 mm
Chip 2A: Audio DSP + ADC | 2-ch ADC, PGA, beamforming DSP, VAD, noise cancellation, I2S interface | Moderate | 2×2 mm
Chip 2B: DAC + Driver | DAC, Class-D amp driver, volume control, I2S input | Low–Moderate | 2×2 mm
Chip 3: Camera ISP | Parallel camera interface, debayer, white balance, exposure, frame buffer ctrl | Moderate | 2×2 mm

## RTL IP Requirements

IP Block | Source | License Type | Estimated Cost
Processor Core (Cortex-M class) | RISC-V (VexRiscv / Ibex from GitHub) | Open Source (Apache/BSD) | Free
AXI/AHB Interconnect | GitHub (OpenCores / PULPplatform) | Open Source | Free
SRAM Compiler | SCL Mohali (180nm PDK) | Foundry provided | Included in MPW
Standard Cell Library | SCL Mohali (180nm PDK) | Foundry provided | Included in MPW
I2S / SPI / I2C Controllers | GitHub (OpenCores / FuseSoC) | Open Source | Free
UART / GPIO | GitHub (multiple repos) | Open Source | Free
ADC/DAC (analog) | Custom design or SCL IP | Custom / SCL | ₹2–5L
PLL / Clock Gen | SCL Mohali analog IP | Foundry provided | ₹1–3L
TOTAL IP COST | | | ₹3–8L

Strategy: Maximize open-source IP from GitHub (RISC-V ecosystem is mature). Only analog IPs (ADC, DAC, PLL) require licensing or custom design since these cannot be sourced as open-source synthesizable RTL.

## RTL Design Cost — Claude Agents vs Traditional Engineers

Parameter | Traditional (Engineers) | Claude Agents + Solo Engineer
Team Size | 2–3 RTL engineers | 1 engineer + 2 Claude Max plans
Monthly Cost | ₹3.5–5.5L/month (salaries) | ₹34K/month ($400 for 2 Max plans)
RTL Spec + Architecture | 2–4 weeks | 4 days
RTL Coding (all 4 chips) | 8–12 weeks | 4 days (agent swarm parallel)
Total RTL Duration | 12–16 weeks (3–4 months) | 8 days (~1.5 weeks)
Total RTL Cost | ₹12–18 Lakhs | ₹17K (1.5 weeks of subscription)
Availability | Hiring takes 4–8 weeks | Instant — start today
Working Hours | 8 hrs/day, 5 days/week | 24/7, no breaks
Onboarding | 2–4 weeks to understand architecture | Zero — spec in, code out
Risk | Attrition, knowledge loss | Review bandwidth (founder bottleneck)
SAVINGS | Baseline | ₹12–18L saved + 10–14 weeks faster

The Claude agent approach delivers a 98%+ cost reduction and 85%+ time reduction on RTL design compared to traditional engineering teams.

# Front-End: Verification (DV)

Verification is executed using Claude Max Plan #2 with Agent Swarm. The DV environment build starts in parallel with RTL (spec-based), with test development and debug cycles following RTL availability. Estimated duration is 4× RTL time based on industry ratios and debug iteration cycles.

## Verification Scope

Activity | Description | Duration
UVM Env Build | Agents, drivers, monitors, scoreboards, coverage groups for all 4 chips | Week 2 (parallel with RTL)
Assertions (SVA) | Protocol checks, interface compliance, functional assertions from spec | Week 2–3
Directed Tests | Basic sanity, register access, data path validation | Week 3
Constrained Random | Corner case generation, stress tests, error injection | Week 3–4
Simulation & Debug | Run regressions, analyze failures, fix RTL/TB bugs | Week 3–5
Coverage Closure | Functional + code coverage analysis, hole-filling tests | Week 4–5

## DV Cost — Claude Agents vs Traditional Engineers

Parameter | Traditional (Engineers) | Claude Agents + Solo Engineer
Team Size | 1–2 DV engineers | 1 engineer + Claude Max Plan #2
Monthly Cost | ₹2–3.5L/month | ₹17K/month ($200 Max plan)
Env Build + Tests | 8–12 weeks | ~3.5 weeks (16 working days)
Total DV Cost | ₹8–14 Lakhs | ₹34K (~2 months subscription)
SAVINGS | Baseline | ₹7.5–13.5L saved + 5–9 weeks faster

# Front-End: Gate-Level Simulation (GLS)

Gate-level simulation is performed after synthesis to validate that the netlist behaves identically to RTL. This catches synthesis tool issues, clock-gating errors, and timing-related bugs before tapeout.

## GLS Scope

Activity | Description | Duration
Synthesis | Run Design Compiler / Genus on all 4 chips with SCL 180nm libs | 2–3 days
GLS Testbench Adaptation | Add SDF annotation, fix timing-related TB issues, gate-level models | 2–3 days
GLS Regression | Re-run full test suite on netlist with SDF back-annotation | 3–5 days
Debug & Fix | Analyze GLS failures, fix RTL or constraints, re-synthesize if needed | 3–5 days

## GLS Cost

Item | Description | Cost
Claude Agent Time | GLS TB adaptation, debug analysis (~2 weeks) | ₹17K
EDA Tool (Synthesis) | DC/Genus license (covered under annual EDA license) | Included
Compute | Simulation server time for gate-level runs | ₹1–2L (cloud) or local
TOTAL GLS | | ₹1.2–2.2L

# Front-End: Design for Test (DFT)

DFT insertion ensures the manufactured chips can be tested on ATE (Automatic Test Equipment) for manufacturing defects. For 180nm test chips, a basic scan chain insertion is sufficient. Full DFT (BIST, boundary scan, compression) is reserved for the 28nm production SoC.

## DFT Scope — Phase 1 (180nm)

Activity | Description | Duration
Scan Chain Insertion | Insert scan flip-flops, stitch chains, add test ports | 2–3 days
ATPG Pattern Generation | Generate stuck-at and transition fault patterns using TetraMAX/Modus | 1–2 days
Fault Coverage Analysis | Target >95% stuck-at coverage, analyze untestable faults | 1 day
DFT-aware Re-synthesis | Re-synthesize with DFT constraints, verify no functional impact | 1–2 days

## DFT Scope — Phase 2 (28nm, Additional)

Activity | Description | Duration
Memory BIST | Integrated MBIST for all SRAM instances | 1 week
JTAG / Boundary Scan | IEEE 1149.1 TAP controller, boundary scan cells | 3–5 days
Scan Compression | DFTMAX/EDT compression for reduced test time on ATE | 3–5 days
Test Pattern Validation | Simulate patterns on gate-level netlist | 1 week

## DFT Cost

Item | Phase 1 (180nm) | Phase 2 (28nm)
Claude Agent Time | ₹8.5K (1 week) | ₹51K (3 weeks)
EDA Tool (DFT) | Included in annual license | Included
TOTAL DFT | ₹8.5K | ₹51K

# Front-End: Complete Summary

## Phase 1 — 180nm Test Vehicle

Front-End Activity | Duration | Claude Cost | IP / Other Cost | Total
RTL Design (all 4 chips) | 8 days | ₹17K | ₹3–8L (analog IP) | ₹3.2–8.2L
Verification (DV) | 16 days | ₹34K | — | ₹0.34L
GLS | 10 days | ₹17K | ₹1–2L (compute) | ₹1.2–2.2L
DFT | 5 days | ₹8.5K | — | ₹0.085L
EDA Tool Licenses | — | — | ₹5–10L | ₹5–10L
FRONT-END TOTAL (Phase 1) | ~5–6 weeks | ₹76.5K (~₹1L) | ₹9–20L | ₹10–21L

## Phase 2 — 28nm Production SoC

Front-End Activity | Duration | Claude Cost | IP / Other Cost | Total
RTL Modification + New Blocks | 2 weeks | ₹34K | ₹50L–1.2Cr (28nm IP) | ₹51–1.21Cr
Verification (full-chip DV) | 6–8 weeks | ₹1.36L | — | ₹1.36L
GLS (28nm) | 2–3 weeks | ₹51K | ₹2–4L (compute) | ₹2.5–4.5L
DFT (full: MBIST + JTAG + compression) | 3 weeks | ₹51K | — | ₹0.51L
EDA Tool Licenses (18 months) | — | — | ₹20–35L | ₹20–35L
FRONT-END TOTAL (Phase 2) | ~13–16 weeks | ₹2.8L | ₹72L–1.59Cr | ₹75L–1.62Cr

## Front-End Grand Total

| Phase 1 | Phase 2 | Total
Claude Max Subscriptions | ₹1L | ₹2.8L | ₹3.8L
IP Licenses + EDA + Compute | ₹9–20L | ₹72L–1.59Cr | ₹81L–1.79Cr
TOTAL FRONT-END | ₹10–21L | ₹75L–1.62Cr | ₹85L–1.83Cr

Note: The dominant front-end cost is IP licensing for 28nm (ARM cores, BLE PHY, MIPI PHY, etc.), not engineering labor. Claude agents reduce engineering cost to near-zero, shifting the budget entirely to IP and tools.

# Physical Design (PD)

Physical design is handled by the founder’s PD partner. This section provides estimated costs for reference. Detailed PD planning will be done separately once front-end RTL is frozen.

## PD Scope

Activity | Phase 1 (180nm) | Phase 2 (28nm)
Floorplanning | 4 chips, simple floorplan | Full SoC floorplan with power domains
Synthesis + P&R | SCL 180nm libs, moderate timing | 28nm multi-corner multi-mode
Clock Tree Synthesis | Simple clock tree | Multi-domain CTS with gating
Timing Closure (STA) | Single corner | Multi-corner (SS/TT/FF, temps, voltages)
Power Analysis | Basic IR drop | Full power grid, EM/IR, DVFS analysis
Physical Verification | DRC/LVS on SCL 180nm | DRC/LVS/antenna on 28nm rules
GDSII Generation | 4 test chip GDSII | Production SoC GDSII

## PD Estimated Cost

Item | Phase 1 (180nm) | Phase 2 (28nm)
PD Partner (labor) | ₹5–10L | ₹30–60L
EDA Tools (PD-specific) | Shared with FE license | ₹10–20L (Innovus/ICC2 add-on)
SCL MPW Slot / Mask Cost | ₹5–15L | ₹1.5–3Cr (28nm full mask)
Packaging | ₹2–4L | ₹30–60L
TOTAL PD | ₹12–29L | ₹1.7–3.4Cr

PD costs will be refined in a separate detailed plan once the front-end architecture and RTL are frozen. The 28nm mask cost at Tata Dholera is the single largest cost item in the entire program.

# Software & AI/ML Pipeline

AI/ML pipeline development runs in parallel with hardware design, time-sharing on Claude Max plans. No separate AI/ML engineers are hired — Claude agents handle model optimization, quantization scripts, inference runtime, and companion app development.

## AI/ML Cost — Claude Agents vs Traditional Engineers

Parameter | Traditional (Engineers) | Claude Agents + Solo Engineer
Team Size | 2 AI/ML engineers + 1 app developer | Solo engineer + Claude (time-shared)
Annual Cost | ₹30–50 Lakhs/year | ₹4L/year (Claude subscriptions)
Scope | Model optimization, app dev, cloud backend | Same scope, agents handle code generation
Duration | 6–12 months | 4–8 weeks (parallel with HW)
SAVINGS | Baseline | ₹26–46L saved

Item | Description | Cost
Claude Max Plans | Time-shared with RTL/DV work | Included (already budgeted)
Cloud API Costs | Claude API, Whisper API for inference pipeline testing | ₹2–4L
Dev/Test Infrastructure | Cloud GPU for model training/quantization benchmarks | ₹2–4L
Companion App | iOS + Android prototype (Claude-generated) | ₹1–2L (developer accounts + hosting)
TOTAL AI/ML | | ₹5–10L

# Business Operations

The company is already incorporated as a Pvt Ltd. Business costs cover DLI application, operational overhead, IP protection, and go-to-market preparation.

## Phase 1 Business Ops

Item | Description | Low Est. | High Est.
DLI Application | Consultant, documentation, compliance | ₹2L | ₹4L
Office & Lab Infrastructure | Co-working + eval board lab area (6 months) | ₹3L | ₹6L
Travel & Networking | SCL Mohali visits, SEMICON India, investor meetings | ₹3L | ₹5L
Legal & IP | Patent filing (provisional), IP attorney, CA | ₹4L | ₹8L
Miscellaneous | Insurance, supplies, subscriptions | ₹2L | ₹4L
SUBTOTAL | | ₹14L | ₹27L

## Phase 2 Business Ops

Item | Description | Low Est. | High Est.
Office & Lab (18 months) | Expanded facility with ATE access | ₹12L | ₹20L
Patent Portfolio | Full filings (India + PCT), prosecution | ₹8L | ₹15L
Industrial Design | Glasses frame design, 3D prototypes, user testing | ₹6L | ₹12L
Regulatory & Certification | BIS, CE, FCC for wireless device | ₹5L | ₹10L
Marketing & Launch | Brand, website, early adopter program | ₹5L | ₹10L
Verification Consultant | Independent DV audit before 28nm tapeout (3 months) | ₹6L | ₹10L
SUBTOTAL | | ₹42L | ₹77L

# Complete Program Summary

## Combined Cost — All Categories

Category | Phase 1 (180nm) | Phase 2 (28nm) | Total
Front-End (RTL + DV + GLS + DFT) | ₹10–21L | ₹75L–1.62Cr | ₹85L–1.83Cr
Physical Design | ₹12–29L | ₹1.7–3.4Cr | ₹1.82–3.69Cr
Software & AI/ML | ₹5–10L | ₹15–30L | ₹20–40L
Business Operations | ₹14–27L | ₹42–77L | ₹56L–1.04Cr
Subtotal | ₹41–87L | ₹3.02–6.09Cr | ₹3.43–6.96Cr
Contingency (15%) | ₹6–13L | ₹45–91L | ₹51L–1.04Cr
GROSS TOTAL | ₹47L–1Cr | ₹3.47–7Cr | ₹3.94–8Cr
DLI Subsidy (est. 50% eligible) | (₹10–20L) | (₹1–2Cr) | (₹1.1–2.2Cr)
NET OUT-OF-POCKET | ₹37–80L | ₹2.47–5Cr | ₹2.84–5.8Cr

## Total Savings: Claude Agents vs Traditional Team

Metric | Traditional Approach | Claude Agents Approach | Savings
Engineering Headcount | 6–8 engineers | 1 engineer + Claude | 5–7 fewer hires
Annual Team Cost | ₹65L–1.1Cr/year | ₹4L/year (subscriptions) | ₹61L–1.06Cr/year
Front-End Duration | 6–9 months | 5–6 weeks | 4–7 months faster
Total Program Cost | ₹8–14 Cr | ₹3.9–8 Cr | ₹4–6 Cr saved
Time to First Silicon | 18–24 months | 8–12 months | 6–12 months faster

# Program Timeline

## Phase 1: 180nm Test Vehicle

Week | Activity | Tool/Resource
1 | Architecture spec for all 4 test chips (4 days) | You + Claude (this chat)
2 | RTL coding — agent swarm, all 4 chips parallel (4 days) | Claude Max #1
2 | DV environment build from spec (parallel with RTL) | Claude Max #2
3–5 | DV tests, simulation, debug cycles, coverage closure | Claude Max #2
4–5 | GLS: synthesis + gate-level simulation + debug | Claude Max #1
5–6 | DFT insertion, ATPG, re-synthesis | Claude Max #1
5–6 | AI/ML pipeline development (parallel) | Time-shared on Max plans
6–7 | PD: floorplan, P&R, timing closure, physical verification | PD Partner
7–8 | GDSII generation, final checks, MPW submission to SCL | PD Partner + You
8–12 | DLI application, patent filing, SCL fabrication (4–6 months) | Business track
16–20 | Silicon received, bring-up, characterization | You + eval boards

Front-end completion (RTL through DFT): ~6 weeks. Total Phase 1 including PD and fabrication: ~5 months to first silicon.

## Phase 2: 28nm Production SoC

Month | Activity | Resource
6–7 | 180nm silicon characterization, architecture refinement | You + eval boards
7–8 | 28nm RTL modifications, new block integration | Claude Max #1
8–11 | Full-chip verification, GLS, DFT | Claude Max #2 + #1
11–13 | Physical design, timing closure, signoff | PD Partner
13 | Tapeout at Tata Dholera | GDSII submission
13–17 | Fabrication (~4–5 months) | Tata Dholera fab
17–19 | Silicon bring-up, firmware, glasses prototype | You + PD Partner

Total program: ~19 months from start to working smart glasses prototype with custom 28nm SoC. This is approximately 10 months faster than a traditional approach.

# Assumptions & Notes

All costs in Indian Rupees (INR). Exchange rate: 1 USD = ₹83–85. Claude Max Plan: $200/month per subscription.

Claude agent productivity assumes well-defined architecture specs and active review by the founder. Review bandwidth is the primary risk factor in the Claude-driven model.

EDA tool costs assume commercial licensing. C2S programme tools could significantly reduce this. SCL Mohali MPW pricing should be confirmed directly.

28nm IP costs (ARM, BLE PHY, MIPI) are estimates based on global benchmarks. RISC-V alternatives could reduce processor IP cost to zero.

PD costs are preliminary and will be refined in a separate plan with the PD partner once front-end RTL is frozen.

DLI subsidy estimates based on published scheme guidelines. Actual amounts depend on approval.

# Recommended Next Steps

1. Begin architecture specification for all 4 test chips — start with NPU block.

2. Set up Claude Code with Agent Teams on development machine for RTL workflow.

3. Prepare and submit DLI scheme application.

4. Contact SCL Mohali ChipIN Centre for MPW shuttle schedule and pricing.

5. Evaluate open-source RISC-V cores (Ibex, VexRiscv) and interface IPs from GitHub.

6. File provisional patents for SoC architecture and AI pipeline innovations.

7. Engage Tata Electronics for future 28nm tapeout relationship.

— End of Document —

AI Smart Glasses SoC — Resource Estimate v2.0 Confidential
