anirudhr-adtech/AI_GLASSES/AI_Smart_Glasses_docs/AI_Glasses_SoC_Verification_Strategy_v1.docx

AI Smart Glasses SoC

Verification Strategy Document

Module-Level | Subsystem-Level | SoC-Level

Document Version: 1.0

Date: March 2026

Target: Xilinx Zynq Z7-20 FPGA (Phase 0) / SCL Mohali 180nm ASIC (Phase 1)

Simulator: Icarus Verilog (open-source) / Vivado XSIM (FPGA)

# Table of Contents

# 1. Executive Summary

This document defines the three-tier verification strategy for the AI Smart Glasses SoC, covering 120+ RTL modules across 9 subsystems. The strategy is designed to work with open-source tooling (Icarus Verilog, Verilator, cocotb) for day-to-day development and Vivado XSIM for FPGA-targeted verification.

The SoC integrates a RISC-V CPU (Ibex RV32IMC), an 8x8 INT8 NPU, an MFCC audio pipeline, a camera/vision subsystem with ISP-lite, AXI4 interconnect, DDR controller bridge, and peripherals (UART, SPI, I2C, GPIO). All subsystems communicate via AXI4/AXI4-Lite buses and share DDR memory through a 5-master crossbar.

## 1.1 Verification Levels Overview

Level | Scope | Purpose | Pass Criteria
L1: Module | Single .v file | Functional correctness of leaf modules | All self-checking assertions pass, zero X/Z on outputs
L2: Subsystem | Subsystem _top.v | End-to-end datapath, DMA, register access, interrupts | Golden vector match, AXI protocol compliance
L3: SoC | soc_top.v | Multi-subsystem interaction, firmware boot, real workloads | Firmware test pass, DDR bandwidth, interrupt servicing

# 2. Verification Methodology

The verification approach uses a bottom-up strategy with directed tests at the module level, constrained-random stimulus at the subsystem level, and firmware-driven scenario tests at the SoC level. Each level builds confidence before integration into the next.

## 2.1 Toolchain

Tool | Role | Phase
Icarus Verilog (iverilog) | Primary open-source simulator for module and subsystem TBs | All phases
Verilator | Lint checking (--lint-only), fast cycle-accurate simulation for SoC | L2, L3
cocotb (Python) | AXI protocol BFMs, constrained-random test generation | L2, L3
Vivado XSIM | FPGA-targeted simulation with exact timing, IP integration | L2, L3 (FPGA)
Vivado Synthesis | Resource utilization, timing closure, BRAM inference checks | Post-L1
GTKWave | Waveform viewer for VCD/FST dumps | All phases
Python/NumPy | Golden model generation (MFCC, convolution, resize) | L2

## 2.2 Directory Structure

All verification collateral follows a standard layout per subsystem:

rtl/<subsystem>/tb/ — Testbench sources (.v)

rtl/<subsystem>/tb/golden/ — Golden reference vectors (.hex, .bin)

rtl/<subsystem>/tb/scripts/ — Python golden model generators

rtl/<subsystem>/tb/Makefile — Build & run automation

sim/logs/ — Simulation logs, pass/fail reports

sim/waves/ — VCD/FST waveform dumps

## 2.3 Pass/Fail Criteria (Global)

- PASS: All self-checking assertions pass, $display shows PASS, exit code 0
- FAIL: Any assertion fires, any X/Z propagation on registered outputs post-reset, timeout
- Every testbench must print a summary: PASSED (N/N tests) or FAILED (M/N tests)
- Waveform dump (.vcd) generated for every simulation run for debug

# 3. Level 1: Module-Level Verification

Module-level verification targets individual .v files in isolation. The existing 120 testbench stubs provide basic stimulus but need to be upgraded to full self-checking testbenches with comprehensive corner-case coverage.

## 3.1 Existing Testbench Assessment

The current testbenches follow a consistent pattern: clock generation, reset sequence, directed stimulus, and manual check_* tasks with pass/fail counters. This is a solid foundation but requires the following upgrades:

- Coverage gaps: boundary values, overflow/underflow, back-to-back transactions, error injection
- No AXI protocol checking (VALID/READY handshake rules)
- No automated golden-vector comparison for datapath modules (FFT, MFCC, resize)
- No simulation timeout or watchdog (tests can hang silently)
- No Makefile or CI automation to run all 120 TBs

## 3.2 Module Test Plan by Subsystem

### 3.2.1 NPU Modules (12 modules)

Module | Key Tests | Priority
mac_unit.v | Signed multiply-accumulate: pos*pos, neg*neg, pos*neg, overflow saturation, accumulator clear, pipeline latency | P0
npu_mac_array.v | 8x8 parallel MAC: row broadcast, column accumulate, full utilization, partial row | P0
npu_quantize.v | INT32→INT8: shift/scale sweep, clamp to [-128,+127], zero input, max positive, max negative | P0
npu_activation.v | ReLU (neg→0, pos→pass), ReLU6 (clamp at 6), bypass mode switching | P1
npu_weight_buf.v | BRAM read/write: simultaneous dual-port, address boundary, full buffer fill | P1
npu_act_buf.v | Same as weight_buf: dual-port BRAM, address wrap, read-during-write behavior | P1
npu_regfile.v | AXI4-Lite R/W all registers, read-only enforcement (STATUS), write-1-clear (IRQ_STATUS), default values after reset | P0
npu_dma.v | 128-bit AXI4 master: single burst, max burst (256 beats), back-to-back bursts, WLAST alignment, error response handling | P0
dma_weight_ch.v | Weight channel: burst read, buffer fill, address increment, done signaling | P0
dma_act_ch.v | Activation channel: read + write paths, output DMA after computation, address alignment | P0
npu_controller.v | Layer FSM: IDLE→LOAD_W→LOAD_A→COMPUTE→STORE→DONE for each layer type (Conv2D, FC, DW-Conv2D, MaxPool, AvgPool) | P0
npu_top.v | Covered at L2 (subsystem level) | L2

### 3.2.2 Audio/MFCC Modules (21 modules)

Module | Key Tests | Priority
i2s_rx.v | Deserialize I2S: left/right channel, 16-bit, bit alignment, BCLK/LRCLK timing | P0
i2s_sync.v | 2-FF synchronizer: metastability injection (random glitch), output stability after 2 clocks | P1
audio_fifo.v | FIFO: fill/drain, full/empty flags, write-when-full, read-when-empty, pointer wrap | P0
audio_window.v | 640-sample frame with Hamming: golden vector from Python, stride overlap (320 samples) | P0
hamming_rom.v | ROM readout: compare all 640 entries against Python-generated reference | P1
fft_butterfly.v | Radix-2 butterfly: known input pairs, twiddle factor W=1 and W=-j, numerical precision | P0
fft_engine.v | 1024-pt FFT: compare output against NumPy FFT of known input (golden vector, SNR > 50 dB) | P0
fft_twiddle_rom.v | ROM: verify all 512 entries against precomputed cos/sin values | P1
fft_addr_gen.v | Bit-reversal addressing: verify permutation for 1024 points | P1
power_spectrum.v | Re²+Im²: known values, overflow handling, zero input | P0
mel_filterbank.v | 40-bin output: golden vector from librosa/Python, coefficient coverage | P0
mel_coeff_rom.v | ROM: verify stored triangle filter coefficients | P1
log_compress.v | Fixed-point log2: sweep from 1 to MAX, compare against math.log2, error < 1 LSB | P0
log_lut_rom.v | ROM lookup: verify table entries | P1
dct_unit.v | Type-II DCT 40→10: golden from scipy.fft.dct, all-zeros, all-ones, impulse | P0
dct_coeff_rom.v | ROM: verify DCT basis coefficients | P1
mfcc_out_buf.v | Collect 49 frames, output 49x10x1 tensor, DMA trigger on completion | P0
audio_dma.v | 32-bit AXI4 master: write MFCC tensor to DDR address, burst alignment | P0
audio_regfile.v | AXI4-Lite: R/W all registers, MFCC_DONE interrupt status | P0
audio_controller.v | Pipeline FSM: IDLE→CAPTURE→WINDOW→FFT→MEL→LOG→DCT→STORE sequencing, 49-frame loop | P0
audio_subsys_top.v | Covered at L2 | L2

### 3.2.3 Camera Modules (18 modules)

Module | Key Tests | Priority
gray_counter.v | Count sequence: verify Gray-code property (1-bit change per increment), full wrap | P1
dvp_sync.v | 2-FF CDC: inject transitions at PCLK, verify stable output at sys_clk | P1
dvp_capture.v | DVP FSM: IDLE→WAIT_HREF→CAPTURE_LINE, full 640x480 frame, VSYNC/HREF timing, byte pairing | P0
pixel_fifo.v | Async FIFO: PCLK write / sys_clk read, gray pointer CDC, full/empty, pointer wrap | P0
yuv2rgb.v | BT.601 conversion: known YUV→RGB pairs, boundary values (Y=0, Y=255), clamping | P0
isp_lite.v | Pipeline: YUV422 input → RGB888 output stream, pixel-accurate golden match | P0
line_buffer.v | Dual-line BRAM: alternating line write/read, simultaneous access | P1
resize_engine.v | Bilinear 640x480→128x128: golden vector from PIL/OpenCV resize, coefficient accuracy | P0
pixel_packer.v | 24-bit RGB → 128-bit AXI words: pixel alignment, last-word padding, VALID timing | P1
video_dma.v | 128-bit AXI4 master: frame write, address stride, burst generation, WLAST | P0
frame_buf_ctrl.v | Double-buffer: pointer swap on FRAME_DONE, no tearing | P0
crop_dma_reader.v | AXI4 read: ROI address calc (bbox coords → DDR address), row-by-row fetch | P0
crop_resize.v | Bilinear resize for crop path: ROI → 112x112 output | P0
crop_dma_writer.v | AXI4 write: output tensor to DDR, burst alignment | P0
crop_engine.v | End-to-end crop: read ROI → resize → write, coordinate correctness | P0
cam_regfile.v | AXI4-Lite: 24 registers R/W, IRQ status, reset defaults | P0
cam_controller.v | Pipeline FSM, IRQ generation (FRAME_DONE, CROP_DONE), mode switching | P0
cam_subsys_top.v | Covered at L2 | L2

### 3.2.4 AXI Interconnect Modules (17 modules)

Module | Key Tests | Priority
axi_addr_decoder.v | Address decode: hit each slave region, unmapped → error slave, boundary addresses | P0
axi_arbiter.v | Tiered priority: NPU > Camera > CPU+Audio, round-robin within tier, starvation counter | P0
axi_crossbar.v | 5M x 5S: concurrent transactions, no deadlock, ID routing, interleaving | P0
axi_upsizer.v | 32-bit → 128-bit: data lane alignment, partial writes, burst adaptation | P0
axi_downsizer.v | 128-bit → 32-bit: serialization, read data mux, write strobe generation | P0
axi_width_converter.v | Bidirectional width conversion wrapper, back-to-back mixed directions | P0
axi_to_axilite_bridge.v | AXI4 → AXI4-Lite: burst decomposition, response aggregation, error forwarding | P0
axi_error_slave.v | DECERR response: verify proper BRESP/RRESP=DECERR, correct ID echo | P1
axi_slave_port.v | Slave port arbitration, ID append, response routing | P0
axi_timeout.v | Watchdog: trigger on stalled transaction, generate error response | P1
axilite_fabric.v | Peripheral address decode and mux: 9 slots, concurrent R/W | P0

### 3.2.5 DDR Bridge Modules (15 modules)

Module | Key Tests | Priority
burst_splitter.v | AXI4 max 256 → AXI3 max 16 beats: verify sub-burst count, address continuity, LAST generation | P0
axi_width_128to64.v | 128→64 bit: data serialization (2 beats per 128-bit), WSTRB mapping, read reassembly | P0
axi4_to_axi3_bridge.v | Protocol downgrade: AWLEN encoding change (AXI4=length-1, AXI3=length-1 with 4-bit), QoS stripping | P0
ddr_wrapper.v | End-to-end: 128-bit AXI4 → 64-bit AXI3 with burst splitting, back-to-back transactions | P0
axi_mem_model.v | Memory model: R/W correctness, byte enables, burst wrap, out-of-order responses | P0
qos_mapper.v | QoS priority mapping: verify correct priority encoding per master | P1

### 3.2.6 RISC-V, Peripherals, I2C, SPI

Module | Key Tests | Priority
ibus_axi_adapter.v | Ibex iBus → AXI4 read: req/gnt/rvalid handshake, back-to-back fetches, wait states | P0
dbus_axi_adapter.v | Ibex dBus → AXI4 R/W: byte/half/word access, write strobes, error response → bus_err | P0
boot_rom.v | 4KB ROM: $readmemh init, address range check, content readback | P1
onchip_sram.v | 512KB SRAM: R/W all banks, byte enable, simultaneous R+W (dual-port) | P0
uart_peripheral.v | UART TX+RX loopback: 115200 baud, frame format, FIFO overflow, parity | P0
timer_clint.v | MTIME increment, MTIMECMP compare, interrupt assertion/clear | P0
irq_controller.v | 6 IRQ sources: priority, pending/enable, CPU IRQ aggregation | P0
gpio_peripheral.v | 8-bit GPIO: direction control, output drive, input read, interrupt on edge | P1
i2c_master.v | I2C: START/STOP/ACK, byte write+read, clock stretching, NAK handling | P0
spi_master.v | SPI: CPOL/CPHA modes 0-3, variable clock div, TX/RX FIFO, chip select | P0

## 3.3 Module-Level Makefile Template

Each subsystem tb/ directory will contain a Makefile that automates compilation, simulation, and pass/fail reporting:

make all — Compile + run all TBs in subsystem

make tb_<module> — Run single module TB

make lint — Verilator --lint-only on all RTL

make waves — Open GTKWave on latest VCD

make report — Generate pass/fail summary

# 4. Level 2: Subsystem-Level Verification

Subsystem-level verification tests each _top.v wrapper as a black box, exercising the AXI4-Lite control interface and AXI4 DMA data interface. The CPU is replaced by a testbench AXI master BFM, and the DDR is modeled by axi_mem_model.v.

## 4.1 Testbench Architecture

Each subsystem testbench follows this pattern:

- AXI4-Lite Master BFM: drives register writes/reads to configure the subsystem
- AXI4 Slave Memory Model (axi_mem_model.v): acts as DDR, pre-loaded with input data
- Golden Vector Comparison: output tensor in memory model compared against Python/NumPy reference
- Interrupt Monitor: waits for IRQ assertion, verifies within expected cycle window
- AXI Protocol Checker: monitors all 5 AXI channels for protocol violations
- Timeout Watchdog: kills simulation after configurable cycle limit

## 4.2 NPU Subsystem Tests

Test ID | Test Name | Description | Golden Source
NPU-L2-001 | Conv2D 3x3 Small | 3x3 convolution on 8x8x1 input, 1 output channel. Verify output tensor in DDR matches NumPy conv2d. | Python: np.convolve + quantize
NPU-L2-002 | Conv2D Multi-Channel | 3x3 conv on 16x16x8 input, 16 output channels. Tests weight loading, multi-pass tiling. | Python golden
NPU-L2-003 | DW-Conv2D | Depthwise separable 3x3 on 8x8x4. LAYER_CONFIG type=4. | Python golden
NPU-L2-004 | Fully Connected | FC layer: 64-input → 10-output. Tests weight matrix multiply. | Python matmul + quantize
NPU-L2-005 | MaxPool 2x2 | 2x2 max pooling on 8x8 input. Tests pooling datapath. | Python: np.max over windows
NPU-L2-006 | AvgPool 2x2 | 2x2 average pooling. Tests rounding behavior. | Python: np.mean + round
NPU-L2-007 | ReLU6 Activation | Conv2D with ReLU6 activation. Output clamped to [0,6] after quantize. | Python golden
NPU-L2-008 | Back-to-Back Layers | Conv2D → ReLU → MaxPool → FC sequence. Tests re-configuration between layers. | Python pipeline
NPU-L2-009 | DMA Stress | Maximum burst size, unaligned addresses, rapid layer re-trigger. | Self-checking
NPU-L2-010 | Error Recovery | Trigger soft_reset mid-layer, verify clean restart. | FSM state check

## 4.3 Audio/MFCC Subsystem Tests

Test ID | Test Name | Description | Golden Source
AUD-L2-001 | Silence Input | 1 second of zeros through full MFCC pipeline. Output should be near-zero MFCC coefficients. | Python librosa
AUD-L2-002 | 1 kHz Sine Wave | Pure 1kHz tone at 16kHz sample rate. Verify mel-bin energy peaks at correct frequency. | Python: scipy + librosa
AUD-L2-003 | Speech Segment | Pre-recorded speech segment (400ms). Compare MFCC tensor against librosa.feature.mfcc(). | librosa golden .hex
AUD-L2-004 | Full 49-Frame Tensor | ~1 second of audio producing complete 49x10x1 INT8 tensor. Verify DMA write to DDR. | librosa golden
AUD-L2-005 | MFCC_DONE Interrupt | Verify IRQ asserts exactly when 49th frame completes and tensor is in DDR. | Timing check
AUD-L2-006 | Continuous Streaming | Back-to-back MFCC tensors (2+ seconds). Verify no frame drop at stride boundary. | Self-checking
AUD-L2-007 | Pipeline Stall | Inject DMA backpressure (DDR busy). Verify pipeline stalls gracefully, no data corruption. | Self-checking

## 4.4 Camera Subsystem Tests

Test ID | Test Name | Description | Golden Source
CAM-L2-001 | Full Frame Capture | 640x480 YUV422 frame from DVP stimulus. Verify RGB888 128x128 output in DDR frame buffer. | Python PIL resize
CAM-L2-002 | Color Bar Pattern | Standard color bar input. Verify YUV→RGB conversion accuracy per pixel. | BT.601 reference
CAM-L2-003 | Double Buffer Swap | Two consecutive frames. Verify buffer pointer swap, no tearing between frames. | Address check
CAM-L2-004 | Crop Engine | Configure crop ROI (x=100,y=50,w=200,h=200). Verify 112x112 output matches PIL crop+resize. | Python PIL golden
CAM-L2-005 | FRAME_DONE IRQ | Verify interrupt timing: asserts after last pixel DMA write completes. | Timing check
CAM-L2-006 | CROP_DONE IRQ | Verify crop interrupt after crop DMA write completes. | Timing check
CAM-L2-007 | Back-to-Back Crop | Trigger crop on frame N, then immediately on frame N+1. Verify no resource conflict. | Self-checking

## 4.5 AXI Interconnect + DDR Subsystem Tests

Test ID | Test Name | Description | Golden Source
AXI-L2-001 | Single Master R/W | CPU dBus reads/writes to each slave (ROM, SRAM, periph, DDR). Address decode check. | Self-checking
AXI-L2-002 | Multi-Master Contention | NPU + Camera DMA concurrent DDR writes. Verify arbitration, no data corruption. | Memory compare
AXI-L2-003 | Priority Test | All 5 masters request simultaneously. NPU (Tier 0) should win, then Camera (Tier 1). | Latency measure
AXI-L2-004 | Anti-Starvation | NPU continuous stream. Verify CPU still gets DDR access within starvation window. | Latency bound
AXI-L2-005 | Width Conversion | CPU (32-bit) writes to DDR (128-bit upsized). Read back and verify. | Memory compare
AXI-L2-006 | Burst Splitting | 256-beat AXI4 burst through DDR wrapper. Verify 16 sub-bursts of 16 beats each on AXI3. | Protocol monitor
AXI-L2-007 | Error Slave | CPU access to unmapped address. Verify DECERR response, no hang. | Response check
AXI-L2-008 | Timeout Recovery | Stall a slave response. Verify timeout fires, error propagated to master. | Timeout check

## 4.6 RISC-V Subsystem Tests

Test ID | Test Name | Description | Golden Source
RV-L2-001 | Boot ROM Fetch | CPU fetches first instruction from 0x0000_0000. Verify iBus AXI transaction. | Address trace
RV-L2-002 | SRAM R/W | Write pattern to 512KB SRAM via dBus, read back. All byte/half/word widths. | Memory compare
RV-L2-003 | UART Loopback | CPU writes TX FIFO, loopback to RX, CPU reads. Verify data integrity. | Data compare
RV-L2-004 | Timer Interrupt | Set MTIMECMP, wait for MTIME to reach it. Verify IRQ assertion to CPU. | Cycle count
RV-L2-005 | Multi-IRQ Priority | Trigger NPU_DONE + UART_RX simultaneously. Verify IRQ controller priority. | IRQ sequence
RV-L2-006 | GPIO Toggle | CPU writes GPIO output register, verify pin toggling. Test edge interrupt. | Pin monitor
RV-L2-007 | Peripheral Register Sweep | Read/write all peripheral registers via AXI-Lite fabric. Verify decode to correct peripheral. | Register check

# 5. Level 3: SoC-Level Verification

SoC-level verification tests the fully integrated soc_top.v with all subsystems connected. The CPU executes firmware from boot ROM/SRAM, and all DMA engines access DDR through the real AXI crossbar and DDR wrapper. The Zynq HP0 port is modeled by axi_mem_model.v acting as external DDR.

## 5.1 SoC Testbench Architecture

- soc_top.v instantiated with real clock/reset manager
- Zynq HP0 modeled by axi_mem_model.v (64-bit AXI3 slave with configurable latency)
- Boot ROM pre-loaded with test firmware (.hex from RISC-V GCC toolchain)
- External I/O stimulus: DVP camera model, I2S audio model, UART monitor, SPI flash model
- Test result communication: firmware writes PASS/FAIL to a magic SRAM address, TB monitors it

## 5.2 SoC Test Scenarios

Test ID | Scenario | Description | Duration
SOC-001 | Boot + LED Blink | CPU boots from ROM, jumps to SRAM, toggles GPIO. Proves basic boot flow and peripheral access. | ~1 ms sim
SOC-002 | UART Hello World | CPU prints string via UART TX. TB UART monitor captures and verifies. | ~2 ms sim
SOC-003 | NPU Inference | Firmware configures NPU registers, triggers Conv2D layer, waits for NPU_DONE IRQ, reads result from DDR. | ~5 ms sim
SOC-004 | Audio MFCC Capture | Firmware configures audio subsystem, I2S model feeds 1s of audio, firmware waits for MFCC_DONE, reads 49x10x1 tensor from DDR. | ~50 ms sim
SOC-005 | Camera Frame Capture | DVP model sends 640x480 frame, firmware waits for FRAME_DONE, reads 128x128 RGB from DDR. | ~20 ms sim
SOC-006 | Face Detect + Crop | Camera captures frame, firmware triggers crop engine with ROI, waits for CROP_DONE, reads 112x112 face tensor. | ~30 ms sim
SOC-007 | Full Pipeline | Audio MFCC + Camera capture + NPU inference running concurrently. Tests DDR bandwidth sharing and IRQ servicing. | ~100 ms sim
SOC-008 | I2C Sensor Read | Firmware reads accelerometer/gyro register via I2C master. I2C slave model responds. | ~5 ms sim
SOC-009 | SPI ESP32 Comm | Firmware sends command to ESP32 via SPI, receives response. SPI slave model. | ~5 ms sim
SOC-010 | Stress: All DMAs Active | NPU DMA + Camera DMA + Audio DMA all streaming simultaneously. Monitor DDR bandwidth, latency, and no deadlock. | ~200 ms sim

## 5.3 Firmware Test Framework

SoC-level tests require minimal firmware running on the Ibex CPU. The firmware framework includes:

- Startup code (crt0.S): stack setup, BSS clear, jump to main()
- Register access macros: REG_WR(base, offset, data), REG_RD(base, offset)
- IRQ handler: vectored interrupt handler that sets global flags per IRQ source
- Test result reporting: write to magic address 0x1000_FF00 (0xPASS_0001 = pass, 0xFAIL_xxxx = fail code)
- Toolchain: riscv32-unknown-elf-gcc (RV32IMC), objcopy to .hex for $readmemh

## 5.4 Performance Metrics to Measure

Metric | Target | Measurement Method
NPU Conv2D throughput | >100 MOPS (INT8) | Cycle count: layer_done - enable
MFCC latency | < 10 ms per tensor | Cycle count: audio_enable to MFCC_DONE
Camera frame latency | < 33 ms (30 FPS) | Cycle count: VSYNC to FRAME_DONE
DDR bandwidth utilization | > 60% of theoretical | Measure active vs idle cycles on HP0
IRQ latency | < 50 cycles from source to CPU handler | Timestamp IRQ assertion vs handler entry
Boot time | < 1 ms from reset release to main() | Cycle count: rst_n deassert to first GPIO toggle

# 6. AXI Protocol Compliance Verification

AXI protocol compliance is critical across all levels. Every AXI interface in the SoC must be verified against ARM AMBA AXI4 specification rules. An AXI protocol checker module will be instantiated in every subsystem and SoC-level testbench.

## 6.1 AXI Rules to Check

Rule ID | Channel | Rule Description | Severity
AXI-R001 | AW/AR | VALID must not depend on READY (no combinational dependency) | FATAL
AXI-R002 | AW/AR | Address must be aligned to transfer size (AWSIZE/ARSIZE) | ERROR
AXI-R003 | W | WLAST must assert on final beat of burst (beat count = AWLEN+1) | FATAL
AXI-R004 | W | WSTRB must be consistent with AWSIZE and address alignment | ERROR
AXI-R005 | B | BRESP valid only for write transactions; BID must match outstanding AWID | ERROR
AXI-R006 | R | RLAST must assert on final beat; RID must match outstanding ARID | FATAL
AXI-R007 | All | Once VALID is asserted, it must not deassert until READY handshake | FATAL
AXI-R008 | All | No X/Z on any control signal when VALID is asserted | FATAL
AXI-R009 | AW+W | Write data channel must not start before address channel (or same cycle) | WARNING
AXI-R010 | All | Outstanding transaction limit must not be exceeded per master | ERROR

## 6.2 AXI Protocol Checker Module

A reusable axi_protocol_checker.v module will be created and instantiated at every AXI interface in the design hierarchy. It will monitor all 5 channels, assert $error on violations, and log to a report file. The checker is synthesis-ignored (ifdef SIMULATION).

# 7. Clock Domain Crossing (CDC) Verification

The SoC has multiple clock domains requiring careful CDC verification:

Crossing | Source Clock | Dest Clock | CDC Mechanism | Verification
Camera DVP → SoC | PCLK (~24 MHz) | sys_clk (100 MHz) | dvp_sync (2-FF) + pixel_fifo (async FIFO, gray counters) | Inject edge-case transitions, verify no metastability propagation
I2S → Audio | I2S SCK | sys_clk (100 MHz) | i2s_sync (2-FF synchronizer) | Verify sample capture timing margin
NPU → SoC | npu_clk (200 MHz) | sys_clk (100 MHz) | Synchronous (2:1 ratio assumed) or CDC FIFOs | Verify AXI handshake across clock boundary
Reset | Async | All domains | rst_sync.v (2-FF sync per domain) | Verify reset assertion/deassertion is clean in each domain

# 8. Verification Infrastructure to Build

The following reusable components and scripts must be developed to support the verification strategy:

## 8.1 Reusable Verification Components

Component | Type | Description | Used At
axi4_lite_master_bfm.v | BFM | Drives register read/write transactions via AXI4-Lite. Tasks: axi_write(addr, data), axi_read(addr) | L1 (regfile), L2, L3
axi4_master_bfm.v | BFM | Generates AXI4 read/write bursts with configurable ID, length, size | L2, L3
axi_mem_model.v | Memory Model | AXI4 slave DDR model (exists in ddr/). Add: configurable latency, out-of-order, error injection | L2, L3
axi_protocol_checker.v | Monitor | Passive AXI protocol checker per Section 6. Instantiated on every AXI interface | All levels
dvp_camera_model.v | Stimulus | Generates OV7670-like DVP timing with configurable pattern (color bar, gradient, image from .hex) | L2 (camera), L3
i2s_audio_model.v | Stimulus | Generates I2S audio stream from .hex file (PCM samples at 16kHz) | L2 (audio), L3
uart_monitor.v | Monitor | Captures UART TX output, logs characters, checks framing | L2 (RISC-V), L3
spi_slave_model.v | Responder | SPI slave that responds to commands (models ESP32) | L2 (SPI), L3
i2c_slave_model.v | Responder | I2C slave that responds to register reads (models IMU sensor) | L2 (I2C), L3
test_result_monitor.v | Monitor | Watches magic SRAM address for firmware PASS/FAIL code | L3

## 8.2 Golden Model Generators (Python)

Script | Generates | Library
gen_mfcc_golden.py | 49x10x1 INT8 MFCC tensor from .wav input | librosa, numpy, scipy
gen_conv2d_golden.py | Quantized Conv2D/DW-Conv2D output from INT8 input+weights | numpy
gen_resize_golden.py | Bilinear resized image (640x480→128x128, ROI→112x112) | PIL/Pillow, numpy
gen_yuv2rgb_golden.py | BT.601 YUV422→RGB888 conversion reference | numpy
gen_fft_golden.py | 1024-pt FFT output from known input signal | numpy.fft
gen_boot_firmware.py | Compiles .c test firmware to .hex for $readmemh | riscv32 GCC wrapper

## 8.3 CI/CD Integration

A top-level Makefile and CI script will orchestrate the entire verification suite:

make verify-l1 — Run all 120 module-level TBs

make verify-l2 — Run all subsystem-level TBs

make verify-l3 — Run all SoC-level TBs

make verify-all — Full regression (L1 + L2 + L3)

make lint — Verilator lint on all RTL

make report — Generate HTML pass/fail dashboard

# 9. Verification Execution Plan

Verification is executed in phases, aligned with RTL development:

Phase | Scope | Entry Criteria | Exit Criteria | Timeline
Phase 1 | L1: All leaf modules | RTL code complete per module | All 120 module TBs pass, zero lint errors | Weeks 1-3
Phase 2 | L2: NPU + Audio subsystems | Phase 1 complete for NPU + Audio modules | Golden vector match for all L2 tests, AXI protocol clean | Weeks 3-5
Phase 3 | L2: Camera + AXI + DDR subsystems | Phase 1 complete for Camera/AXI/DDR | All L2 tests pass, CDC verified | Weeks 4-6
Phase 4 | L2: RISC-V + Peripherals | Phase 1 complete for RISC-V, I2C, SPI | Boot ROM fetch works, UART loopback passes | Weeks 5-7
Phase 5 | L3: SoC integration | All L2 tests pass | Firmware boots, SOC-001 through SOC-006 pass | Weeks 7-9
Phase 6 | L3: Full pipeline + stress | SOC-001 to SOC-006 pass | SOC-007 to SOC-010 pass, performance targets met | Weeks 9-11
Phase 7 | FPGA bring-up | All L3 sim tests pass | Design runs on Zybo Z7-20, LED blink, UART output | Weeks 11-13

# 10. Verification Risks and Mitigations

Risk | Impact | Likelihood | Mitigation
AXI protocol bugs in crossbar | High — deadlock, data corruption | Medium | Instantiate axi_protocol_checker on every interface; multi-master stress tests early
CDC metastability (Camera DVP) | High — corrupted pixels | Medium | Verify async FIFO gray counters; run gate-level CDC analysis if moving to ASIC
NPU numerical mismatch | Medium — wrong inference | Medium | Bit-exact golden models in Python; test with real MobileNet weights
DDR burst splitting edge cases | High — data loss | Low | Exhaustive burst length sweep (1 to 256), unaligned addresses
MFCC fixed-point precision loss | Medium — degraded accuracy | Medium | Compare SNR against floating-point reference; tune Q-format per stage
SoC simulation too slow | Medium — blocks verification | High | Use Verilator for fast SoC sim; limit DDR model depth; use short test vectors
IRQ latency exceeds target | Low — missed real-time | Low | Measure in L3 tests; optimize IRQ controller path if needed

# Appendix A: Complete Module Inventory

Total RTL source files: 89 modules across 9 subsystems. Total testbench files: 120 testbenches (1 per module + subsystem/SoC integration TBs).

Subsystem | RTL Modules | Testbenches | L2 Integration TB
NPU | 12 | 12 | tb_npu_top.v
Audio/MFCC | 21 | 21 | tb_audio_subsys_top.v
Camera | 18 | 18 | tb_cam_subsys_top.v
AXI Interconnect | 17 | 17 | tb_axi_crossbar.v
DDR Bridge | 15 | 15 | tb_ddr_wrapper.v
RISC-V + Peripherals | 24 | 21 | tb_riscv_subsys_top.v
SoC | 2 | 2 | tb_soc_top.v
I2C | 7 | 7 | tb_i2c_master.v
SPI | 7 | 7 | tb_spi_master.v

AI Smart Glasses SoC — Verification Strategy
