anirudhr-adtech/AI_GLASSES/AI_Smart_Glasses_docs/Budget and Phase planning/Phase 0 Simulation Validation Plan.docx

# AI Smart Glasses – Phase 0 Simulation Validation Plan (Use Cases + DDR + Tiny Models)

## Purpose of This Document

This document defines the simulation strategy for Phase 0, including:

• Simulation blocks required for each use case
• What must be built (coded) vs what can be taken from open source / vendor VIP
• Behavioral C-models required (DDR/AXI, NPU golden, preprocessing, postprocessing)
• Tiny model details and memory requirements

The goal is to enable full end-to-end validation in RTL simulation before FPGA bring-up and before ASIC Phase 1.

# 1. Simulation Philosophy (What “DDR model” means here)

In Phase 0 RTL simulation, DDR should be modeled as an AXI-accessible memory subsystem, not a PHY-accurate DQ/DQS DDR PHY.
Your RTL interacts with DDR through AXI via DMA, so the simulation must validate:

• AXI correctness (bursts, alignment, backpressure)
• DMA correctness (address generation, stride, length, completion)
• Data integrity (weights/tensors written and read correctly)
• Full use-case correctness (model outputs match golden)

A PHY-accurate DDR model is not needed at this stage.

# 2. Common Simulation Top-Level (Applies to All Use Cases)

## 2.1 Testbench Structure (Block Diagram)

TB Driver / Host
→ programs registers (AXI-Lite)
→ loads DDR model memory with weights / inputs
→ kicks NPU/DMA
→ collects outputs
→ compares to golden

DUT (RTL)
• NPU core (MAC + scratchpad + controller)
• DMA (AXI master)
• AXI-Lite register interface
• Interrupt/status outputs

Models / VIP
• DDR model (AXI slave memory)
• Optional AXI protocol checker (VIP)
• Sensor stimulus models (audio/IMU/camera streams or file replay)

## 2.2 Key Interfaces to Simulate

• AXI4 (DMA ↔ DDR model)
• AXI-Lite (TB driver ↔ register file)
• Optional streaming interfaces (I2S / I2C / camera) if simulated at RTL

# 3. Required Simulation Blocks – Build vs Open Source vs Vendor/VIP

## 3.0 CPU / Host Processor Block (RISC-V or ARM) – Simulation View

Even though Phase 0 may use Zynq ARM PS in hardware, the architecture should remain compatible with a soft CPU (RISC-V) so that ASIC Phase 1/2 can reuse the same control plane. In simulation, the “CPU” is represented by a testbench host/driver that performs register programming and interrupt handling.

### CPU Options

Option A — Zynq ARM (FPGA board)
• Hardware: ARM PS + PS DDR controller (vendor-provided)
• Simulation: TB driver emulates CPU register writes/reads (AXI-Lite)

Option B — Soft RISC‑V CPU in FPGA fabric (portable, ASIC-aligned)
• Hardware: soft CPU + AXI-Lite master + interrupt handling
• Simulation: either instantiate the RISC‑V core + simple firmware, or keep TB driver as CPU proxy

### CPU‑Related RTL Blocks (if using Soft RISC‑V)

• RISC‑V core (open-source)
• Boot ROM (small) + optional RAM
• Timer + interrupt controller (CLINT-like)
• Optional PLIC (interrupt router)
• AXI/AHB/AXI-Lite interconnect bridges (as required)
• Peripheral register map (NPU/DMA/IO)

### What CPU is responsible for (common across ARM and RISC‑V)

• Configure DMA descriptors / base addresses / strides
• Configure NPU layer parameters and kick execution
• Handle interrupts (DMA done, NPU done, error)
• Optional: run pre/post-processing in software (MFCC, crop/align, cosine similarity)

# 3. Required Simulation Blocks – Build vs Open Source vs Vendor/VIP

Legend:

• Build = must code (RTL or TB code) for your architecture • Open Source = can reuse existing cores/models • Vendor/VIP = simulator or vendor-provided verification models (optional)

## 3.1 Common Blocks (All Use Cases)

Block | Category | Notes / Why Needed
AXI-Lite register driver (TB) | Build | Programs DUT config, starts jobs, polls status/interrupt
DDR AXI slave memory model | Build or Open Source | Must support burst R/W + backpressure knobs
Memory preloader (weights/inputs) | Build | Loads tensors/weights into DDR model before run
Output collector + scoreboard | Build | Reads output tensors from DDR model; compares to golden
AXI protocol checker | Open Source / Vendor | Optional but highly recommended for robustness
NPU golden reference model | Build (C/Python) | Computes expected outputs, layer-by-layer optional
Quantization reference (INT8) | Build (C/Python) | Ensures bit-accuracy for clamp/shift/scale

## 3.2 Use-Case Specific Blocks

### Use Case 1 – Voice Phrase / Wake Word

Block | Category | Notes
Audio stimulus model (file replay) | Build | Feeds PCM samples from .wav/.raw to preprocessing
MFCC reference model | Open Source / Build | Often easiest in software (C/Python) for Phase 0
DS-CNN golden inference | Open Source / Build | TFLite/ONNX runtime reference is acceptable
Threshold/decision logic | Build | FAR/FRR checks; interrupt trigger

### Use Case 2 – Gesture Recognition

Block | Category | Notes
IMU stimulus model (CSV replay) | Build | Feeds accel/gyro sequences
Optional filter reference | Build | Low-pass/moving average to match pipeline
Gesture model golden inference | Open Source / Build | Small MLP/CNN reference
Classifier decision logic | Build | Thresholding and event output

### Use Case 3 – Face Recognition

Block | Category | Notes
Image stimulus model (file replay) | Build | Feeds frames (RGB/YUV) from files
ISP-lite reference (resize/format) | Open Source / Build | Typically software (OpenCV)
BlazeFace golden inference | Open Source / Build | Reference model (ONNX/TFLite)
Crop/align reference | Open Source / Build | Software crop/align to match expected
MobileFaceNet golden inference | Open Source / Build | Produces embedding vector
Similarity + threshold | Build | Cosine similarity and identity decision

# 4. What to Code vs Reuse (Practical Recommendation)

## 4.1 Must Be Coded (Your Project-Specific)

### RTL

• NPU compute core RTL (MAC array, accumulators, activation, quantize)
• Scratchpad SRAM controller (BRAM wrapper + banking)
• NPU controller FSM / scheduler
• AXI-Lite register interface
• Interrupt/status logic

### Testbench / C-models

• DDR model integration + preloader
• TB driver (register programming, job sequencing)
• Scoreboard + output validation
• Bit-accurate quantization model

## 4.2 Prefer Open Source / Vendor Components (Phase 0 Speed)

• AXI protocol VIP/checkers (if available with your simulator)
• Basic AXI memory model (then extend with throttling knobs)
• Reference inference (TFLite/ONNX runtime) to generate golden outputs
• Pre/post-processing libraries (MFCC/OpenCV) for golden data generation

## 4.3 Postpone to Hardware RTL (Do in Software First)

• MFCC hardware chain
• ISP-lite (resize/color) hardware
• Crop/align hardware
• Cosine similarity hardware

These can be added later if Phase 0 needs hardware acceleration beyond the NPU.

# 5. Tiny Model Details (Phase 0 Targets)

These models match your Phase 0 architecture plan.

## 5.1 Wake Word (Voice Phrase)

• Model type: DS-CNN (keyword spotting)
• Size: ~50–200 KB
• Compute: ~20–40 MMAC per inference
• Input: MFCC features (typical 10–40 frames, 10–40 coeffs depending on design)

## 5.2 Gesture Recognition

• Input: IMU accel/gyro time window
• Model size: ~20–100 KB
• Compute: ~10–20 MMAC per inference
• Output: gesture class + confidence

## 5.3 Face Recognition

Two-stage pipeline:

1) Face detection – BlazeFace (~1 MB)
2) Face embedding – MobileFaceNet (~2 MB)

Total model footprint: ~3.5 MB (excluding temporary tensors)

# 6. DDR Memory Map for Simulation (Recommended)

Use a fixed memory map so your wrapper scripts and RTL remain consistent.

Region | Purpose | Example Base Address
WEIGHTS | Model weights (all models) | 0x0000_0000
INPUTS | Input tensors / feature buffers | 0x0100_0000
WORK | Intermediate tensors / scratch | 0x0200_0000
OUTPUTS | Output tensors / logs | 0x0300_0000
FRAME | Camera frame buffers | 0x0400_0000

Notes:

• Exact sizes are configurable per regression.
• TB preloader writes weights and inputs into DDR model at these addresses.
• DUT DMA reads/writes using the same map.

# 7. DDR AXI Memory Model Requirements (Behavioral)

Your DDR model should support:

• AXI burst reads/writes
• Configurable read latency
• Configurable write response latency
• Backpressure/throttling knobs (ARREADY/RREADY/WREADY patterns)
• Limits on outstanding transactions (optional)
• Optional error injection (DECERR/SLVERR) for robustness testing

Start with functional correctness (fixed latency), then add throttling.

# 8. C-Models / Software Models Required

## 8.1 NPU Golden Model (C/Python)

Purpose:

• Provide expected outputs for each layer and final outputs
• Validate bit-accurate INT8 arithmetic (sign, saturation, shifts)

Minimum features:

• INT8×INT8 accumulate into INT32
• Per-layer quantization (scale/shift)
• Optional ReLU
• Convolution and matmul support (enough for DS-CNN and MobileFaceNet layers)

## 8.2 Pre/Post Processing Golden Models

Voice:

• MFCC generation (golden)
• Thresholding + debouncing

Gesture:

• windowing, normalization, optional filtering
• thresholding

Face:

• resize/color conversion
• detection post-processing (bbox + NMS)
• crop/align
• cosine similarity + threshold

## 8.3 Memory Utilities

• Weight packer (layouts weights as expected by DMA/scratchpad)
• Tensor packer (layout conversions NHWC/NCHW if required)
• DDR image loader (writes binary blobs into DDR model)

# 9. Regression Plan (What Must Pass)

## Level 0 – Sanity (Bring-up)

• AXI-Lite read/write registers
• DMA read/write single burst
• Scratchpad basic read/write
• NPU single MAC test (bit-accurate)

## Level 1 – Datapath Correctness

• DS-CNN layer-by-layer matches golden (within bit-accurate rules)
• Gesture model matches golden
• BlazeFace + MobileFaceNet match golden outputs

## Level 2 – System Stress

• DDR throttling enabled; ensure no deadlocks
• Randomized backpressure patterns
• Outstanding transaction limits
• Interrupt ordering correctness

## Level 3 – Performance Modeling (Optional Later)

• Collect stall statistics: DMA wait cycles, NPU idle cycles
• Validate bandwidth headroom for target FPS / latency

# 10. Deliverables from Simulation Phase

1) A repeatable regression suite for all three use cases
2) DDR model + memory map + preloader scripts
3) Golden reference models and expected outputs
4) Pass/fail reports with mismatch localization (layer/tensor level)
5) Identified bottlenecks (DDR vs compute) and tuning knobs (tiling, burst, scratchpad size)

# Conclusion

A DDR-integrated RTL simulation environment is essential to validate:

• DMA correctness
• AXI protocol behavior
• Memory map correctness
• End-to-end inference correctness for wake word, gesture, and face recognition

This simulation plan allows Phase 0 to proceed in a structured way, reduces FPGA bring-up risk, and provides a clean migration path to ASIC Phase 1.
