anirudhr-adtech/AI_GLASSES/rtl/audio/tb/tb_audio_integ.v

`timescale 1ns / 1ps
//////////////////////////////////////////////////////////////////////////////
// AI_GLASSES — Audio Subsystem L2 Integration Testbench
// File: tb_audio_integ.v
// Description: Validates audio_subsys_top integration — I2S -> FIFO -> FFT ->
//              Mel -> Log -> DCT -> MFCC pipeline and DMA write to DDR model.
//////////////////////////////////////////////////////////////////////////////

module tb_audio_integ;

    // ====================================================================
    // Parameters
    // ====================================================================
    localparam CLK_PERIOD = 10;          // 100 MHz
    localparam DDR_MEM_BYTES = 65536;    // 64 KB DDR model

    // Register offsets (byte addresses)
    localparam AUDIO_CONTROL   = 32'h00;
    localparam AUDIO_STATUS    = 32'h04;
    localparam SAMPLE_RATE_DIV = 32'h08;
    localparam FIFO_STATUS     = 32'h0C;
    localparam MFCC_CONFIG     = 32'h10;
    localparam WINDOW_CONFIG   = 32'h14;
    localparam FFT_CONFIG      = 32'h18;
    localparam DMA_BASE_ADDR   = 32'h1C;
    localparam DMA_LENGTH      = 32'h20;
    localparam DMA_WR_PTR      = 32'h24;
    localparam GAIN_CONTROL    = 32'h28;
    localparam NOISE_FLOOR     = 32'h2C;
    localparam START_PULSE     = 32'h30;
    localparam IRQ_CLEAR       = 32'h34;
    localparam PERF_CYCLES     = 32'h38;
    localparam FRAME_ENERGY    = 32'h3C;

    // ====================================================================
    // Clock and Reset
    // ====================================================================
    reg clk;
    reg rst_n;

    initial clk = 0;
    always #5 clk = ~clk;

    // ====================================================================
    // Test counters
    // ====================================================================
    integer pass_count;
    integer fail_count;
    integer test_num;

    // ====================================================================
    // I2S BFM signals
    // ====================================================================
    reg  i2s_enable;
    wire i2s_sck, i2s_ws, i2s_sd;

    // ====================================================================
    // AXI4-Lite signals (TB drives)
    // ====================================================================
    reg  [31:0] s_axi_lite_awaddr;
    reg         s_axi_lite_awvalid;
    wire        s_axi_lite_awready;
    reg  [31:0] s_axi_lite_wdata;
    reg  [3:0]  s_axi_lite_wstrb;
    reg         s_axi_lite_wvalid;
    wire        s_axi_lite_wready;
    wire [1:0]  s_axi_lite_bresp;
    wire        s_axi_lite_bvalid;
    reg         s_axi_lite_bready;
    reg  [31:0] s_axi_lite_araddr;
    reg         s_axi_lite_arvalid;
    wire        s_axi_lite_arready;
    wire [31:0] s_axi_lite_rdata;
    wire [1:0]  s_axi_lite_rresp;
    wire        s_axi_lite_rvalid;
    reg         s_axi_lite_rready;

    // ====================================================================
    // AXI4 DMA master signals (from DUT)
    // ====================================================================
    wire [3:0]  m_axi_dma_awid;
    wire [31:0] m_axi_dma_awaddr;
    wire [7:0]  m_axi_dma_awlen;
    wire [2:0]  m_axi_dma_awsize;
    wire [1:0]  m_axi_dma_awburst;
    wire        m_axi_dma_awvalid;
    wire        m_axi_dma_awready;
    wire [31:0] m_axi_dma_wdata;
    wire [3:0]  m_axi_dma_wstrb;
    wire        m_axi_dma_wlast;
    wire        m_axi_dma_wvalid;
    wire        m_axi_dma_wready;
    wire [3:0]  m_axi_dma_bid;
    wire [1:0]  m_axi_dma_bresp;
    wire        m_axi_dma_bvalid;
    wire        m_axi_dma_bready;

    // Interrupt
    wire        irq_audio_ready;

    // ====================================================================
    // DDR model wires (128-bit interface, pad DUT's 32-bit DMA)
    // ====================================================================
    wire [127:0] ddr_wdata_padded;
    wire [15:0]  ddr_wstrb_padded;

    assign ddr_wdata_padded = {96'd0, m_axi_dma_wdata};
    assign ddr_wstrb_padded = {12'd0, m_axi_dma_wstrb};

    // ====================================================================
    // Read data register for axil_read task
    // ====================================================================
    reg [31:0] rd_data_reg;

    // ====================================================================
    // DUT: audio_subsys_top
    // ====================================================================
    audio_subsys_top u_dut (
        .clk_i               (clk),
        .rst_ni              (rst_n),
        // I2S
        .i2s_sck_i           (i2s_sck),
        .i2s_ws_i            (i2s_ws),
        .i2s_sd_i            (i2s_sd),
        // AXI4-Lite slave
        .s_axi_lite_awaddr   (s_axi_lite_awaddr),
        .s_axi_lite_awvalid  (s_axi_lite_awvalid),
        .s_axi_lite_awready  (s_axi_lite_awready),
        .s_axi_lite_wdata    (s_axi_lite_wdata),
        .s_axi_lite_wstrb    (s_axi_lite_wstrb),
        .s_axi_lite_wvalid   (s_axi_lite_wvalid),
        .s_axi_lite_wready   (s_axi_lite_wready),
        .s_axi_lite_bresp    (s_axi_lite_bresp),
        .s_axi_lite_bvalid   (s_axi_lite_bvalid),
        .s_axi_lite_bready   (s_axi_lite_bready),
        .s_axi_lite_araddr   (s_axi_lite_araddr),
        .s_axi_lite_arvalid  (s_axi_lite_arvalid),
        .s_axi_lite_arready  (s_axi_lite_arready),
        .s_axi_lite_rdata    (s_axi_lite_rdata),
        .s_axi_lite_rresp    (s_axi_lite_rresp),
        .s_axi_lite_rvalid   (s_axi_lite_rvalid),
        .s_axi_lite_rready   (s_axi_lite_rready),
        // AXI4 DMA master
        .m_axi_dma_awid      (m_axi_dma_awid),
        .m_axi_dma_awaddr    (m_axi_dma_awaddr),
        .m_axi_dma_awlen     (m_axi_dma_awlen),
        .m_axi_dma_awsize    (m_axi_dma_awsize),
        .m_axi_dma_awburst   (m_axi_dma_awburst),
        .m_axi_dma_awvalid   (m_axi_dma_awvalid),
        .m_axi_dma_awready   (m_axi_dma_awready),
        .m_axi_dma_wdata     (m_axi_dma_wdata),
        .m_axi_dma_wstrb     (m_axi_dma_wstrb),
        .m_axi_dma_wlast     (m_axi_dma_wlast),
        .m_axi_dma_wvalid    (m_axi_dma_wvalid),
        .m_axi_dma_wready    (m_axi_dma_wready),
        .m_axi_dma_bid       (m_axi_dma_bid),
        .m_axi_dma_bresp     (m_axi_dma_bresp),
        .m_axi_dma_bvalid    (m_axi_dma_bvalid),
        .m_axi_dma_bready    (m_axi_dma_bready),
        // Interrupt
        .irq_audio_ready_o   (irq_audio_ready)
    );

    // ====================================================================
    // I2S Audio Model (BFM)
    // ====================================================================
    i2s_audio_model #(
        .SAMPLE_BITS  (16),
        .SAMPLE_RATE  (16000),
        .SYS_CLK_HZ  (100000000)
    ) u_i2s (
        .clk          (clk),
        .rst_n        (rst_n),
        .enable       (i2s_enable),
        .sck          (i2s_sck),
        .ws           (i2s_ws),
        .sd           (i2s_sd),
        .sample_valid ()
    );

    // ====================================================================
    // DDR Memory Model (128-bit, read channels tied off)
    // ====================================================================
    axi_mem_model #(
        .MEM_SIZE_BYTES    (DDR_MEM_BYTES),
        .DATA_WIDTH        (128),
        .ADDR_WIDTH        (32),
        .ID_WIDTH          (4),
        .READ_LATENCY      (2),
        .WRITE_LATENCY     (2),
        .BACKPRESSURE_MODE (0)
    ) u_ddr (
        .clk             (clk),
        .rst_n           (rst_n),
        // Write address channel — from DUT
        .s_axi_awid      (m_axi_dma_awid),
        .s_axi_awaddr    (m_axi_dma_awaddr),
        .s_axi_awlen     (m_axi_dma_awlen),
        .s_axi_awsize    (m_axi_dma_awsize),
        .s_axi_awburst   (m_axi_dma_awburst),
        .s_axi_awvalid   (m_axi_dma_awvalid),
        .s_axi_awready   (m_axi_dma_awready),
        // Write data channel — padded to 128 bits
        .s_axi_wdata     (ddr_wdata_padded),
        .s_axi_wstrb     (ddr_wstrb_padded),
        .s_axi_wlast     (m_axi_dma_wlast),
        .s_axi_wvalid    (m_axi_dma_wvalid),
        .s_axi_wready    (m_axi_dma_wready),
        // Write response channel — to DUT
        .s_axi_bid       (m_axi_dma_bid),
        .s_axi_bresp     (m_axi_dma_bresp),
        .s_axi_bvalid    (m_axi_dma_bvalid),
        .s_axi_bready    (m_axi_dma_bready),
        // Read channels — tied off (DMA is write-only)
        .s_axi_arid      (4'd0),
        .s_axi_araddr    (32'd0),
        .s_axi_arlen     (8'd0),
        .s_axi_arsize    (3'd0),
        .s_axi_arburst   (2'd0),
        .s_axi_arvalid   (1'b0),
        .s_axi_arready   (),
        .s_axi_rid       (),
        .s_axi_rdata     (),
        .s_axi_rresp     (),
        .s_axi_rlast     (),
        .s_axi_rvalid    (),
        .s_axi_rready    (1'b0),
        // Error injection
        .error_inject_i  (1'b0)
    );

    // ====================================================================
    // AXI-Lite Write Task
    // ====================================================================
    task axil_write;
        input [31:0] addr;
        input [31:0] data_in;
        integer timeout;
    begin
        @(posedge clk); #1;
        s_axi_lite_awaddr  = addr;
        s_axi_lite_awvalid = 1;
        s_axi_lite_wdata   = data_in;
        s_axi_lite_wstrb   = 4'hF;
        s_axi_lite_wvalid  = 1;
        s_axi_lite_bready  = 1;
        timeout = 200;
        while (timeout > 0) begin
            @(posedge clk); #1;
            if (s_axi_lite_awready && s_axi_lite_wready)
                timeout = 0;
            else
                timeout = timeout - 1;
        end
        @(posedge clk); #1;
        s_axi_lite_awvalid = 0;
        s_axi_lite_wvalid  = 0;
        timeout = 200;
        while (timeout > 0) begin
            @(posedge clk); #1;
            if (s_axi_lite_bvalid)
                timeout = 0;
            else
                timeout = timeout - 1;
        end
        @(posedge clk); #1;
        s_axi_lite_bready = 0;
    end
    endtask

    // ====================================================================
    // AXI-Lite Read Task
    // ====================================================================
    task axil_read;
        input  [31:0] addr;
        output [31:0] data_out;
        integer timeout;
    begin
        @(posedge clk); #1;
        s_axi_lite_araddr  = addr;
        s_axi_lite_arvalid = 1;
        s_axi_lite_rready  = 1;
        timeout = 200;
        while (timeout > 0) begin
            @(posedge clk); #1;
            if (s_axi_lite_arready)
                timeout = 0;
            else
                timeout = timeout - 1;
        end
        @(posedge clk); #1;
        s_axi_lite_arvalid = 0;
        timeout = 200;
        while (timeout > 0) begin
            @(posedge clk); #1;
            if (s_axi_lite_rvalid) begin
                data_out = s_axi_lite_rdata;
                timeout = 0;
            end else begin
                timeout = timeout - 1;
            end
        end
        @(posedge clk); #1;
        s_axi_lite_rready = 0;
    end
    endtask

    // ====================================================================
    // Check Task
    // ====================================================================
    task check;
        input [255:0] test_name;
        input [31:0]  actual;
        input [31:0]  expected;
    begin
        if (actual === expected) begin
            $display("[PASS] %0s: got 0x%08x", test_name, actual);
            pass_count = pass_count + 1;
        end else begin
            $display("[FAIL] %0s: expected 0x%08x, got 0x%08x",
                     test_name, expected, actual);
            fail_count = fail_count + 1;
        end
    end
    endtask

    // Non-zero check (just verify value != 0)
    task check_nonzero;
        input [255:0] test_name;
        input [31:0]  actual;
    begin
        if (actual !== 32'd0) begin
            $display("[PASS] %0s: value 0x%08x (non-zero)", test_name, actual);
            pass_count = pass_count + 1;
        end else begin
            $display("[FAIL] %0s: expected non-zero, got 0x%08x",
                     test_name, actual);
            fail_count = fail_count + 1;
        end
    end
    endtask

    // Check a value is zero
    task check_zero;
        input [255:0] test_name;
        input [31:0]  actual;
    begin
        if (actual === 32'd0) begin
            $display("[PASS] %0s: value is 0 (expected)", test_name);
            pass_count = pass_count + 1;
        end else begin
            $display("[FAIL] %0s: expected 0, got 0x%08x",
                     test_name, actual);
            fail_count = fail_count + 1;
        end
    end
    endtask

    // ====================================================================
    // Helper: Configure pipeline with small frame for fast sim
    // ====================================================================
    task configure_pipeline;
        input [31:0] dma_base;
    begin
        // MFCC_CONFIG: num_mel=16 (bits 7:0), num_mfcc=8 (bits 15:8), num_frames=1 (bits 23:16)
        axil_write(MFCC_CONFIG, 32'h00010810);
        // WINDOW_CONFIG: frame_length=16 (bits 15:0), stride=8 (bits 31:16)
        axil_write(WINDOW_CONFIG, {16'd8, 16'd16});
        // FFT_CONFIG
        axil_write(FFT_CONFIG, 32'h00000004);  // log2(16)=4
        // DMA_BASE_ADDR
        axil_write(DMA_BASE_ADDR, dma_base);
        // DMA_LENGTH: enough for MFCC output (8 coeffs * 4 bytes = 32 bytes)
        axil_write(DMA_LENGTH, 32'd256);
        // GAIN_CONTROL
        axil_write(GAIN_CONTROL, 32'h00000100);
        // NOISE_FLOOR
        axil_write(NOISE_FLOOR, 32'h00000010);
        // SAMPLE_RATE_DIV
        axil_write(SAMPLE_RATE_DIV, 32'h00000001);
    end
    endtask

    // ====================================================================
    // Helper: Wait for IRQ or timeout
    // ====================================================================
    task wait_irq_or_timeout;
        input integer max_cycles;
        output integer timed_out;
        integer cnt;
    begin
        timed_out = 0;
        cnt = 0;
        while (cnt < max_cycles) begin
            @(posedge clk);
            if (irq_audio_ready) begin
                cnt = max_cycles; // exit
            end else begin
                cnt = cnt + 1;
            end
        end
        if (!irq_audio_ready)
            timed_out = 1;
    end
    endtask

    // ====================================================================
    // Helper: Wait for status frame_ready or timeout
    // ====================================================================
    task wait_frame_ready;
        input integer max_cycles;
        output integer timed_out;
        integer cnt;
        reg [31:0] status_val;
    begin
        timed_out = 0;
        cnt = 0;
        while (cnt < max_cycles) begin
            axil_read(AUDIO_STATUS, status_val);
            if (status_val[0]) begin // frame_ready
                cnt = max_cycles;
            end else begin
                // Wait some cycles between polls
                repeat (1000) @(posedge clk);
                cnt = cnt + 1000;
            end
        end
        if (!status_val[0])
            timed_out = 1;
    end
    endtask

    // ====================================================================
    // Initial Block — Reset and Signal Init
    // ====================================================================
    initial begin
        // Init AXI-Lite signals
        s_axi_lite_awaddr  = 32'd0;
        s_axi_lite_awvalid = 1'b0;
        s_axi_lite_wdata   = 32'd0;
        s_axi_lite_wstrb   = 4'd0;
        s_axi_lite_wvalid  = 1'b0;
        s_axi_lite_bready  = 1'b0;
        s_axi_lite_araddr  = 32'd0;
        s_axi_lite_arvalid = 1'b0;
        s_axi_lite_rready  = 1'b0;

        // Init I2S BFM
        i2s_enable = 1'b0;

        // Init counters
        pass_count = 0;
        fail_count = 0;
        test_num   = 0;

        // Reset
        rst_n = 1'b0;
        repeat (20) @(posedge clk);
        rst_n = 1'b1;
        repeat (10) @(posedge clk);

        $display("============================================================");
        $display(" Audio Subsystem L2 Integration Testbench");
        $display("============================================================");

        // ----------------------------------------------------------------
        // A3: Status After Reset (run first, before anything else)
        // ----------------------------------------------------------------
        test_num = 3;
        $display("\n--- A3: Status After Reset ---");
        axil_read(AUDIO_STATUS, rd_data_reg);
        check("A3 AUDIO_STATUS reset", rd_data_reg, 32'd0);

        axil_read(FIFO_STATUS, rd_data_reg);
        check("A3 FIFO_STATUS reset", rd_data_reg, 32'h00000800);  // bit 11 = fifo_empty at reset

        axil_read(DMA_WR_PTR, rd_data_reg);
        check("A3 DMA_WR_PTR reset", rd_data_reg, 32'd0);

        axil_read(PERF_CYCLES, rd_data_reg);
        check("A3 PERF_CYCLES reset", rd_data_reg, 32'd0);

        axil_read(FRAME_ENERGY, rd_data_reg);
        check("A3 FRAME_ENERGY reset", rd_data_reg, 32'd0);

        // ----------------------------------------------------------------
        // A1: Register Config — Write and Read-back
        // ----------------------------------------------------------------
        test_num = 1;
        $display("\n--- A1: Register Config ---");

        axil_write(MFCC_CONFIG, 32'h00010810);
        axil_read(MFCC_CONFIG, rd_data_reg);
        check("A1 MFCC_CONFIG", rd_data_reg, 32'h00010810);

        axil_write(WINDOW_CONFIG, 32'h00080010);
        axil_read(WINDOW_CONFIG, rd_data_reg);
        check("A1 WINDOW_CONFIG", rd_data_reg, 32'h00080010);

        axil_write(FFT_CONFIG, 32'h00000004);
        axil_read(FFT_CONFIG, rd_data_reg);
        check("A1 FFT_CONFIG", rd_data_reg, 32'h00000004);

        axil_write(DMA_BASE_ADDR, 32'h00002000);
        axil_read(DMA_BASE_ADDR, rd_data_reg);
        check("A1 DMA_BASE_ADDR", rd_data_reg, 32'h00002000);

        axil_write(DMA_LENGTH, 32'h00000100);
        axil_read(DMA_LENGTH, rd_data_reg);
        check("A1 DMA_LENGTH", rd_data_reg, 32'h00000100);

        axil_write(GAIN_CONTROL, 32'h00000100);
        axil_read(GAIN_CONTROL, rd_data_reg);
        check("A1 GAIN_CONTROL", rd_data_reg, 32'h00000100);

        axil_write(NOISE_FLOOR, 32'h00000010);
        axil_read(NOISE_FLOOR, rd_data_reg);
        check("A1 NOISE_FLOOR", rd_data_reg, 32'h00000010);

        axil_write(SAMPLE_RATE_DIV, 32'h00000001);
        axil_read(SAMPLE_RATE_DIV, rd_data_reg);
        check("A1 SAMPLE_RATE_DIV", rd_data_reg, 32'h00000001);

        // ----------------------------------------------------------------
        // A2: I2S to FIFO — Verify samples arrive
        // ----------------------------------------------------------------
        test_num = 2;
        $display("\n--- A2: I2S to FIFO ---");

        // Enable audio subsystem
        axil_write(AUDIO_CONTROL, 32'h00000001);

        // Enable I2S BFM
        i2s_enable = 1'b1;

        // Wait enough time for ~20 I2S samples to arrive
        // Each sample takes ~3125 sys_clk cycles at 16kHz/100MHz
        // 20 samples ~ 62,500 cycles
        repeat (70000) @(posedge clk);

        axil_read(FIFO_STATUS, rd_data_reg);
        $display("  FIFO_STATUS = 0x%08x (fill_level in lower bits)", rd_data_reg);
        // fill_level is in bits [9:0]
        if (rd_data_reg[9:0] > 10'd0) begin
            $display("[PASS] A2 FIFO fill_level > 0 (%0d samples)", rd_data_reg[9:0]);
            pass_count = pass_count + 1;
        end else begin
            $display("[FAIL] A2 FIFO fill_level is 0, expected > 0");
            fail_count = fail_count + 1;
        end

        // Check no overrun (bit 12)
        if (!rd_data_reg[12]) begin
            $display("[PASS] A2 no FIFO overrun");
            pass_count = pass_count + 1;
        end else begin
            $display("[FAIL] A2 FIFO overrun detected");
            fail_count = fail_count + 1;
        end

        // Disable I2S for now
        i2s_enable = 1'b0;
        // Disable audio
        axil_write(AUDIO_CONTROL, 32'h00000000);
        repeat (100) @(posedge clk);

        // ----------------------------------------------------------------
        // A4: Full Pipeline Start
        // ----------------------------------------------------------------
        test_num = 4;
        $display("\n--- A4: Full Pipeline Start ---");

        // Reset to clear state
        rst_n = 1'b0;
        repeat (20) @(posedge clk);
        rst_n = 1'b1;
        repeat (10) @(posedge clk);

        // Configure pipeline with small frame (16 samples)
        configure_pipeline(32'h00002000);

        // Enable audio subsystem (enable + continuous off)
        axil_write(AUDIO_CONTROL, 32'h00000001);

        // Enable I2S BFM
        i2s_enable = 1'b1;

        // Start pipeline
        axil_write(START_PULSE, 32'h00000001);
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
