anirudhr-adtech/AI_GLASSES/(commit log)

2026-03-07 Add files via upload
    I2C , SPI and SoC Top integration file added
2026-03-08 Add complete AI Glasses SoC RTL: 121 modules + 120 testbenches (24K lines RTL, 44.6K total)
    9 subsystems fully implemented in Verilog-2005, all 241 files compile-clean (iverilog):
    - RISC-V (22 modules): Ibex RV32IMC wrapper, 3M×4S AXI crossbar, 9-slot AXI-Lite fabric, SRAM, ROM, UART, GPIO, timer, IRQ
    - AXI Interconnect (17): 5M×5S crossbar, arbiters, width converter, upsizer/downsizer, bridges
    - Audio (21): I2S RX, FFT, power spectrum, mel filterbank, log, DCT, MFCC pipeline, DMA
    - Camera (18): DVP capture, Bayer demosaic, color correction, resize, auto-exposure, VDMA
    - DDR (15): AXI4→AXI3 bridge, 128→64-bit width conversion, Zynq HP0 wrapper, sim model
    - NPU (12): 8×8 INT8 MAC array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
    [audio_controller.v, audio_dma.v, audio_fifo.v, audio_regfile.v, audio_subsys_top.v, audio_window.v, axi4_to_axi3_bridge.v, axi_addr_decoder.v]
2026-03-08 Fix all 120 L1 testbenches to pass with Verilator 5.024 --timing mode
    RTL fixes (9 files): audio_window counter width, fft_twiddle_rom overflow
    clamp, log_compress MSB finder, irq_controller edge detect race,
    timer_clint write data latch, dbus/ibus_axi_adapter error clearing,
    frame_buf_ctrl coherent mux, gray_counter natural wrap, axi_mem_b/r_channel
    response timing, dma_act_ch/dma_weight_ch handshake fixes.
    TB fixes (76 files): Added #1 delays after @(posedge clk) for NBA settle,
    negedge sampling for AXI handshakes, timeout guards replacing unbounded
    waits, pre-asserted ready signals, removed NBA fighting always blocks,
    replaced disable-task with disable-named-block, added "ALL TESTS PASSE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
    [audio_window.v, axi_mem_b_channel.v, axi_mem_r_channel.v, dbus_axi_adapter.v, dma_act_ch.v, dma_weight_ch.v, fft_twiddle_rom.v, frame_buf_ctrl.v]
2026-03-08 Fix RTL bugs across 7 subsystems found during L2 integration testing
    Audio: fix DMA wlast timing (never asserted during AXI handshake),
    streaming pipeline (mel/log/DCT concurrent), configurable window frame size.
    Camera: fix pixel_fifo CDC (write clock domain), resize_engine 8-bit
    multiply overflow, FIFO read valid alignment, crop_engine/cam_controller.
    DDR: rewrite latency_pipe (shift-reg to FIFO), fix burst_splitter write
    data forwarding and read stale rvalid, width converter len truncation.
    NPU: fix controller compute_target clamp, DMA burst-aware AR grant.
    AXI: fix axilite_addr_decoder registered output to combinational.
    I2C: fix FIFO read-first-word-fall-through, SCL gen, FSM improvemen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
    [audio_controller.v, audio_dma.v, audio_subsys_top.v, audio_window.v, axi4_to_axi3_bridge.v, axi_mem_r_channel.v, axi_width_128to64.v, axilite_addr_decoder.v]
2026-03-08 Add L2 integration test infrastructure: 9 TBs, BFMs, regression scripts
    L2 integration testbenches (rtl/<subsystem>/tb/tb_*_integ.v):
    - NPU (33 checks): register R/W, weight DMA, Conv2D/FC/DW-Conv, multi-layer, IRQ
    - Audio (25 checks): I2S→FIFO→MFCC pipeline, DMA to DDR, continuous mode, silence
    - Camera (32 checks): DVP→ISP→resize, DMA write, double-buffer, crop, continuous
    - RISC-V (8 checks): CPU boot, UART TX/RX, GPIO, timer IRQ, peripheral walk
    - DDR (8 checks): burst split, width conversion, narrow write, QoS, backpressure
    - AXI (10 checks): multi-master, priority, width up/down, AXI-Lite fabric, error slave
    - I2C (8 checks): single/multi-byte, register read, NACK, clock stretc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
    [axi4_lite_master_bfm.v, axi4_master_bfm.v, axi_protocol_checker.v, dvp_camera_model.v, i2c_slave_model.v, spi_slave_model.v, tb_audio_integ.v]
2026-03-08 Add L2 integration bug report: 35 bugs documented across 7 subsystems
    Detailed root cause analysis, fixes, and impact for all RTL bugs
    found during L2 integration testing. Covers NPU (4), Audio (3),
    Camera (8), DDR (7), AXI (1), I2C (4), SPI (4) subsystems.
2026-03-09 Add L3 cross-subsystem test infrastructure: behavioral CPU, firmware, 11 tests
    - Replace non-functional ibex_core.v stub with behavioral RV32IM CPU model
    (full ISA: base integer + M extension, CSR support, interrupt handling)
    - Simplify ibex_core_wrapper.v to pass-through (fix OBI protocol timing)
    - Simplify ibus_axi_adapter.v (remove pending queue for sequential CPU)
    - Add firmware infrastructure: boot ROM, crt0 startup, linker scripts,
    Makefile with riscv64-unknown-elf-gcc toolchain
    - Add 11 L3 cross-subsystem tests verifying CPU boot chain, SRAM access,
    all 9 AXI-Lite peripheral slots, UART, timer interrupts, GPIO I/O,
    SPI/I2C/NPU register programming, and cross-subsystem interact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
    [ibex_core.v, ibex_core_wrapper.v, ibus_axi_adapter.v, soc_regs.h, tb_l3_top.v, test_boot_uart.c, test_gpio.c, test_i2c_regs.c]
2026-03-09 Add verification gap analysis and Cadence migration plan
    Document all verification limitations across L1/L2/L3 phases:
    - Behavioral CPU vs real Ibex gaps (pipeline, CDC, timing)
    - Verilator vs Xcelium capability comparison
    - Multi-master bus contention (never tested, 5 AXI masters)
    - Error handling, interrupt races, timing protocol gaps
    - 6 real-time use case simulations required (audio/camera/NPU/IMU)
    - 25-task Cadence migration action plan across 5 phases
2026-03-09 Add comprehensive firmware/software implementation plan
    Complete firmware architecture document covering:
    - Full HAL API specs for all 9 peripherals (IRQ, Timer, UART, GPIO,
    SPI, I2C, Camera, Audio, NPU) with function signatures
    - NPU inference engine: model descriptors, layer execution flow,
    ping-pong buffer strategy, sync/async inference API
    - ESP32 SPI communication protocol: command set, frame format, CRC
    - Device drivers: MPU6050 IMU, OV7670 camera sensor, ESP32-C3
    - DMA manager for NPU/Camera/Audio coordination
    - Memory layout: 512KB SRAM sections + DDR buffer allocation
    - Interrupt architecture: two-level dispatch, latency budgets
    - 6 real-time use cases with detailed firmware flo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
2026-03-13 Add complete PD flow and Cadence migration guide
    Physical design infrastructure for all 8 subsystems (NPU, SPI, I2C, DDR,
    AXI, Camera, RISC-V, Audio) — Yosys synthesis scripts, OpenROAD PnR scripts,
    SDC constraints, SRAM Liberty/LEF models, and blackbox stubs.
    Includes comprehensive Cadence migration document capturing all floorplan
    parameters, debug lessons, critical path analysis, and Innovus/Genus/Tempus
    script templates for the upcoming Cadence license transition.
